Orolia2s/art-card-board/Schematic/README.md

# art-card-board
Folder hosting schematic file
