Orolia2s/art-card-board/ProductionFile/README.md

# art-card-board
Folder hosting production files

- PCB-Manuf : PCB Manufacturing file  (Gerber) in Zip Format
- Assembly : Assembly file in Zip Format
- ART_CARD_BOM-Assy Excel file: Bill of materials
- ART_CARD PCB File : PADS source of the board
- ART_CARD PDF File : Include schematic, implementation and layers of the board
