Orolia2s/art-card-board/Mechanical/ART CARD Rev5.pdf

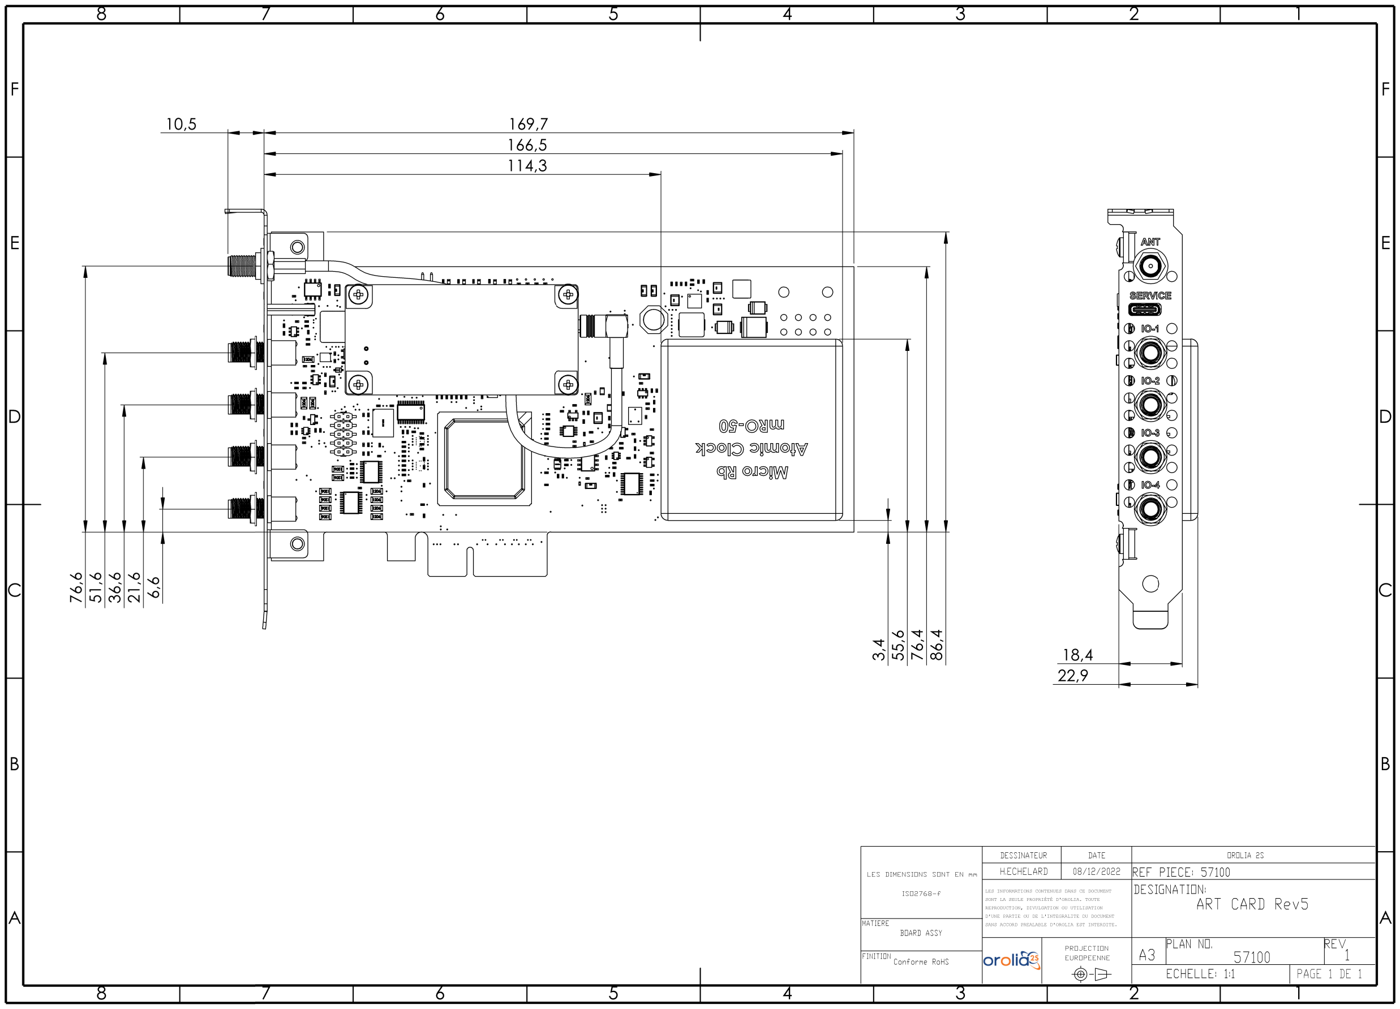
[picture p1: page 1]
