Orolia2s/art-card-board/ProductionFile/Rev5/BOM-ART_CARD_Rev5-PRODUCTION.xlsx

Item Number | Quantity | Value | Description | Part Number | Part Reference | Manufacturer | Manufacturer's Part Number | Mfg2 | Mfg2Part# | Mfg3 | Mfg3Part#
1 | 56 | 0.1uF | CAP,SM,0402,0.1uF,10%,50V,CER, X7R | C101R-0104-YK00 | C1 C2 C3 C4 C5 C6 C7 C8 C9 C10 C19 C20 C21 C22 C23 C24 C25 C26 C27 C28 C29 C30 C31 C32 C33 C34 C37 C38 C39 C40 C41 C42 C43 C44 C45 C46 C55 C56 C57 C58 C59 C60 C61 C62 C63 C64 C65 C66 C67 C68 C69 C70 C71 C72 C73 C74 | MURATA | GRM155R71H104KE14D | TDK | CGA2B3X7R1H104K050BB | Taiyo Yuden | UMK105B7104KV-FR
2 | 10 | 10uF | CAP,SM,0805,10uF,10%,10V,MLCC,X7R | C101R-0106-WK0F | C11 C12 C13 C14 C35 C47 C48 C49 C50 C75 | KEMET | C0805C106K8RACTU | TDK | C2012X7R1A106K125AC
3 | 19 | 1uF | CAP,SM,0402,1uF,10%,6.3V,MLCC,X7R | C101R-0105-YK2A | C15 C16 C17 C18 C36 C51 C52 C53 C54 C76 C146 C147 C163 C199 C200 C207 C208 C214 C219 | MURATA | GRM155R70J105KA12D | SAMSUNG | CL05B105KQ5QNW | YAGEO | CC0402KRX7R5BB105
4 | 65 | 0.1 uF | CAP, SM, 0402, .1uF, 10%, 16V, CER, X7R | C101R-0104-YK0D | C77 C80 C81 C84 C85 C86 C115 C131 C132 C137 C139 C144 C145 C148 C149 C150 C151 C152 C153 C154 C155 C156 C157 C158 C159 C162 C167 C168 C169 C170 C172 C173 C175 C176 C177 C178 C179 C180 C181 C182 C183 C184 C186 C187 C188 C189 C190 C191 C192 C197 C198 C201 C202 C203 C204 C205 C209 C210 C211 C212 C215 C216 C218 C220 C221 | AVX | 0402YC104KAT2A | KEMET | C0402T104K4RAC7867 | KEMET | C0402C104K4RACTU
5 | 6 | 15 pF | CAP, SM, 0402, 15pF, 5%, 50V, CER, NPO | C100R-0150-YJ0B | C78 C82 C83 C99 C134 C135 | AVX | 04025A150JAT2A | MURATA | GRM1555C1H150JA01D | YAGEO | CC0402JRNP09BN150
6 | 9 | 10uF | CAP, SM, 1206, 10uF, 10%, 16V, MLCC, X7R | C101R-0106-TK0D | C87 C88 C89 C112 C113 C114 C130 C164 C171 | AVX | 1206YC106KAT2A | KEMET | C1206C106K4RACTU | MURATA | GRM31CR71C106KAC7L
7 | 2 | 22uF | CAP,SM,1210,22uF,10%,16V,MLCC,X7R | C101R-0226-UK0D | C90 C91 | AVX | 1210YC226KAT2A | AVX | 1210YC226KAT4A | KEMET | C1210C226K4RAC7800
8 | 3 | 6.8pF | CAP, SM ,0402, 6.8PF, .1pF, 50V, CER, NPO | C100R-6R80-YJ0B | C92 C102 C109 | AVX | 04025A6R8CAT2A | MURATA | GCM1555C1H6R8BA16D
9 | 8 | 47uF | CAP,SM,1210,47uF,20%,6.3V,MLCC,X7R | C101R-0476-UM2A | C93 C94 C100 C101 C105 C106 C110 C111 | KEMET | C1210C476M8RAC7800 | KEMET | C1210C476K9RAC7800 | KEMET | C1210C476M9RACTU
10 | 1 | 2200 pF | CAP,SM,0402,2200pF,10%,50V,CER,X7R | C101R-0222-YK0B | C95 | MURATA | GRM155R71H222KA01D | TDK | C1005X7R1H222K | Taiyo Yuden | UMK105B7222KV-F
11 | 1 | 0.01 uF | CAP,SM,0402,.01uF,10%,50V,CER, X7R | C101R-0103-YK0B | C96 | KEMET | C0402C103K5RACTU | MURATA | GCM155R71H103KA55D
12 | 6 | 22uF | CAP,SM,1206,22uF,10%,6.3V,MLCC,X7R | C101R-0226-TK2A | C97 C98 C103 C104 C107 C108 | AVX | 12066C226KAT2A | MURATA | GRM31CR70J226KE19L | SAMSUNG | CL31B226KQHNNWE
13 | 2 | 10uF | CAP, SM, 1210, 10uF, 10%, 50V, MLCC, X7R | C101R-0106-UK0B | C116 C117 | AVX | 12105C106K4T2A | KEMET | C1210C106K5RACTU | MURATA | GRM32ER71H106KA12L
14 | 4 | 22uF | CAP,SM,1206,22UF,10%,25V,CER,X5R | C104R-0226-TK0A | C118 C119 C120 C122 | AVX | 12063D226KAT2A | MURATA | GRM31CR61E226KE15L | SAMSUNG | CL31A226KAHNNNE
15 | 2 | 680pF | CAP,SM,0402,680pF,5%,50V,CER,NPO | C100R-0681-YJ0B | C133 C136 | KEMET | C0402C681J5GACTU | MURATA | GCM1555C1H681JA16D | MURATA | GRM1555C1H681JA01D
16 | 2 | 10 pF | CAP, SM, 0402, 10PF, 5%, 50V, CERAMIC, NPO | C100R-0100-YJ0B | C138 C174 | AVX | 04025A100JAT2A | KEMET | C0402C100J5GACTU | MURATA | GCM1555C1H100GA16D
17 | 2 | 330pF | CAP,SM,0402,330pF,5%,50V,CER, NPO | C100R-0331-YJ0B | C160 C161 | MURATA | GRM1555C1H331JA01D | TDK | C1005C0G1H331J050BA | Taiyo Yuden | UMK105CG331JV-F
18 | 2 | 30pf | CAP,SM,0402,30PF,2%,25V,CER,HI-Q,NP0 | C106R-0300-YG0A | C165 C166 | Johanson | 250R07S300GV4T
19 | 1 | 0.01 uF | CAP, SM, 0402, 0.01uF, 10%, 25V, CER, X7R | C101R-0103-YK0A | C185 | AVX | 04023C103KAT2A | KEMET | C0402C103K3RACTU
20 | 8 | 100 pF | CAP, SM, 0402, 100PF, 5%, 50V, CERAMIC NPO | C100R-0101-YJ0B | C193 C194 C195 C196 C206 C213 C217 C222 | AVX | 04025A101JAT2A | KEMET | C0402C101J5GACTU | MURATA | GRM1555C1H101JA01D
21 | 2 | B230 | DIODE,SM,SCHOTTKY,30V,2A,SMB | CR01R-B230-0S1A | D1 D2 | Diodes Inc | B230-13-F | ON Semiconductor | MBRS230LT3G
22 | 1 | CD143A-SR05 | DIODE ARRAY, ESD TVS/DIODE, 2IO ,10pF, 5V VCC,SOT-143 | CR18R-0001-0S0H | D4 | BOURNS | CD143A-SR05
23 | 1 | BAT54S | DIODE, SM, SCHOTTKY, 30V, 200MA, SOT-23 | CR01R-0013-0S1A | D5 | Diodes Inc | BAT54S-7-F | ON Semiconductor | BAT54SLT1G | ROHM | BAT54SHMT116
24 | 2 | SD05C | TRANZORB,SM,BI-DIR,5VV,350W,SOD-323 | VR05R-0007-0S0H | D6 D7 | Diodes Inc | SD05C-7
25 | 3 | GREEN | LED, GREEN, SM, 0603, 2mA | DS01R-G006-0S00 | DS1 DS2 DS3 | KINGBRIGHT | APHD1608LCGCK
26 | 1 | RED | LED, RED, SM, 0603, 2 mA | DS01R-R005-0S00 | DS4 | KINGBRIGHT | APTD1608LSURCK
27 | 1 | BLUE | LED,SM,BLUE HIGH INTENSITY,0603, 2mA | DS01R-B002-0S00 | DS5 | KINGBRIGHT | APTD1608LVBC/D
28 | 4 | H10mm,M3.0x0.5 | STANDOFF, RND,SOLDER,M3.0x0.5,AL,10mm | HM57R-03R5-0610 | HE1 HE2 HE3 HE4 | WURTH ELEKTRONIK | 9774100360R
29 | 1 | J501R-0102-001E | HEADER,SM,0.1",10PIN,2ROW,MALE,3A,475VAC" | J501R-0102-001E | J1 | SAMTEC | TSM-105-01-S-DV-M
31 | 1 | SQW-105-01-F-D-VS | SOCKET, SM, 2mm, 10P, 2R, FEMALE, 2A, 100V | J800R-0102-010E | J3 | SAMTEC | SQW-105-01-F-D-VS
32 | 1 | USB TYPE C | CONN,USB TYPE C, RGHT AN, 14 CIRCUITS, TH,30V | J650R-0072-001A | J5 | MOLEX | 2169890001
33 | 4 | SMA RT | CONN, SMA JACK, R/A, 50 OHM, TH, .650" NECK, 0.11"" SHORT PINS" | J013R-0050-011Q | J6 J7 J8 J9 | EMERSON | 142-0701-551 | MOLEX | 732512201
34 | 1 | TSM-102-01-F-SH | HEADER,SM,2.54mm,2PIN, RA,1ROW,MALE,3A,475VAC | J501R-0021-041E | J10 | SAMTEC | TSM-102-01-F-SH | SAMTEC | TSM-102-01-F-SH
35 | 1 | 120 Ohm @ 100MHz | FERRITE BEAD,SM120 OHM-100MHZ,25%,500mA,0603 | L012R-120Z-XN01 | L1 | MURATA | BLM18AG121SN1D
36 | 1 | 2.2uH | INDUCTOR,SM, 2.2uH, 20%, 8A | L200R-0222-SM04 | L2 | PULSE ELECTRONICS | PA4341.222NLT
37 | 3 | 680nH | INDUCTOR,SM, 680nH, 20%, 5A | L200R-0681-SM00 | L3 L4 L5 | VISHAY | IHLP1212BZERR68M11
38 | 1 | 10uH | INDUCTOR,SM,SHIELDED,10UH,20%,2.5A | L200R-0103-SM02 | L6 | VISHAY | IHLP2020CZER100M01
39 | 1 | 15uH | INDUCTOR,SM,SHIELDED,FERRITE,15UH,30%,2A, 8mm x 8mm x 4.3mm | L200R-0153-SP00 | L7 | BOURNS | SRU8043-150Y | BOURNS | SRU8028-150Y
40 | 1 | 120 Ohm @ 100MHz | FERRITE BEAD,SM120 OHM-100MHZ,25%,4A,1206 | L012R-120Z-TN02 | L8 | FAIR-RITE | 2512061217Y5 | LAIRD TECHNOLOGIES | HI1206P121R-10
41 | 1 | 15uH | RF INDUCTOR,SM,FERRITE,15uH,5%,170mA | L260R-0153-QJ00 | L11 | COILCRAFT | 1812CS-153XJLC
42 | 2 | 330 nH | RF INDUCTOR,SM,CERAMIC,330nH,5%,0805 | L010R-3300-WJ00 | L12 L13 | COILCRAFT | 0805CS-331XJLC
43 | 2 | 120 Ohm @ 100MHz | FERRITE BEAD,SM120 OHM-100MHZ,25%,400mA,0402 | L012R-120Z-YN00 | L14 L15 | LAIRD TECHNOLOGIES | LI0402D121R-10 | TDK | MMZ1005Y121C
44 | 1 | 120 Ohm @ 100MHz | FERRITE BEAD,SM120 OHM-100MHZ,25%,3A,0805 | L012R-120Z-WN00 | L17 | LAIRD | HI0805O121R-10 | MURATA | BLM21PG121SN1D | VISHAY | ILHB0805ER121V
45 | 1 | 10 MHz | MRO-50/10M/5V | Y100R-0002-RH04 | OSC1 | Spectratime | MRO-50/10M/5V
46 | 5 | Si2302CDS | MOSFET,N-CH,ULTRA LOW VTH,20V,2.9A,SOT-23 | Q030R-2302-000V | Q1 Q2 Q3 Q4 Q5 | VISHAY | Si2302CDS-T1-E3 | VISHAY | Si2302CDS-T1-GE3
47 | 27 | 0 | RES, SM, 0402, 0 OHM JUMPER, THK FLM, 50V | R116R-0000-YJ0B | R1 R2 R3 R4 R5 R6 R7 R9 R15 R24 R25 R26 R27 R28 R30 R41 R52 R54 R55 R57 R59 R60 R61 R92 R117 R143 R145 | NIC | NRC04ZOTRF | ROHM | MCR01MZPJ000 | VISHAY | CRCW04020000Z0ED
48 | 30 | 1.00 K | RES,SM,0402,1K,1%,100PPM,THK FILM,50V | R116R-1001-YF0B | R8 R13 R21 R23 R32 R33 R35 R36 R42 R118 R119 R132 R155 R156 R158 R159 R179 R180 R181 R182 R183 R184 R185 R188 R189 R192 R193 R196 R197 R200 | PANASONIC | ERJ-2RKF1001X | VISHAY | CRCW04021K00FKED | YAGEO | RC0402FR-071KL
49 | 28 | 10.0K | RES,SM,0402,10K,1%,100PPM,THK FLM,50V | R116R-1002-YF0B | R10 R11 R12 R37 R38 R39 R49 R62 R64 R67 R68 R69 R74 R77 R80 R91 R96 R123 R124 R125 R130 R133 R134 R137 R139 R142 R148 R201 | PANASONIC | ERJ-2RKF1002X | VISHAY | CRCW040210K0FKED | YAGEO | RC0402FR-0710KL
50 | 8 | 39 | RES,SM,0402,39,1%THK FILM,50V,100PPM | R116R-0390-YF0B | R14 R40 R45 R104 R105 R106 R107 R108 | ROHM | MCR01MZPF39R0 | YAGEO | RC0402FR-0739RL
51 | 4 | 2.00K | RES,SM,0402,2.0k,1%,THICK FILM,100PPM,50V | R116R-2001-YF0B | R46 R50 R93 R138 | PANASONIC | ERJ-2RKF2001X | STACKPOLE ELECTRONICS | RMCF0402FT2K00 | VISHAY | CRCW04022K00FKED
52 | 2 | 825 | RES, SM, 0402, 825, 1%, THK FLM, 50V, 100PPM | R116R-8250-YF0B | R63 R135 | PANASONIC | ERJ-2RKF8250X | STACKPOLE ELECTRONICS | RMCF0402FT825R | VISHAY | CRCW0402825RFKED
53 | 1 | 73.2 K | RES,SM,0402,73.2K,1%,200PPM,THK FILM,50V | R116R-7322-YF0B | R65 | PANASONIC | ERJ-2RKF7322X | VISHAY | CRCW040273K2FKED
54 | 3 | 475 | RES,SM,0402,475,1%,THICK FILM,100PPM,50V | R116R-4750-YF0B | R66 R82 R136 | NIC | NRC04F4750TRF | STACKPOLE ELECTRONICS | RMCF0402FT475R | VISHAY | CRCW0402475RFKED
55 | 1 | 1.1k | RESISTOR,1.1k,1%,1/16W,THK FILM,100PPM,0402 | R116R-1101-YF0B | R70 | PANASONIC | ERJ-2RKF1101X | STACKPOLE ELECTRONICS | RMCF0402FT1K10 | VISHAY | CRCW04021K10FKED
56 | 1 | 41.2k | RES, SM, 0402, 41.2k, 1%, THK FLM, 100PPM, 50V | R116R-4122-YF0B | R71 | PANASONIC | ERJ-2RKF4122X | VISHAY | CRCW040241K2FKED | YAGEO | RC0402FR-0741K2L
57 | 1 | 261K | RES,SM,0402,201K,1%,THICK FILM,50V,100PPM | R116R-2613-YF0B | R72 | YAGEO | RC0402FR-07261KL
58 | 3 | 100 K | RES,SM,0603,100K,1%,THICK FILM,50V,100PPM | R116R-0104-XF0B | R73 R76 R79 | STACKPOLE ELECTRONICS | RMCF 1/16 100K 1% R | VISHAY | CRCW0603100KFKEA
59 | 1 | 107k | RES,SM,0402,107k,1%,THK FILM,100PPM,50V | R116R-1073-YF0B | R75 | YAGEO | RT0402FRE07107KL
60 | 1 | 80.6 k | RES,SM,0603,80.6K,1%,100PPM,THK FILM,50V | R116R-8062-XF0B | R78 | STACKPOLE ELECTRONICS | RMCF0603FT80K6 | VISHAY | CRCW060380K6FKEA
61 | 1 | 4.02k | RES,SM,0402,4.02k,1%,THK FILM,100PPM,50V | R116R-4021-YF0B | R81 | BOURNS | CR0402-FX-4021GLF | PANASONIC | ERJ-2RKF4021X | STACKPOLE ELECTRONICS | RMCF0402FT4K02
62 | 1 | 0 | RES,SM,1206,0 OHM JUMPER,THK FLM,2A | R114R-0000-TJ0G | R84 | NIC | NRC12ZOTRF | STACKPOLE ELECTRONICS | RMCF 1/8 0 R | VISHAY | CRCW12060000Z0EA
63 | 2 | 49.9 | RES,SM,0402,49.9,1%THK FILM,50V,100PPM | R116R-49R9-YF0B | R94 R146 | NIC | NRC04F49R9TRF | STACKPOLE ELECTRONICS | RMCF0402FT49R9 | VISHAY | CRCW040249R9FKED
64 | 3 | 49.9 | RES,SM,1206,49.9,1%,THK FLM,100PPM,200V | R114R-49R9-TF0G | R95 R98 R147 | NIC | NRC12F49R9TRF | STACKPOLE ELECTRONICS | RMCF1206FT49R9 | VISHAY | CRCW120649R9FKEA
65 | 4 | 221 | RES,SM,0402,221,1%THK FILM,100PPM,50V | R116R-2210-YF0B | R97 R99 R149 R153 | NIC | NRC04F2210TRF | STACKPOLE ELECTRONICS | RMCF0402FT221R | VISHAY | CRCW0402221RFKED
66 | 3 | 20.0 K | RES,SM,0402,20.0K,1%,100PPM,THK FILM,50V | R116R-2002-YF0B | R102 R150 R151 | ROHM | MCR01MZPF2002 | VISHAY | CRCW040220K0FKED | YAGEO | RC0402FR-0720KL
67 | 1 | 12.0K | RES,SM,0402,12K,1%,100PPM,THK FLM,50V | R116R-1202-YF0B | R129 | PANASONIC | ERJ-2RKF1202X | VISHAY | CRCW040212K0FKED | YAGEO | RC0402FR-0712KL
68 | 1 | 9.09k | RES,SM,0402,9.09k,1%THK FILM,100PPM,50V | R116R-9091-YF0B | R131 | PANASONIC | ERJ-2RKF9091X | STACKPOLE ELECTRONICS | RMCF0402FT9K09 | VISHAY | CRCW04029K09FKED
70 | 3 | 680 | RES,SM,0402,680,5%,200PPM,THK FILM,50V | R116R-6800-YJ0B | R141 R144 R152 | PANASONIC | ERJ-2GEJ681X | ROHM | MCR01MZPJ681 | VISHAY | CRCW0402680RJNED
71 | 1 | 750 | RES,SM,0402,750,1%,THICK FILM,100PPM,50V | R116R-7500-YF0B | R154 | NIC | NRC04F7500TRF | PANASONIC | ERJ-2RKF7500X | STACKPOLE ELECTRONICS | RMCF0402FT750R
72 | 1 | 330 | RES,SM,0402,330,1%,THK FILM,50V | R116R-3300-YF0B | R157 | PANASONIC | ERJ-2RKF3300X | ROHM | MCR01MZPF3300 | VISHAY | CRCW0402330RFKED
73 | 1 | 220K | RES,SM,0402,220K,5%,200PPM,THK FILM,50V | R116R-0224-YJ0B | R160 | VISHAY | CRCW0402220KJNED | YAGEO | RC0402JR-07220KL
74 | 10 | 100 | RES,SM,1206,100,5%,1/4W,THK FLM,200PPM | R114R-0101-TJ0G | R161 R162 R186 R187 R190 R191 R194 R195 R198 R199 | NIC | NRC12J101TRF | STACKPOLE ELECTRONICS | RMCF 1/8 100 5% R | VISHAY | CRCW1206100RJNEA
75 | 16 | 5.6 | RES,SM,1206,5.6,5%,1/4W,THK FLM,200PPM | R114R-05R6-TJ0G | R163 R164 R165 R166 R167 R168 R169 R170 R171 R172 R173 R174 R175 R176 R177 R178 | ROHM | MCR18EZPJ5R6 | STACKPOLE ELECTRONICS | RMCF 1/8 5.6 5% R | VISHAY | CRCW12065R60JNEA
76 | 1 | 10CX220YF672I6G | IC,SM,FPGA,CYCLONE 10 GX, 220KLE, 672 FBGA | U160R-10GX-020P | U1 | Intel | 10CX220YF672I6G
77 | 1 | 24AA08HT | IC,SM, EEPROM 8KBIT 400KHZ SOT23-5 | U060R-24AA-000K | U2 | Microchip Technology | 24AA08HT-I/OT
78 | 1 | TS3A27518E | IC,SM,6x 1to2 ANALOG MUX,HIGH SPEED,TSSOP24 | U150R-2751-100P | U3 | TEXAS INSTRUMENTS | TS3A27518EPWR
79 | 1 | MT25QU256ABA8E12 | IC,SM, FLASH 256MBIT,NVM,BGA,1.8V | U060R-2525-011H | U4 | Micron | MT25QU256ABA8E12-1SIT | Micron | MT25QU256ABA8E12-0AAT
80 | 3 | LT1963AIS8 | IC,LDO REG LOWNOISE ,SO8 | U280R-1963-010H | U5 U10 U23 | LINEAR TECHNOLOGY | LT1963AIS8#PBF | LINEAR TECHNOLOGY | LT1963AIS8#TRBF
81 | 1 | LT8642S | IC,SM,BUCK REG,10A, 18V, LQFN24 | U280R-8642-002U | U6 | ANALOG DEVICES | LT8642SIV#PBF
82 | 3 | LTC3308A | IC,SM,BUCK REG,4A,0.5V-5.5V, LQFN12 | U280R-3308-000K | U7 U8 U9 | ANALOG DEVICES | LTC3308AJV#TRPBF | ANALOG DEVICES | LTC3308AIV#TRPBF
83 | 2 | OPA690 | IC,SM,OP-AMP W DIS,WB,12V,SOT23-6 | U200R-0690-010H | U14 U29 | TEXAS INSTRUMENTS | OPA690IDBVR | TEXAS INSTRUMENTS | OPA690IDBVT | TEXAS INSTRUMENTS | OPA690IDBVTG4
84 | 2 | SN74LVC244APW | IC,SM,LVC BUFF/DVR TRI-ST,DUAL,8BIT,3.3V,20TSSOP | U050R-L244-000P | U15 U41 | TEXAS INSTRUMENTS | SN74LVC244APWR
85 | 4 | SN74LV1T34 | IC,SM,LV,3.3V,SINGLE BUFFER,SOT-23M5 | U150R-1T34-000P | U17 U18 U21 U26 | TEXAS INSTRUMENTS | SN74LV1T34DBVR
86 | 1 | FT4233HPQ | IC,SM, USB FS UART/MPSSE, 3.3V-5.25V, 76-QFN | U130R-FT42-000P | U22 | FTDI | FT4233HPQ-TRAY | FTDI | FT4233HPQ-REEL
87 | 1 | 93LC66B | IC,SM,EEPROM,2-WR SER,4K (256X16) 5V,SOT23 | U060R-9366-000K | U24 | MICROCHIP | 93LC66BT-E/OT
88 | 4 | TXU0104BQA | IC,SM,4-bit Fixed Voltage-Level Translator,VQFN14 | U210R-0104-000H | U25 U31 U33 U35 | TEXAS INSTRUMENTS | TXU0104BQAR
90 | 1 | ADCMP601BKSZ | IC, SM,COMPAR,TTL/CMOS,1CHAN,5V,SC70-6 | U220R-0601-010H | U30 | ANALOG DEVICES | ADCMP601BKSZ-R2 | ANALOG DEVICES | ADCMP601BKSZ-REEL7
91 | 2 | 74ACT244 | IC,SM,ACT,8BIT BUFF/DRVR,3-ST,5V,TSSOP-20 | U050R-0244-040H | U32 U34 | Fairchild Semiconductor | 74ACT244MTCX | ON Semiconductor | MC74ACT244DTR2G | TEXAS INSTRUMENTS | SN74ACT244PWR
92 | 6 | MAX14763 | IC,SM,ANA SWITCH SPDTx1,3V-5.5V,8TDFN-EP | U270R-4763-000H | U36 U37 U38 U39 U40 U42 | MAXIM INTEGRATED | MAX14763ETA
93 | 1 | 15 V | TRANZORB,SM,UNI-DIRECTION,15V,1500W,SMC | VR05R-0001-0S0U | VR1 | Diodes Inc | SMCJ15A-13-F | MICRO COMMERCIAL | SMCJ15A | ON Semiconductor | 1SMC15AT3G
94 | 5 | 5V | TVS,SM,UNI-DIR,5V,350W Ppk,350pF,SOD-323 | VR02R-0002-0S0H | VR2 VR3 VR4 VR5 VR6 | Diodes Inc | SD05-7 | MICRO COMMERCIAL | ESD5V0D3-TP | ON Semiconductor | SD05T1G
95 | 1 | 25.0000MHz | MEMS OSC,SM,25MHZ,1.8V,25PPM,-40C,125C,2x1.6mm | Y250R-0002-XS02 | Y1 | SITIME | SiT8924BA-72-18E-25.000000G
96 | 1 | 100MHz | XO OSC,SM,100MHZ,1.8V,25PPM,-40C,125C,5x3.2mm | Y100R-0003-XS00 | Y2 | Silicon Labs | 510KBA100M000BAGR
97 | 1 | 12.000MHz | XTAL,SM,12MHZ,12PF,3.2x2.5mm,10PPM,-30/85°C | Y050R-0126-0500 | Y3 | KYOCERA | CX3225SB12000H0FLJCC
