Orolia2s/art-card-board/ProductionFile/Rev5/ART_CARD Rev 5.pdf

# ART_CARD Rev 5

- | 7 | SHEETS OF ELECTRICAL SCHEMATICS
- | 1 | ASSEMBLY DRAWING TOP
- | 1 | ASSEMBLY DRAWING BOTTOM
- | 1 | SILKSCREEN TOP
- | 1 | SOLDER MASK TOP
- | 1 | COPPER LAYER TOP
- | 1 | COPPER LAYER INNER 1
- | 1 | COPPER LAYER INNER 2
- | 1 | COPPER LAYER INNER 3
- | 1 | COPPER LAYER INNER 4
- | 1 | COPPER LAYER INNER 5
- | 1 | COPPER LAYER INNER 6
- | 1 | COPPER LAYER BOTTOM
- | 1 | SOLDER MASK BOTOM
- | 1 | SILKSCREEN BOTTOM
- | 1 | DRILL DRAWING
- | 1 | CIRCUIT BOARD SPECIFICATION

# FILE OROLIA ART_CARD

# Réf PCB :

Angers Technopole | 1 bis Avenue du Bois l’Abbé
49070 BEAUCOUZÉ | FRANCE
Tél. : +33(0)2-41-48-41-40 | Fax : +33(0)2-41-48-41-44
contact@artemis-cad.com | www.artemis-cad.com

Title; OVERVIEW; <Variant Name>

Size Size Size | Document Number Document Number Document Number ART_CARD ART_CARD ART_CARD | Rev Rev Rev 5 A2 5 A2 5 A2

Date: Date: Date: Thursday, March 03, 2022 Thursday, March 03, 2022 Thursday, March 03, 2022

FILE NAME FILE NAME FILE NAME ART_CARD ART_CARD ART_CARD | Sheet Sheet Sheet of of of 1 1 1 7 7 7

# VCC Decoupling

# FPGA POWER SUPPLY


VCCP and VCCERAM Decoupling

VCCPT, VCCPGM, VCCBAT and VCCIO Decoupling

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

Date: Date: Date: Thursday, March 03, 2022 Thursday, March 03, 2022 Thursday, March 03, 2022

FILE NAME FILE NAME FILE NAME ART_CARD ART_CARD ART_CARD | Sheet Sheet Sheet of of of 2 2 2 7 7 7

# FPGA

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

Date: Date: Date: Thursday, March 03, 2022 Thursday, March 03, 2022 Thursday, March 03, 2022

FILE NAME FILE NAME FILE NAME ART_CARD ART_CARD ART_CARD | Sheet Sheet Sheet of of of 3 3 3 7 7 7

## 10mV Ripple Voltage Max

## POWER NEED : FPGA : OCXO : Comp : TOTAL

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

Date: Date: Date: Thursday, March 03, 2022 Thursday, March 03, 2022 Thursday, March 03, 2022

FILE NAME FILE NAME FILE NAME ART_CARD ART_CARD ART_CARD | Sheet Sheet Sheet of of of 4 4 4 7 7 7

# MiniRubidium

# OSCILLATOR POWER SUPPLY


SQUARE TO Sine CONVERTER

Power : 3W (nom.) to 6W (Startup)

Power : 1W (nom.) to 2W (Startup)

Power : 3W (nom.) to 7.5W (Startup)

Chip Scale Atomic Clock

Date: Date: Date: Thursday, March 03, 2022 Thursday, March 03, 2022 Thursday, March 03, 2022

FILE NAME FILE NAME FILE NAME ART_CARD ART_CARD ART_CARD | Sheet Sheet Sheet of of of 5 5 5 7 7 7

ANTENNA POWER SUPPLY | GNSS RECEIVER | GNSS STANDOFF

## From 1.8V to 3.3V


SPI VOLTAGE-LEVEL TRANSLATOR

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

Date: Date: Date: Thursday, March 03, 2022 Thursday, March 03, 2022 Thursday, March 03, 2022

FILE NAME FILE NAME FILE NAME ART_CARD ART_CARD ART_CARD | Sheet Sheet Sheet of of of 6 6 6 7 7 7

## Ra is 102 ohms GAIN = 3.17

## Ra is 124 ohms GAIN = 2.8


Ra is 221 ohms GAIN = 2
Ra is 182 ohms GAIN = 2.2

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

Date: Date: Date: Thursday, March 03, 2022 Thursday, March 03, 2022 Thursday, March 03, 2022

FILE NAME FILE NAME FILE NAME ART_CARD ART_CARD ART_CARD | Sheet Sheet Sheet of of of 7 7 7 7 7 7

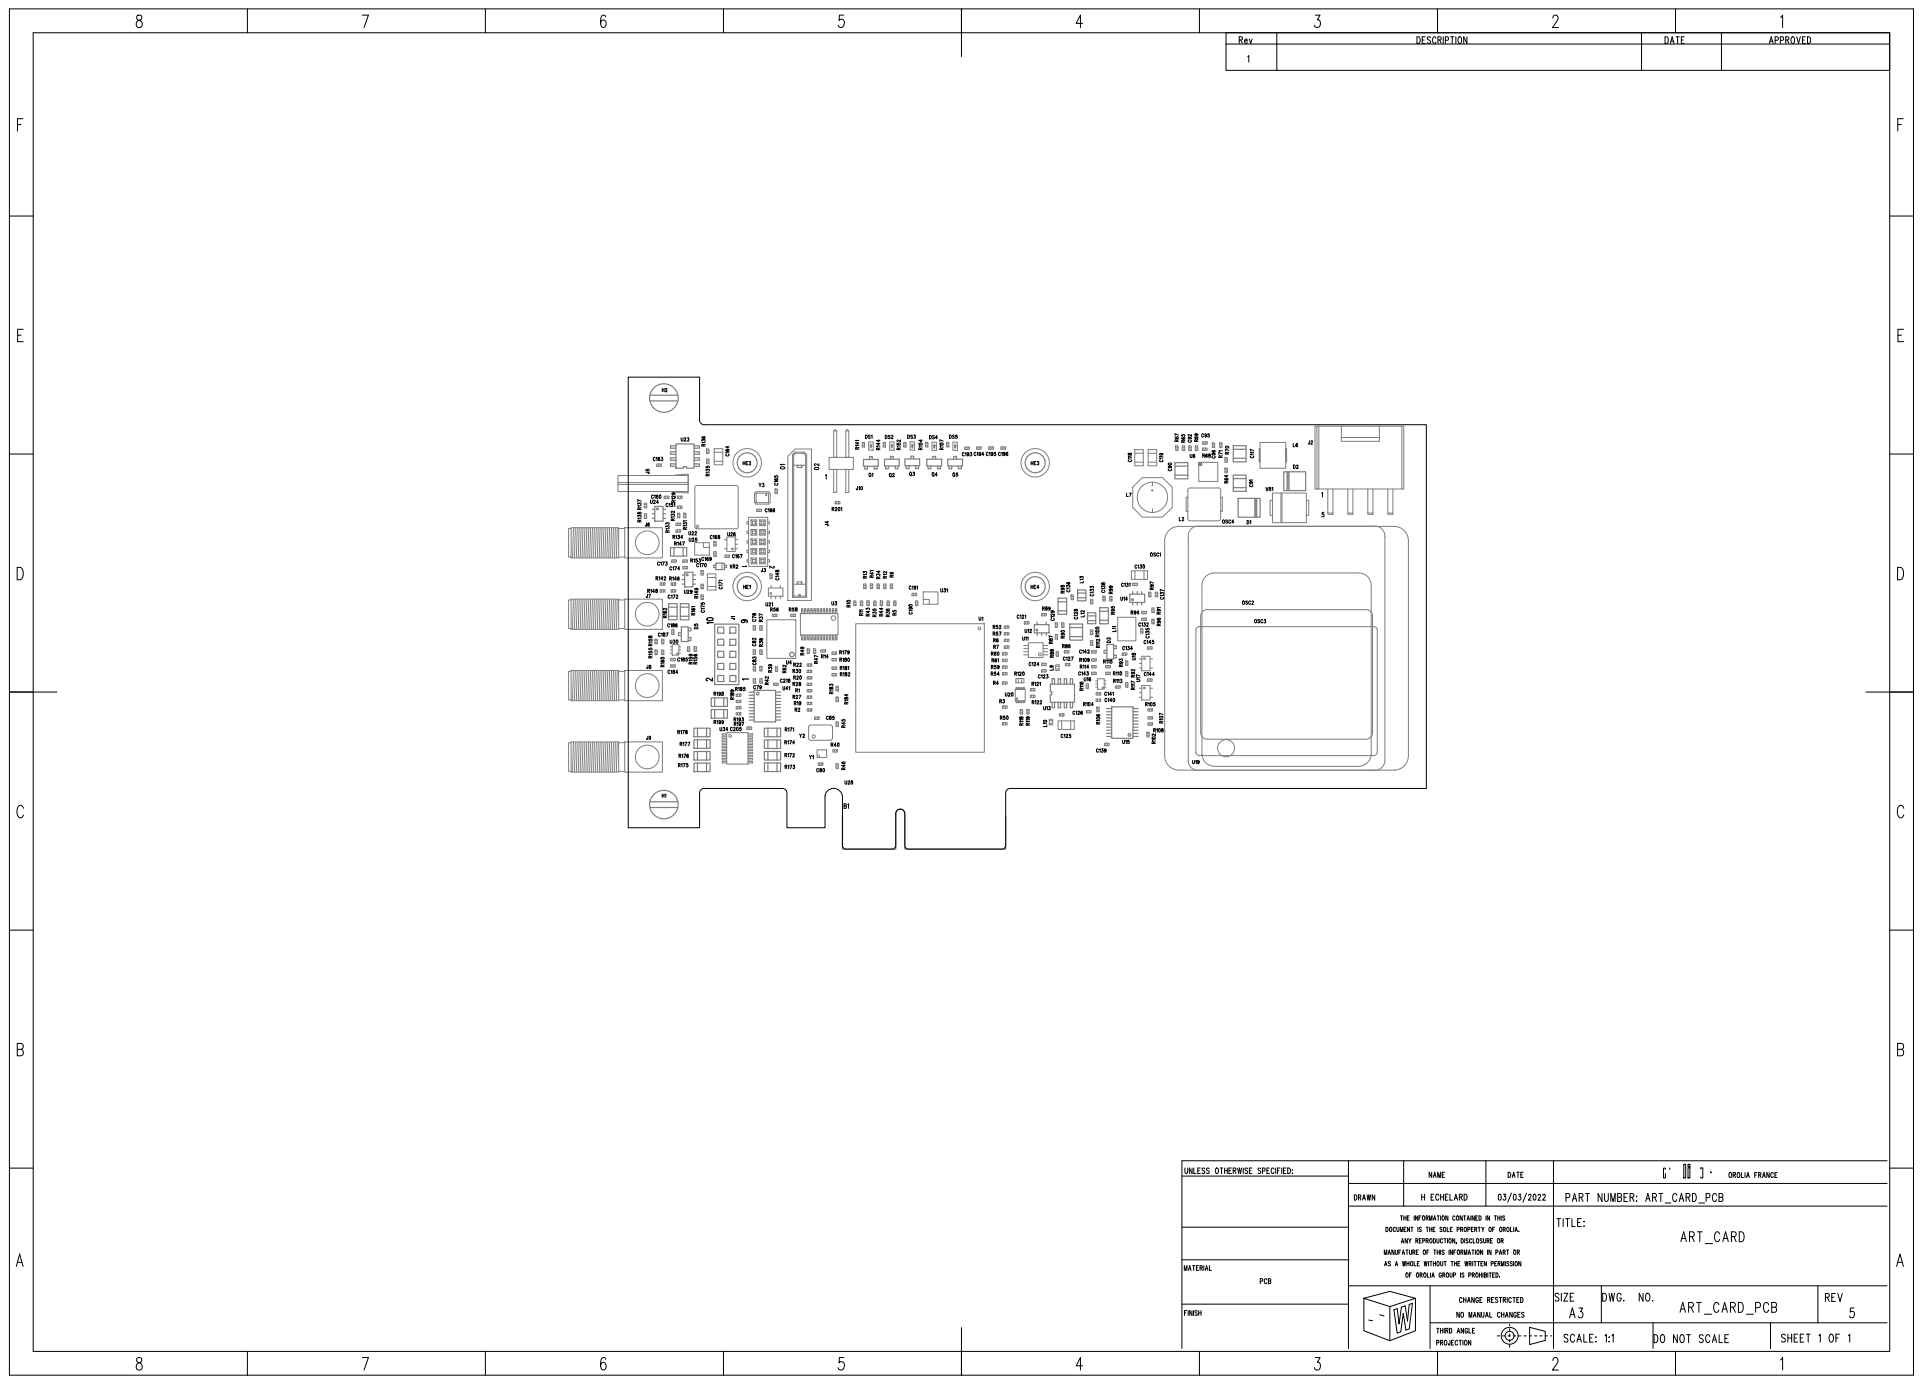
[picture p9: page 9]

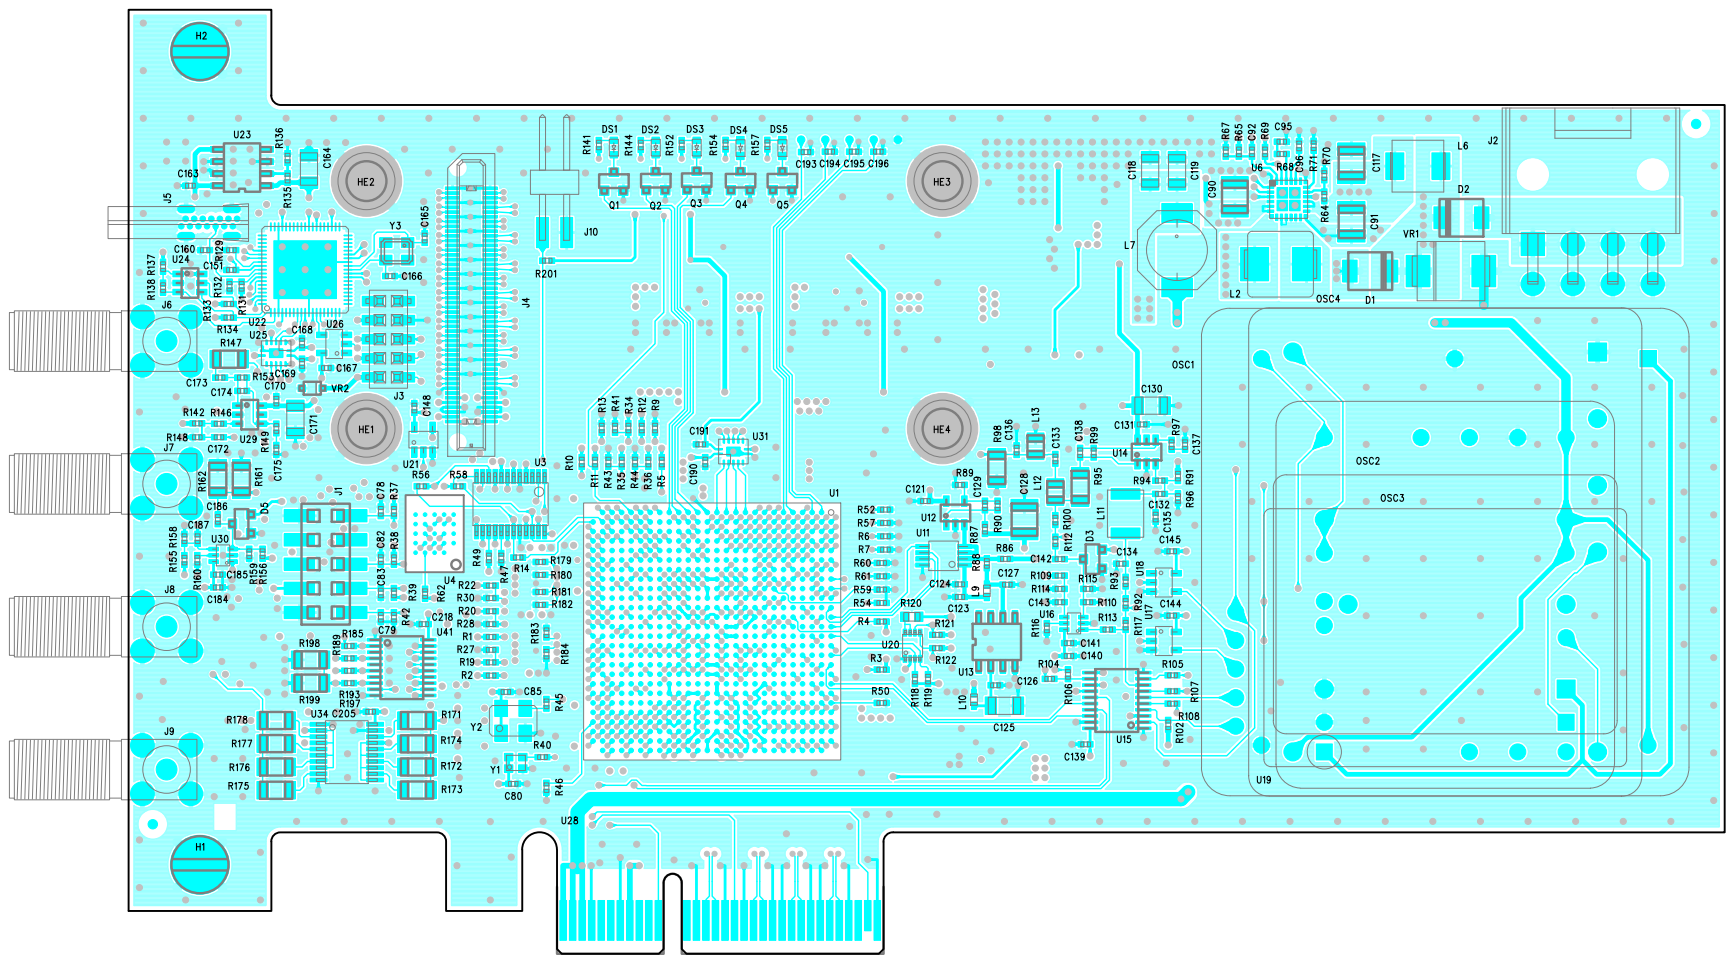
[picture p10: page 10]

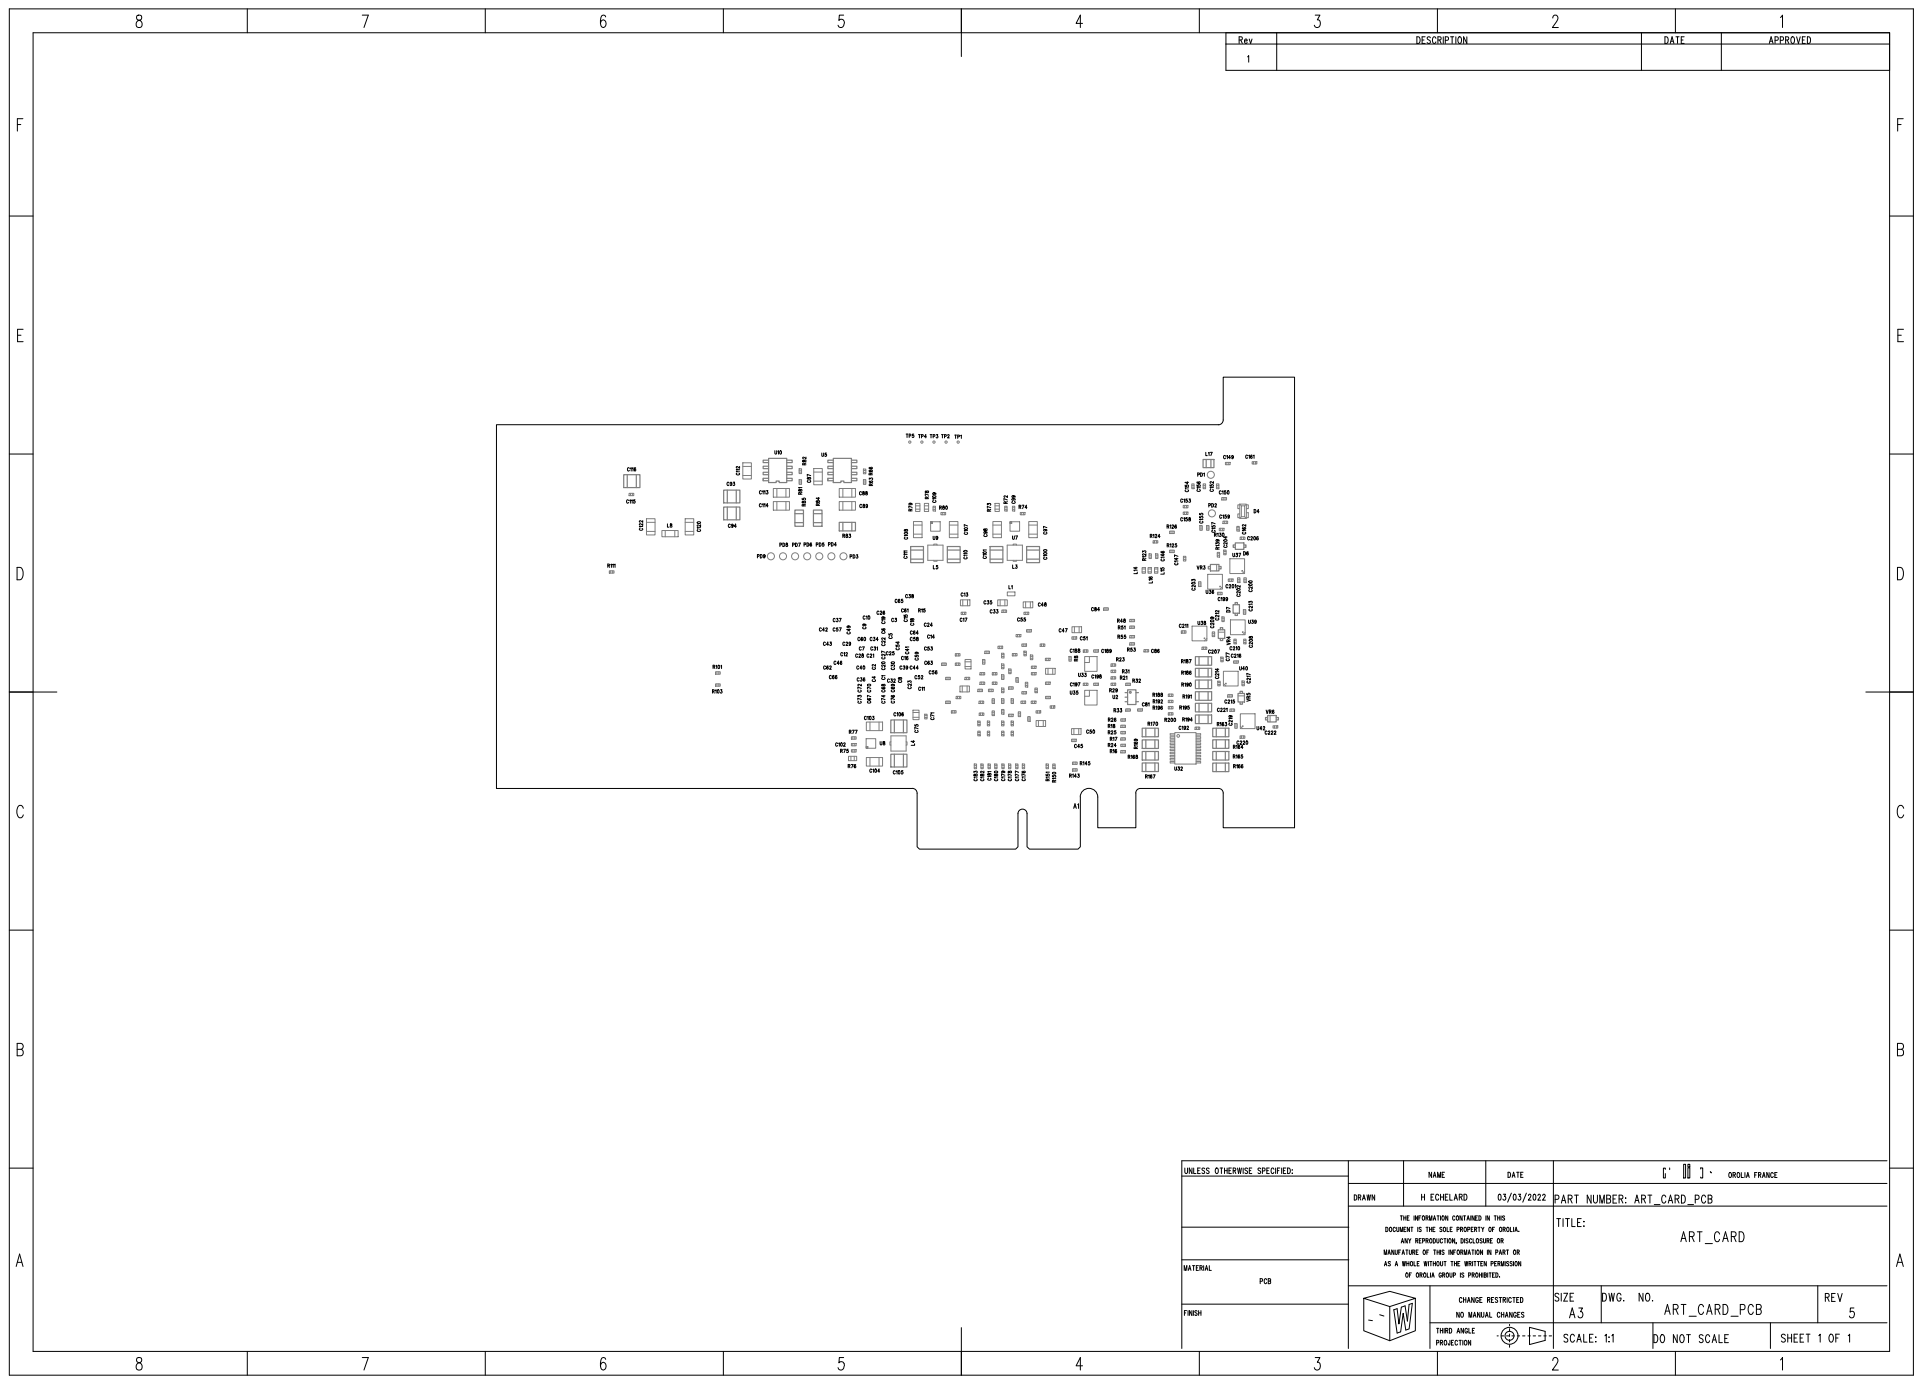
[picture p11: page 11]

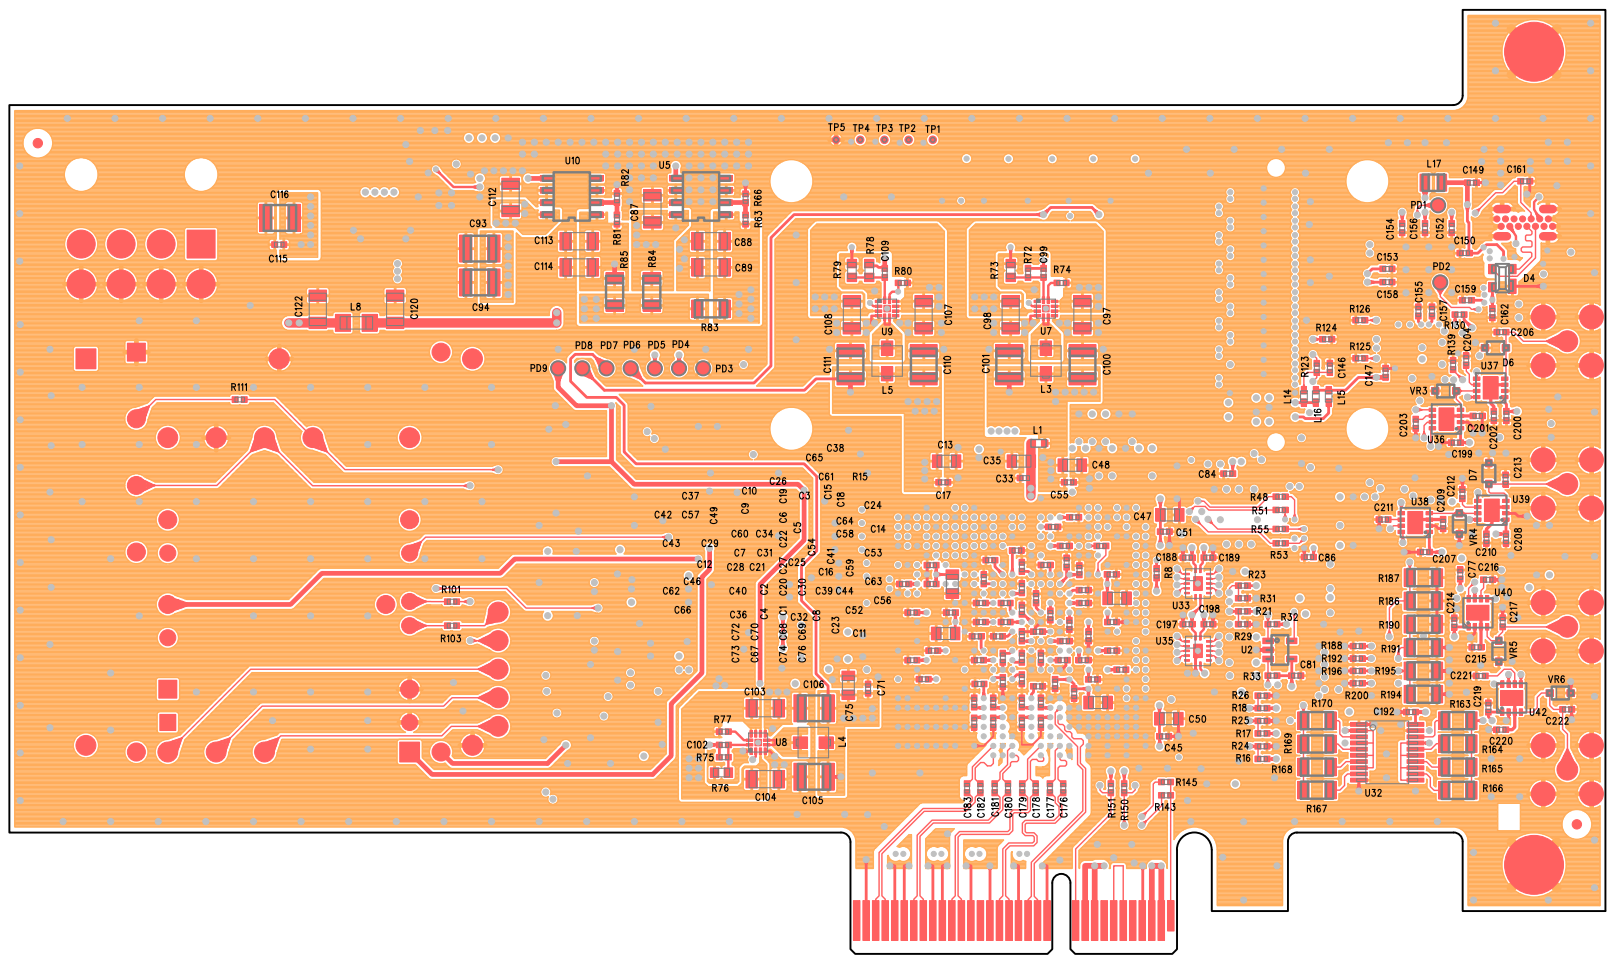
[picture p12: page 12]

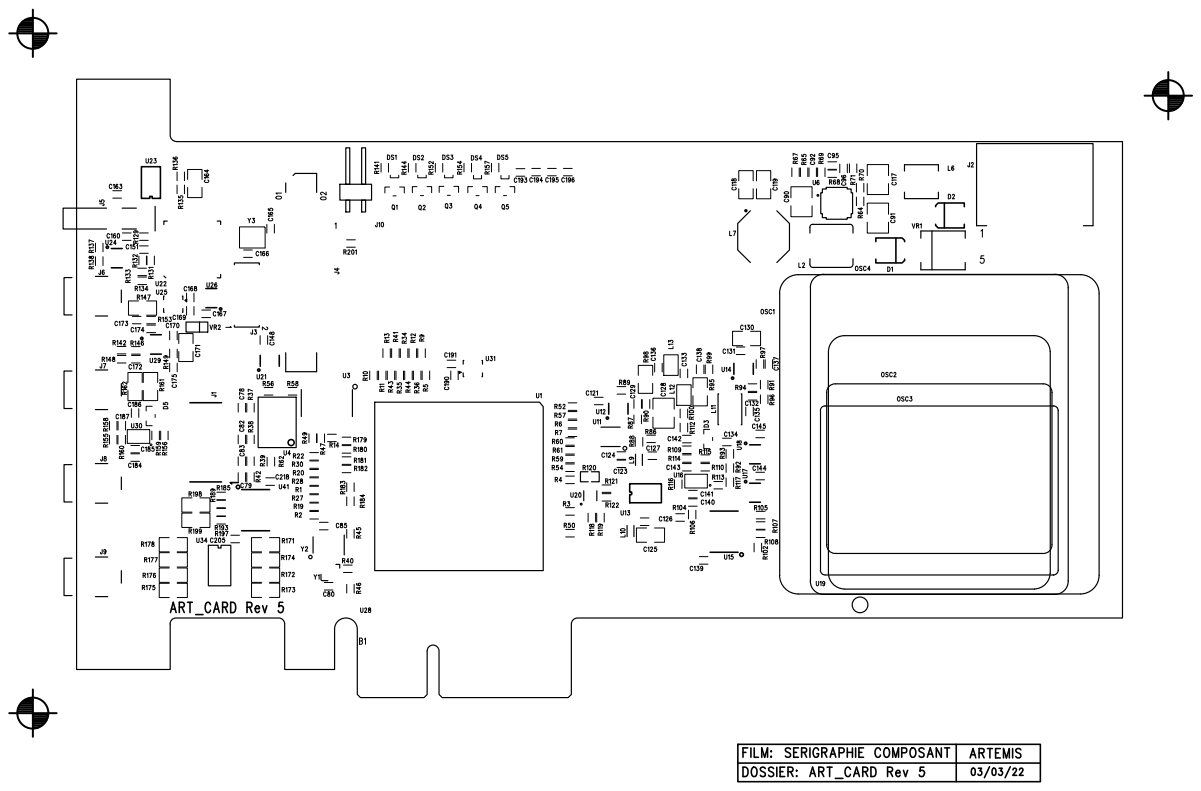
[picture p13: page 13]

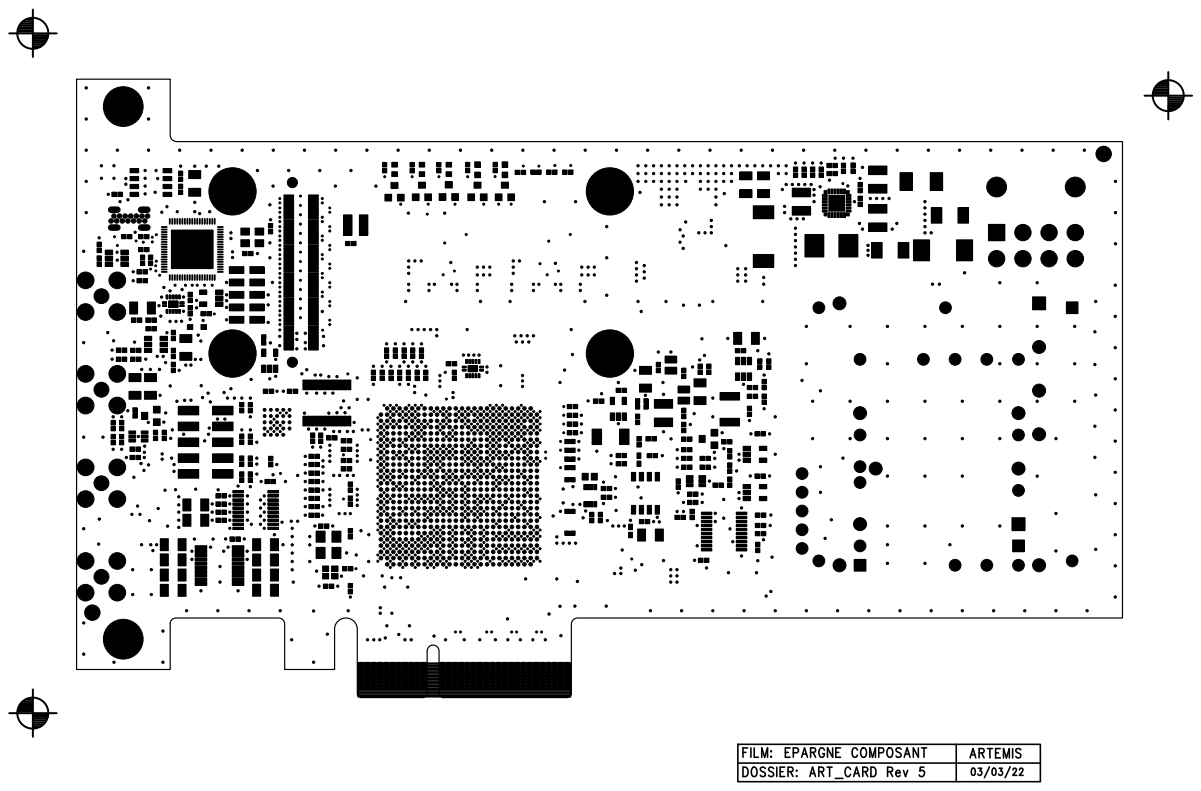
[picture p14: page 14]

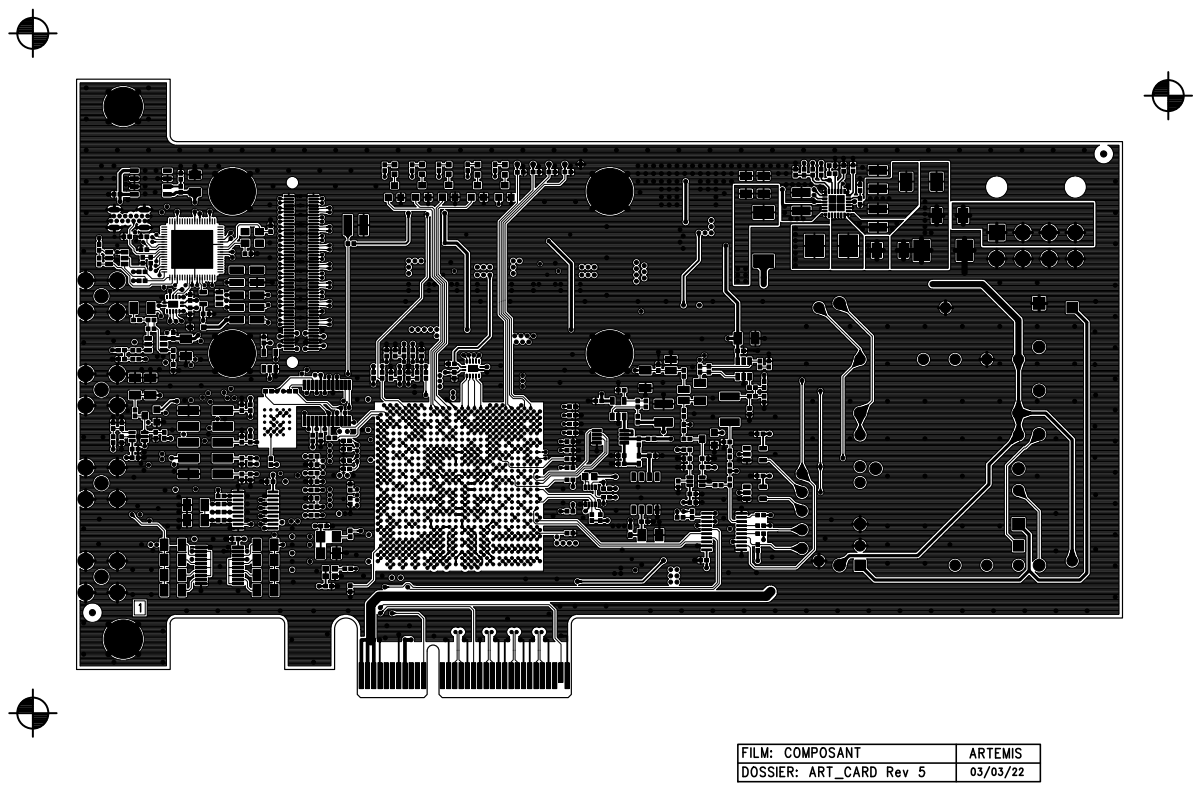
[picture p15: page 15]

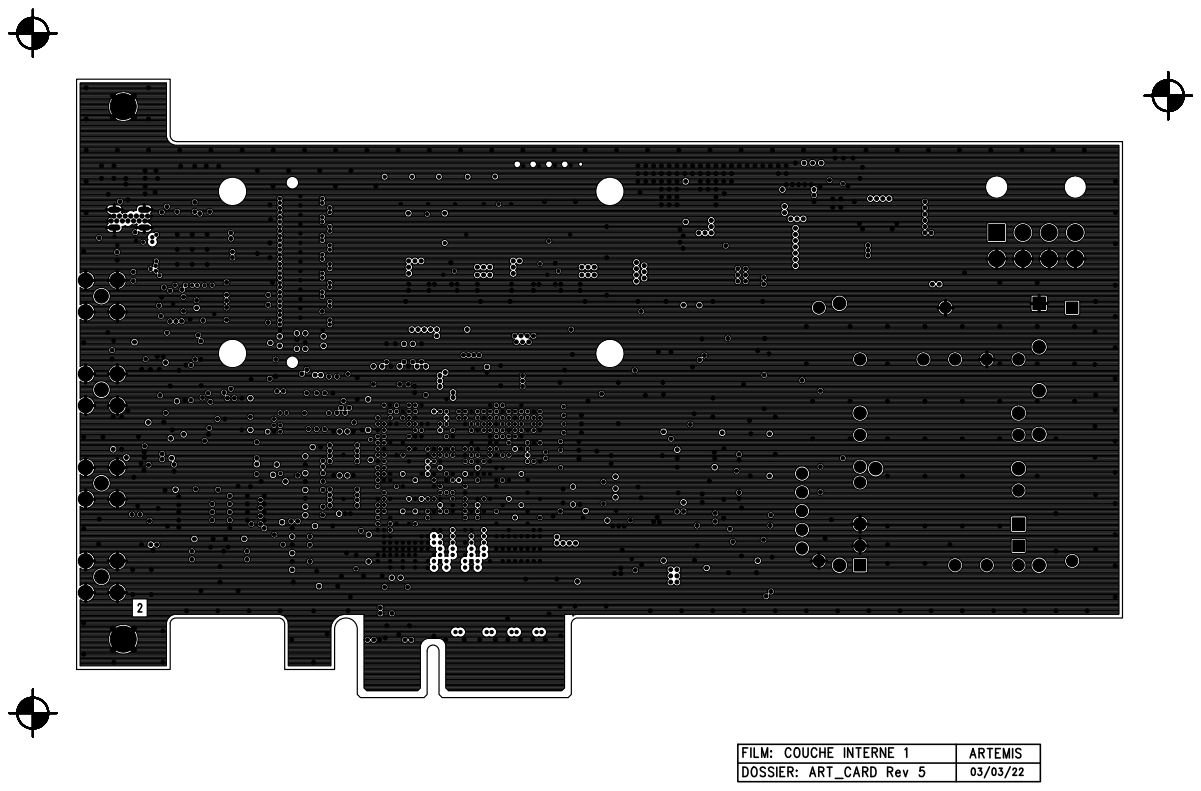
[picture p16: page 16]

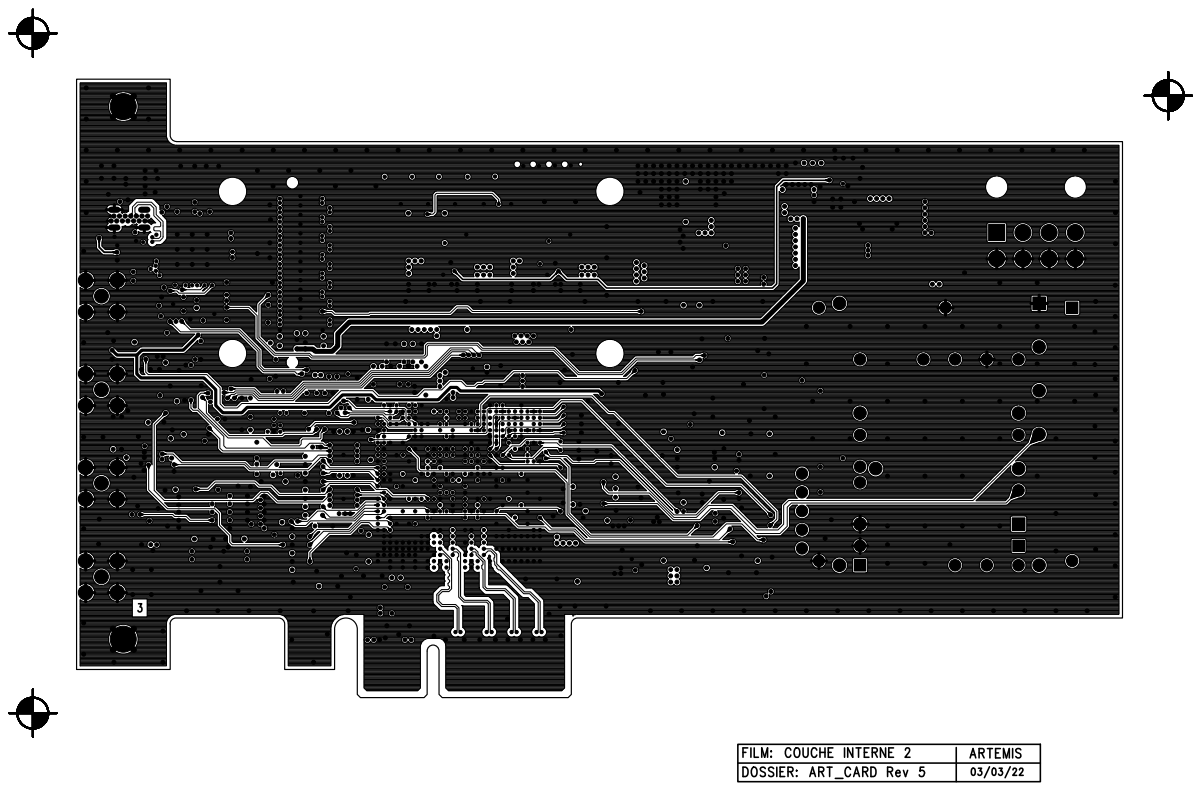
[picture p17: page 17]

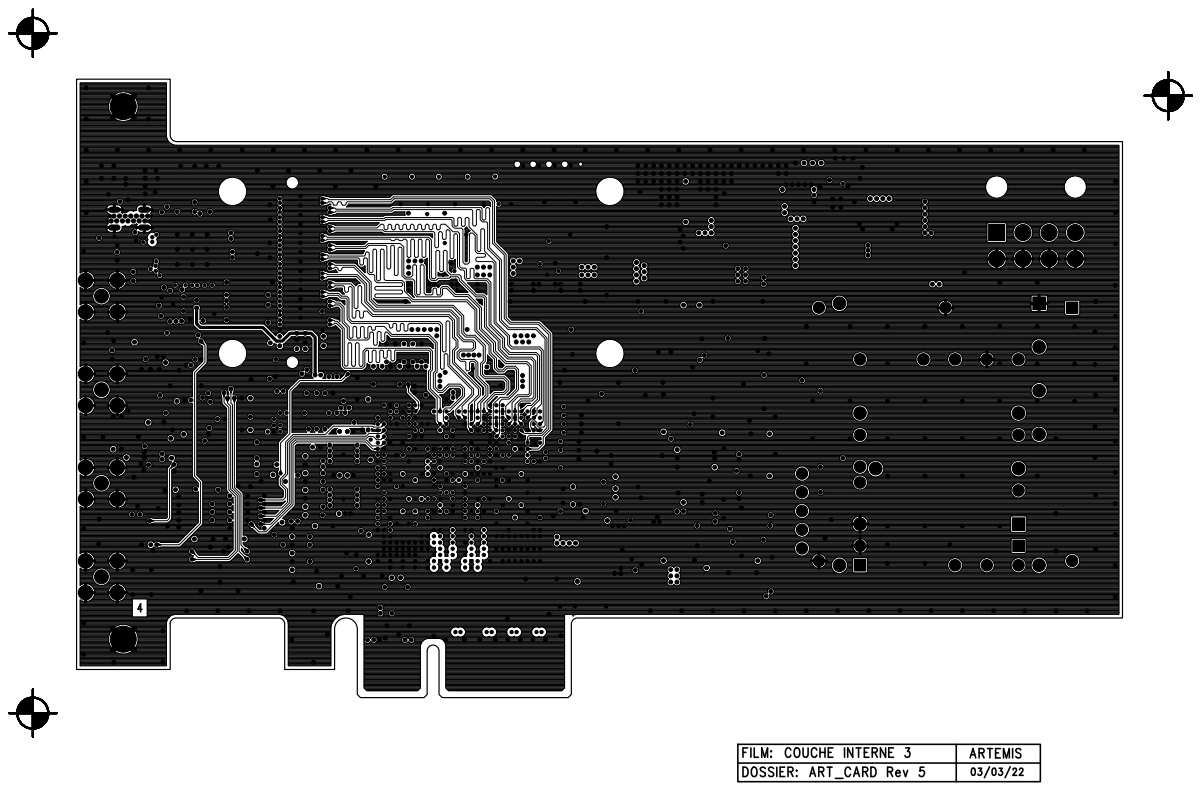
[picture p18: page 18]

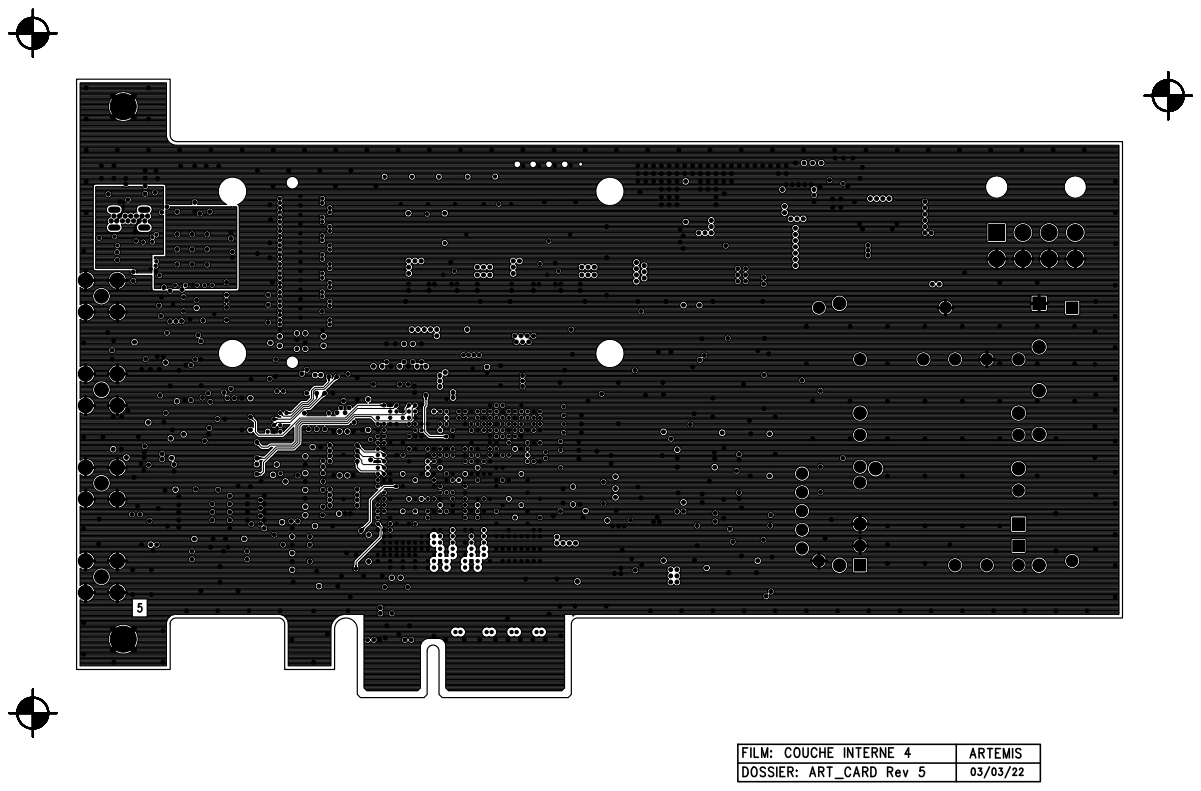
[picture p19: page 19]

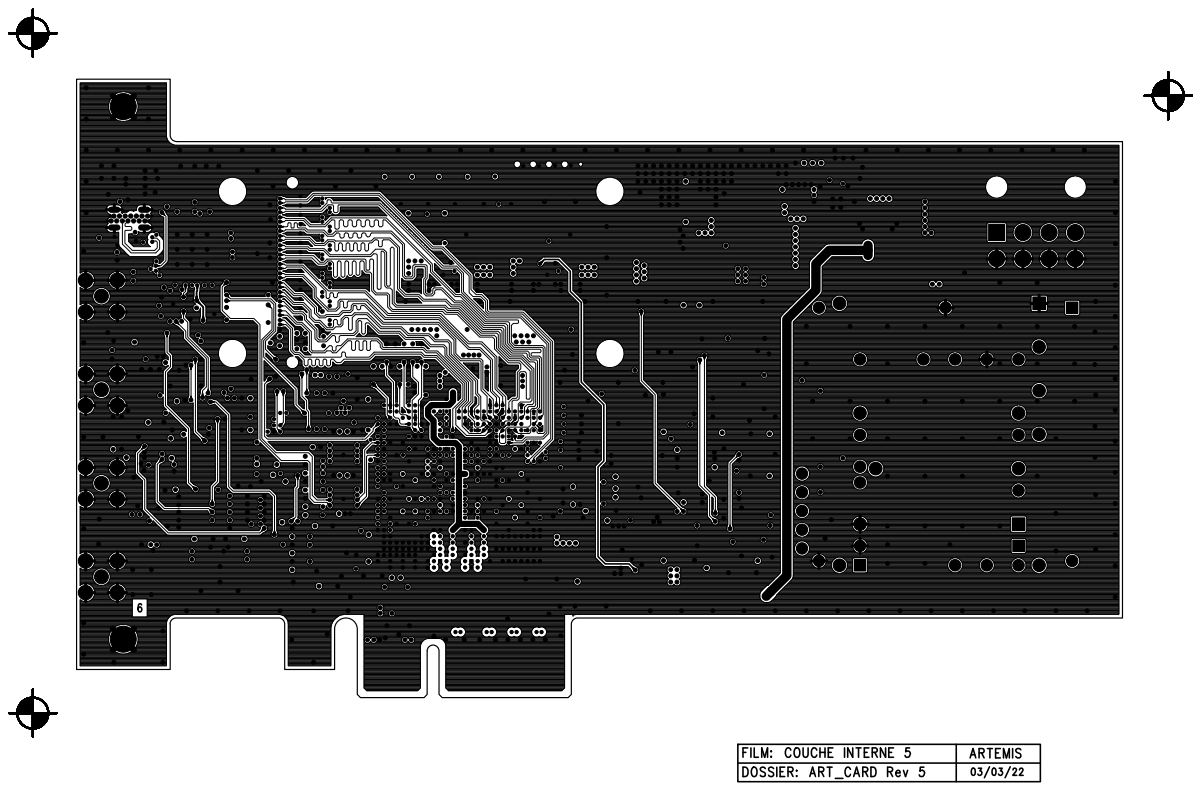
[picture p20: page 20]

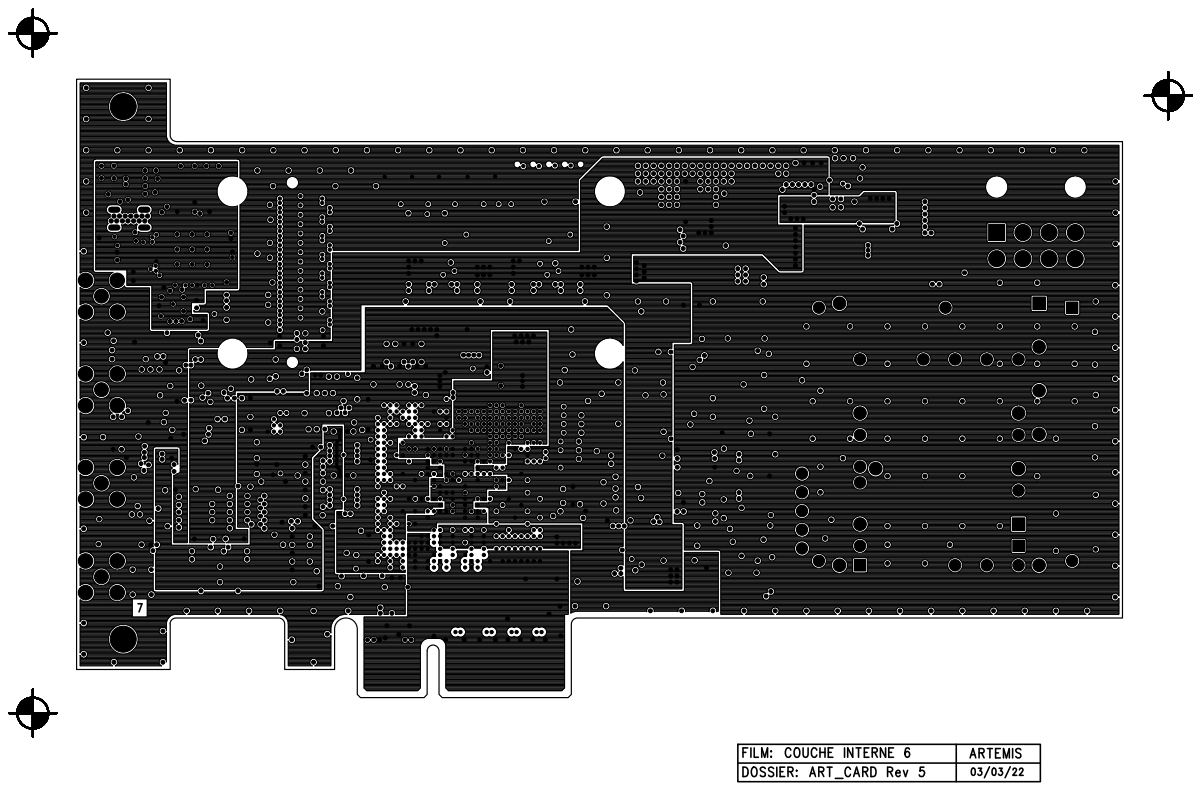
[picture p21: page 21]

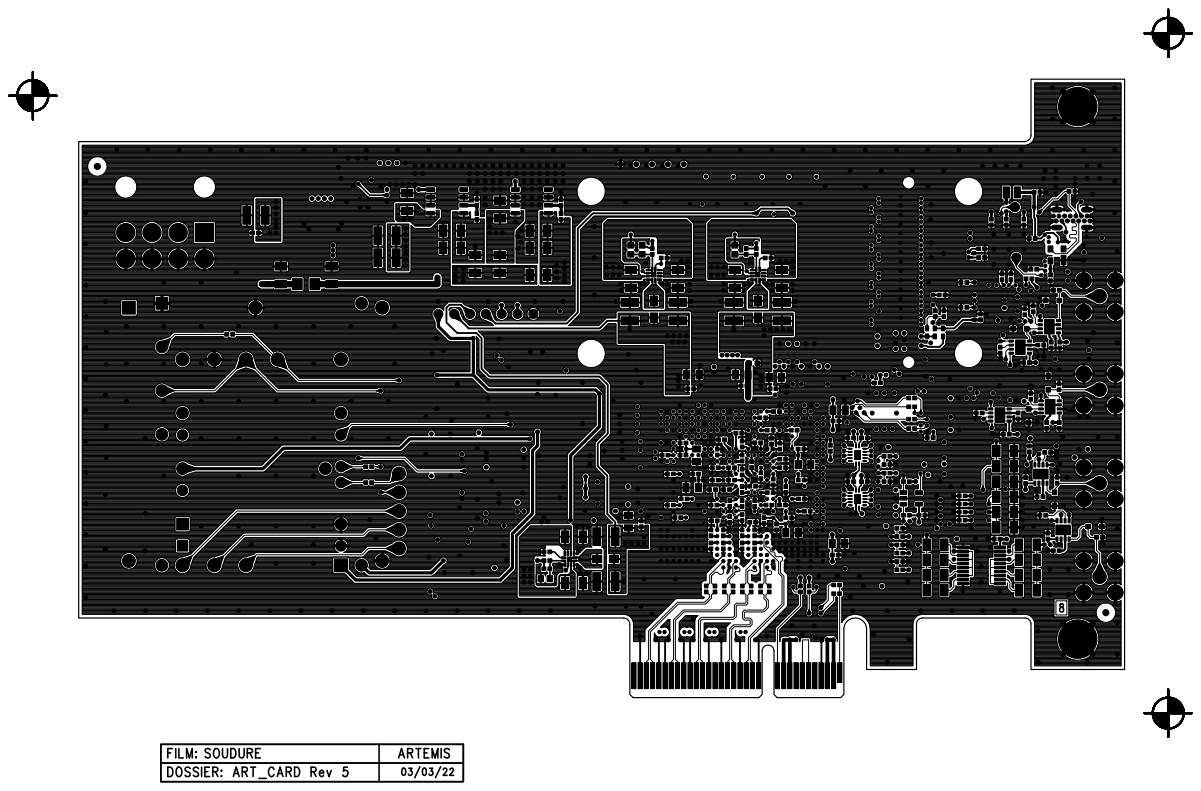
[picture p22: page 22]

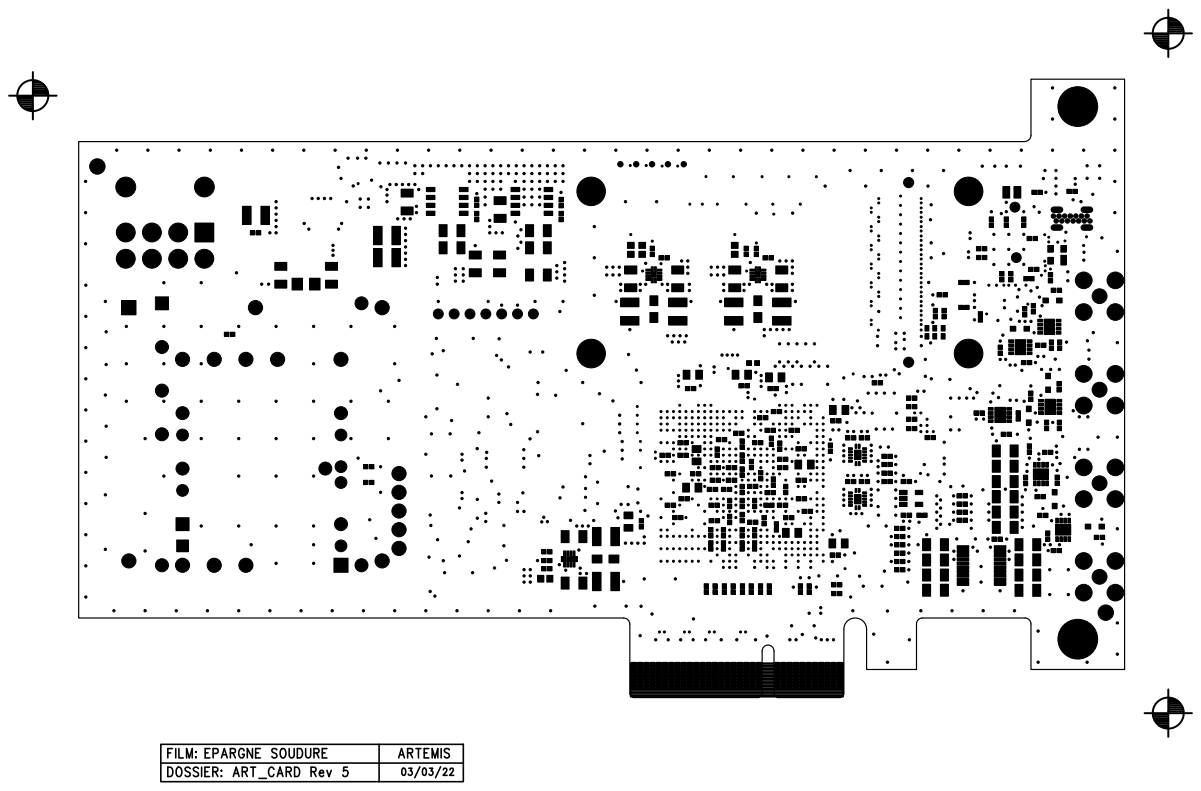
[picture p23: page 23]

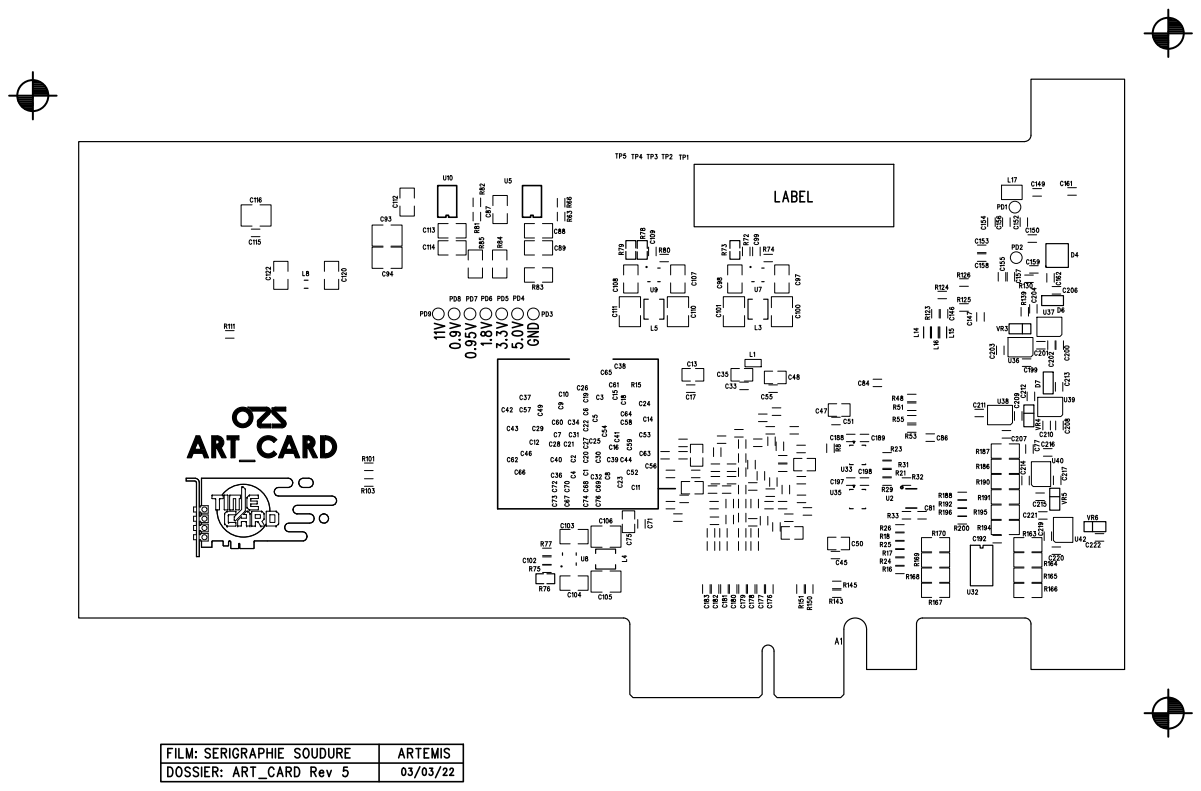
[picture p24: page 24]

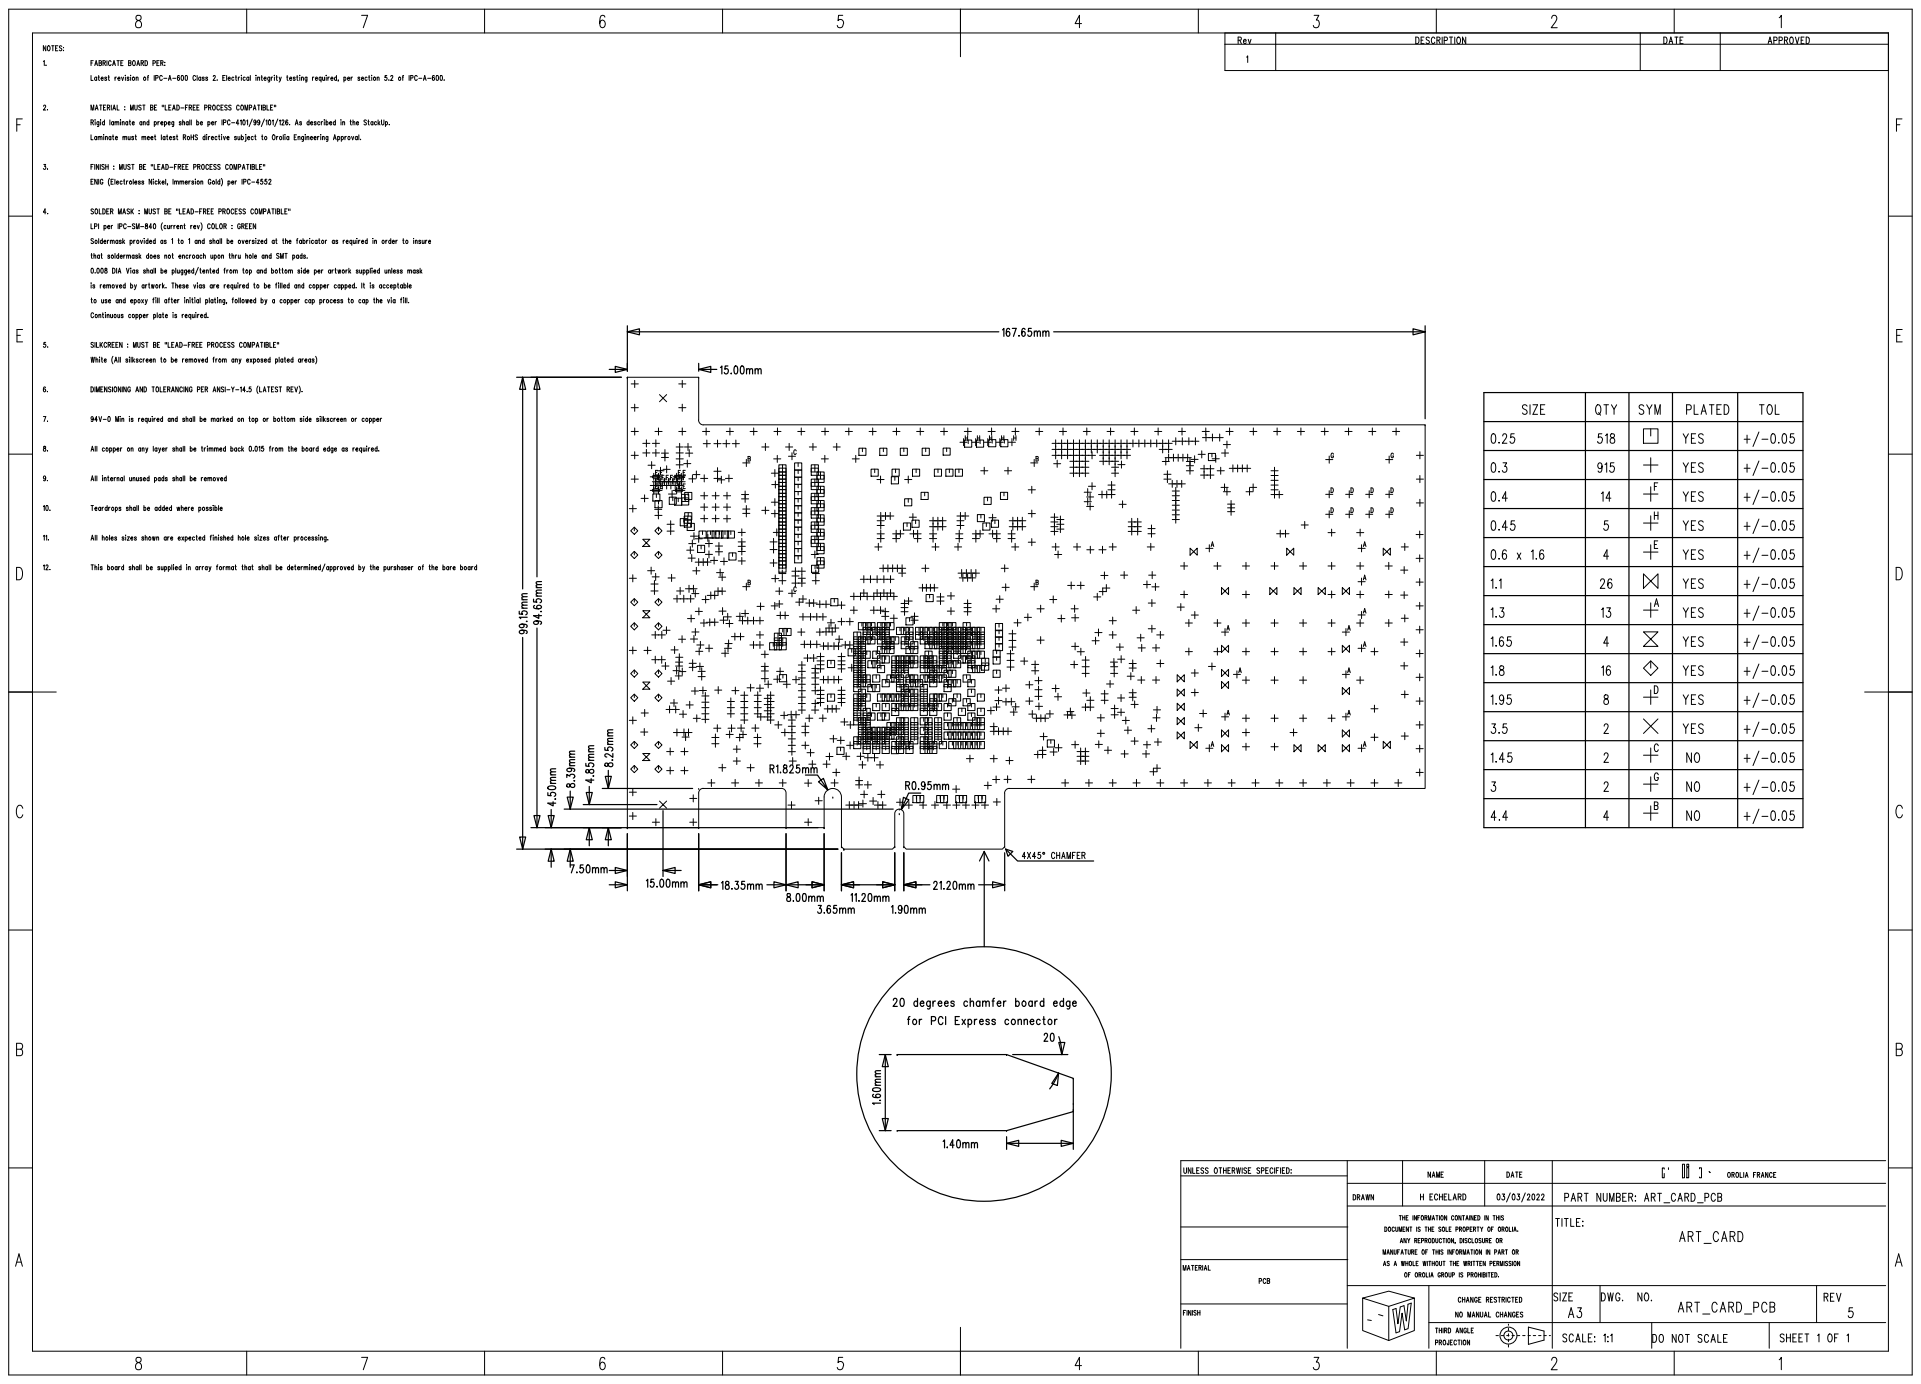
[picture p25: page 25]

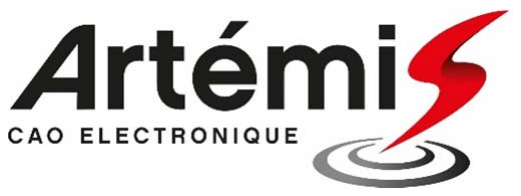
[picture p26: figure]

# Angers Technopole 1 bis Avenue du Bois l’Abbé 49070 BEAUCOUZÉ FRANCE Phone : +33(0)2-41-48-98-68 p.benoit@artemis-cad.com www.artemis-cad.com

# PCB Reference :

✓ | PCB Unit | Unit PCB dimensions : | mm
Panel PCB : | Panel dimensions : | mm
Surface : | dm² | / | mm

# Finish Copper Thikness (µm) :

✓
✓
✓ | Plated Trough Hole | Via type : | Hole / pads ratio :
✓ | Traditional | Press-fit Hole | ✓ | Traditional Via | Via in pad
✓ | SMT | Autre | Laser Via | Stacked | Staggered
Surface Treatement Finished | Blinded Via
✓ | Buried Via
Filled Via | Resin | Copper
Peelable Solder Mask | Standard | TOP | BOTTOM
✓ | Photo-imageable | ✓ | TOP | ✓ | BOTTOM
✓ | Ink | ✓ | TOP | ✓ | BOTTOM
✓ | Yes | No
✓ | Impedance control : | ✓ | Produced | Measured
✓ | Differential Pairs : | ✓ | Produced | Measured
✓ | Stack-up :
Milling | Milling Diameter : | mm

Pour les lignes 85 et 90 ohms, ajuster les largeurs si necessaire en gardant les isolations.

# TECHNICAL SPECIFICATION

# IPC-A-600

# OROLIA

ART_CARD | Index : | Rev 5
Track / Gap : | 0.15

167.65 X 99.15

0 | X | 0
Technology | 0,25/0,55

0.15

PCB Type : | MC8 | 12µ | 17,5µ | 35µ | 40µm
PCB Thickness (mm) : | 16/10 | External Layer :

# Intern Layer :

Material : | FR4 | 1.66

# Couche départ et d'arrivée

Ni/Au Chemical | Couche départ et d'arrivée
Sn/Cu HAL | Autre Sn/Pb surfondu
Solder Mask | Green
Silkscreen | White

# Electrical Test

0

# MANUFACTURER :

# CUSTUMER :

# 50 ohms

# 85 ohms on layer 1, 3 and 8 ; 90 ohms on layer 4, 5 and 8

voir avec le fabricant PCB et selon contraintes.

0

# Comments :

Construire un empilage pour avoir avoir des lignes 50 ohms en 150µm ( classe de la carte )
