Orolia2s/art-card-board/Schematic/ART_CARD_Rev4.pdf

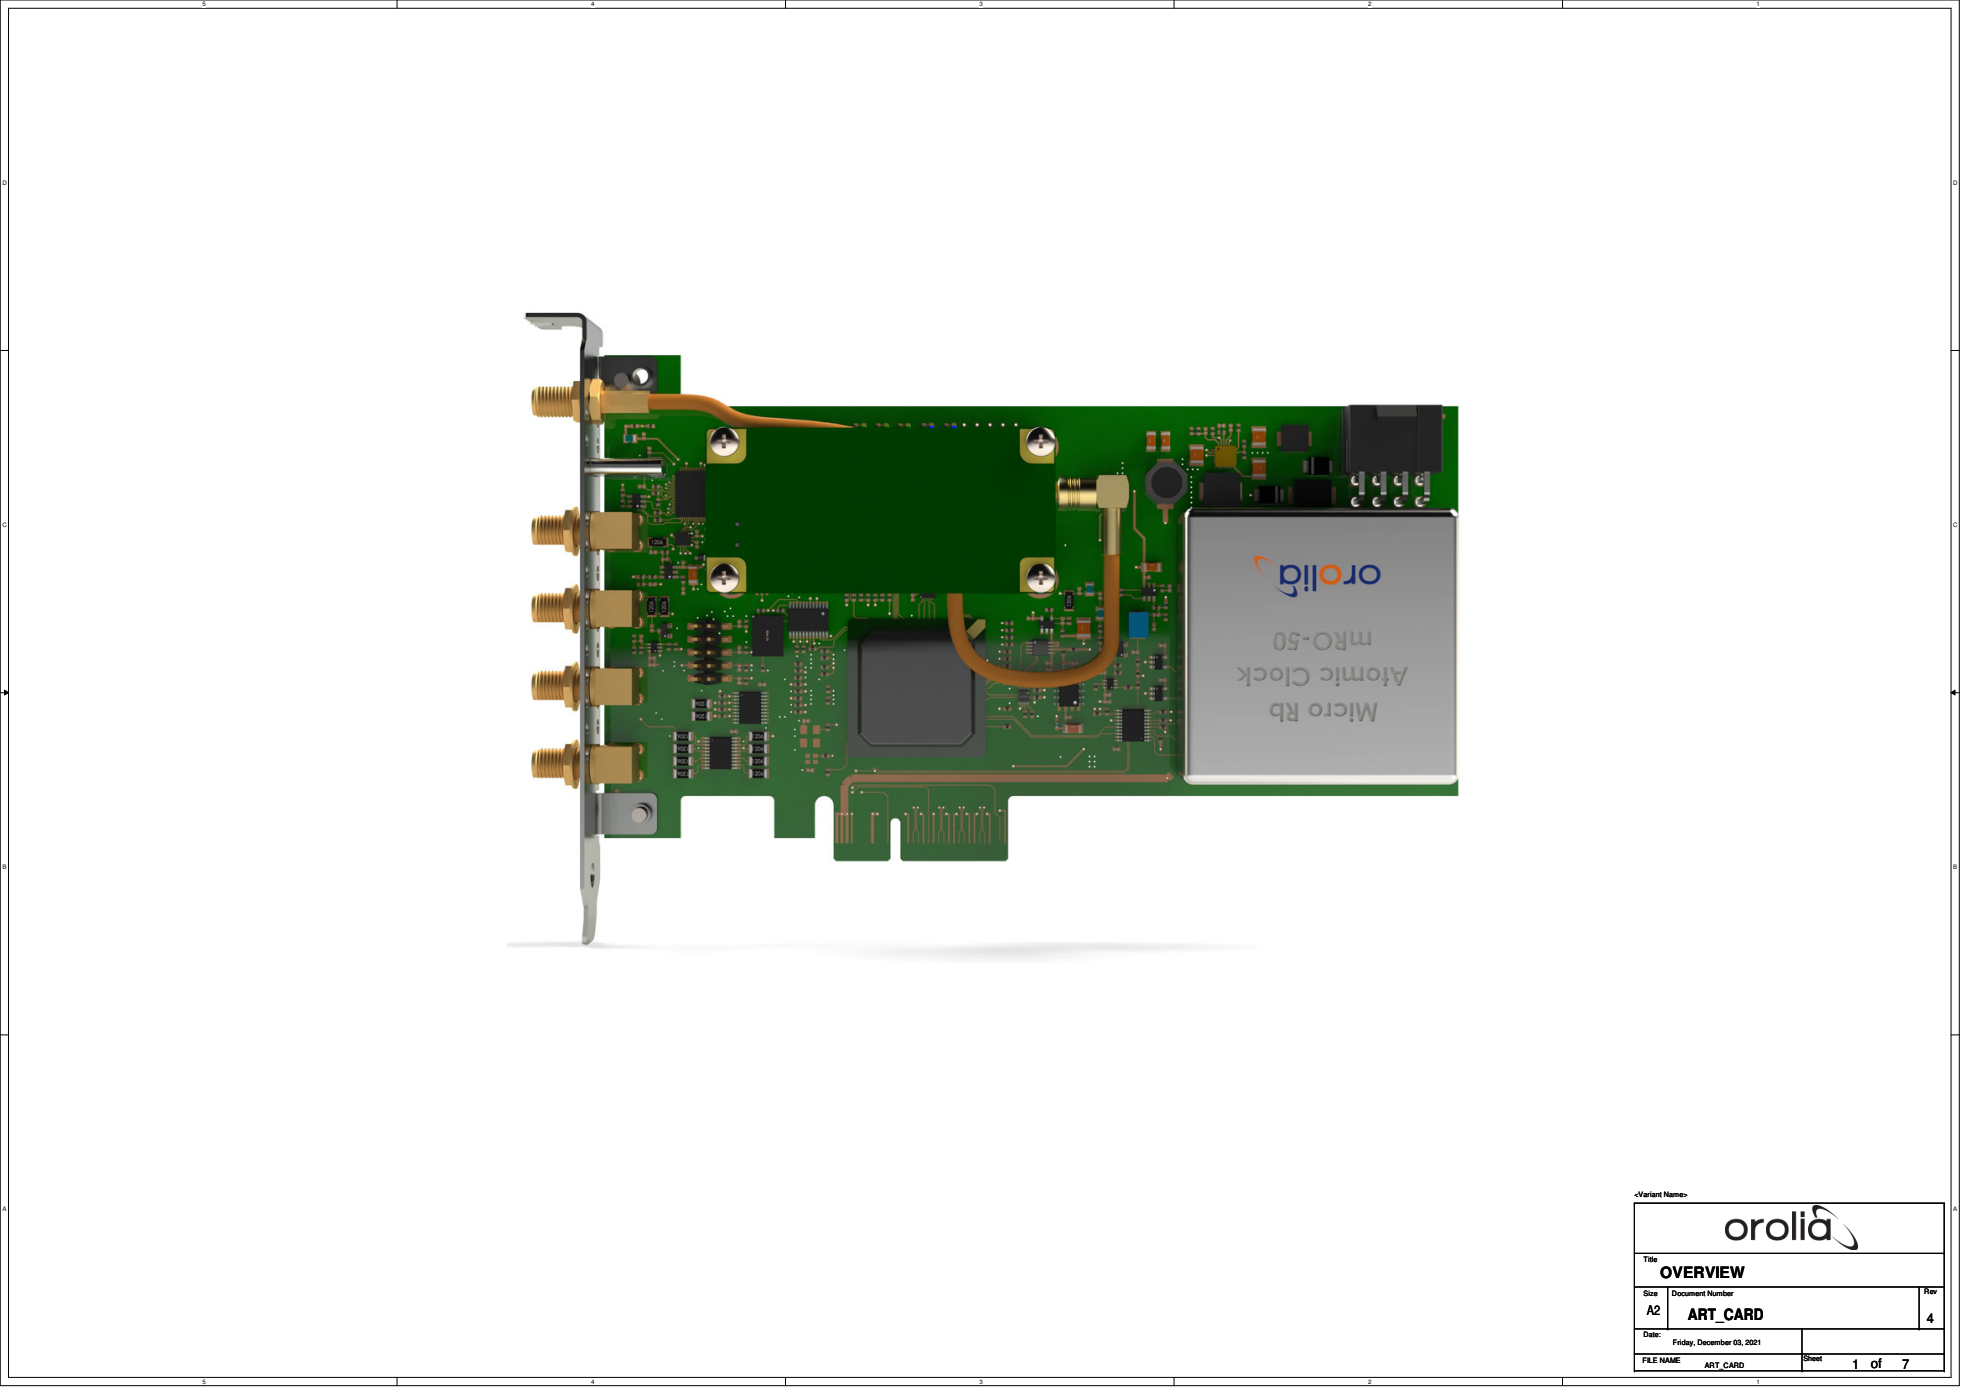
[picture p27: page 1]
Title; OVERVIEW; <Variant Name>

Size | Document Number ART_CARD | Rev 4 A2

Date: Friday, December 03, 2021

FILE NAME ART_CARD ART_CARD ART_CARD | Sheet of 1 1 1 7 7 7

# VCC Decoupling

# FPGA POWER SUPPLY

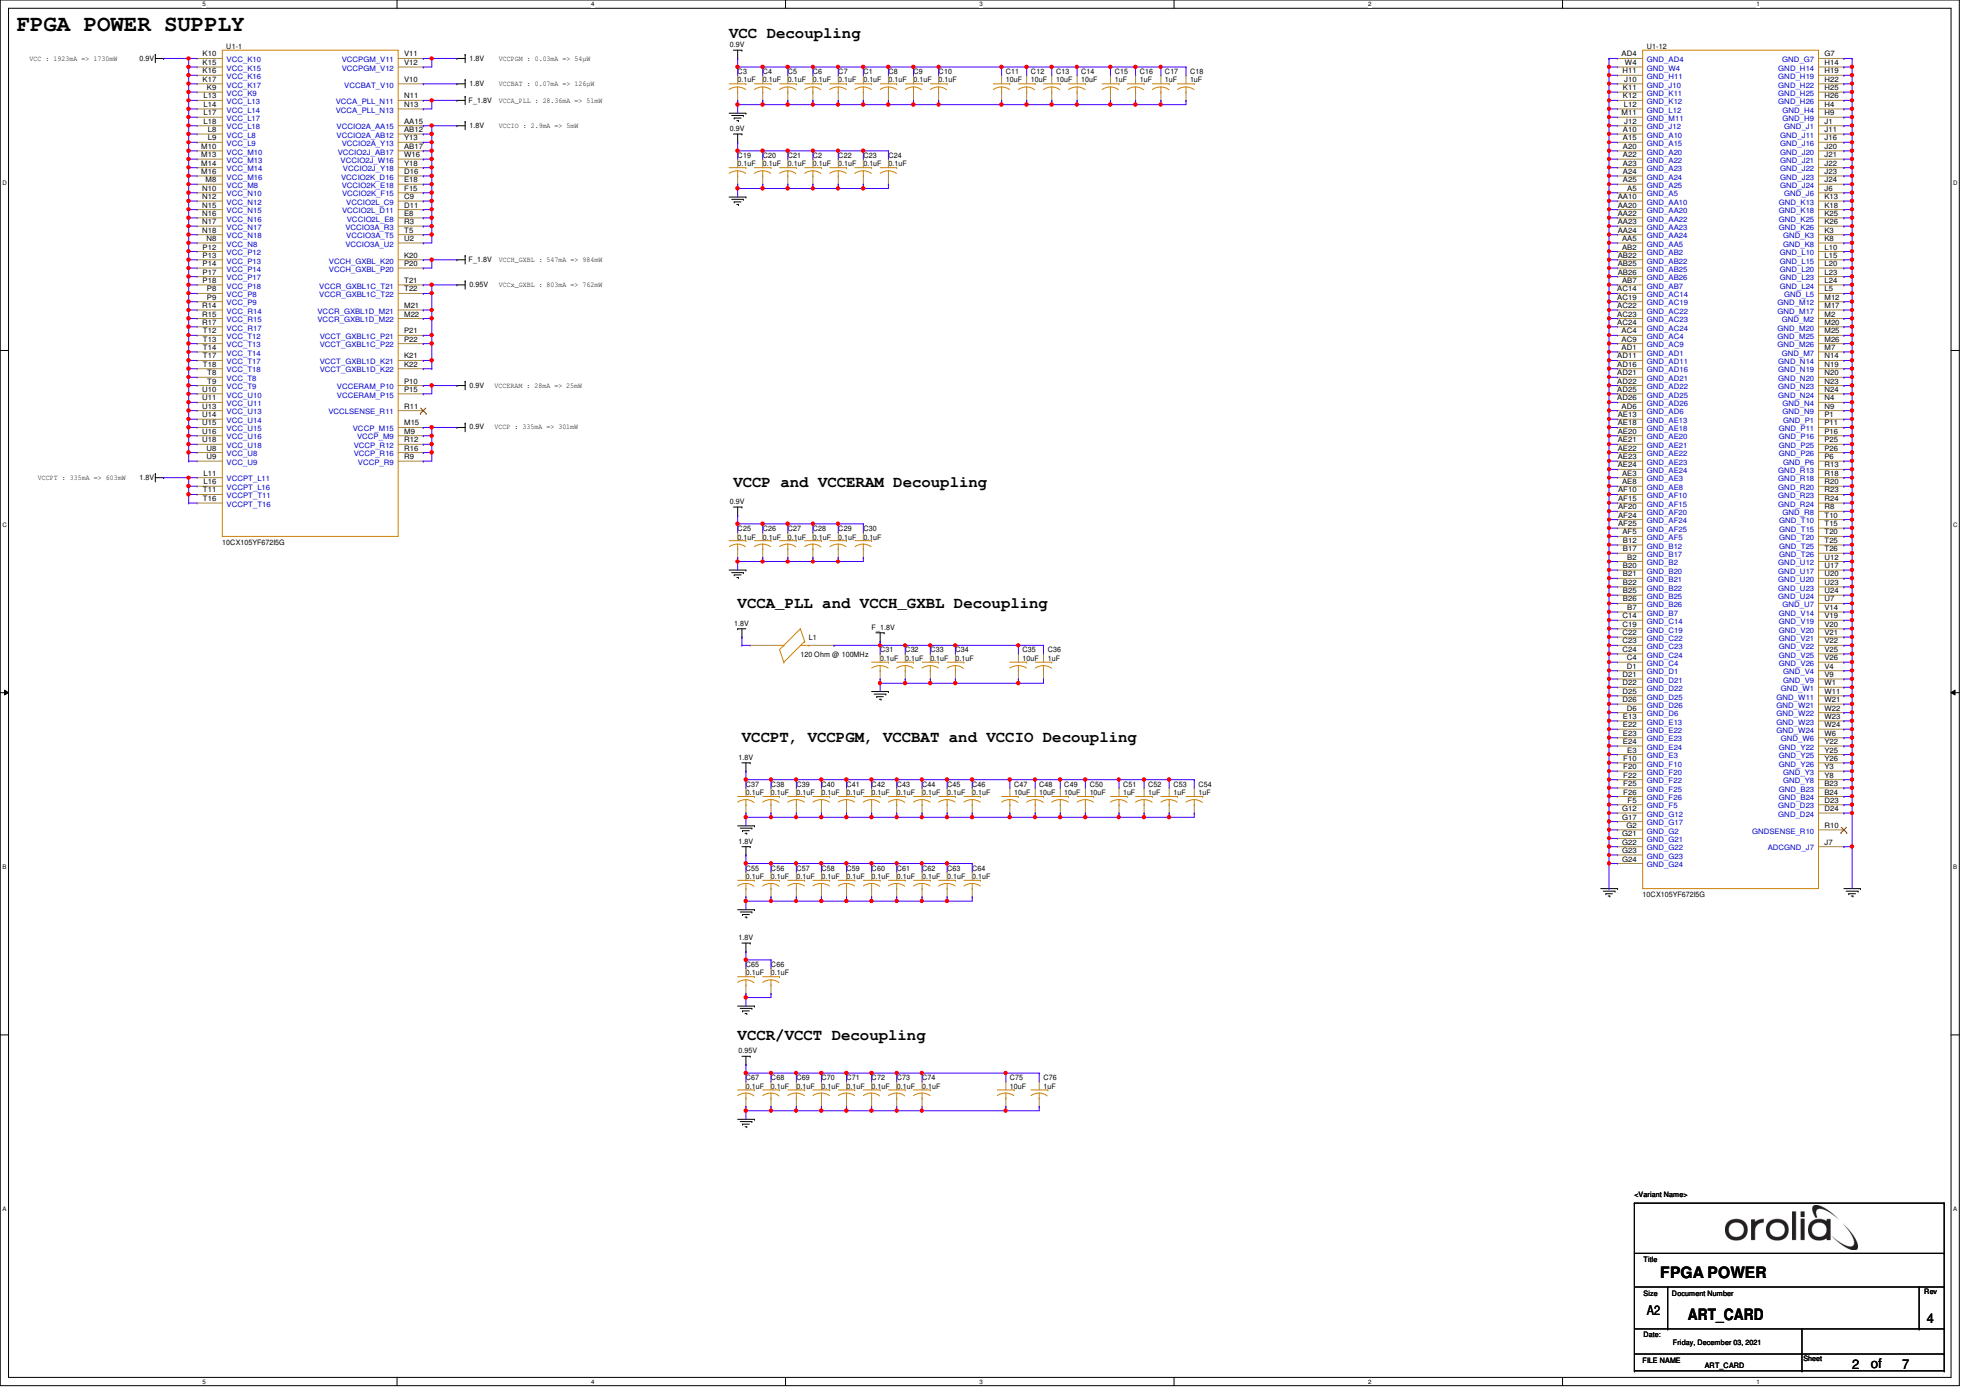
[picture p28: page 2]

VCCP and VCCERAM Decoupling

VCCPT, VCCPGM, VCCBAT and VCCIO Decoupling

# FPGA

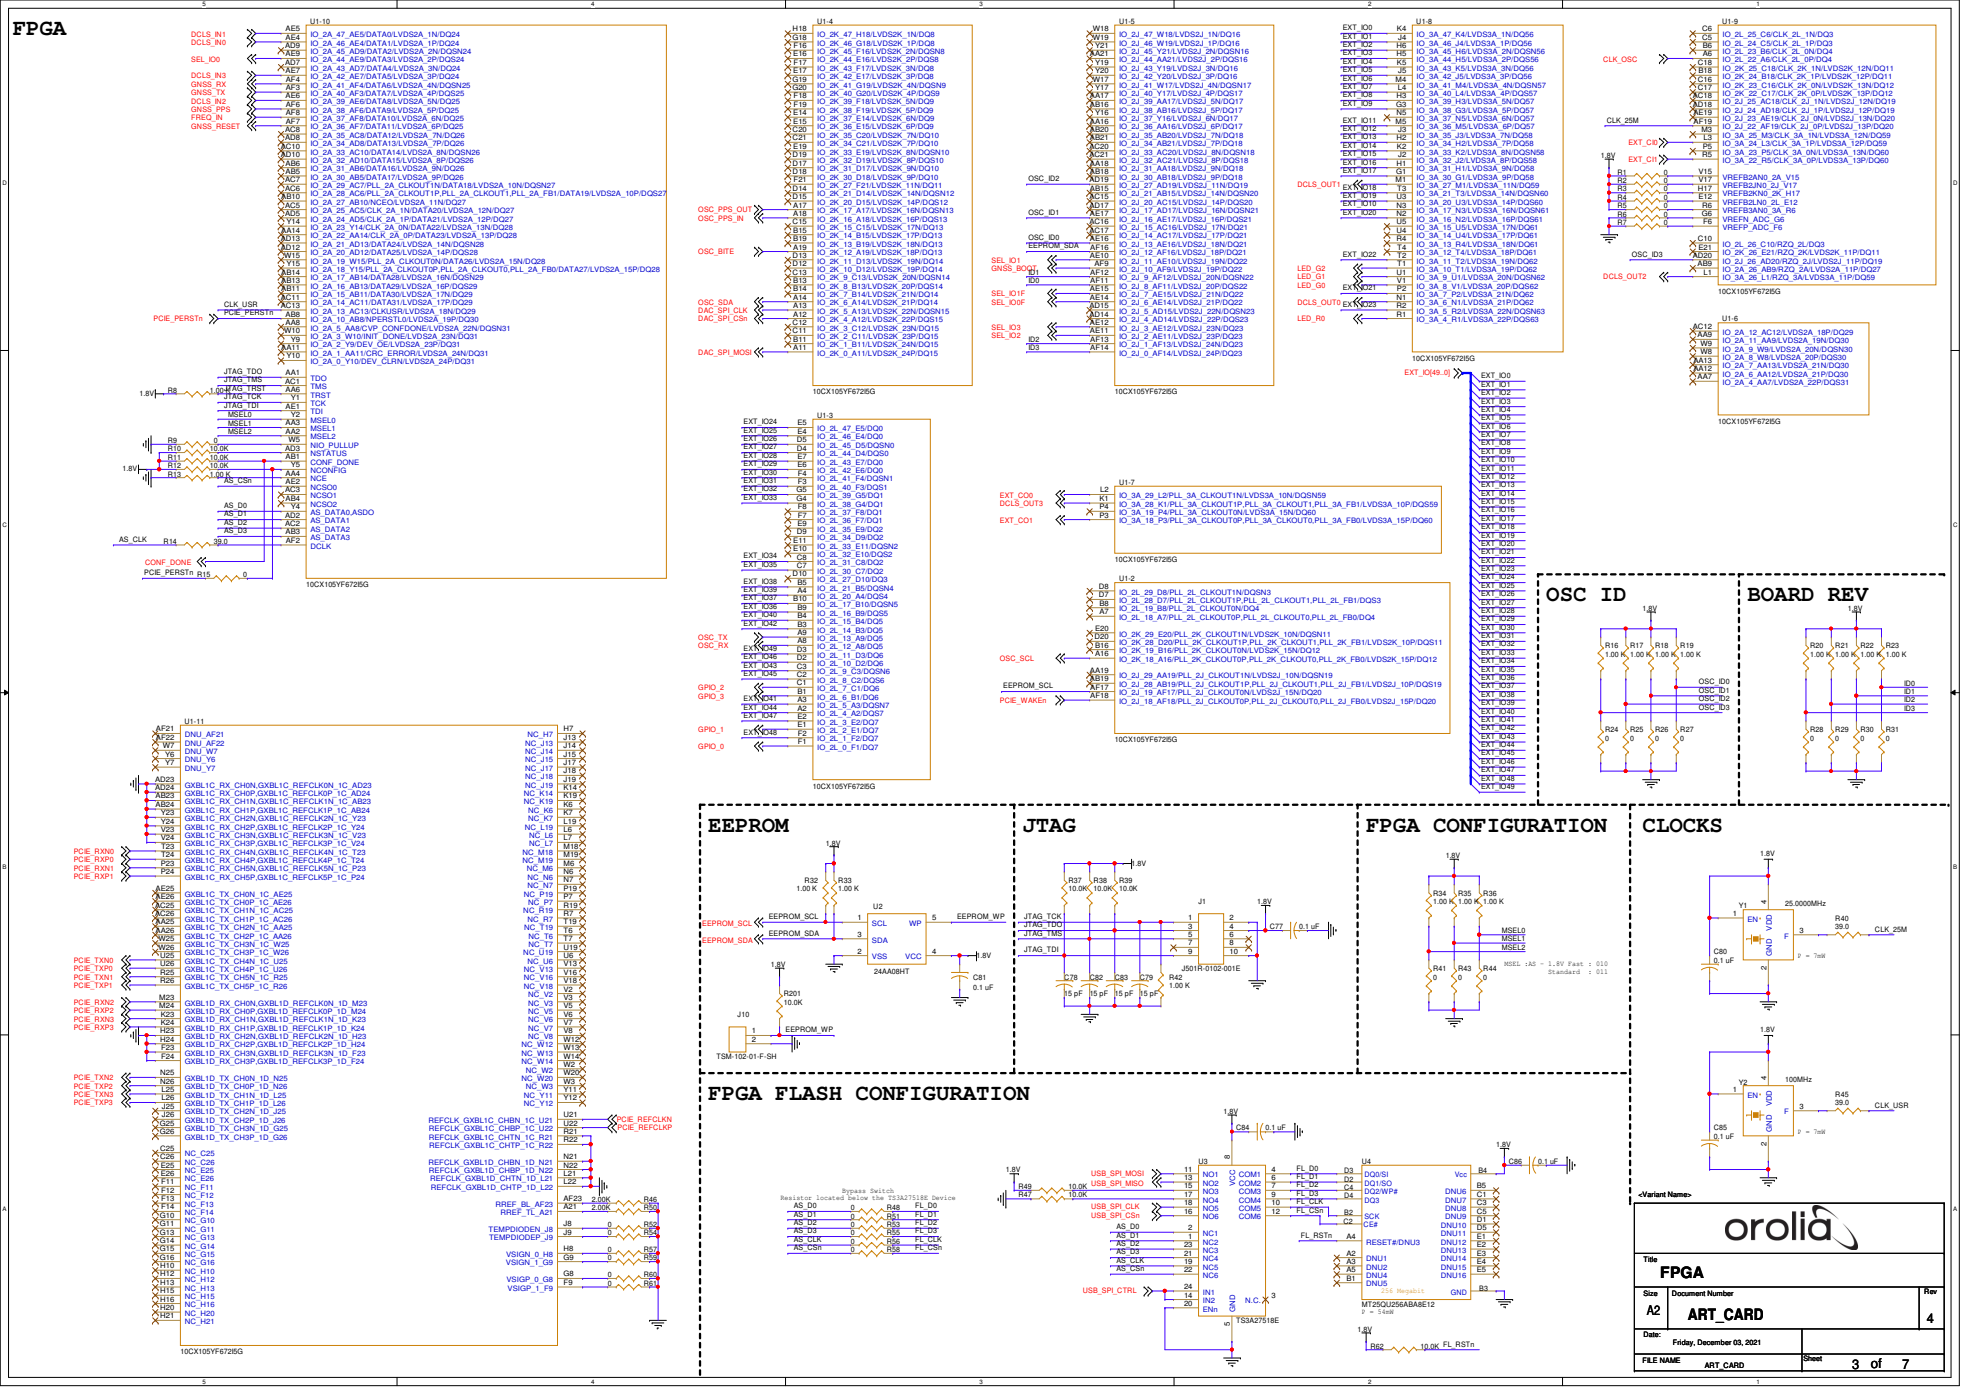
[picture p29: page 3]

## 10mV Ripple Voltage Max

## POWER NEED : FPGA : OCXO : Comp : TOTAL

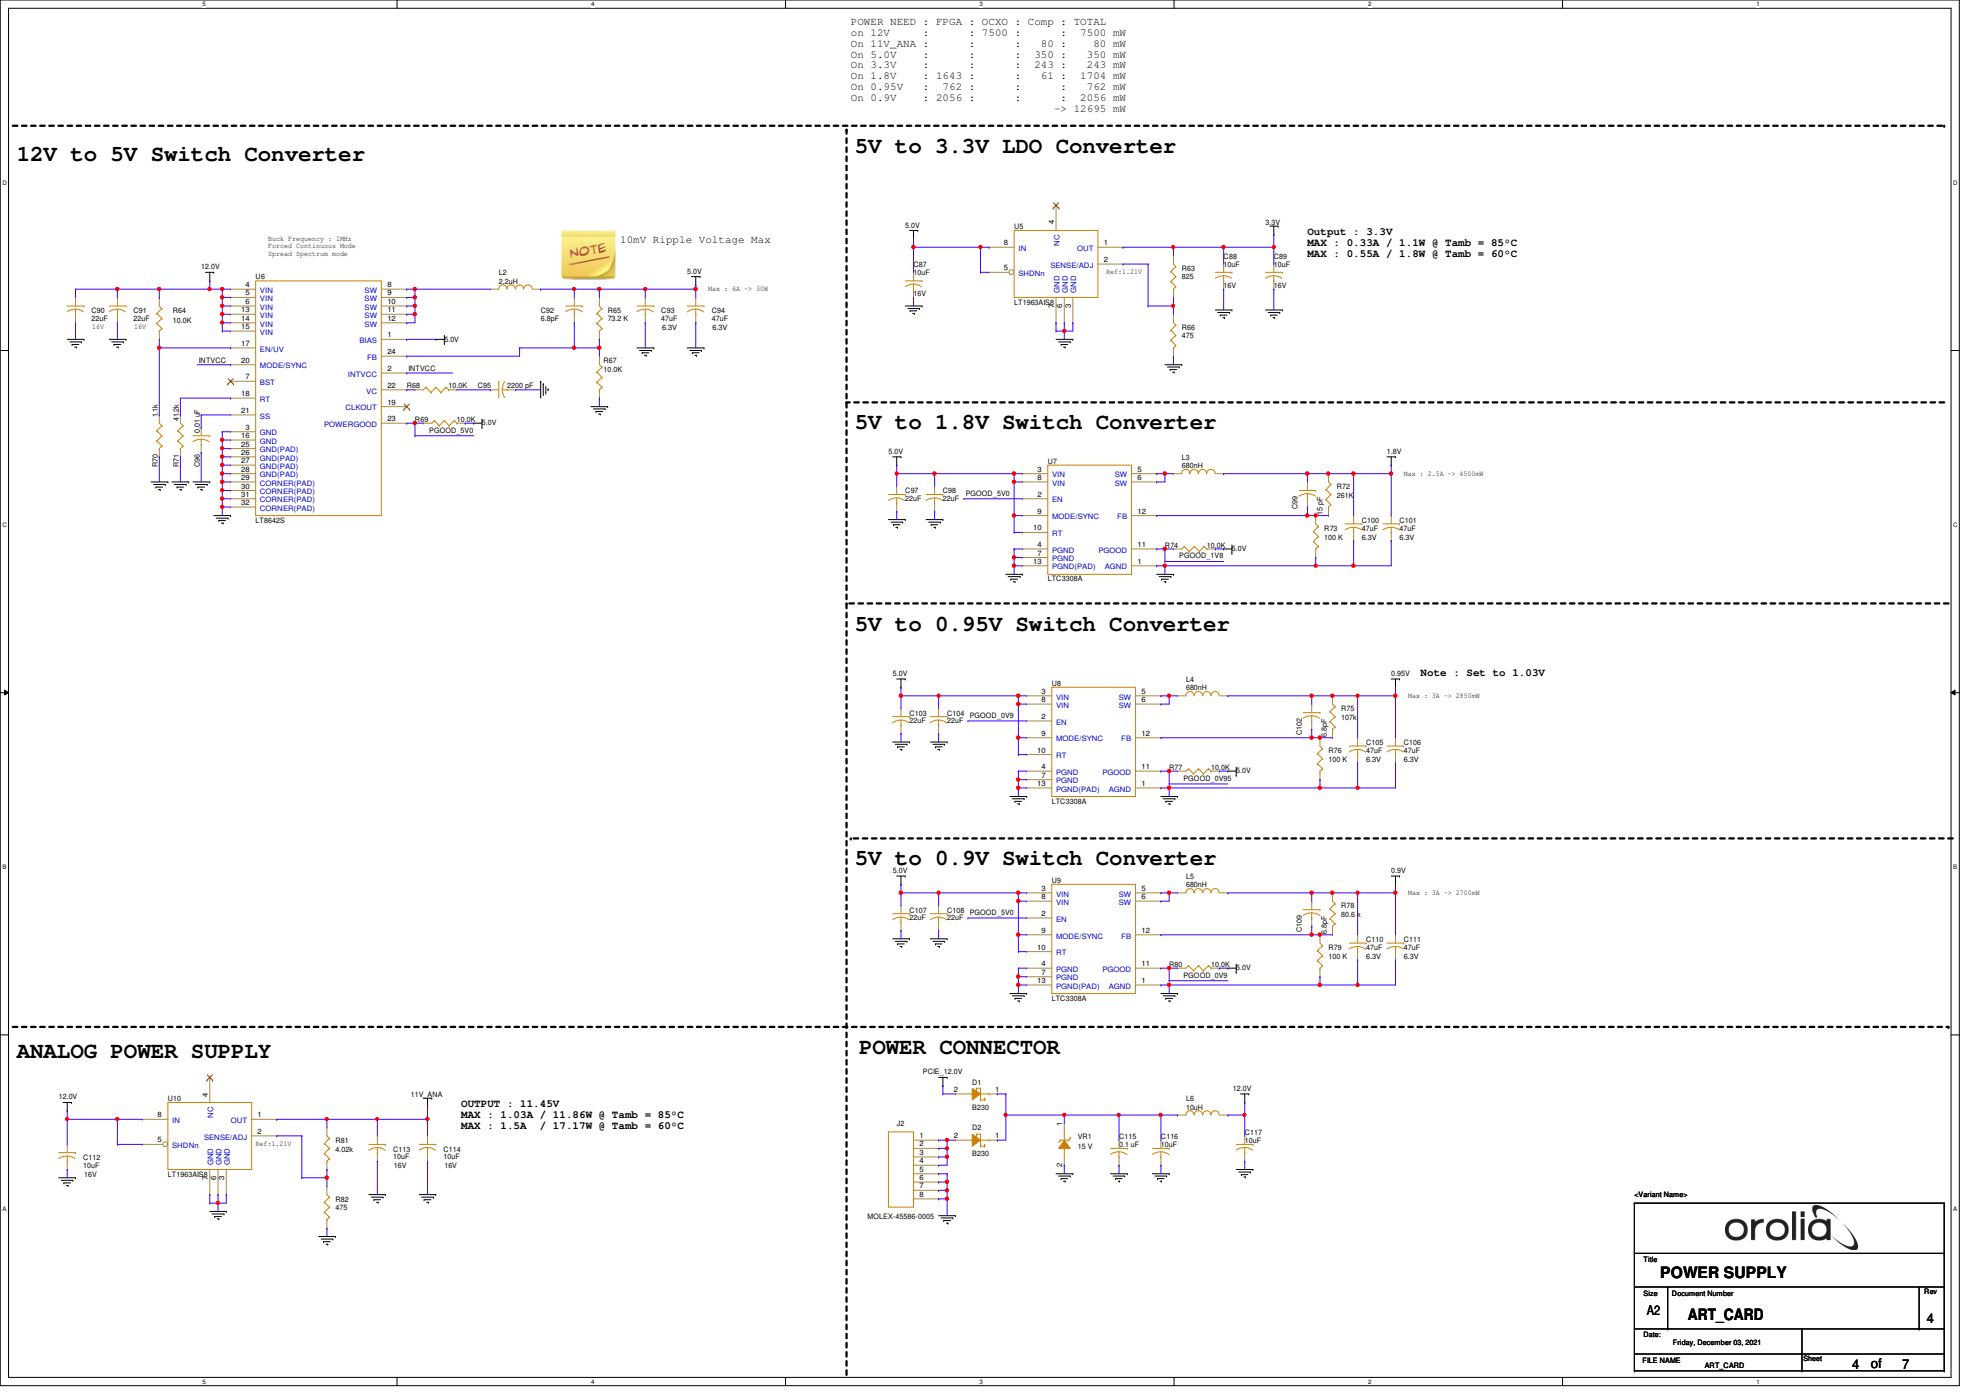
[picture p30: page 4]

# MiniRubidium

# OSCILLATOR POWER SUPPLY

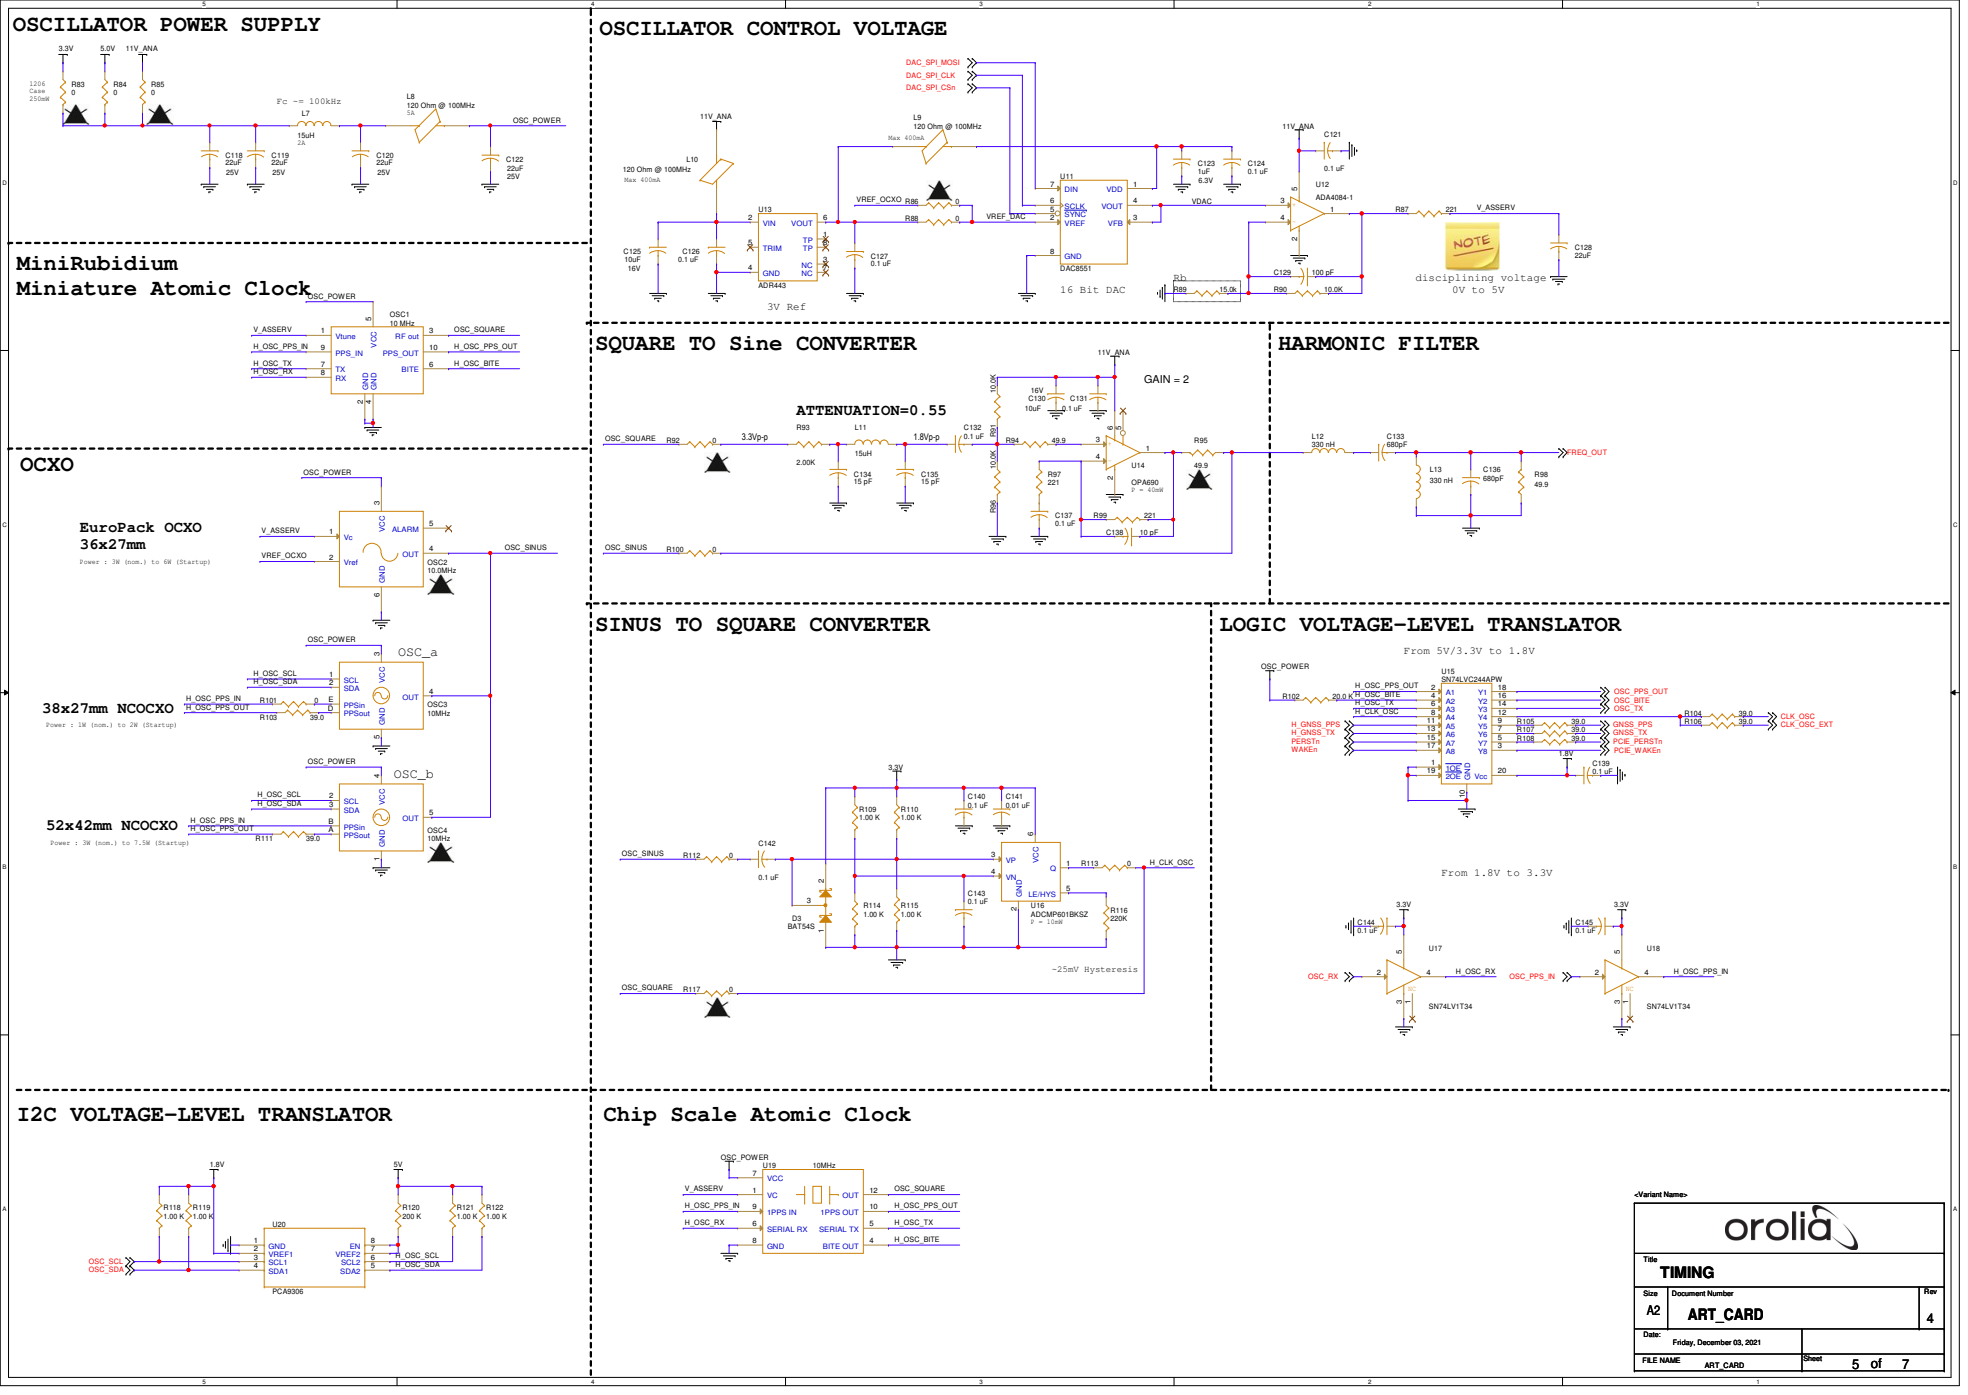
[picture p31: page 5]

SQUARE TO Sine CONVERTER

Power : 3W (nom.) to 6W (Startup)

Power : 1W (nom.) to 2W (Startup)

Power : 3W (nom.) to 7.5W (Startup)

Chip Scale Atomic Clock

ANTENNA POWER SUPPLY | GNSS RECEIVER | GNSS STANDOFF

## From 1.8V to 3.3V

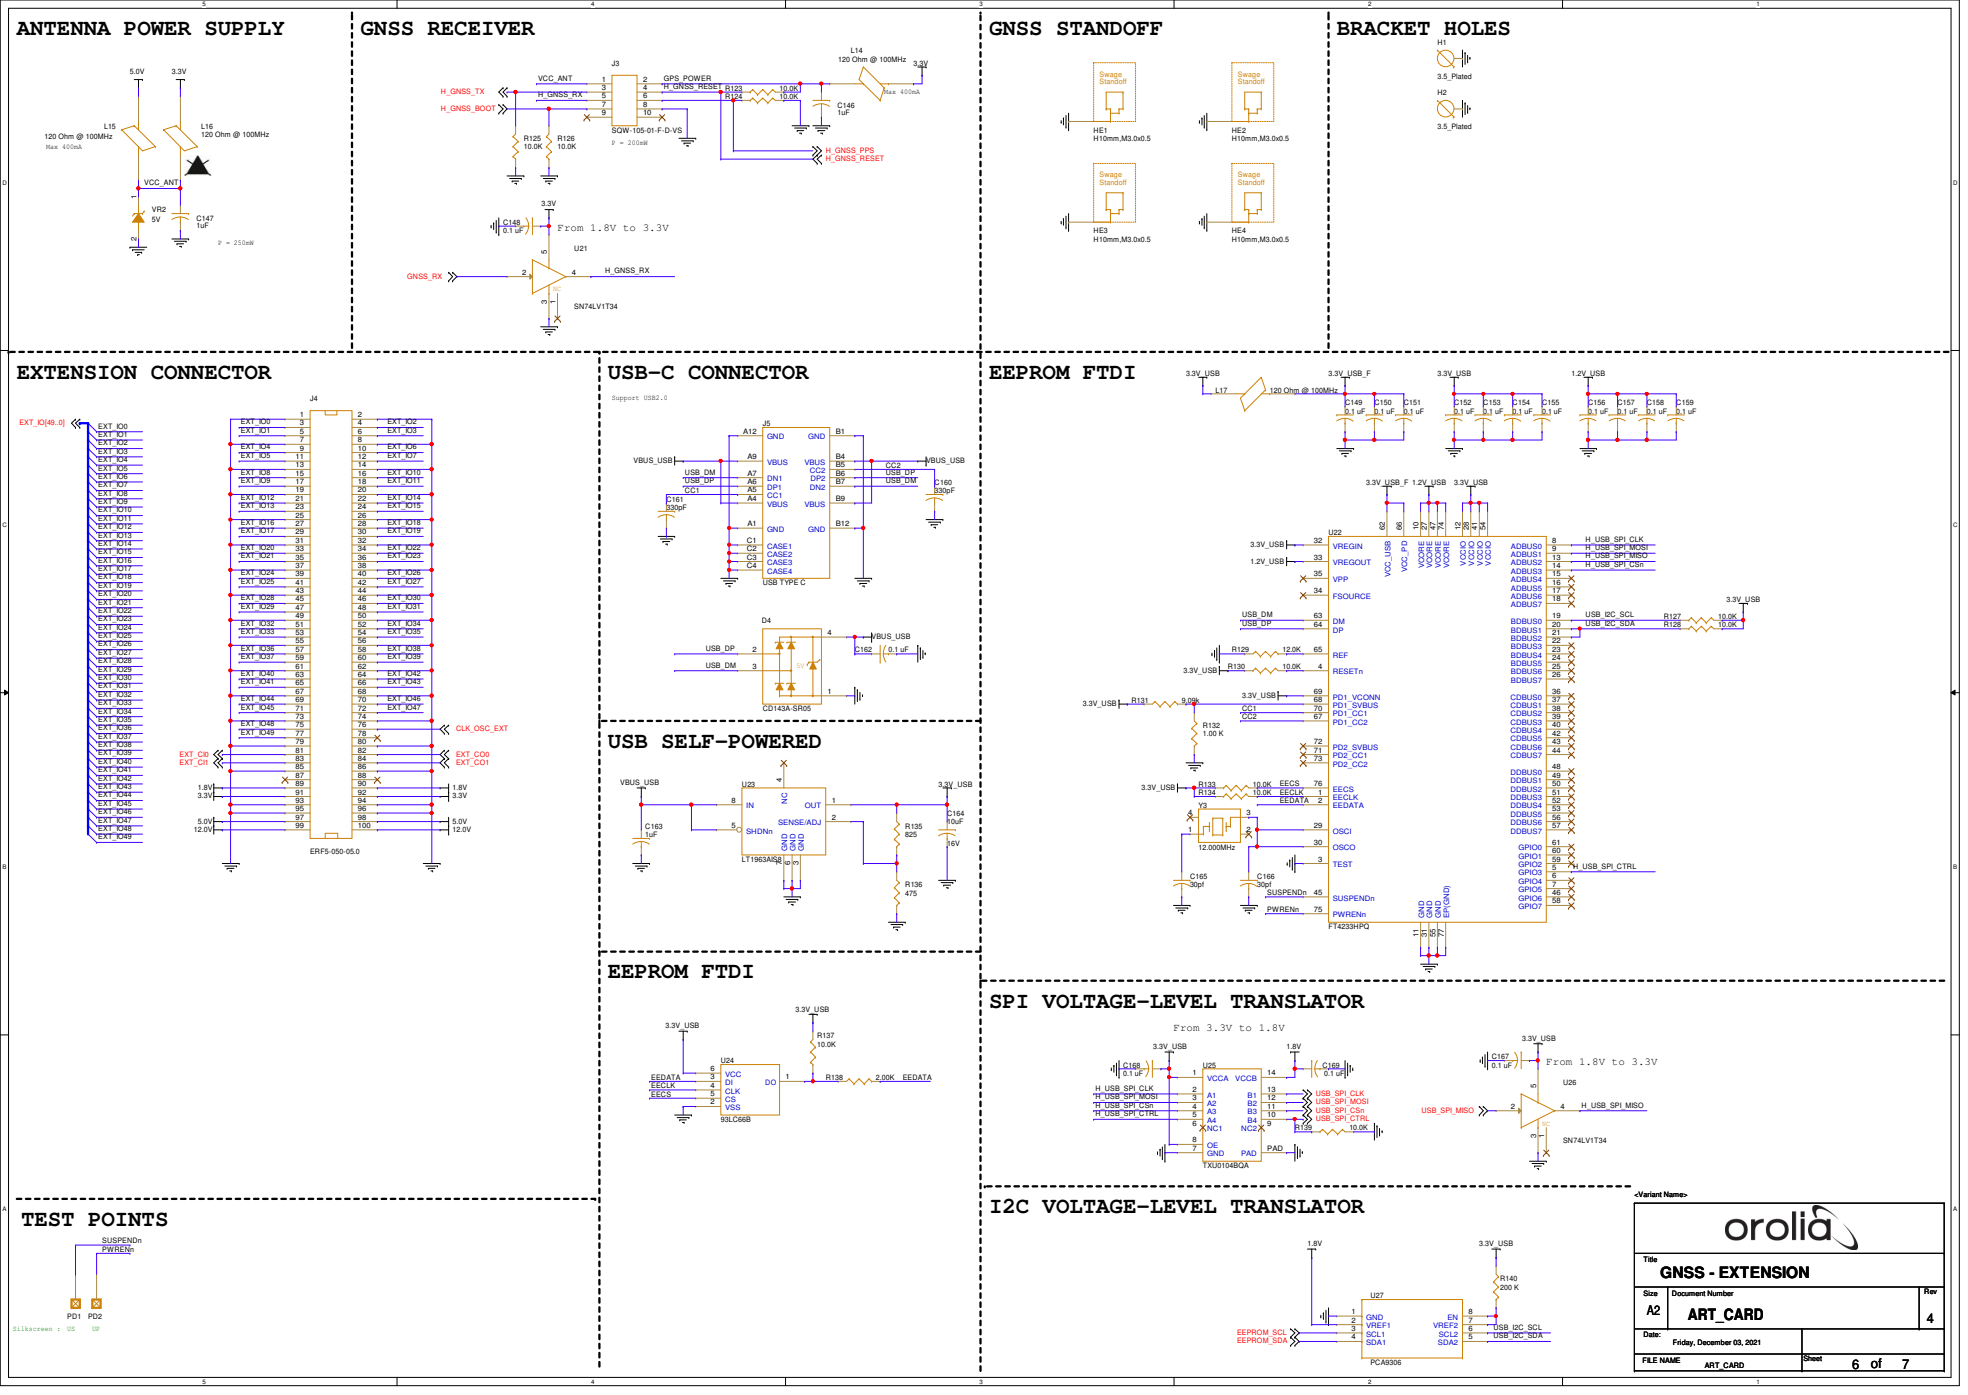
[picture p32: page 6]

SPI VOLTAGE-LEVEL TRANSLATOR

## Ra is 102 ohms GAIN = 3.17

## Ra is 124 ohms GAIN = 2.8

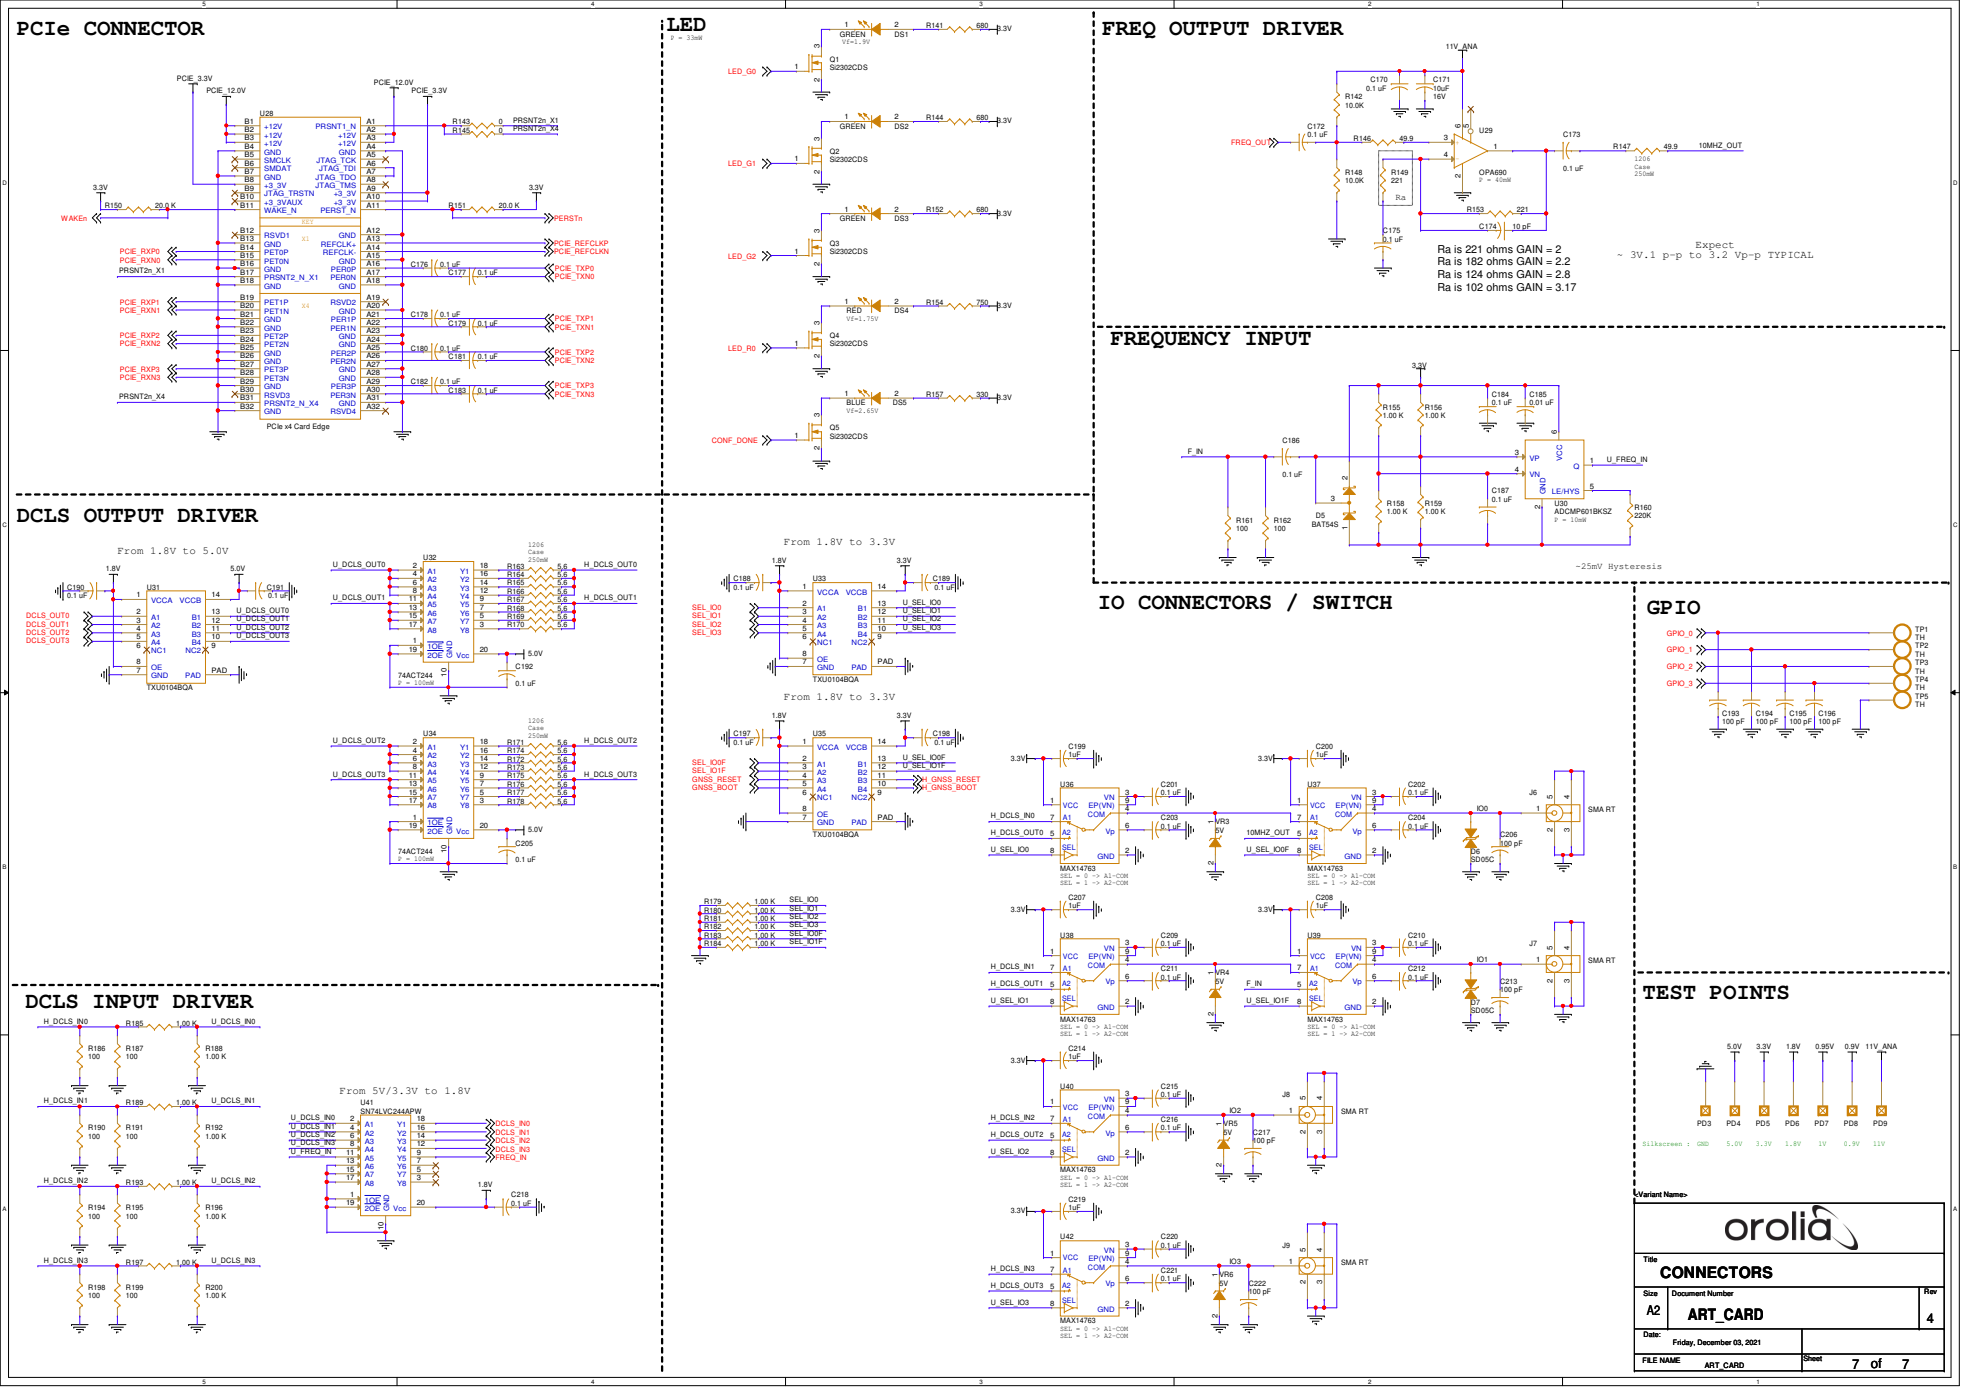
[picture p33: page 7]

Ra is 221 ohms GAIN = 2
Ra is 182 ohms GAIN = 2.2
