Orolia2s/art-card-board/Schematic/ART_CARD_Rev3.pdf

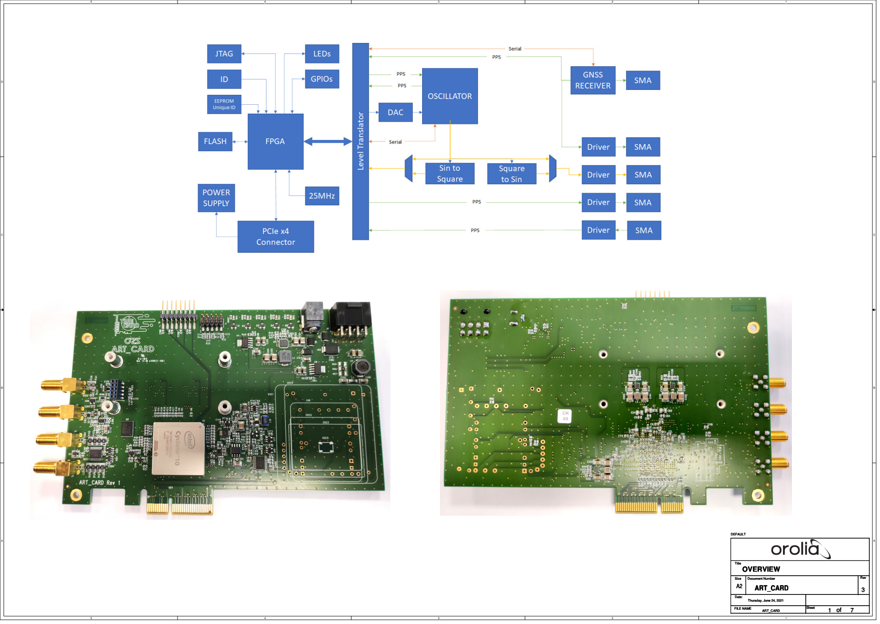
[picture p34: page 1]
Title; OVERVIEW; DEFAULT

Size | Document Number ART_CARD | Rev 3 A2

Date: Thursday, June 24, 2021

FILE NAME ART_CARD ART_CARD ART_CARD | Sheet of 1 1 1 7 7 7

# VCC Decoupling

# FPGA POWER SUPPLY

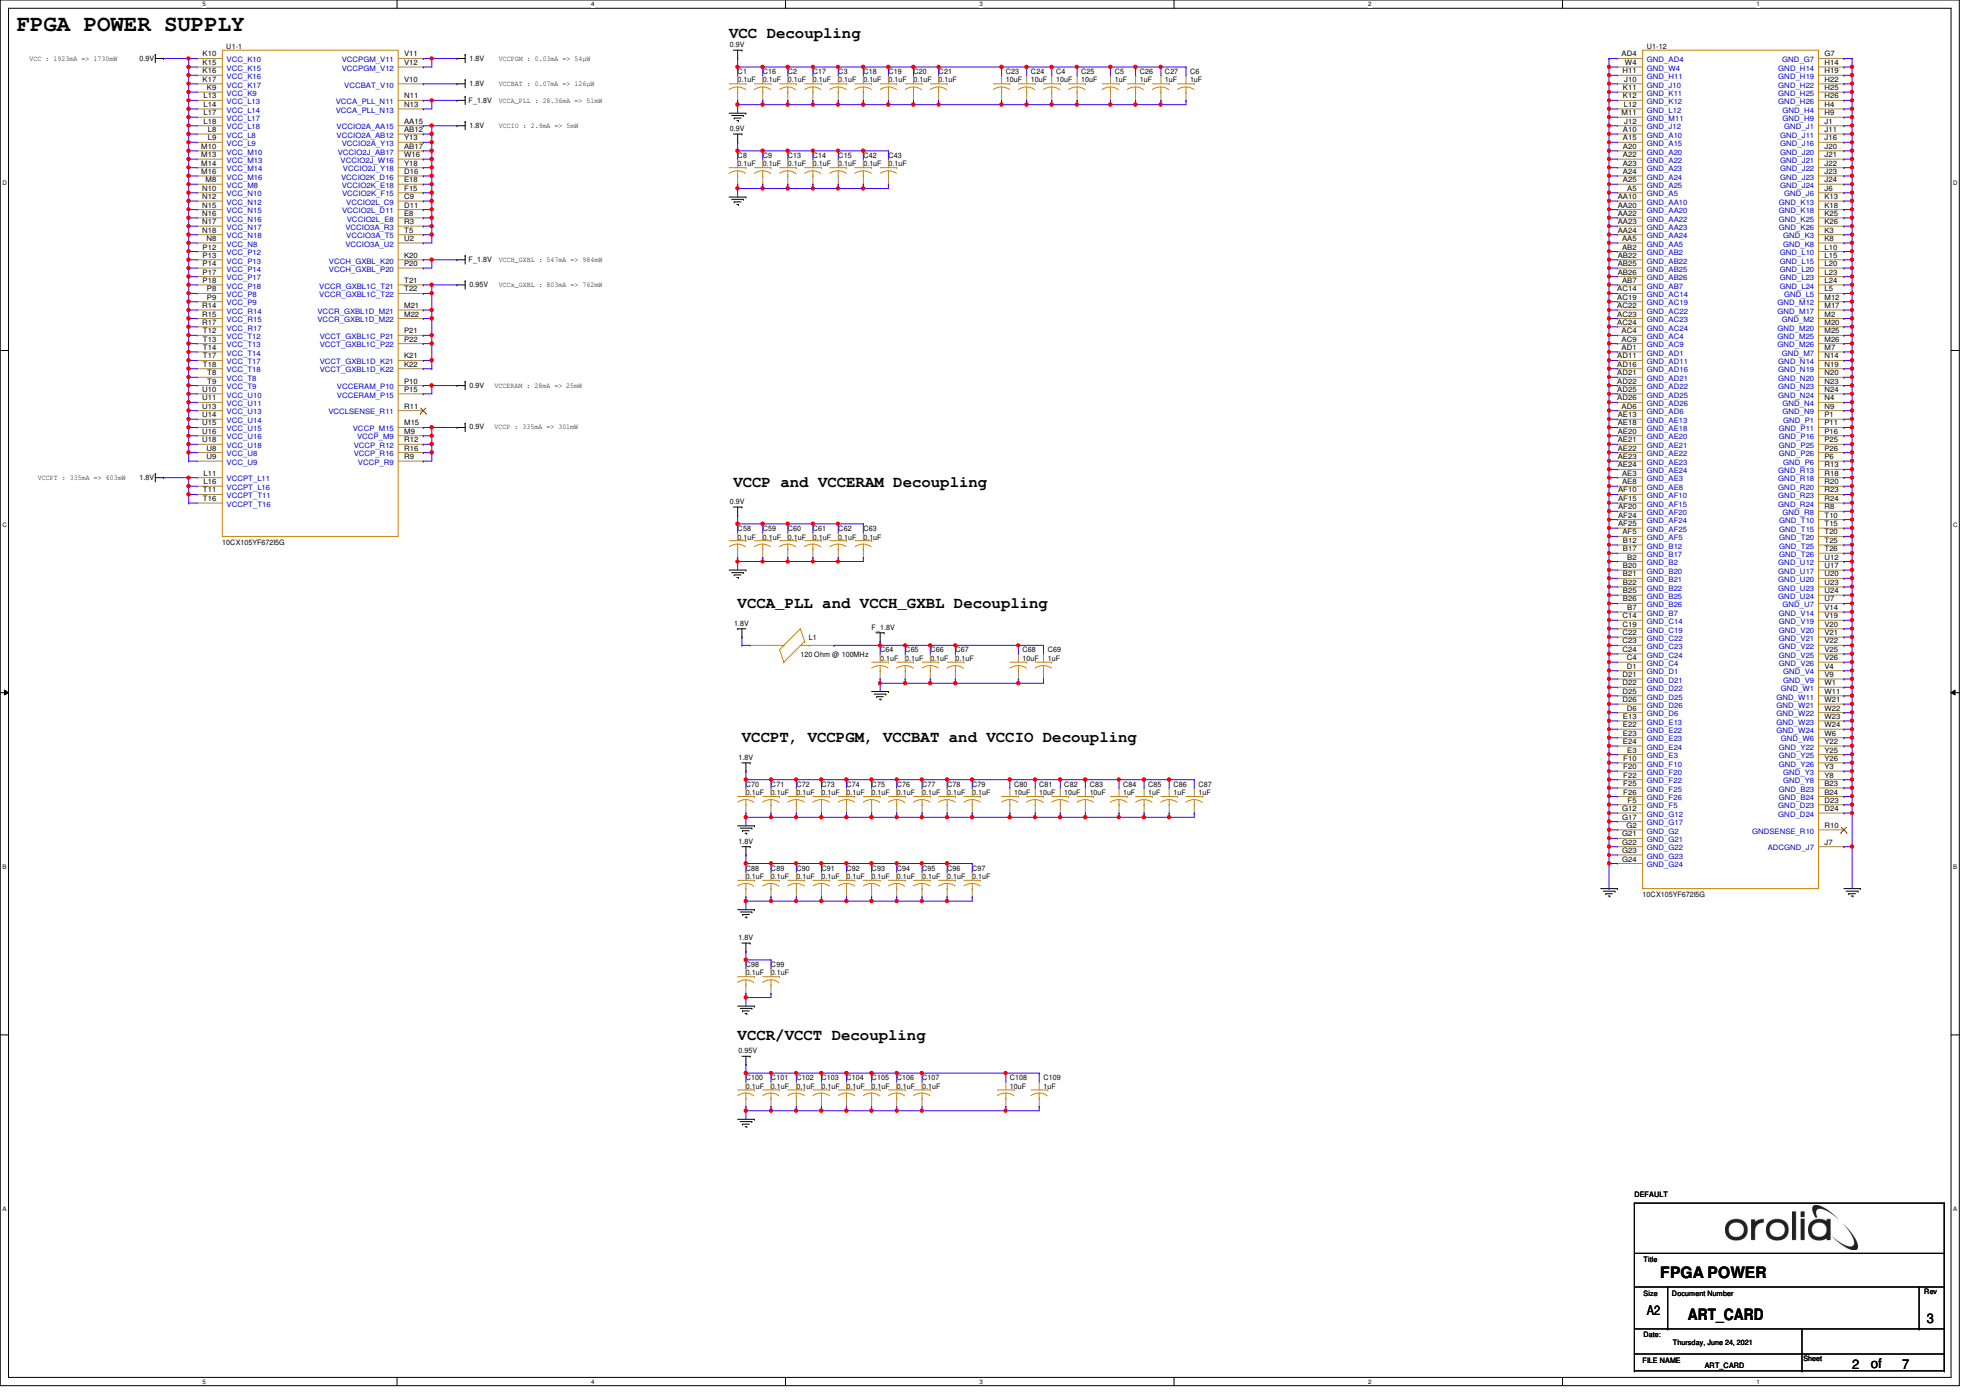
[picture p35: page 2]

VCCP and VCCERAM Decoupling

VCCPT, VCCPGM, VCCBAT and VCCIO Decoupling

# FPGA

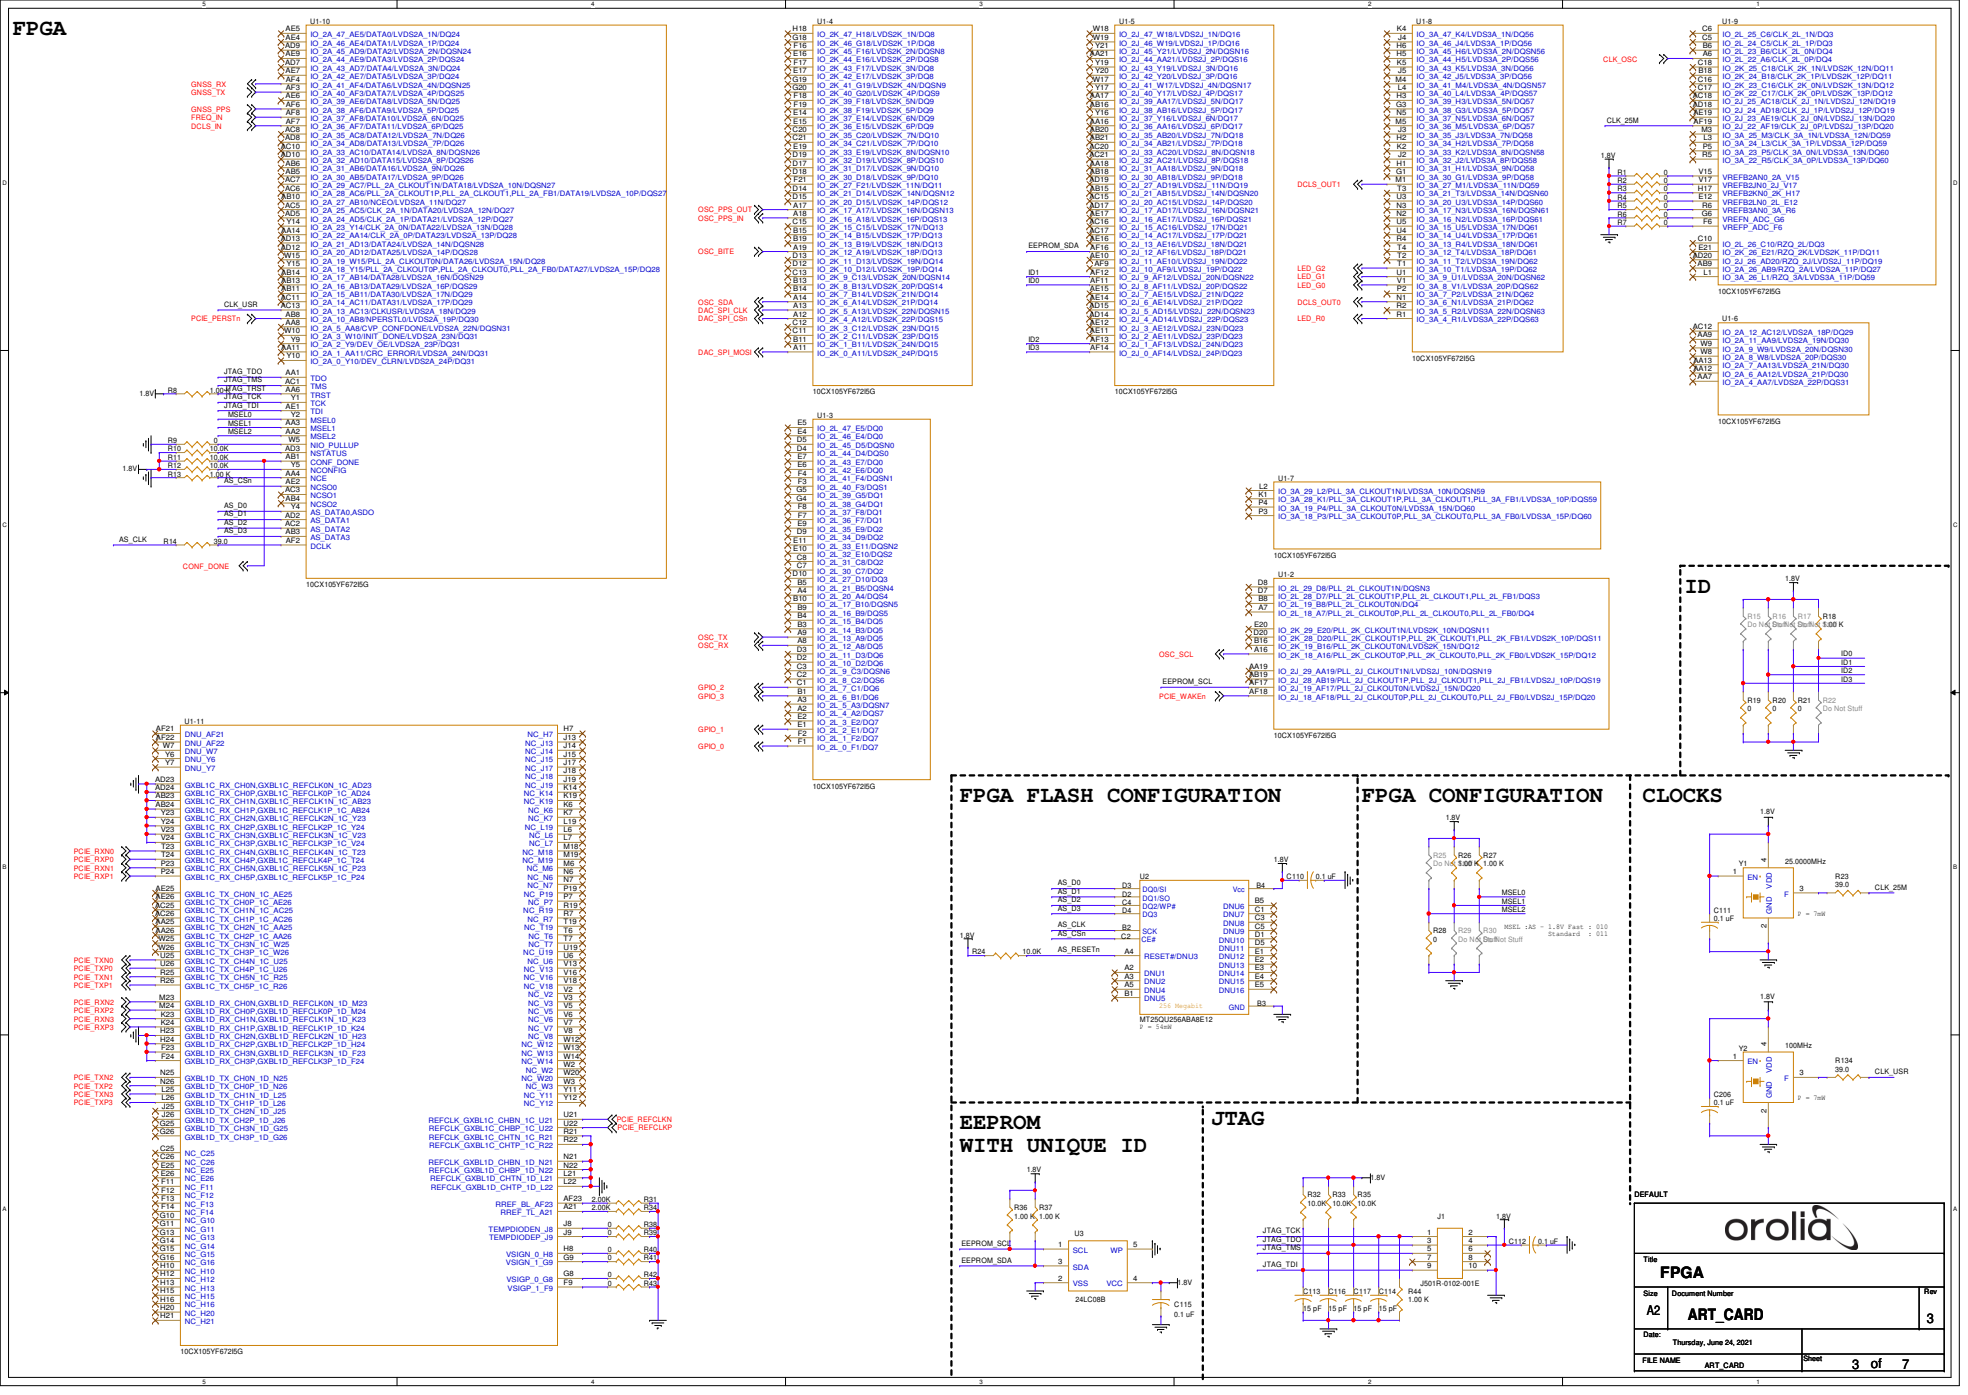
[picture p36: page 3]

## 10mV Ripple Voltage Max

## POWER NEED : FPGA : OCXO : Comp : TOTAL

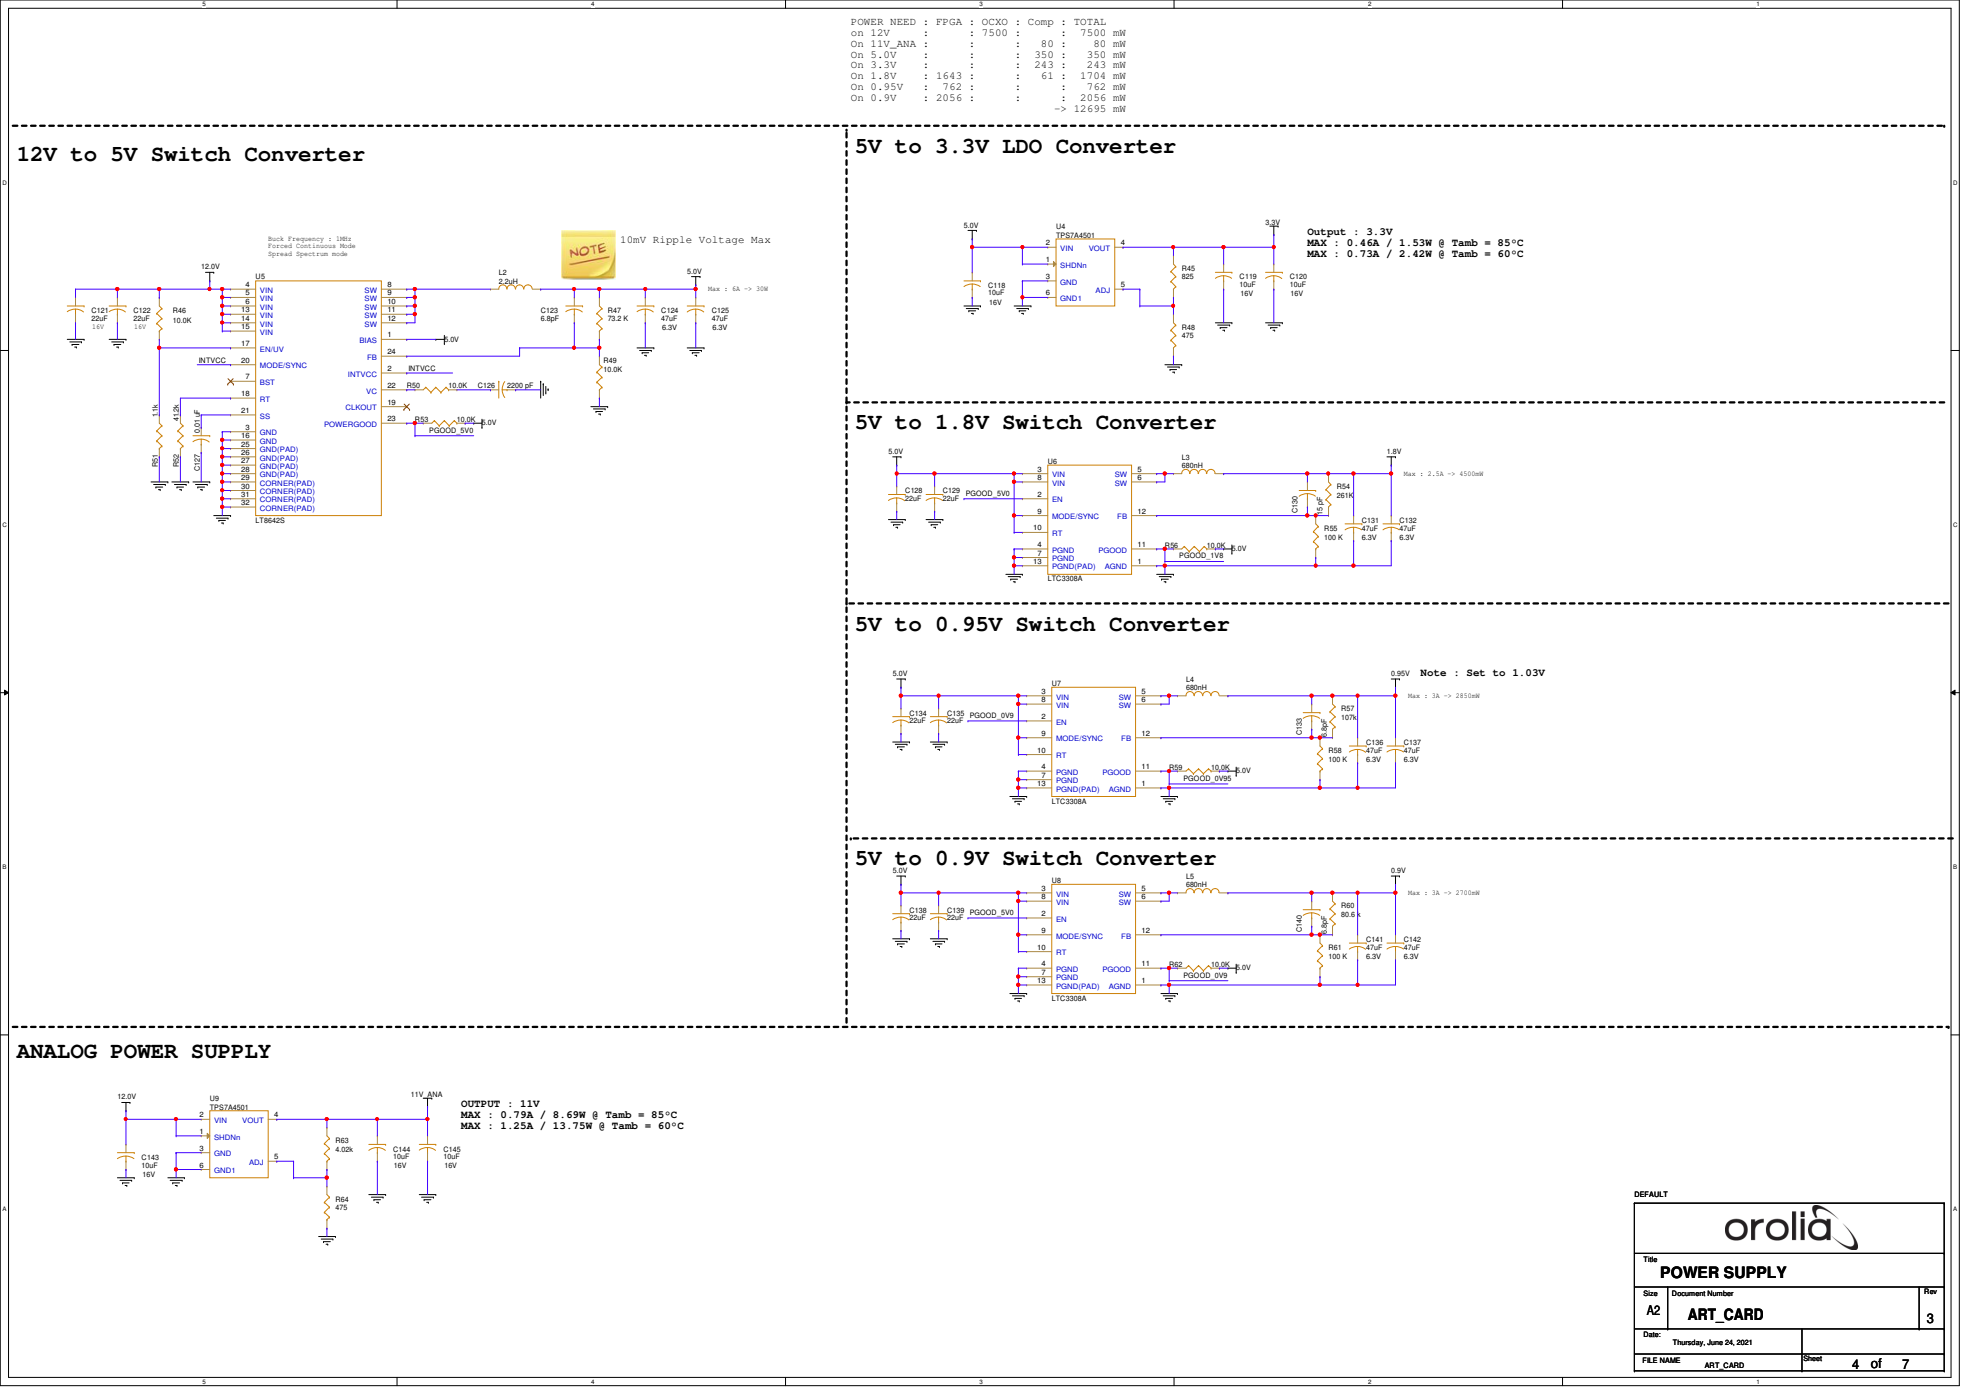
[picture p37: page 4]

# MiniRubidium

# OSCILLATOR POWER SUPPLY

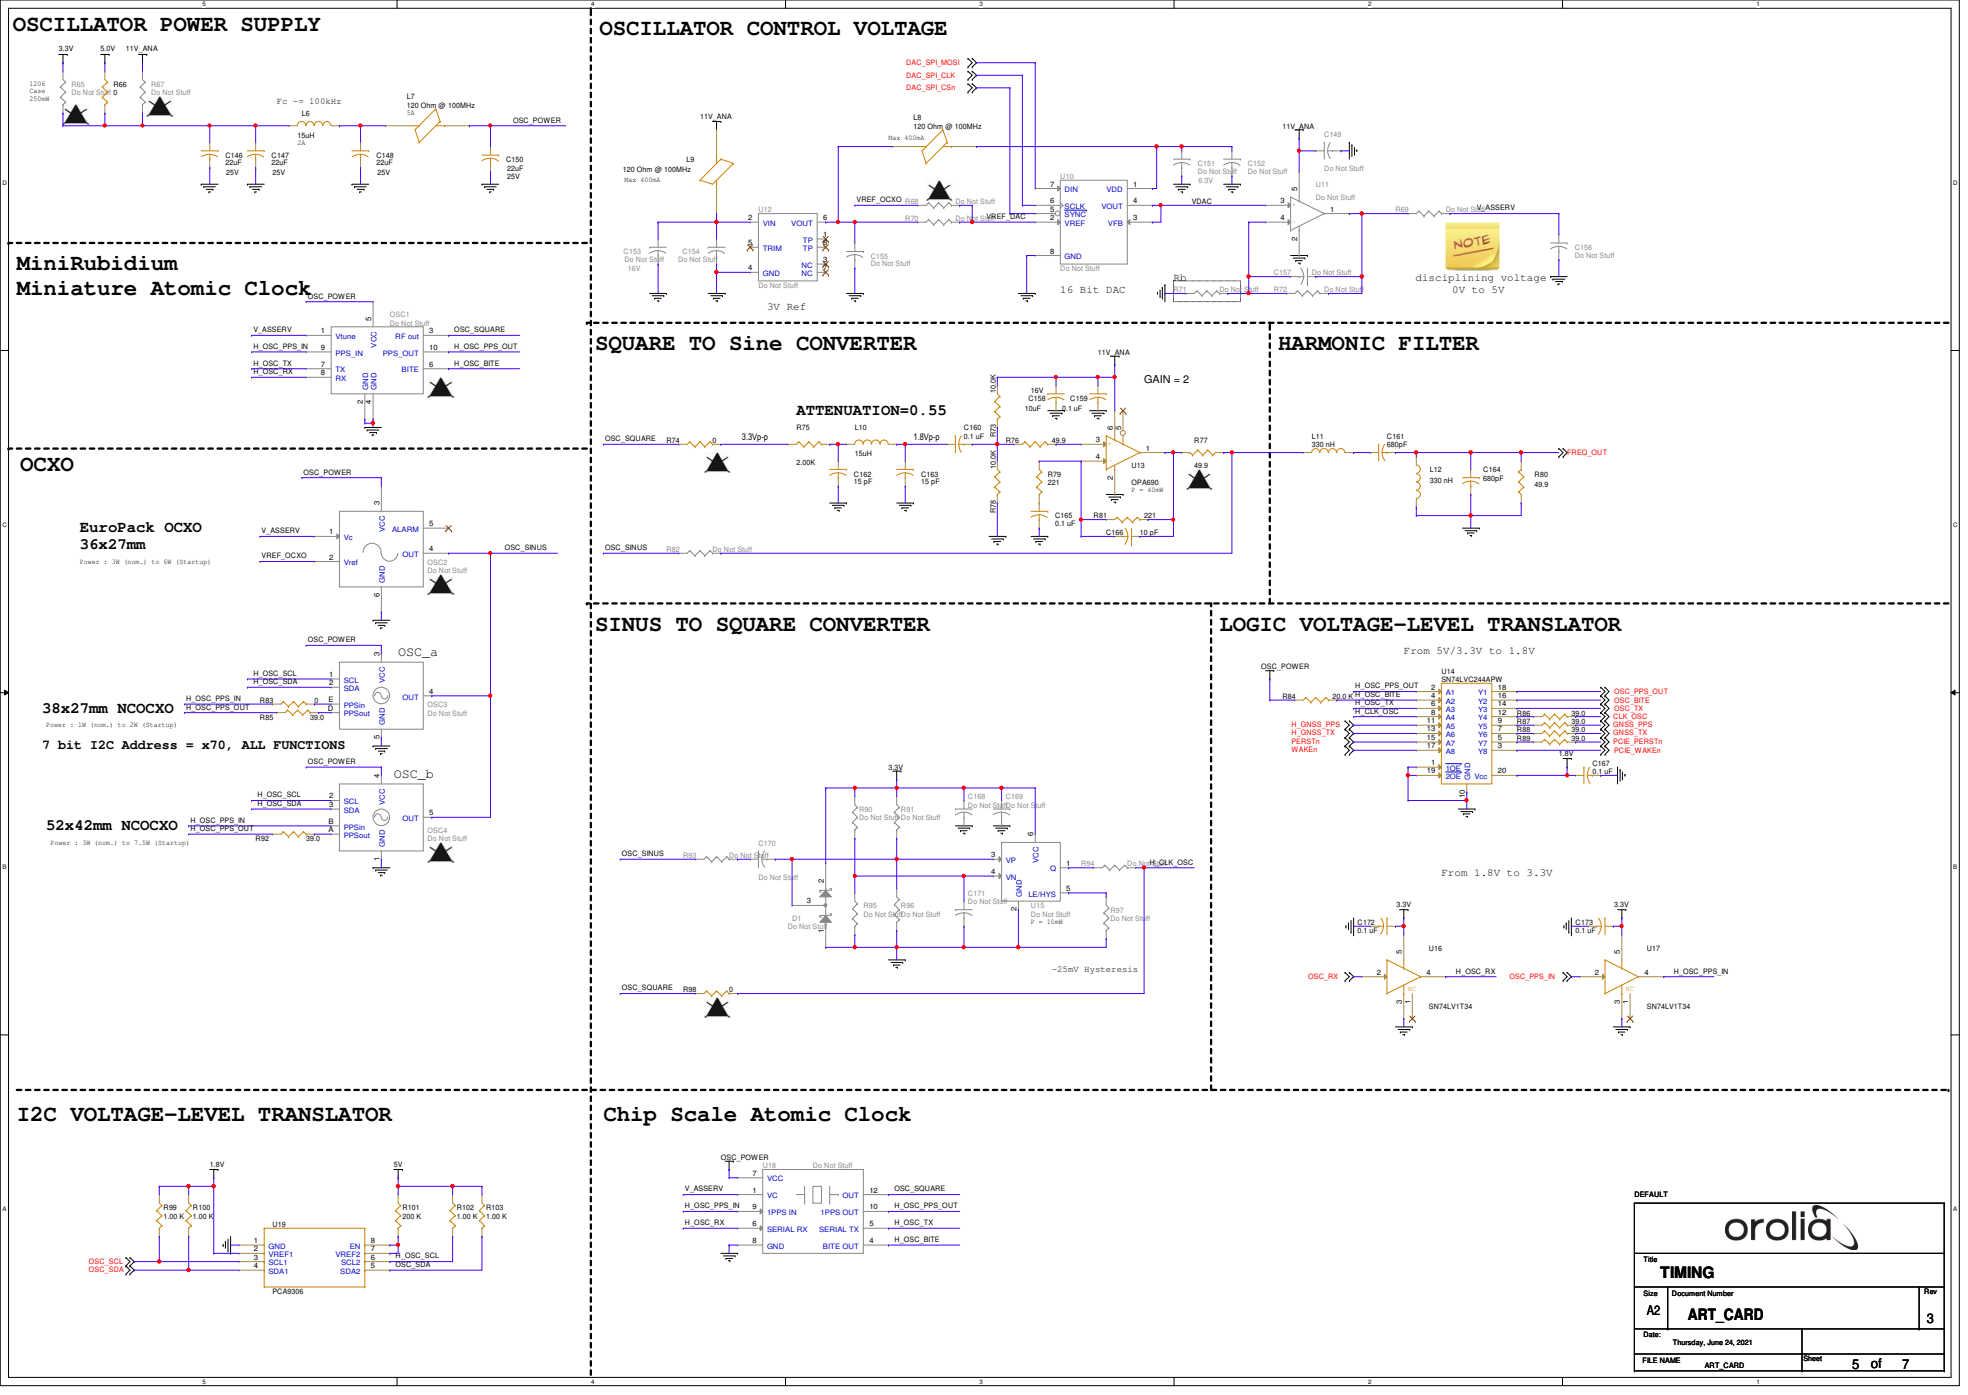
[picture p38: page 5]

SQUARE TO Sine CONVERTER

Power : 3W (nom.) to 6W (Startup)

Power : 1W (nom.) to 2W (Startup)
7 bit I2C Address = x70, ALL FUNCTIONS

Power : 3W (nom.) to 7.5W (Startup)

Chip Scale Atomic Clock

ANTENNA POWER SUPPLY | GNSS RECEIVER | GNSS STANDOFF

## From 1.8V to 3.3V

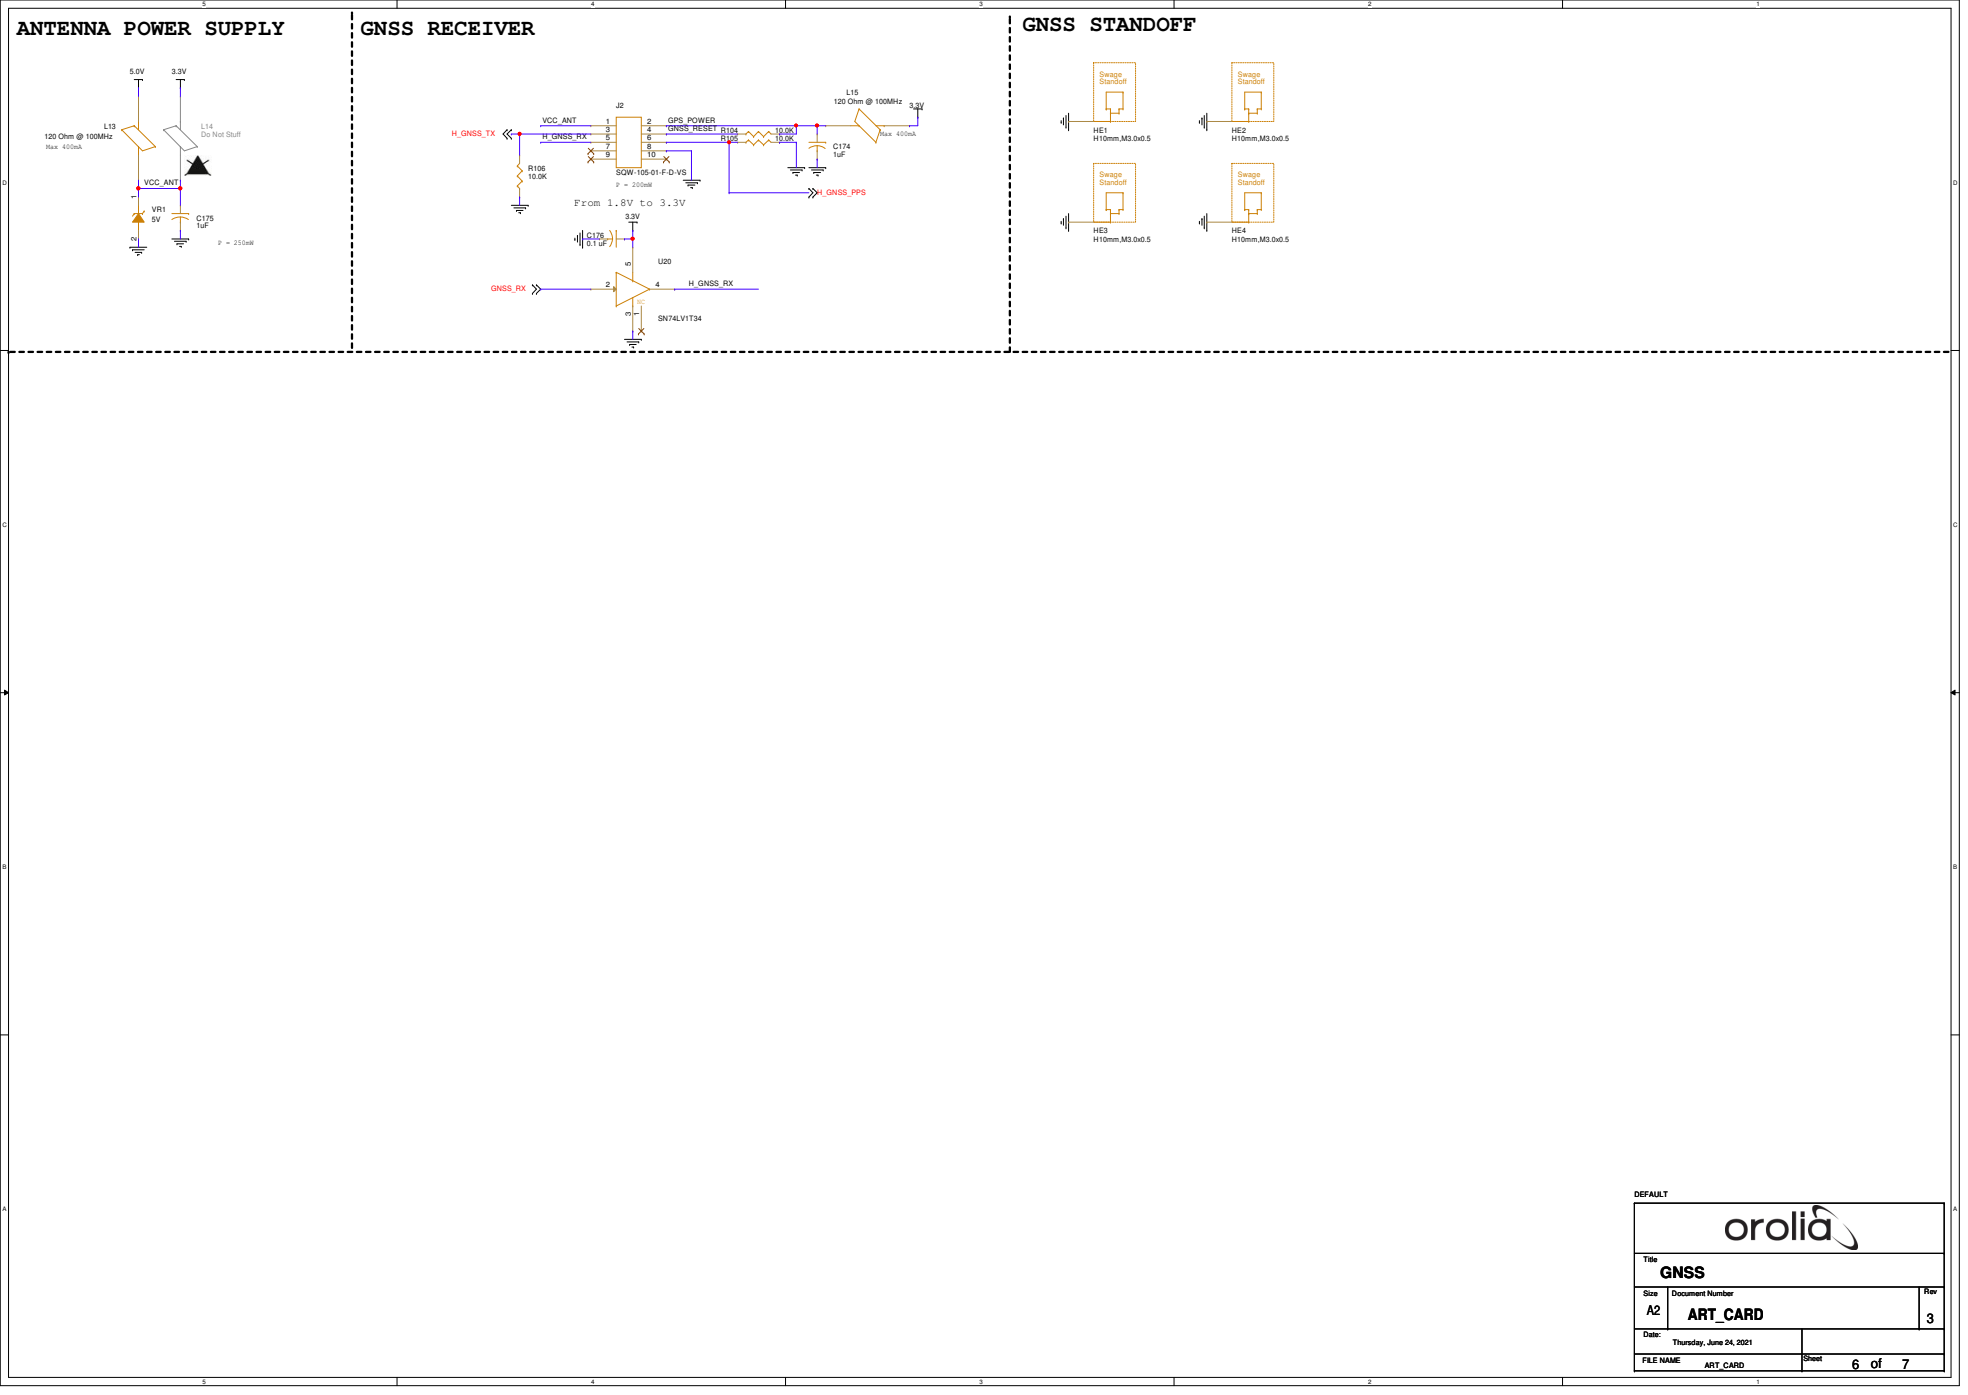
[picture p39: page 6]

# 10MHZ OSC Buffer Driver

## Ra is 124 ohms GAIN = 2.8

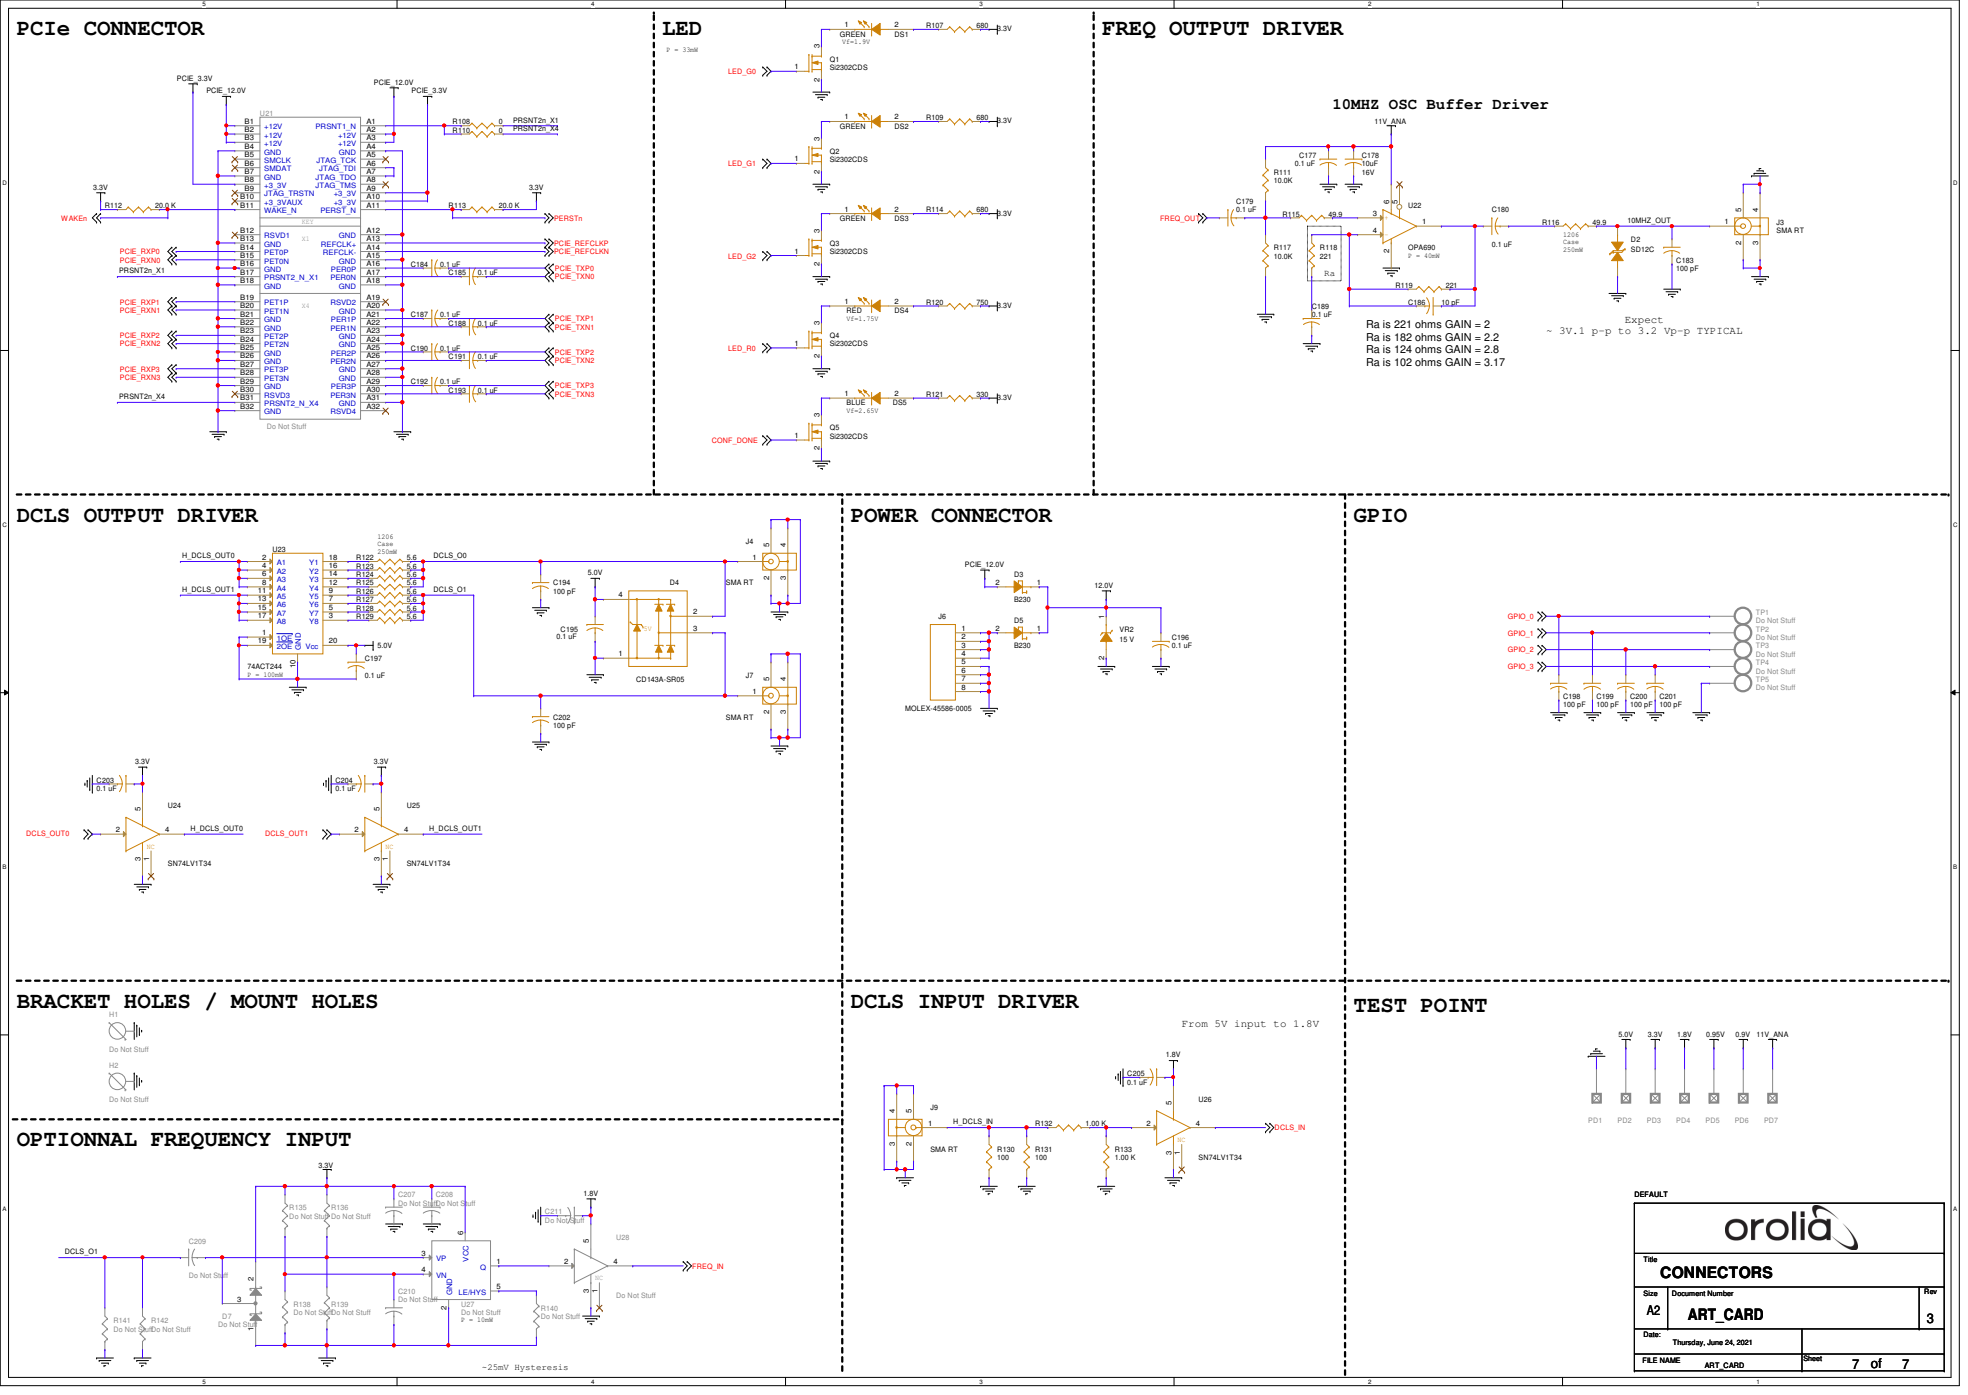
[picture p40: page 7]

Ra is 221 ohms GAIN = 2
Ra is 182 ohms GAIN = 2.2

Ra is 102 ohms GAIN = 3.17
