Orolia2s/art-card-board/Schematic/ART_CARD_Rev1.pdf

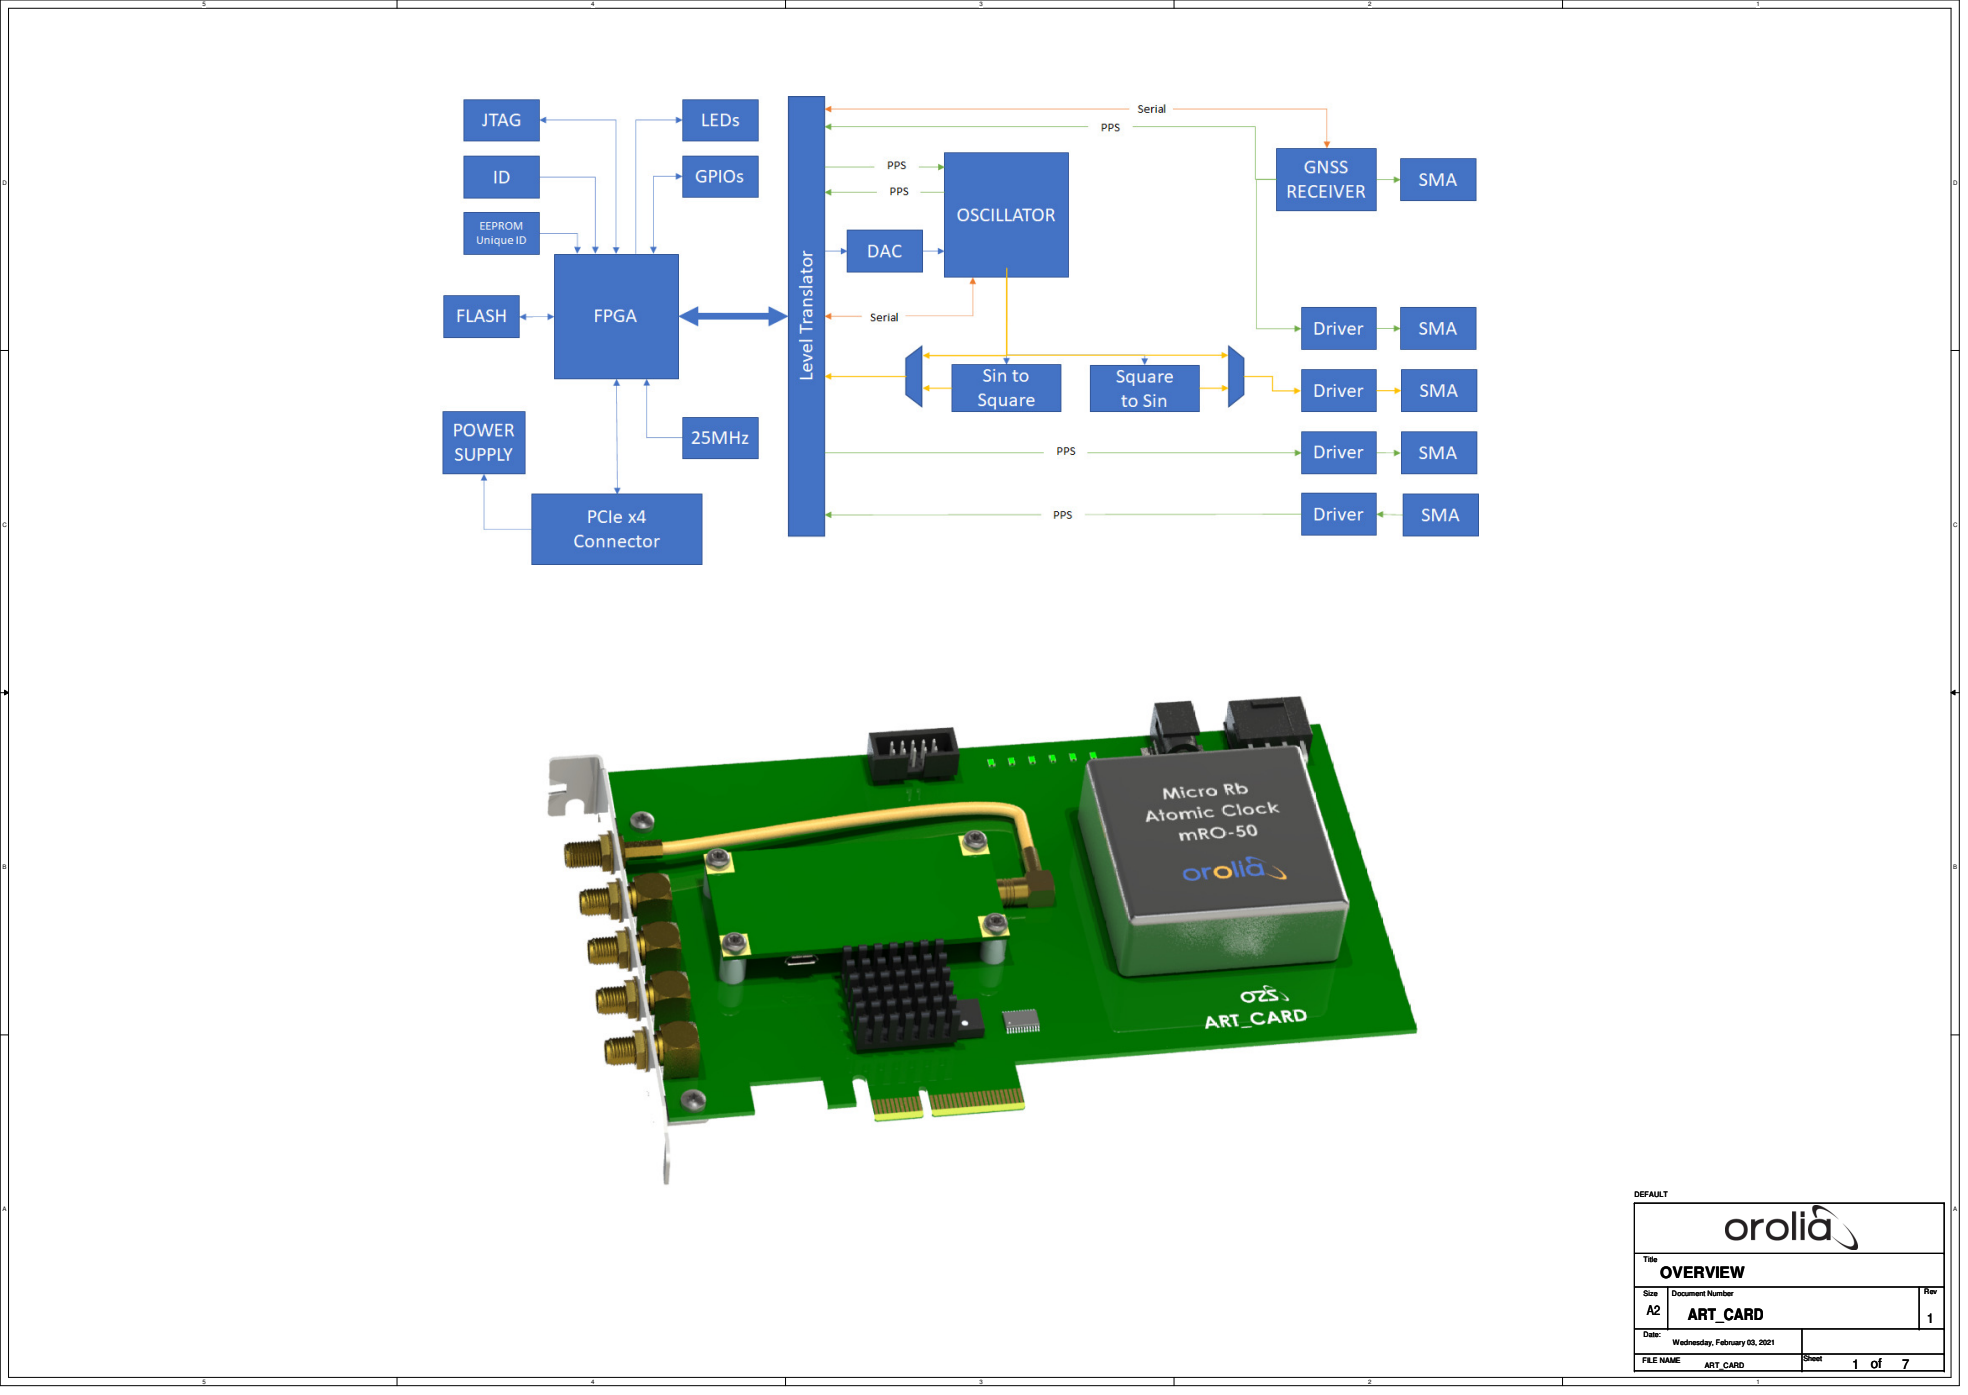
[picture p48: page 1]
Title; OVERVIEW; DEFAULT

Size | Document Number ART_CARD | Rev 1 A2

Date: Wednesday, February 03, 2021

FILE NAME ART_CARD ART_CARD ART_CARD | Sheet of 1 1 1 7 7 7

# VCC Decoupling

# FPGA POWER SUPPLY

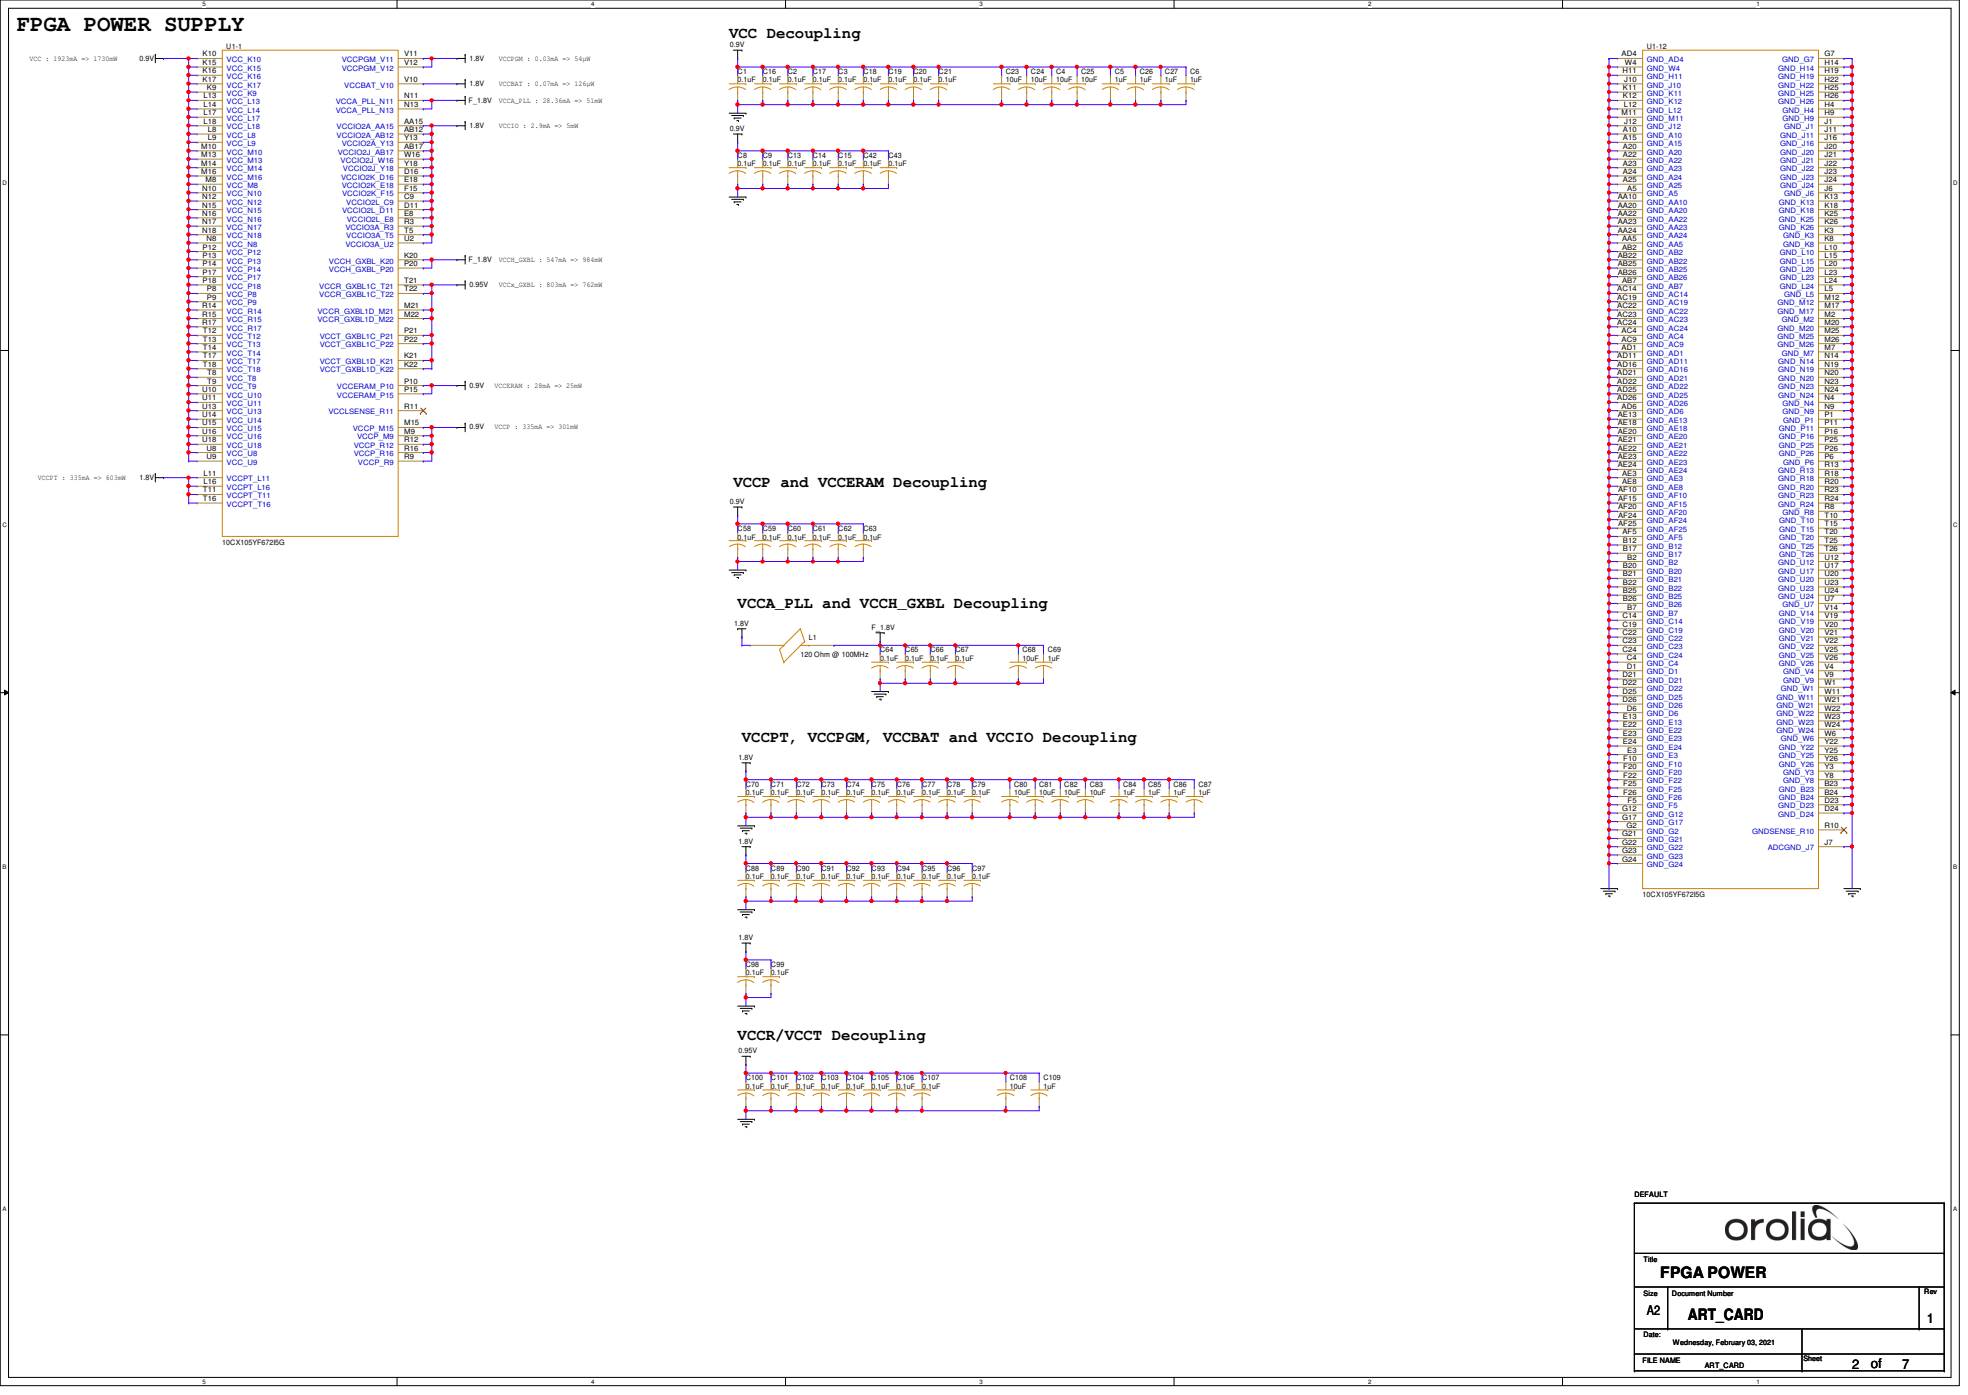
[picture p49: page 2]

VCCP and VCCERAM Decoupling

VCCPT, VCCPGM, VCCBAT and VCCIO Decoupling

# FPGA

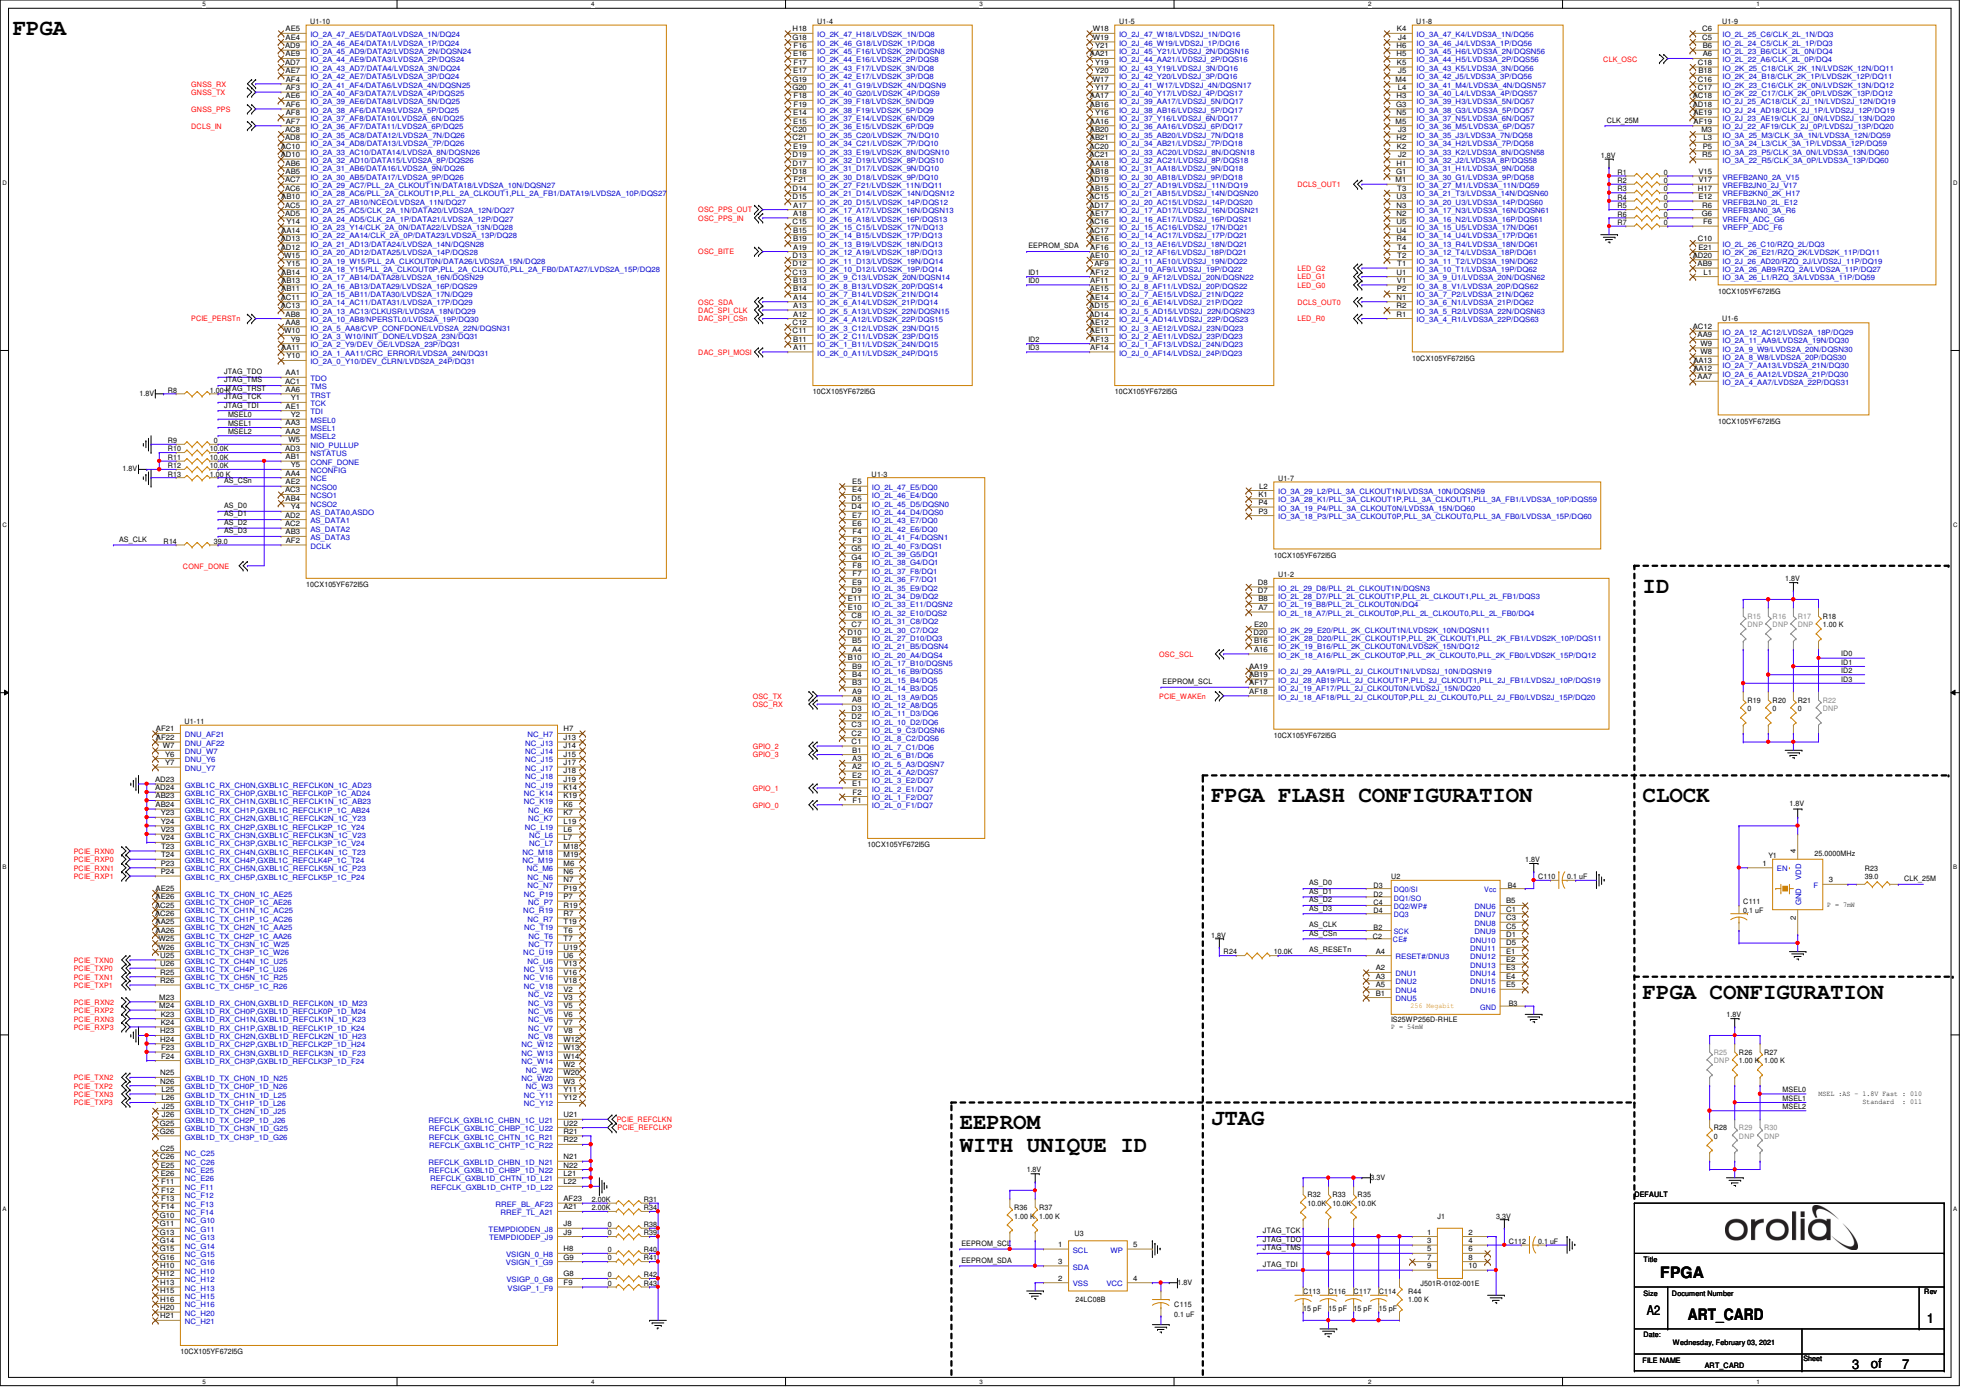
[picture p50: page 3]

## 10mV Ripple Voltage Max

## POWER NEED : FPGA : OCXO : Comp : TOTAL

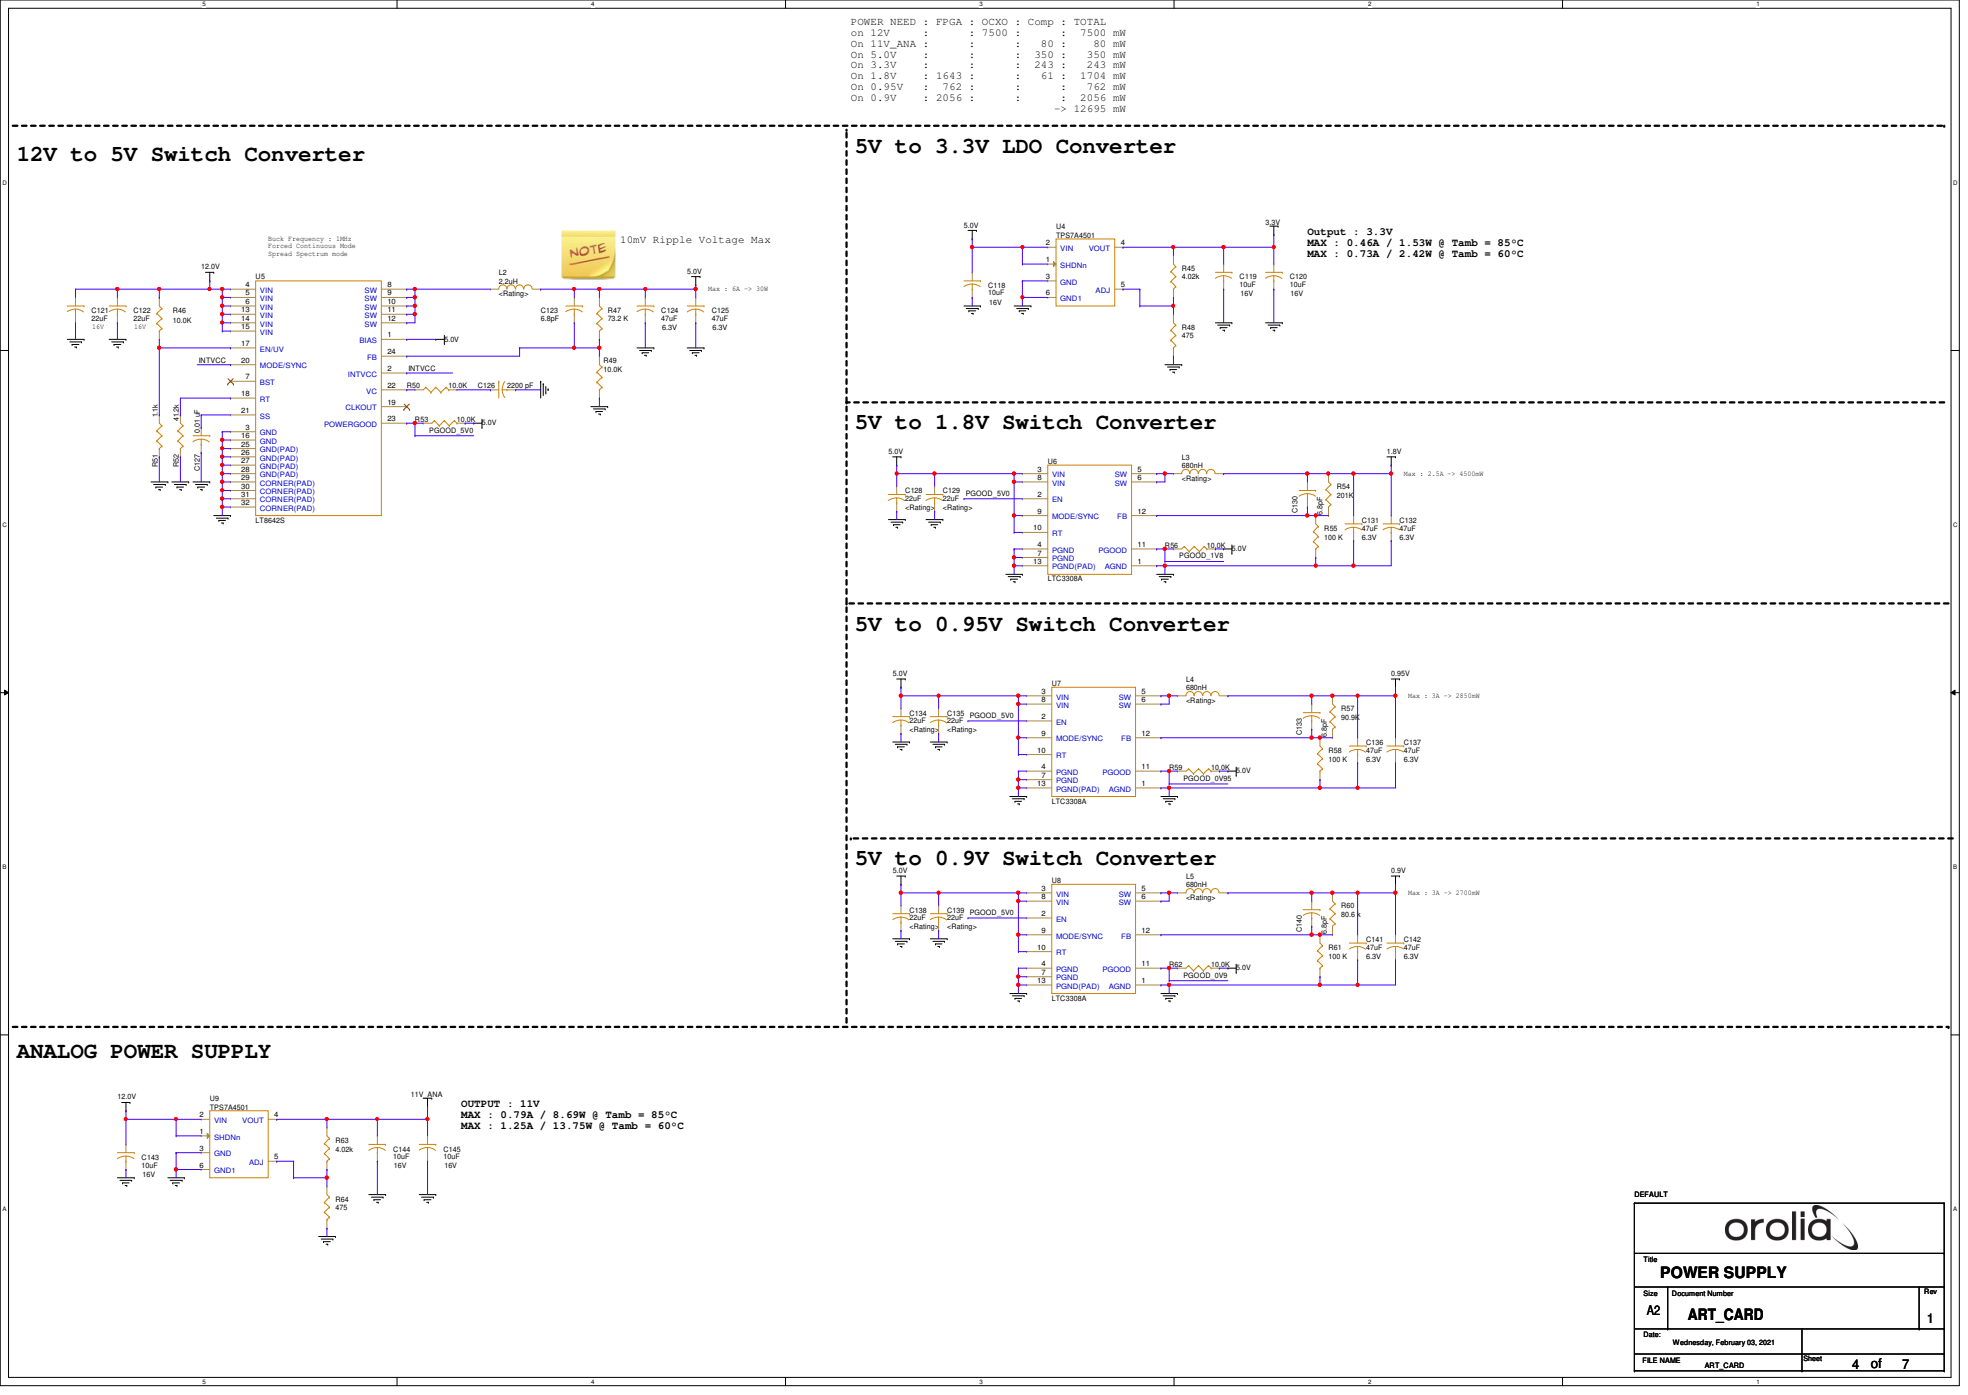
[picture p51: page 4]

# MiniRubidium

# OSCILLATOR POWER SUPPLY

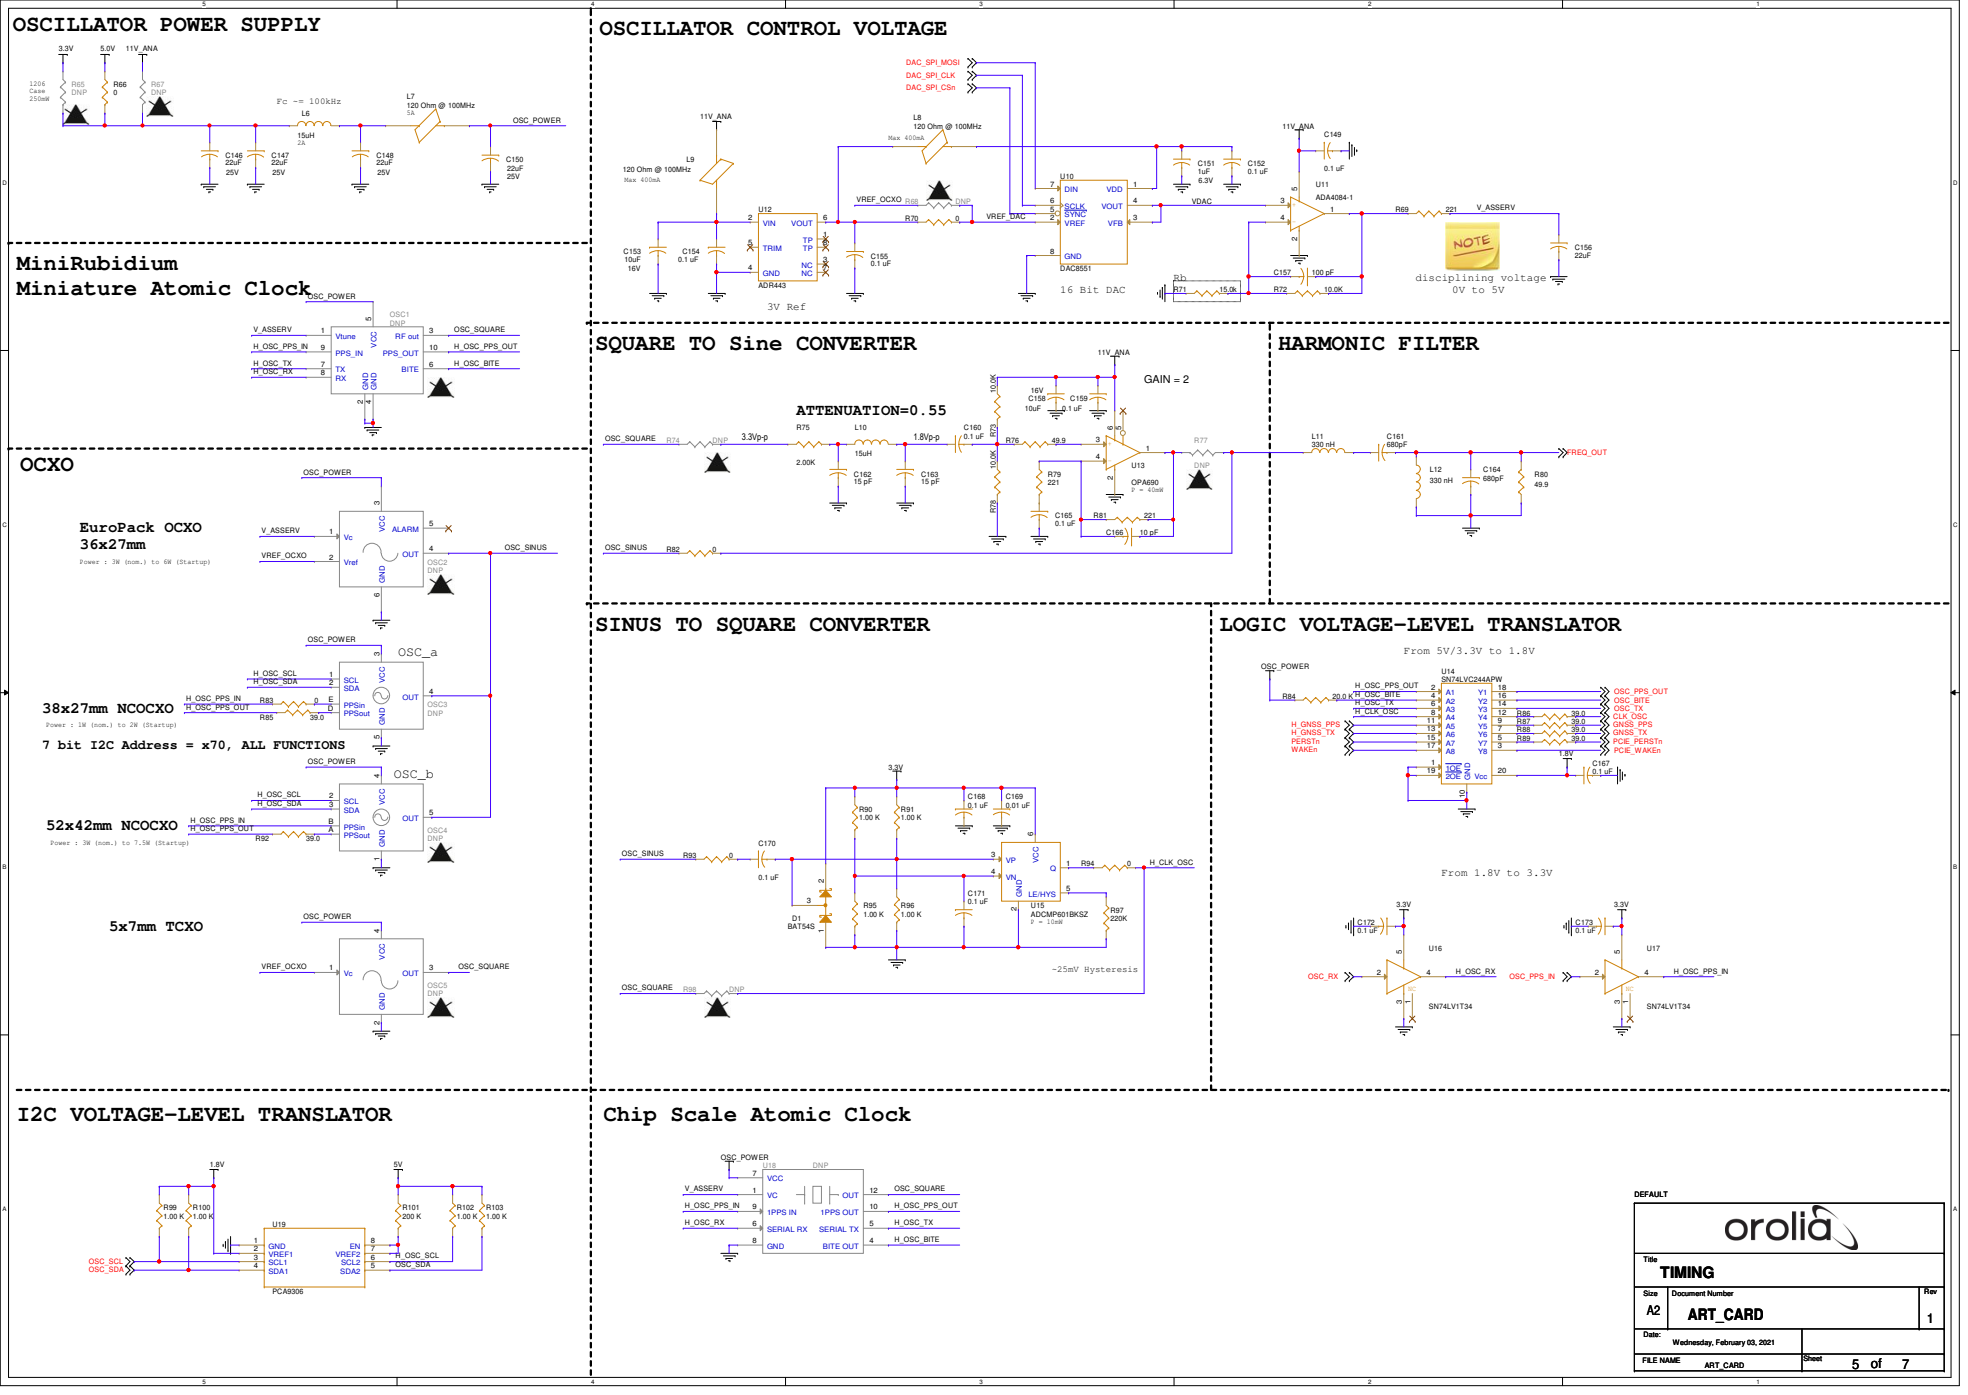
[picture p52: page 5]

SQUARE TO Sine CONVERTER

Power : 3W (nom.) to 6W (Startup)

Power : 1W (nom.) to 2W (Startup)
7 bit I2C Address = x70, ALL FUNCTIONS

Power : 3W (nom.) to 7.5W (Startup)

Chip Scale Atomic Clock

ANTENNA POWER SUPPLY | GNSS RECEIVER | GNSS STANDOFF

## From 1.8V to 3.3V

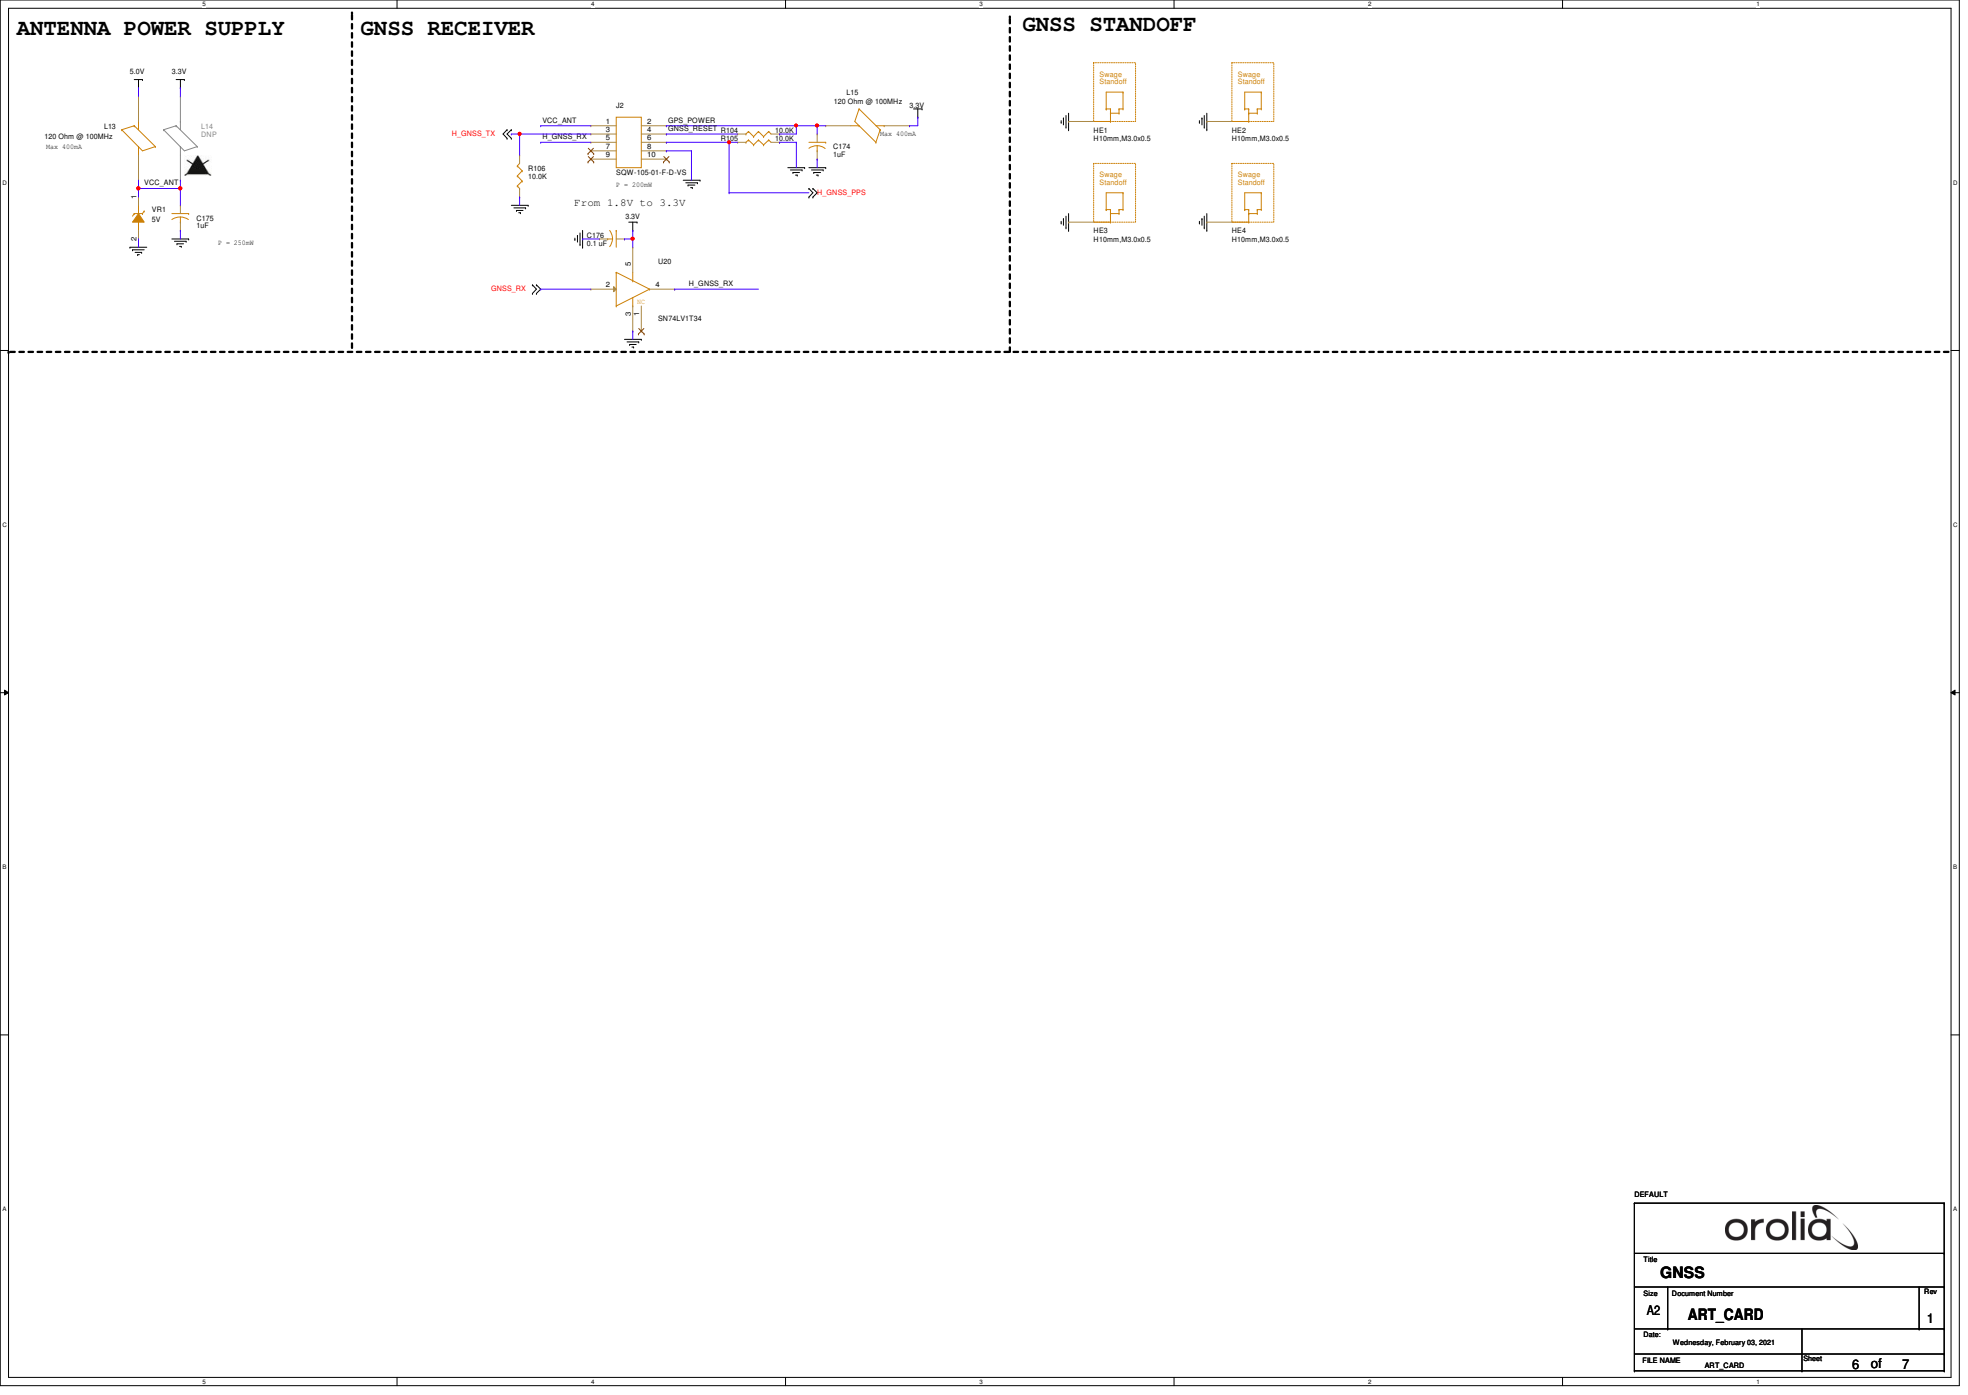
[picture p53: page 6]

# 10MHZ OSC Buffer Driver

## Ra is 124 ohms GAIN = 2.8

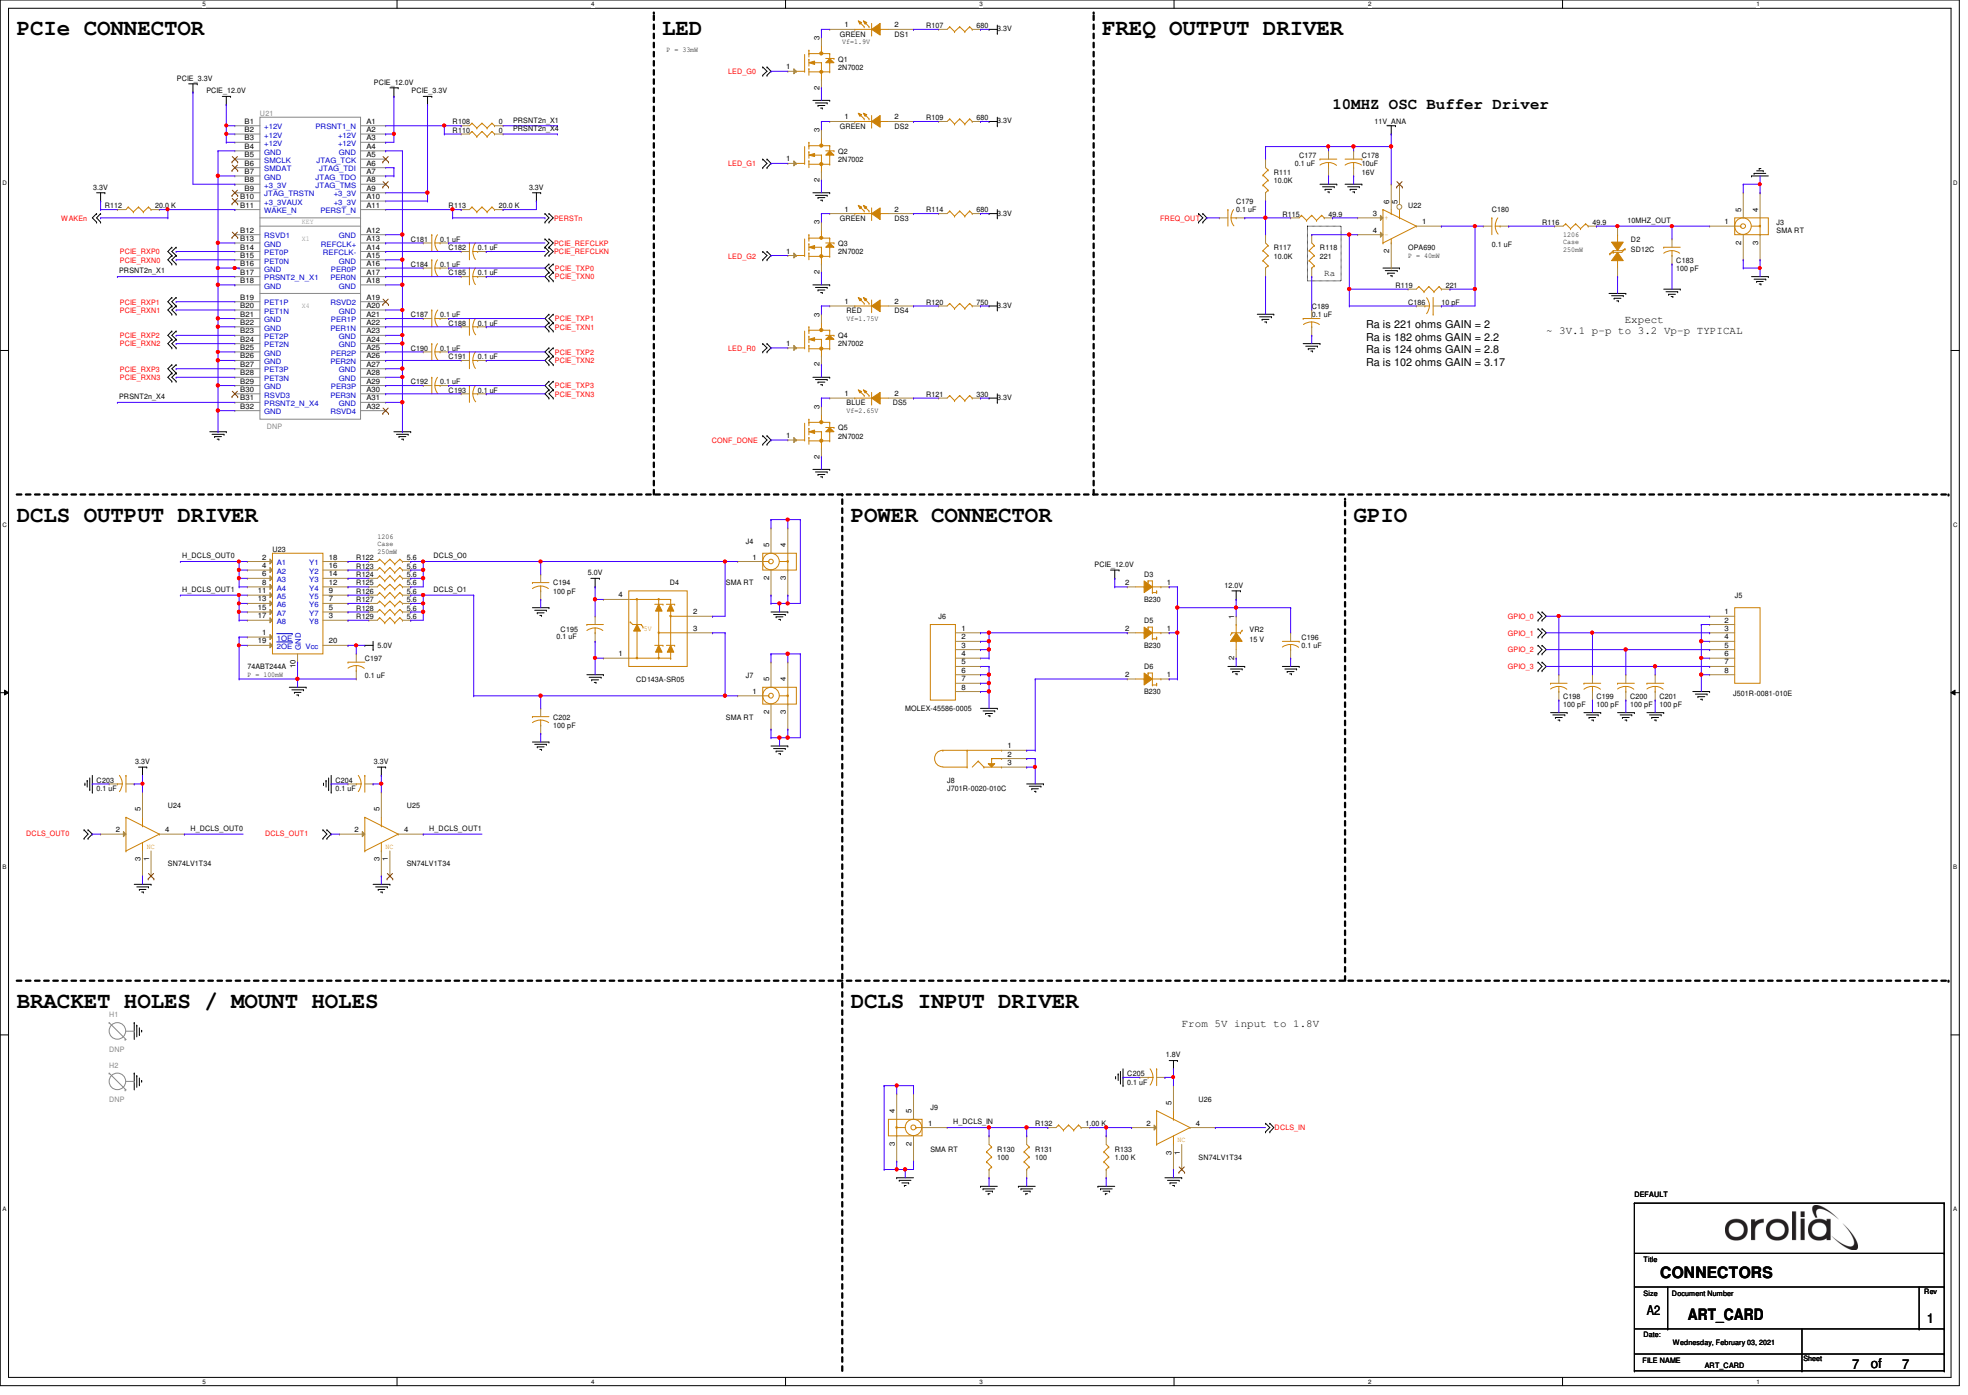
[picture p54: page 7]

Ra is 221 ohms GAIN = 2
Ra is 182 ohms GAIN = 2.2

Ra is 102 ohms GAIN = 3.17
