Orolia2s/art-card-board/ProductionFile/Rev3/ART_CARD Rev 3.pdf

# ART_CARD- Rev 3

- | 7 | SHEETS OF ELECTRICAL SCHEMATICS
- | 1 | ASSEMBLY DRAWING TOP
- | 1 | ASSEMBLY DRAWING BOTTOM
- | 1 | SILKSCREEN TOP
- | 1 | SOLDER MASK TOP
- | 1 | COPPER LAYER TOP
- | 1 | COPPER LAYER INNER 1
- | 1 | COPPER LAYER INNER 2
- | 1 | COPPER LAYER INNER 3
- | 1 | COPPER LAYER INNER 4
- | 1 | COPPER LAYER BOTTOM
- | 1 | SOLDER MASK BOTOM
- | 1 | SILKSCREEN BOTTOM
- | 1 | DRILL DRAWING
- | 1 | STACK-UP
- | 1 | CIRCUIT BOARD SPECIFICATION

# FILE OROLIA ART_CARD

# Réf PCB :

Angers Technopole | 1 bis Avenue du Bois l’Abbé
49070 BEAUCOUZÉ | FRANCE
Tél. : +33(0)2-41-48-41-40 | Fax : +33(0)2-41-48-41-44
contact@artemis-cad.com | www.artemis-cad.com

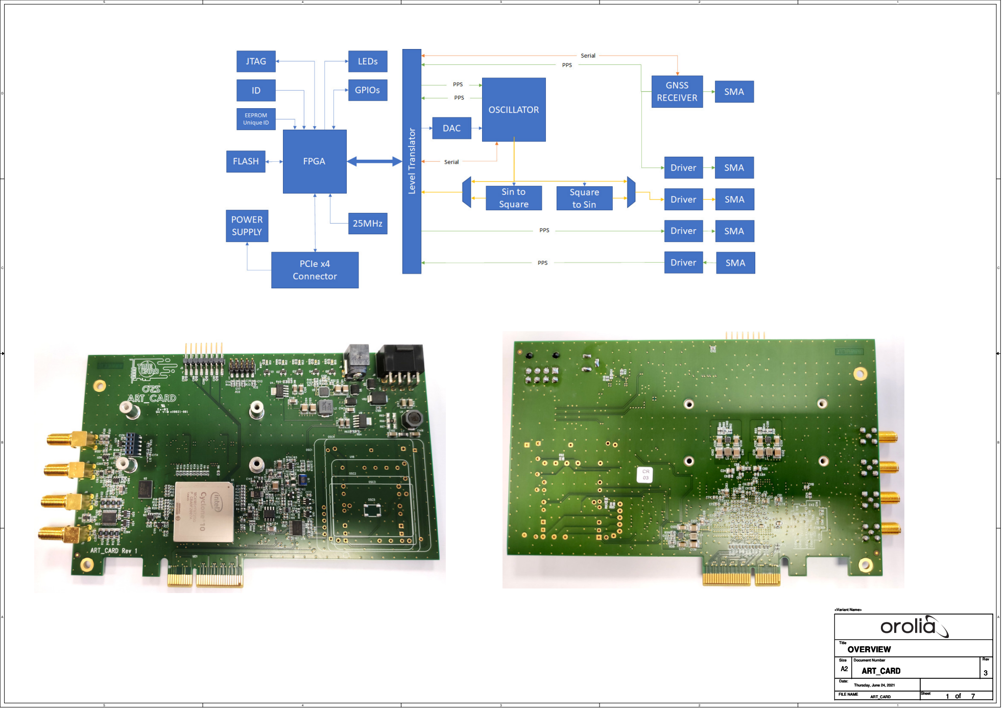
[picture p72: page 2]
Title; OVERVIEW; <Variant Name>

Size Size Size | Document Number Document Number Document Number ART_CARD ART_CARD ART_CARD | Rev Rev Rev 3 A2 3 A2 3 A2

Date: Date: Date: Thursday, June 24, 2021 Thursday, June 24, 2021 Thursday, June 24, 2021

FILE NAME FILE NAME FILE NAME ART_CARD ART_CARD ART_CARD | Sheet Sheet Sheet of of of 1 1 1 7 7 7

# VCC Decoupling

# FPGA POWER SUPPLY

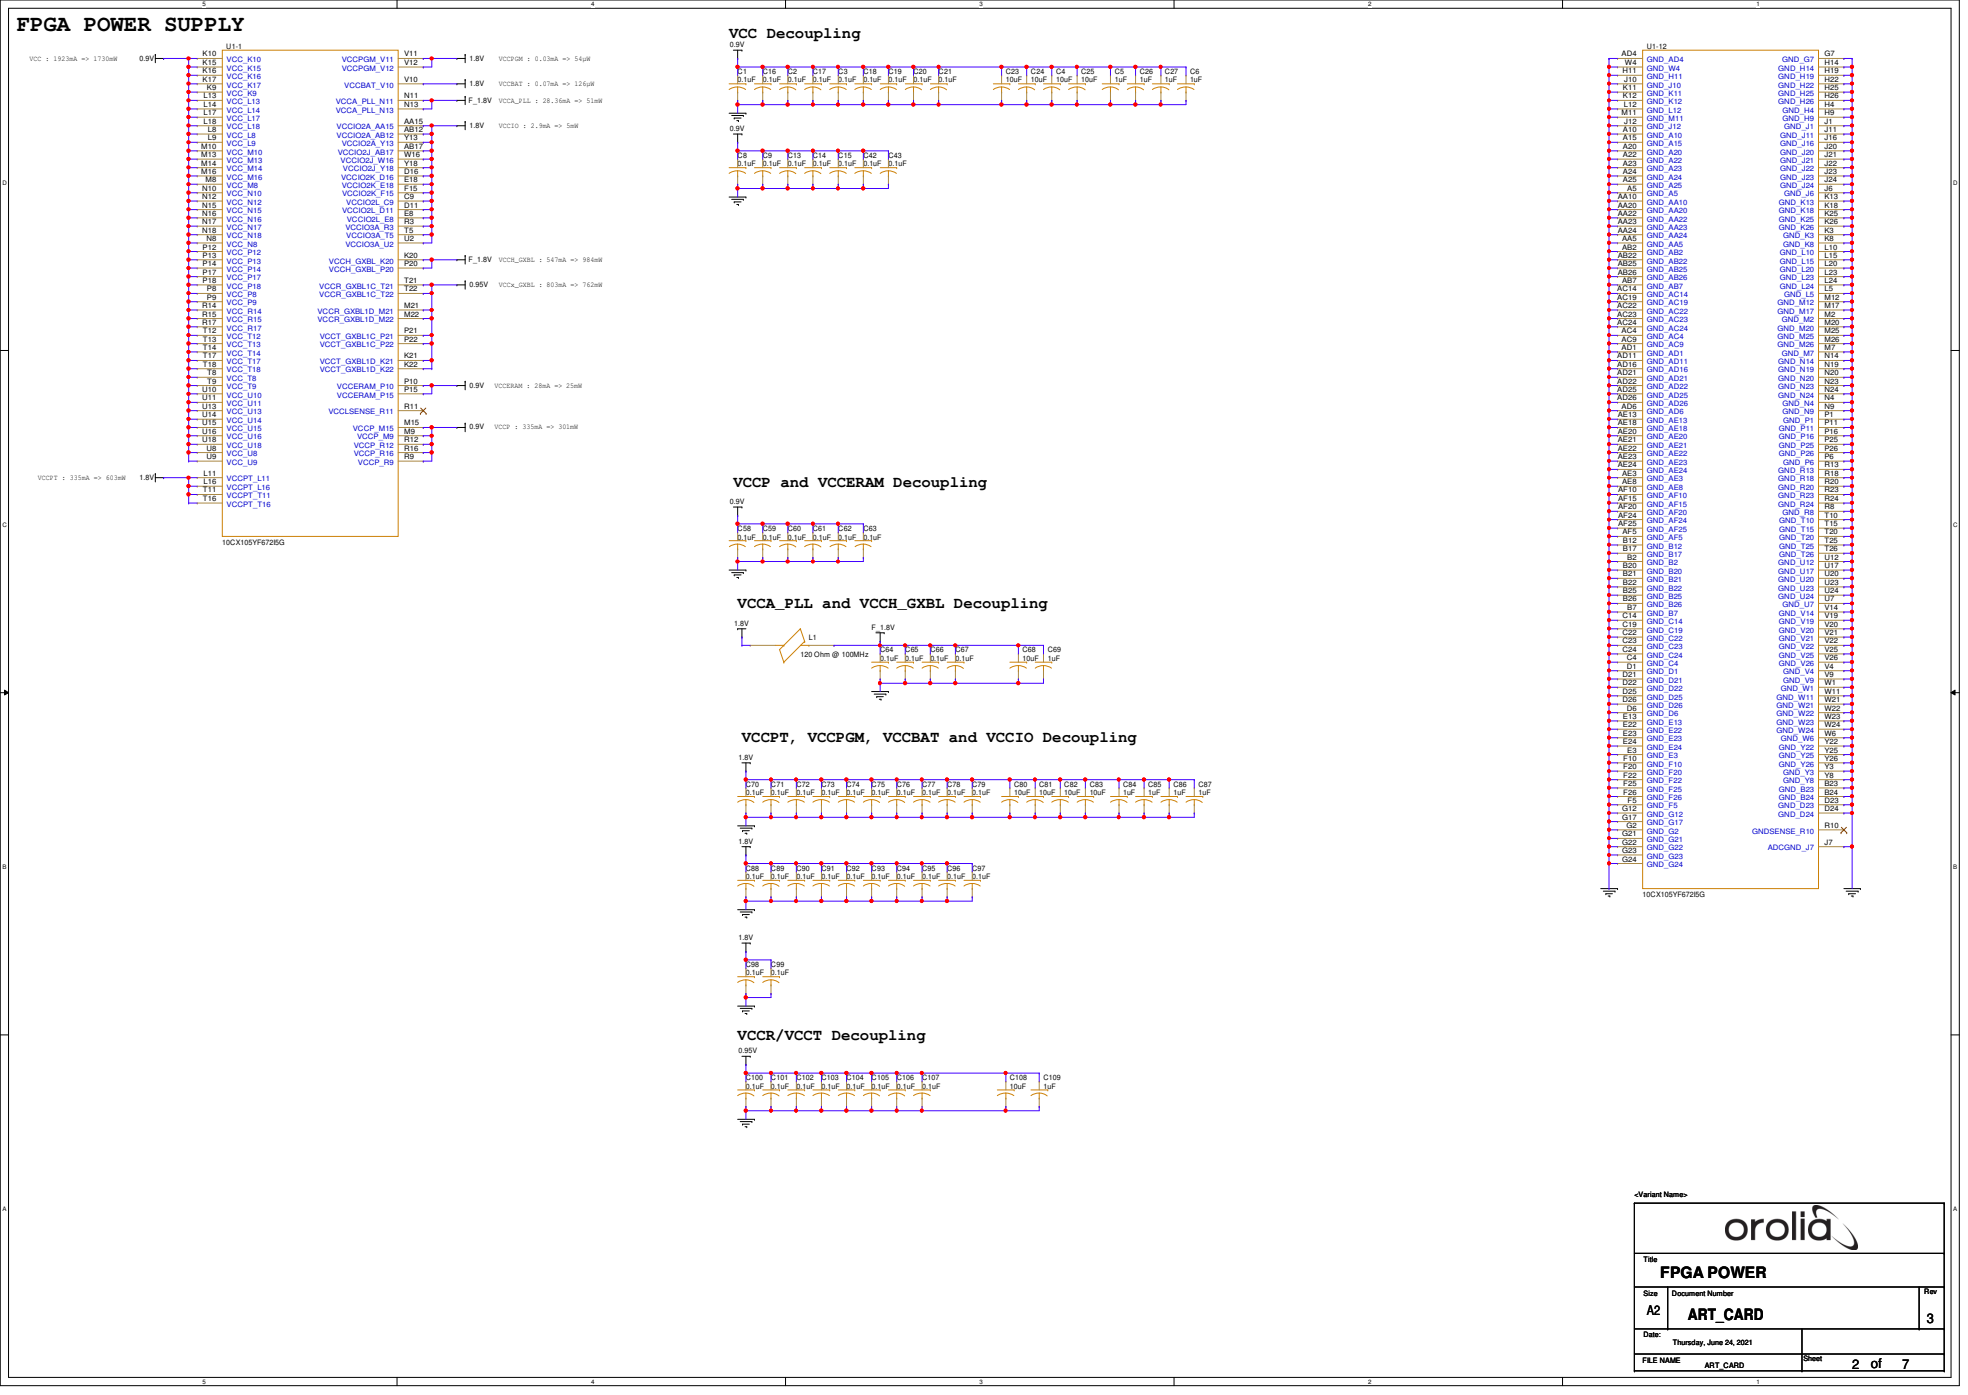
[picture p73: page 3]

VCCP and VCCERAM Decoupling

VCCPT, VCCPGM, VCCBAT and VCCIO Decoupling

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

Date: Date: Date: Thursday, June 24, 2021 Thursday, June 24, 2021 Thursday, June 24, 2021

FILE NAME FILE NAME FILE NAME ART_CARD ART_CARD ART_CARD | Sheet Sheet Sheet of of of 2 2 2 7 7 7

# FPGA

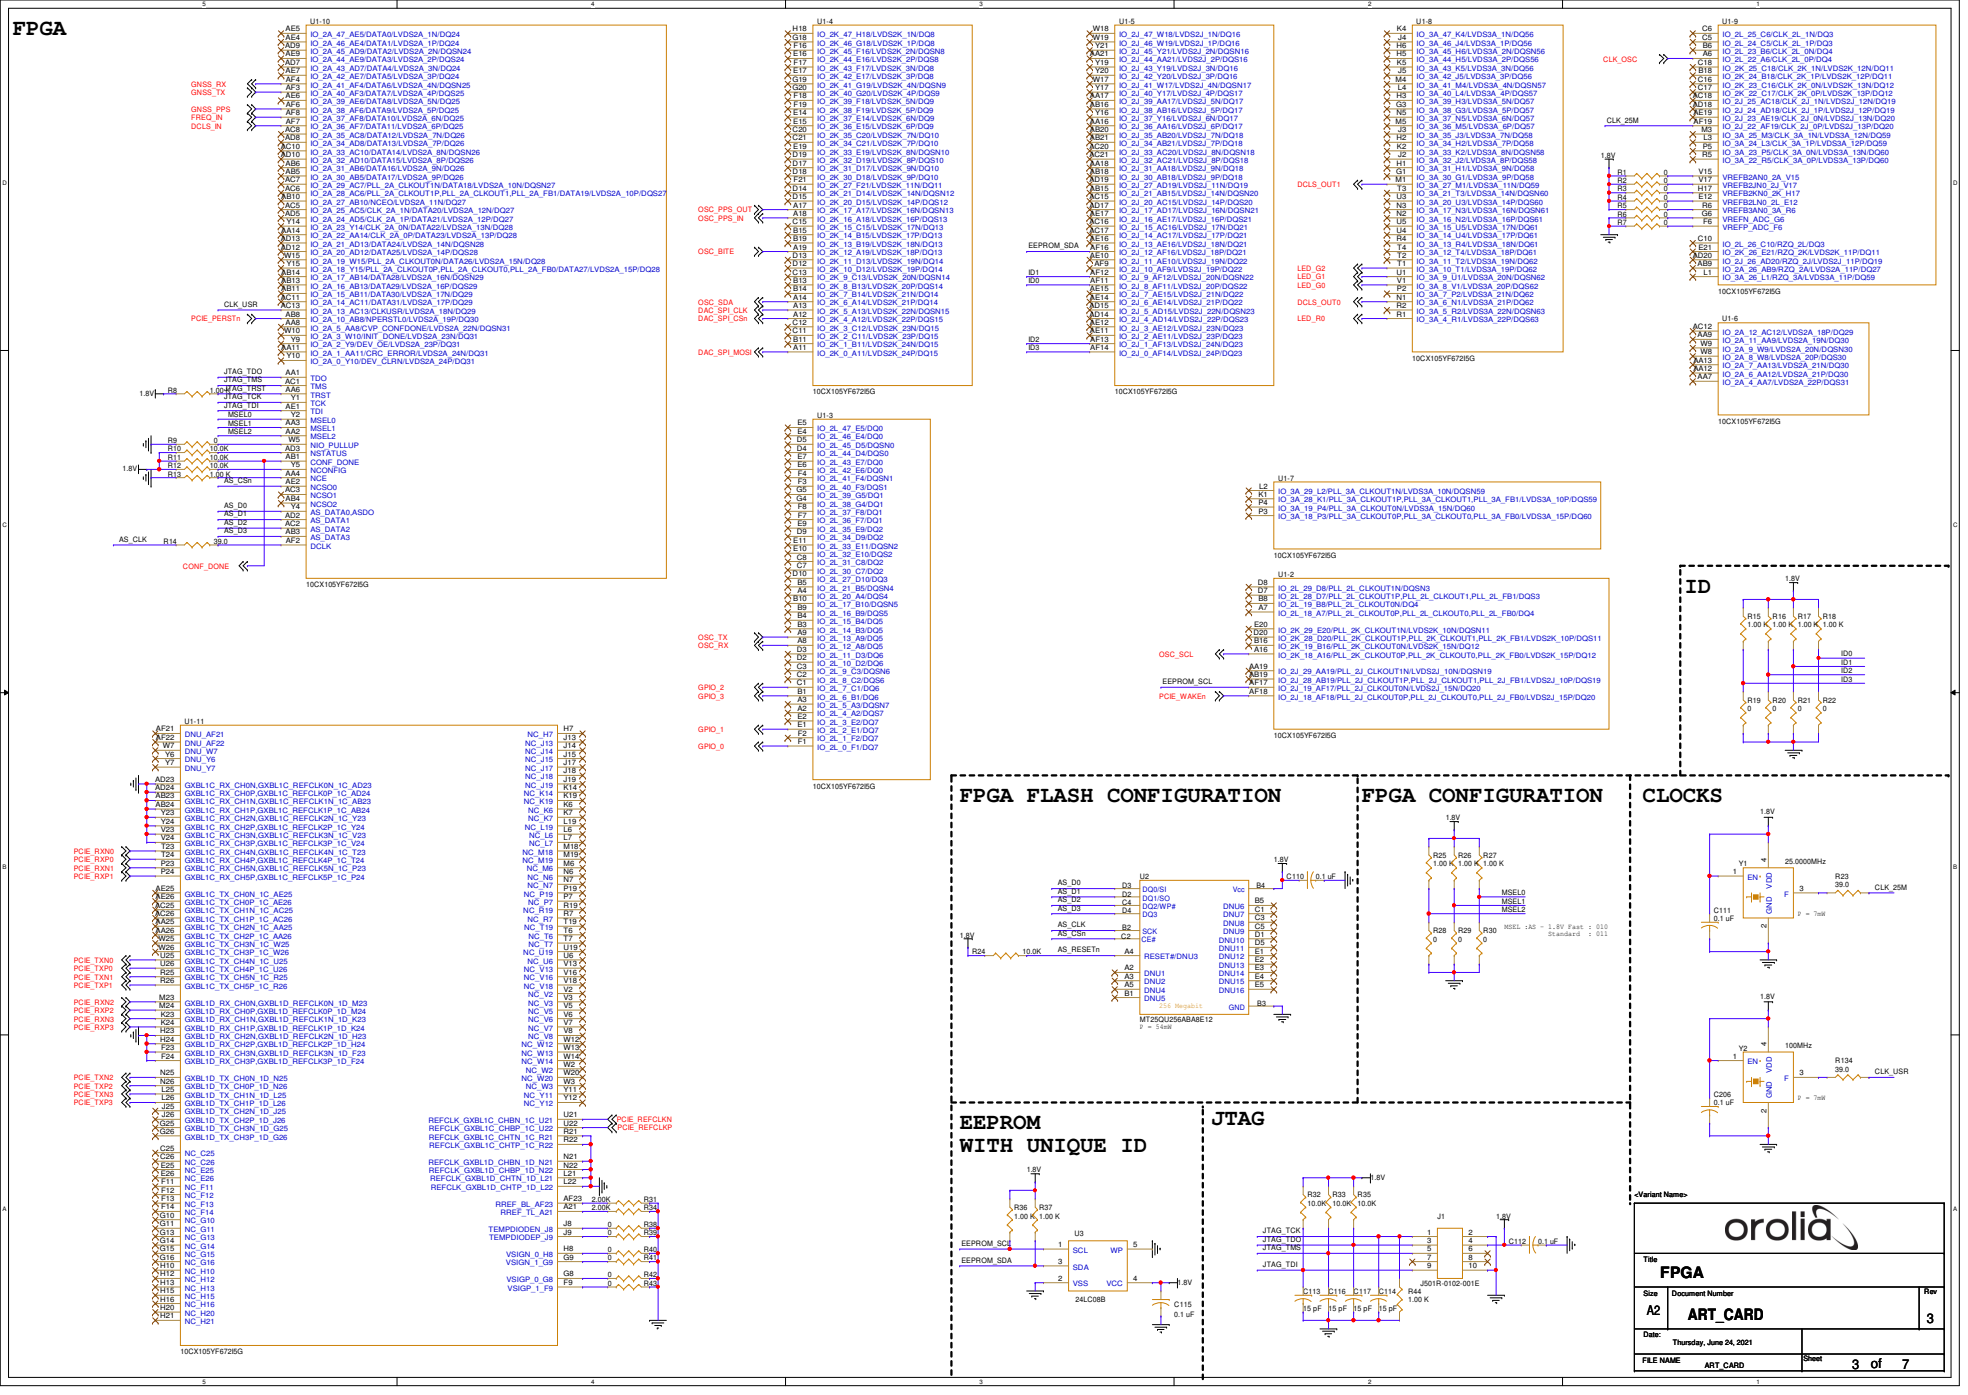
[picture p74: page 4]

EEPROM WITH UNIQUE ID 1.8V R36 R37 1.00 K 1.00 K U3 2 4 1.8V VSS VCC 24LC08B C115 0.1 uF

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

Date: Date: Date: Thursday, June 24, 2021 Thursday, June 24, 2021 Thursday, June 24, 2021

FILE NAME FILE NAME FILE NAME ART_CARD ART_CARD ART_CARD | Sheet Sheet Sheet of of of 3 3 3 7 7 7

## 10mV Ripple Voltage Max

## POWER NEED : FPGA : OCXO : Comp : TOTAL

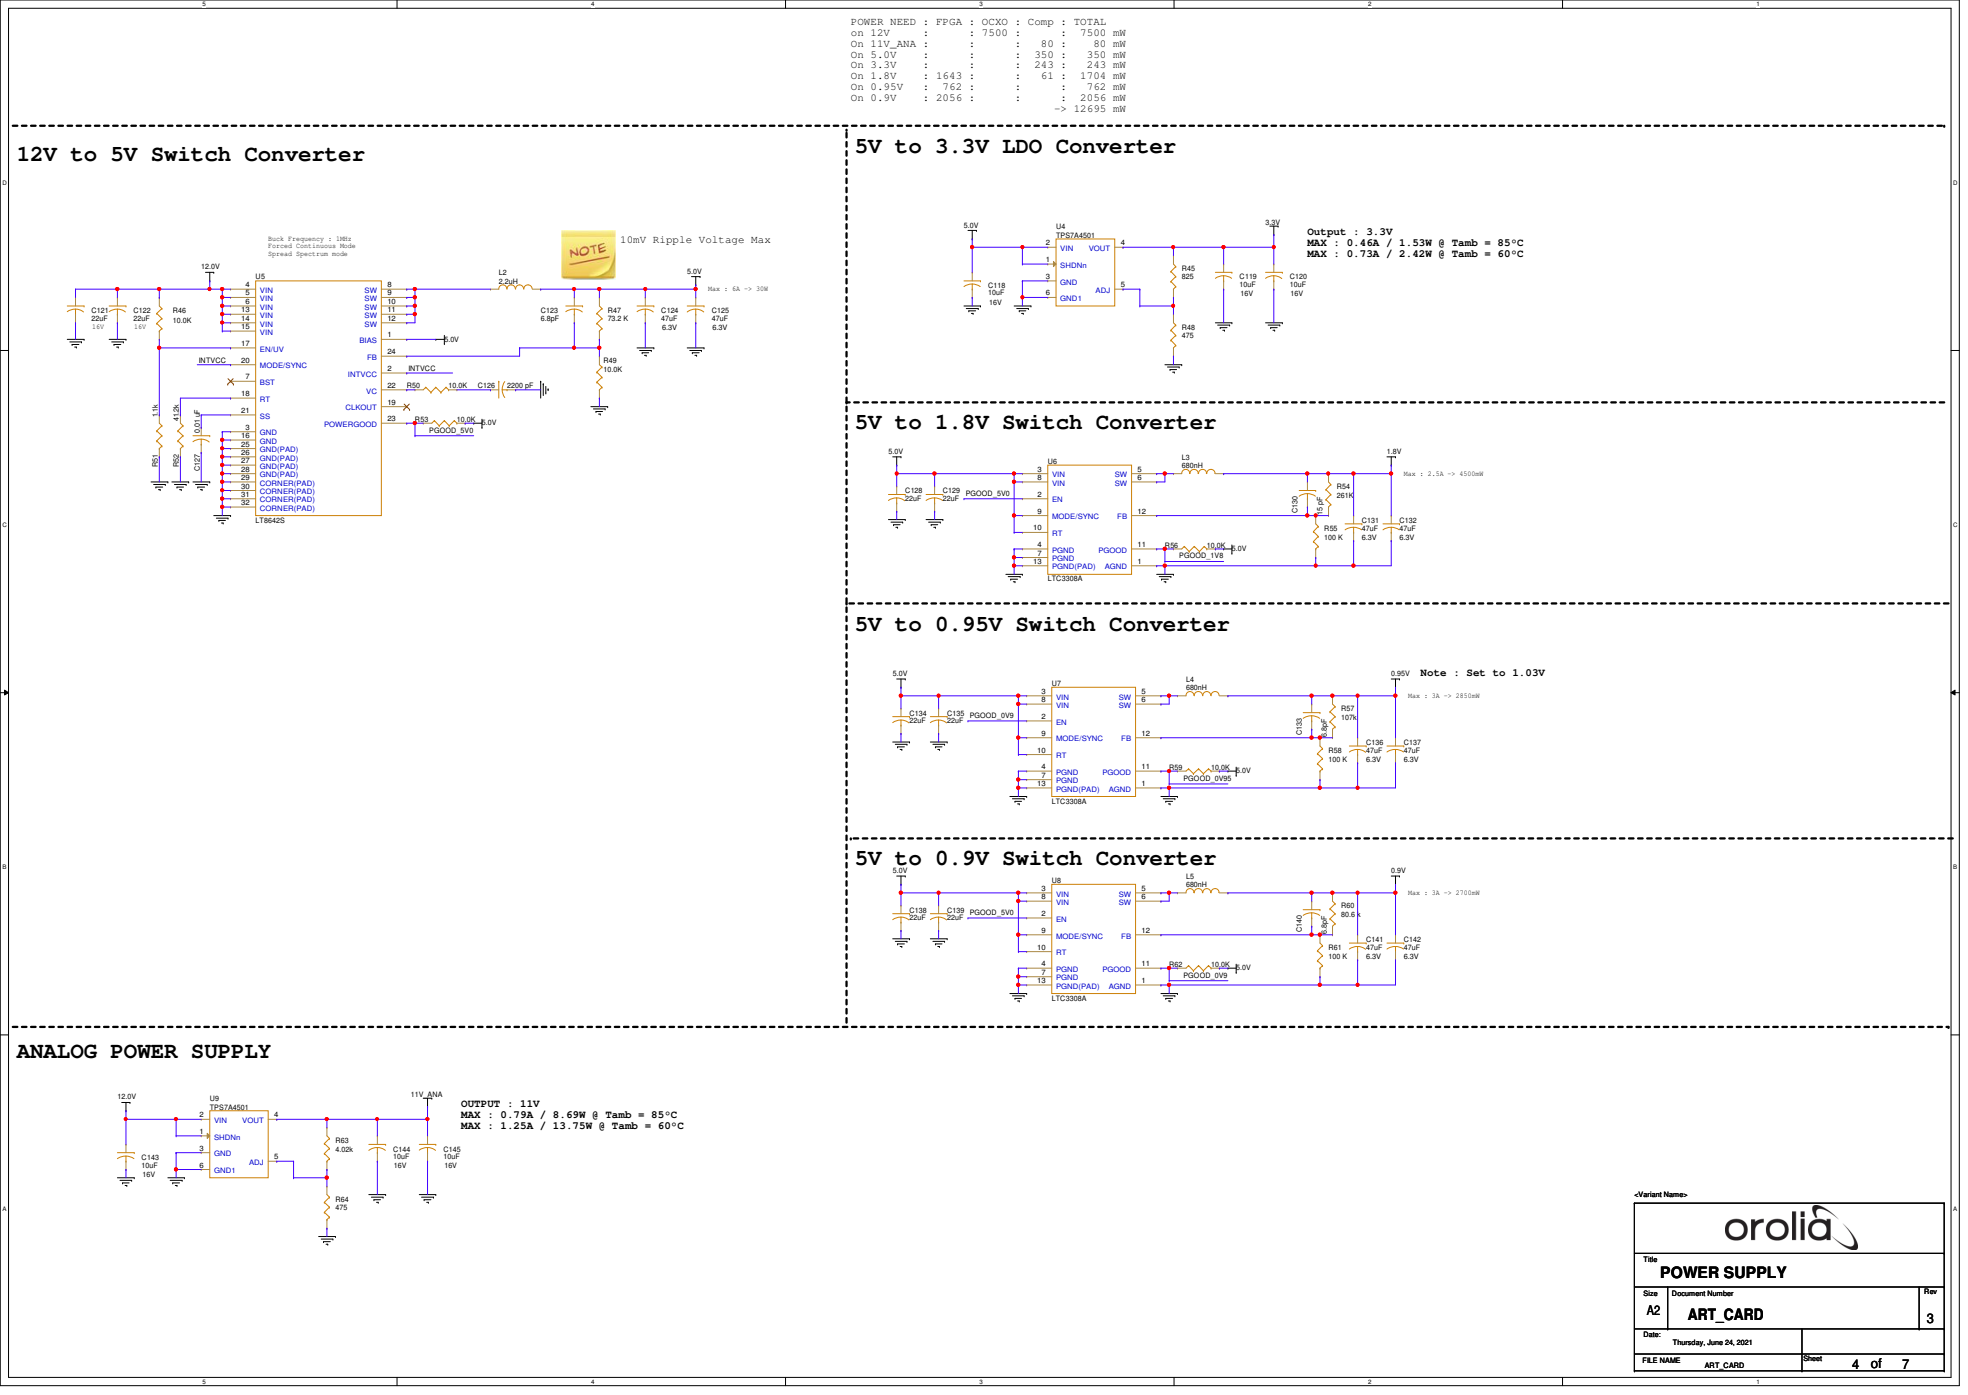
[picture p75: page 5]
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

Date: Date: Date: Thursday, June 24, 2021 Thursday, June 24, 2021 Thursday, June 24, 2021

FILE NAME FILE NAME FILE NAME ART_CARD ART_CARD ART_CARD | Sheet Sheet Sheet of of of 4 4 4 7 7 7

# MiniRubidium

# OSCILLATOR POWER SUPPLY

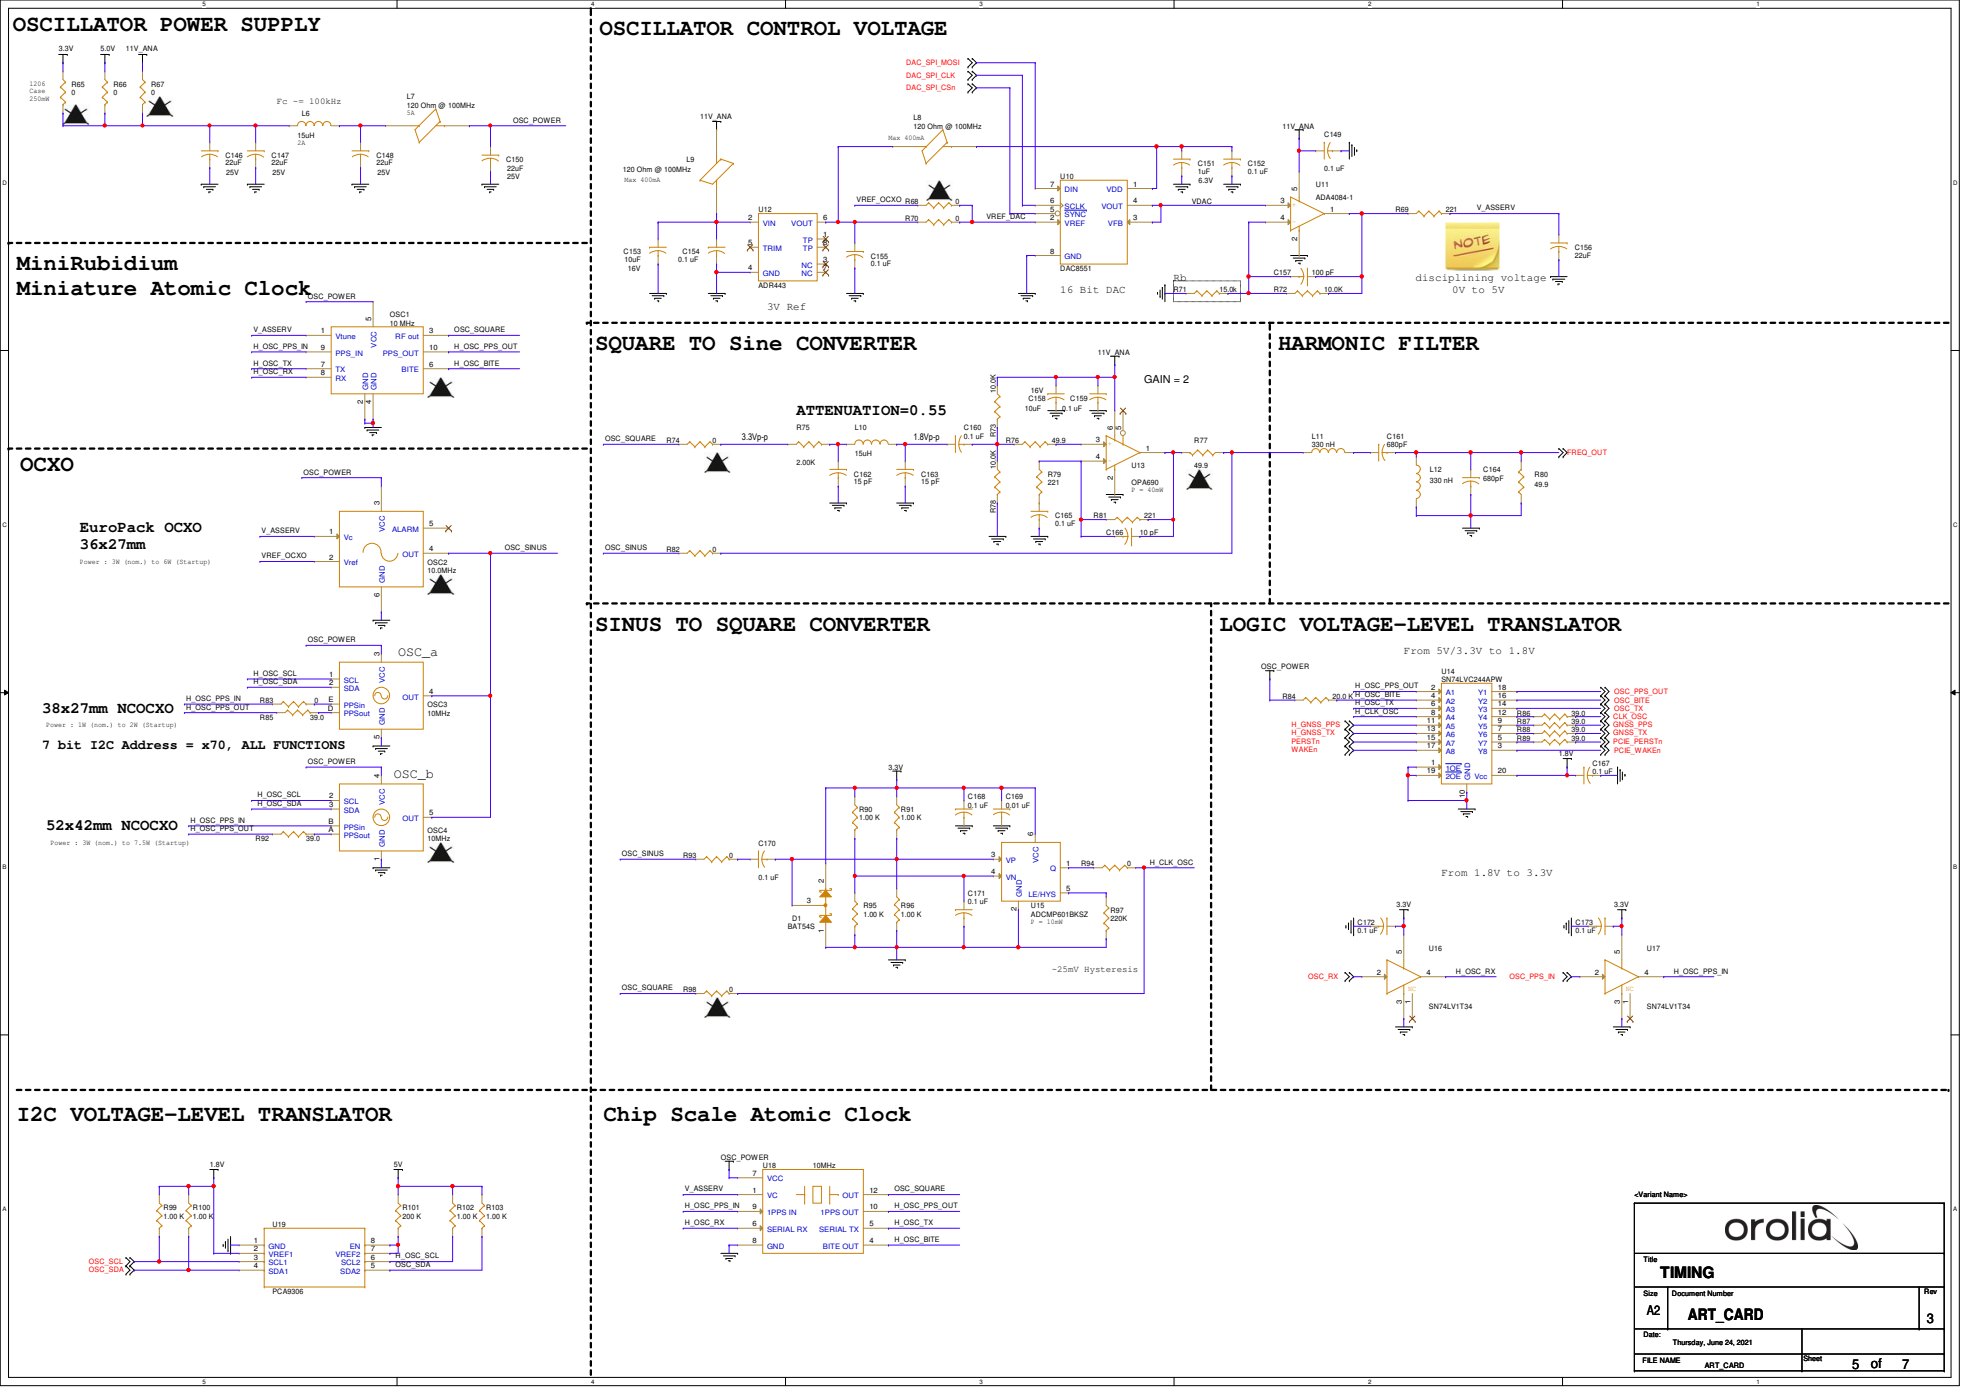
[picture p76: page 6]

SQUARE TO Sine CONVERTER

Power : 3W (nom.) to 6W (Startup)

Power : 1W (nom.) to 2W (Startup)
7 bit I2C Address = x70, ALL FUNCTIONS

Power : 3W (nom.) to 7.5W (Startup)

Chip Scale Atomic Clock

Date: Date: Date: Thursday, June 24, 2021 Thursday, June 24, 2021 Thursday, June 24, 2021

FILE NAME FILE NAME FILE NAME ART_CARD ART_CARD ART_CARD | Sheet Sheet Sheet of of of 5 5 5 7 7 7

ANTENNA POWER SUPPLY | GNSS RECEIVER | GNSS STANDOFF

## From 1.8V to 3.3V

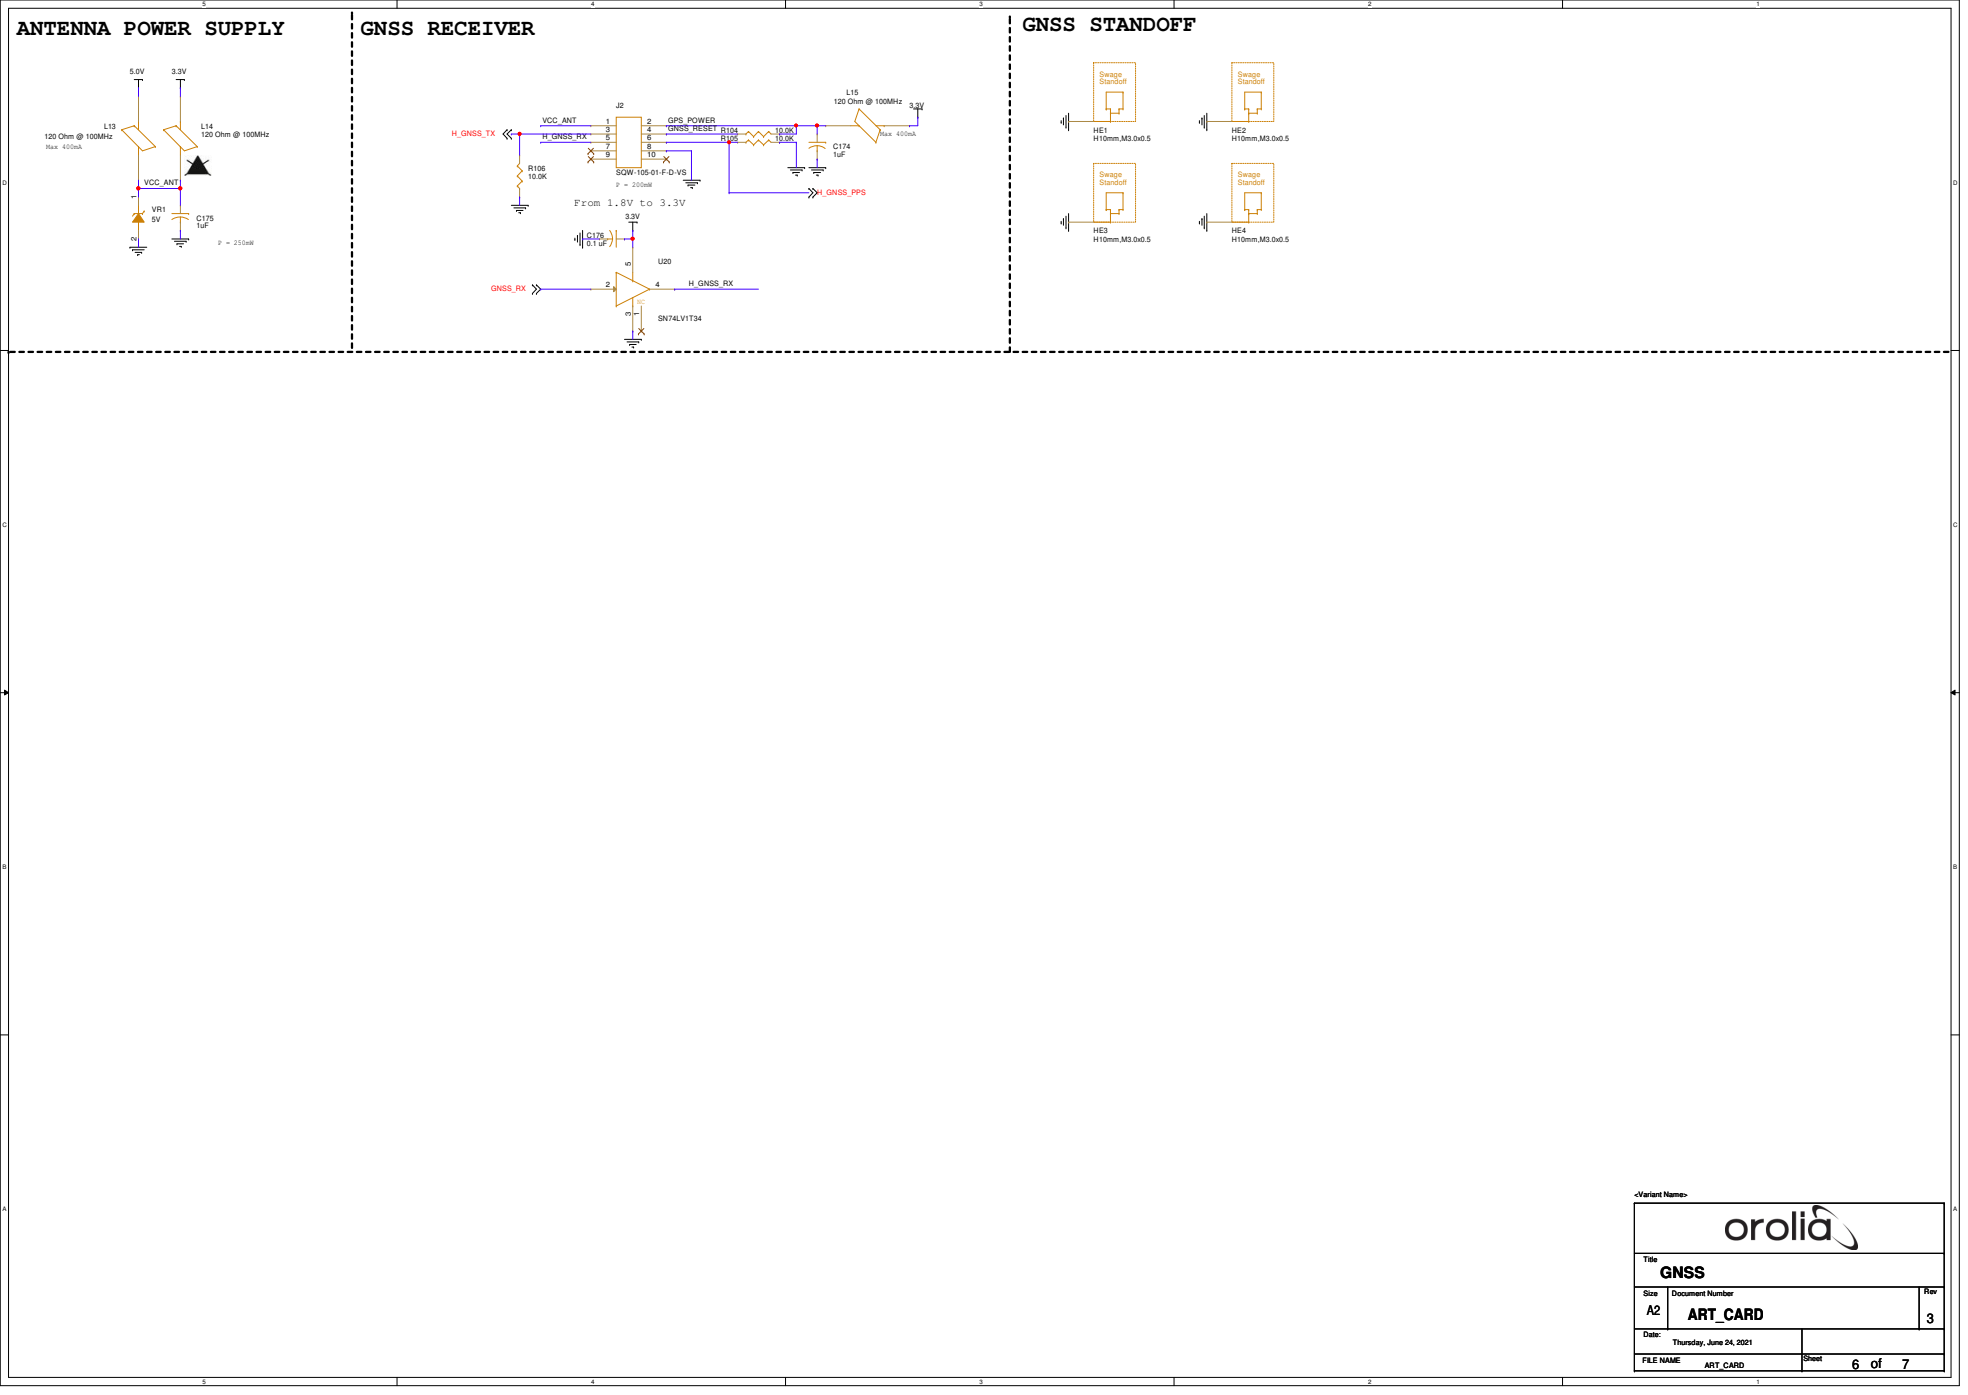
[picture p77: page 7]
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

Date: Date: Date: Thursday, June 24, 2021 Thursday, June 24, 2021 Thursday, June 24, 2021

FILE NAME FILE NAME FILE NAME ART_CARD ART_CARD ART_CARD | Sheet Sheet Sheet of of of 6 6 6 7 7 7

# 10MHZ OSC Buffer Driver

## Ra is 124 ohms GAIN = 2.8

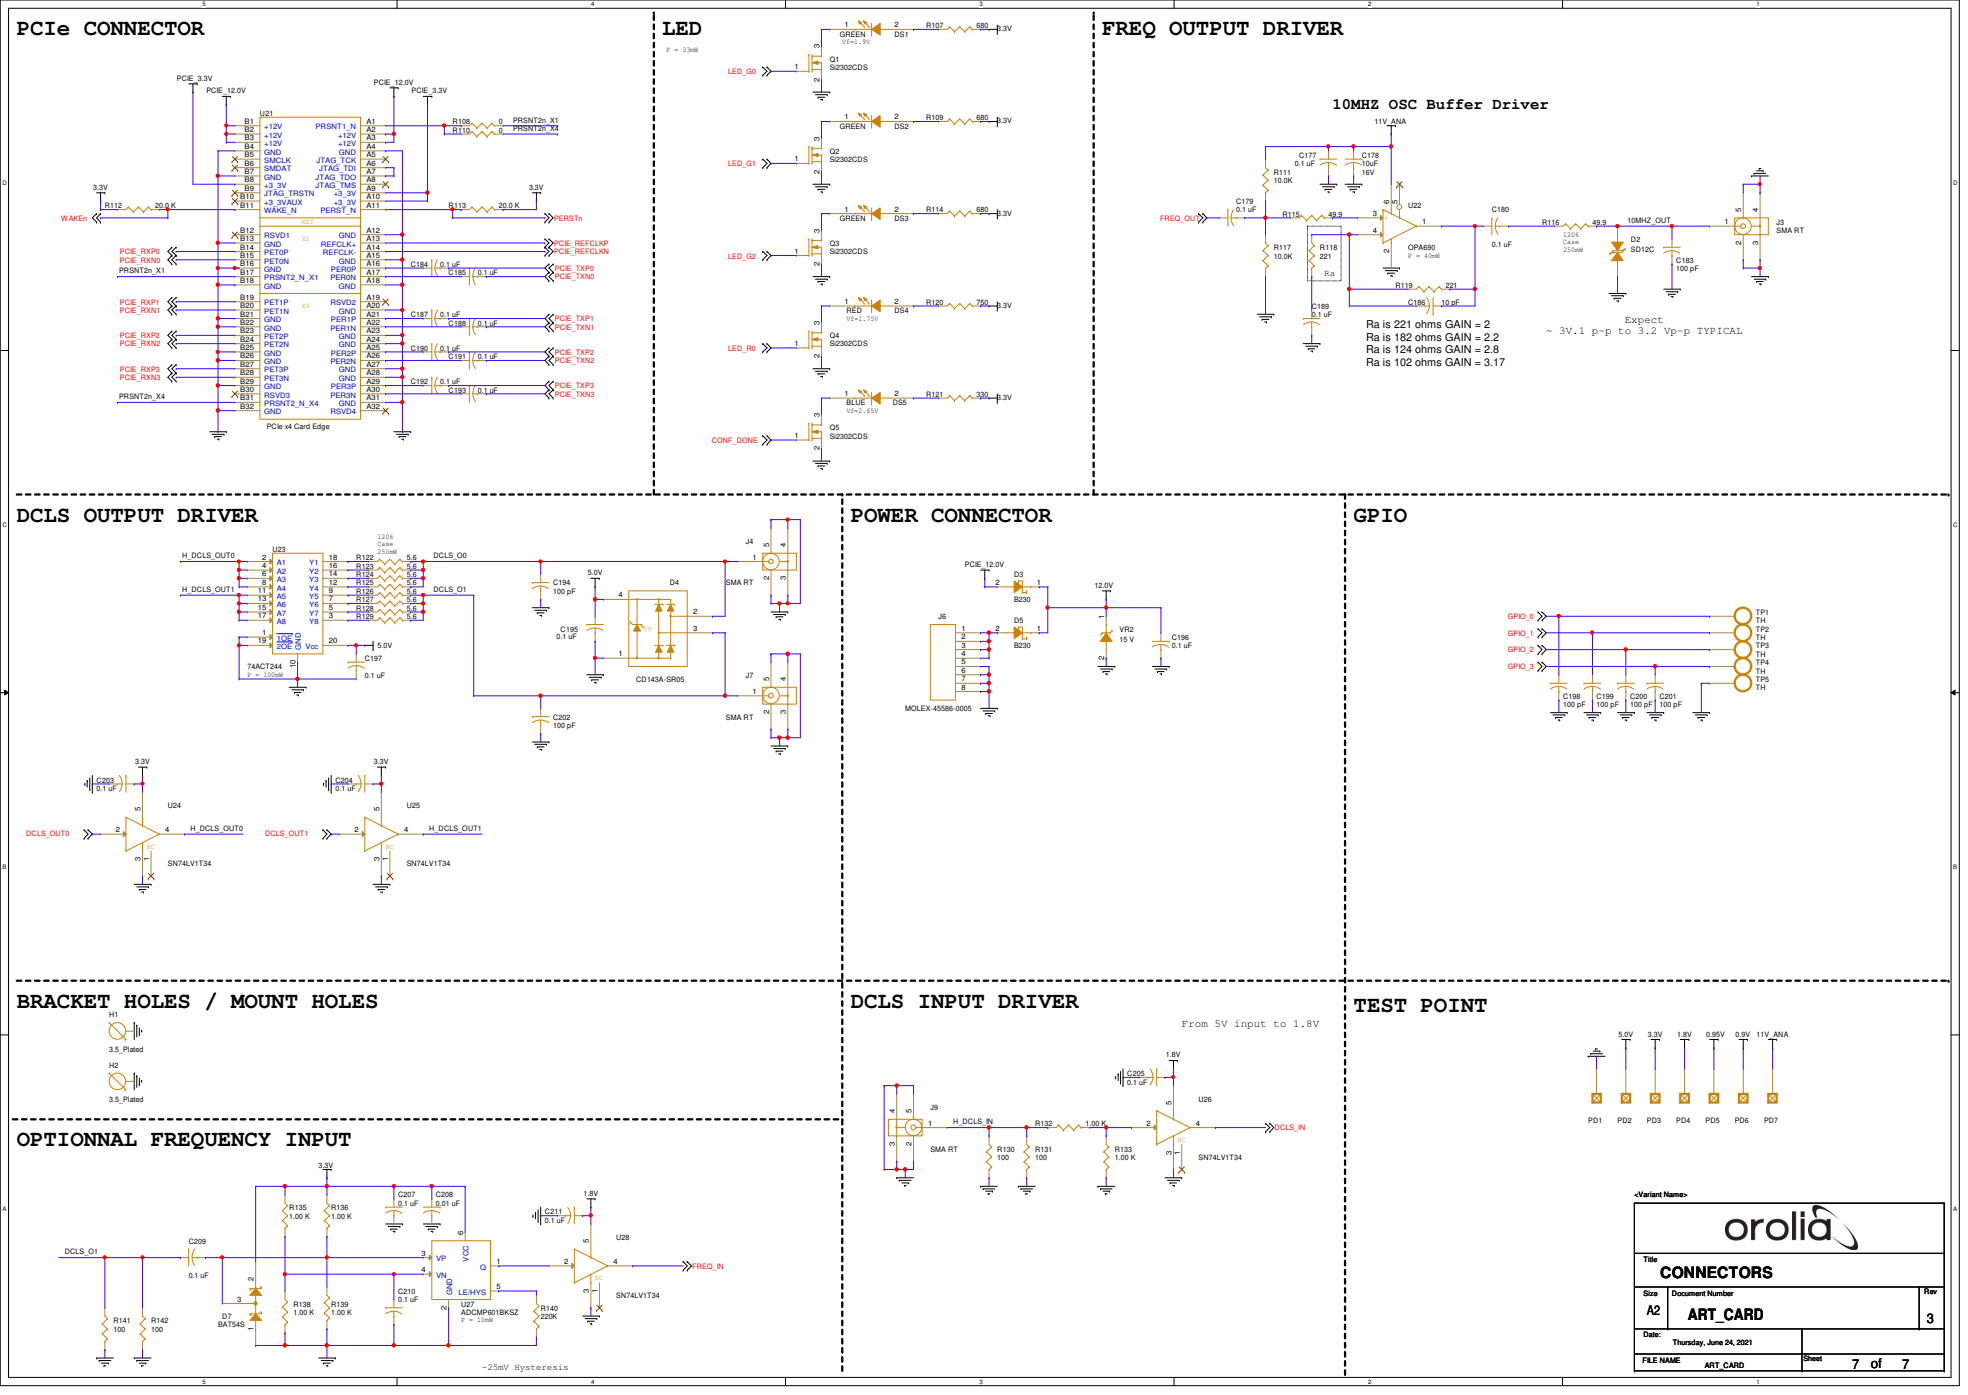
[picture p78: page 8]

Ra is 221 ohms GAIN = 2
Ra is 182 ohms GAIN = 2.2

Ra is 102 ohms GAIN = 3.17

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

Date: Date: Date: Thursday, June 24, 2021 Thursday, June 24, 2021 Thursday, June 24, 2021

FILE NAME FILE NAME FILE NAME ART_CARD ART_CARD ART_CARD | Sheet Sheet Sheet of of of 7 7 7 7 7 7

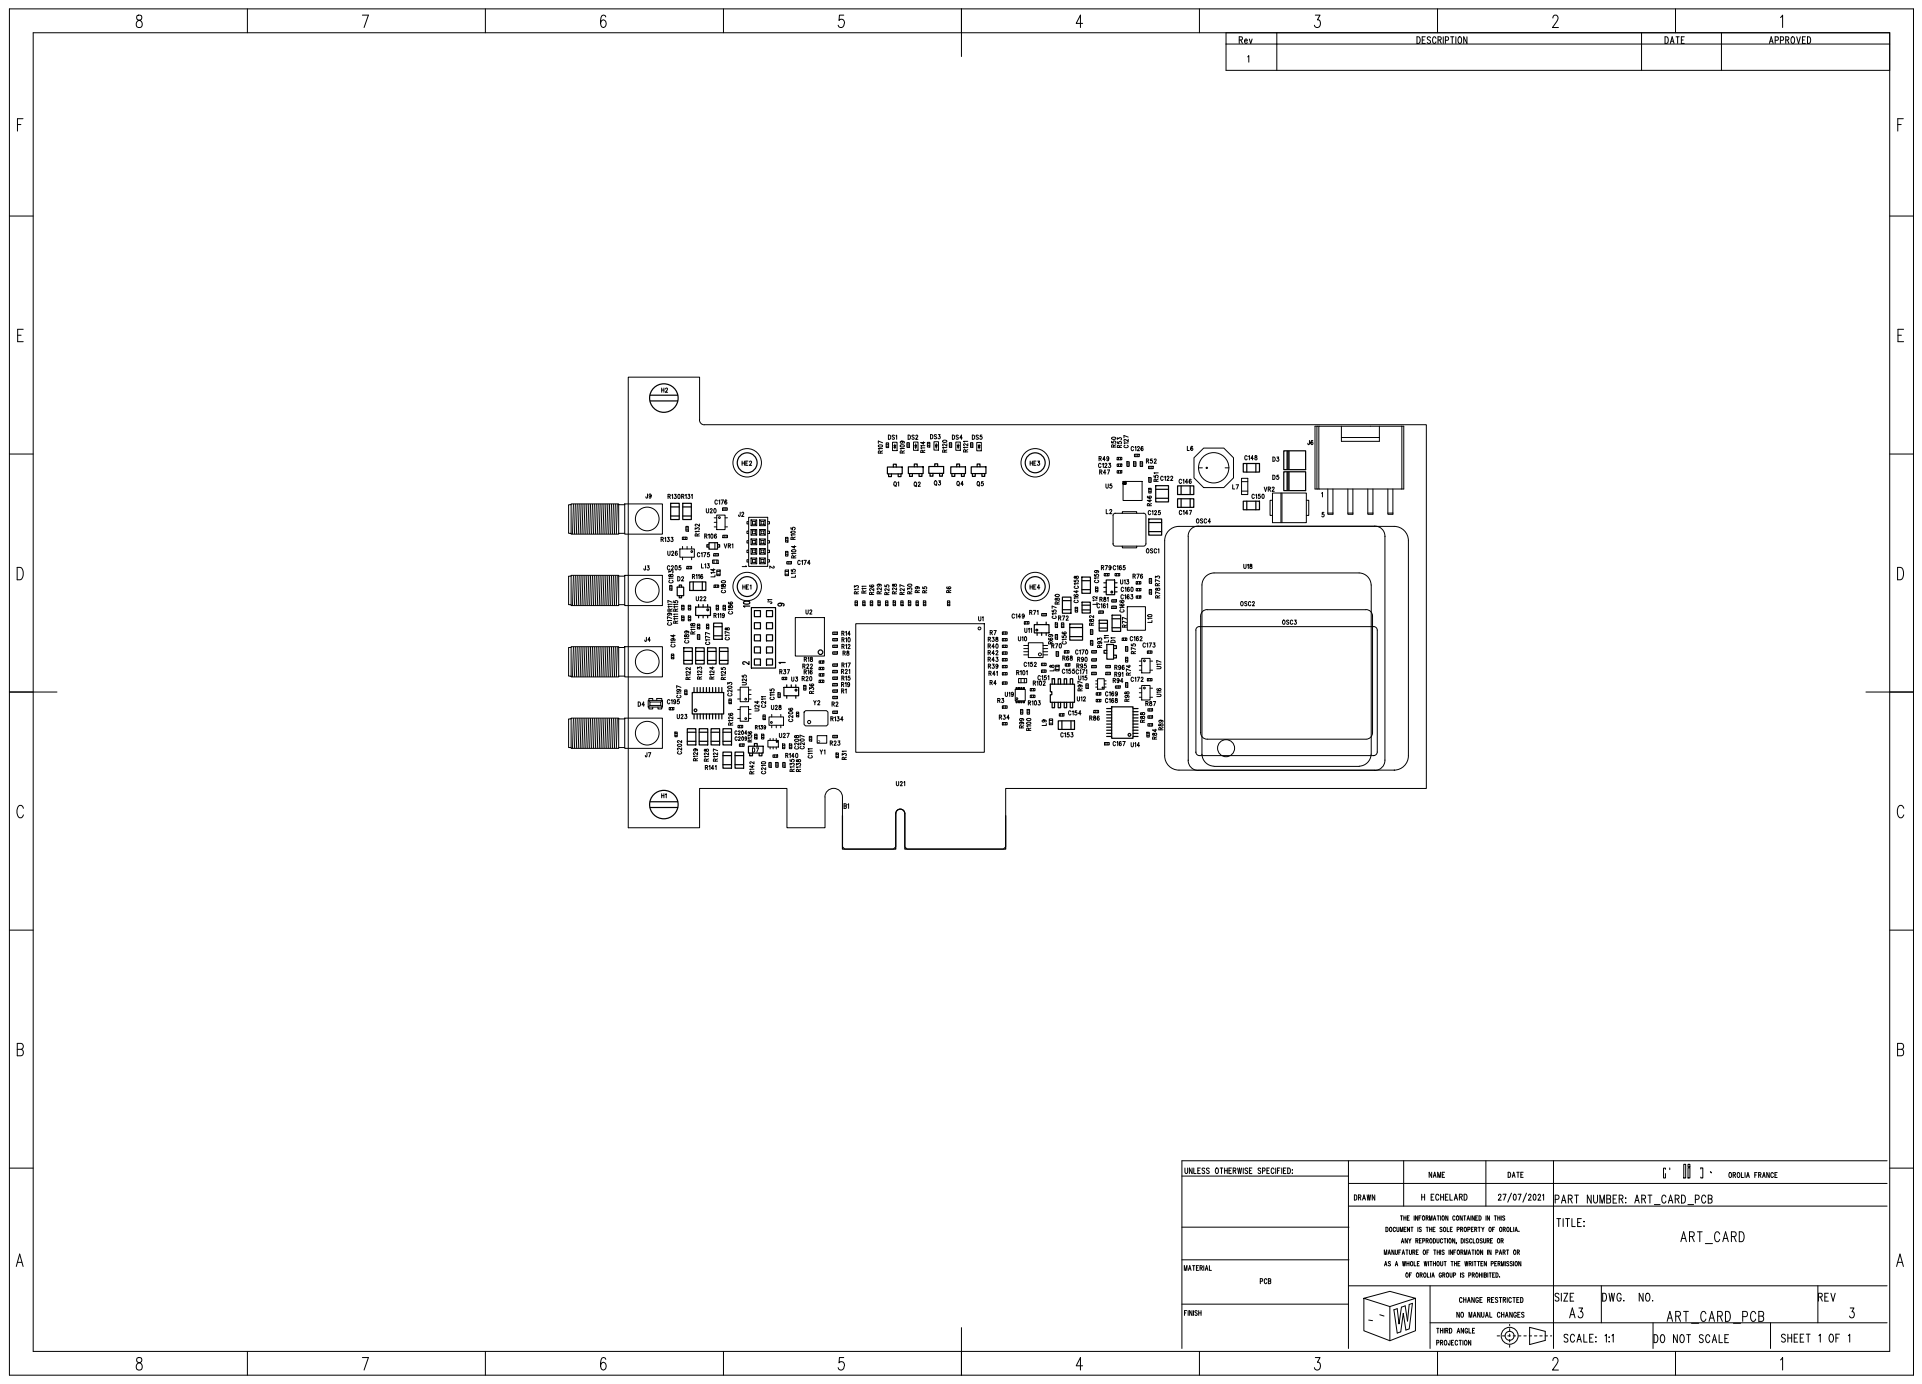
[picture p79: page 9]

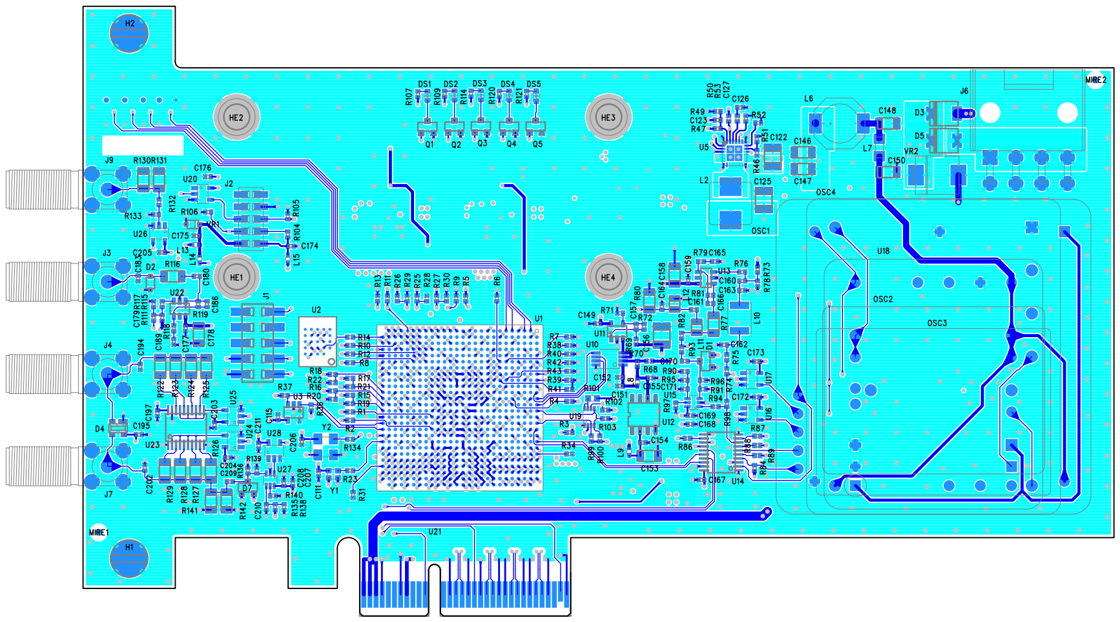
[picture p80: page 10]

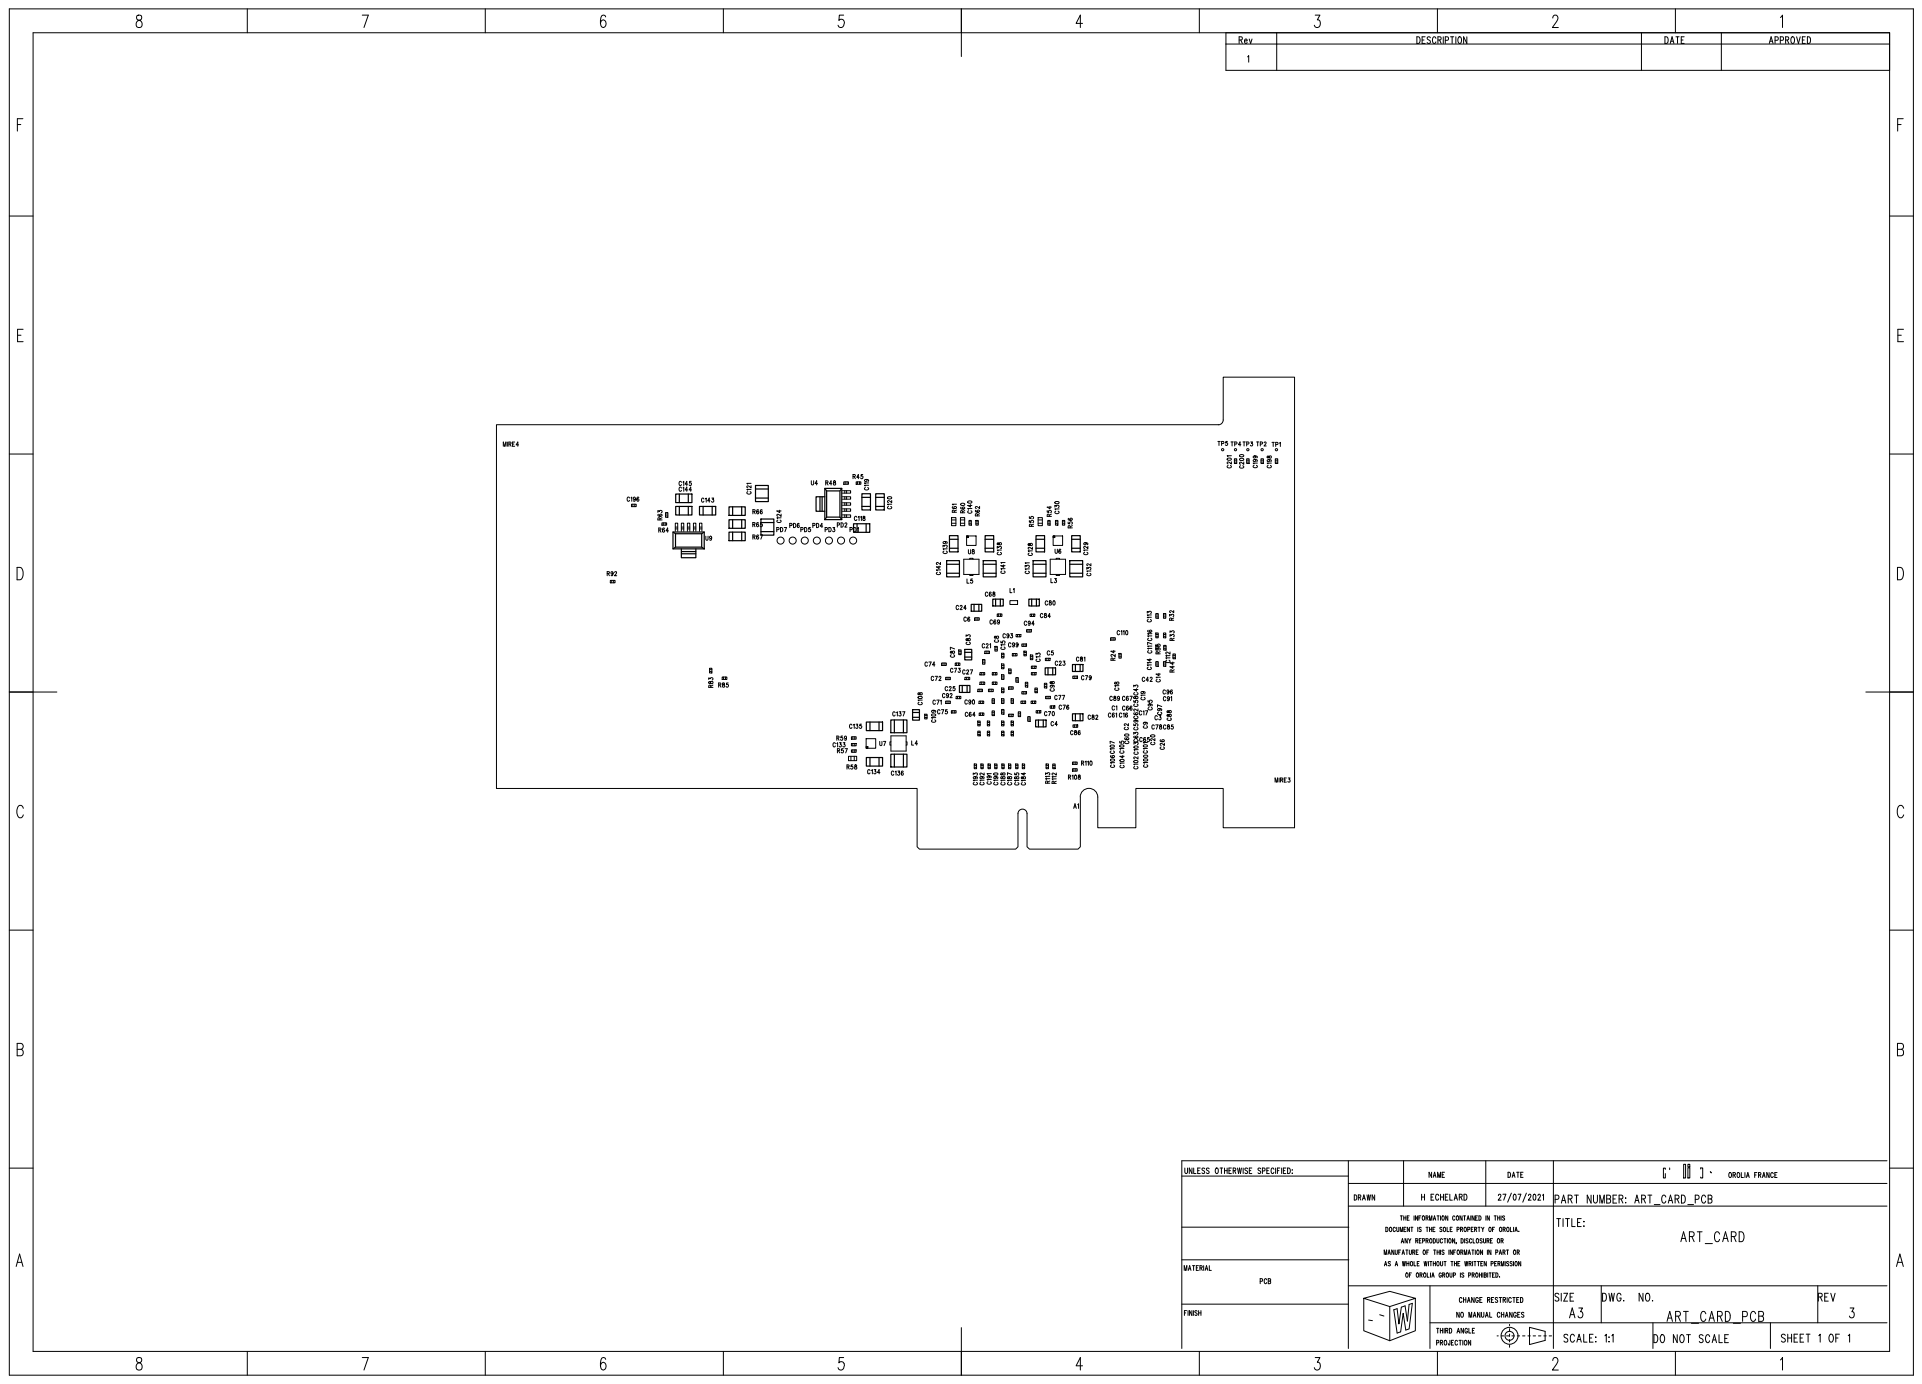
[picture p81: page 11]

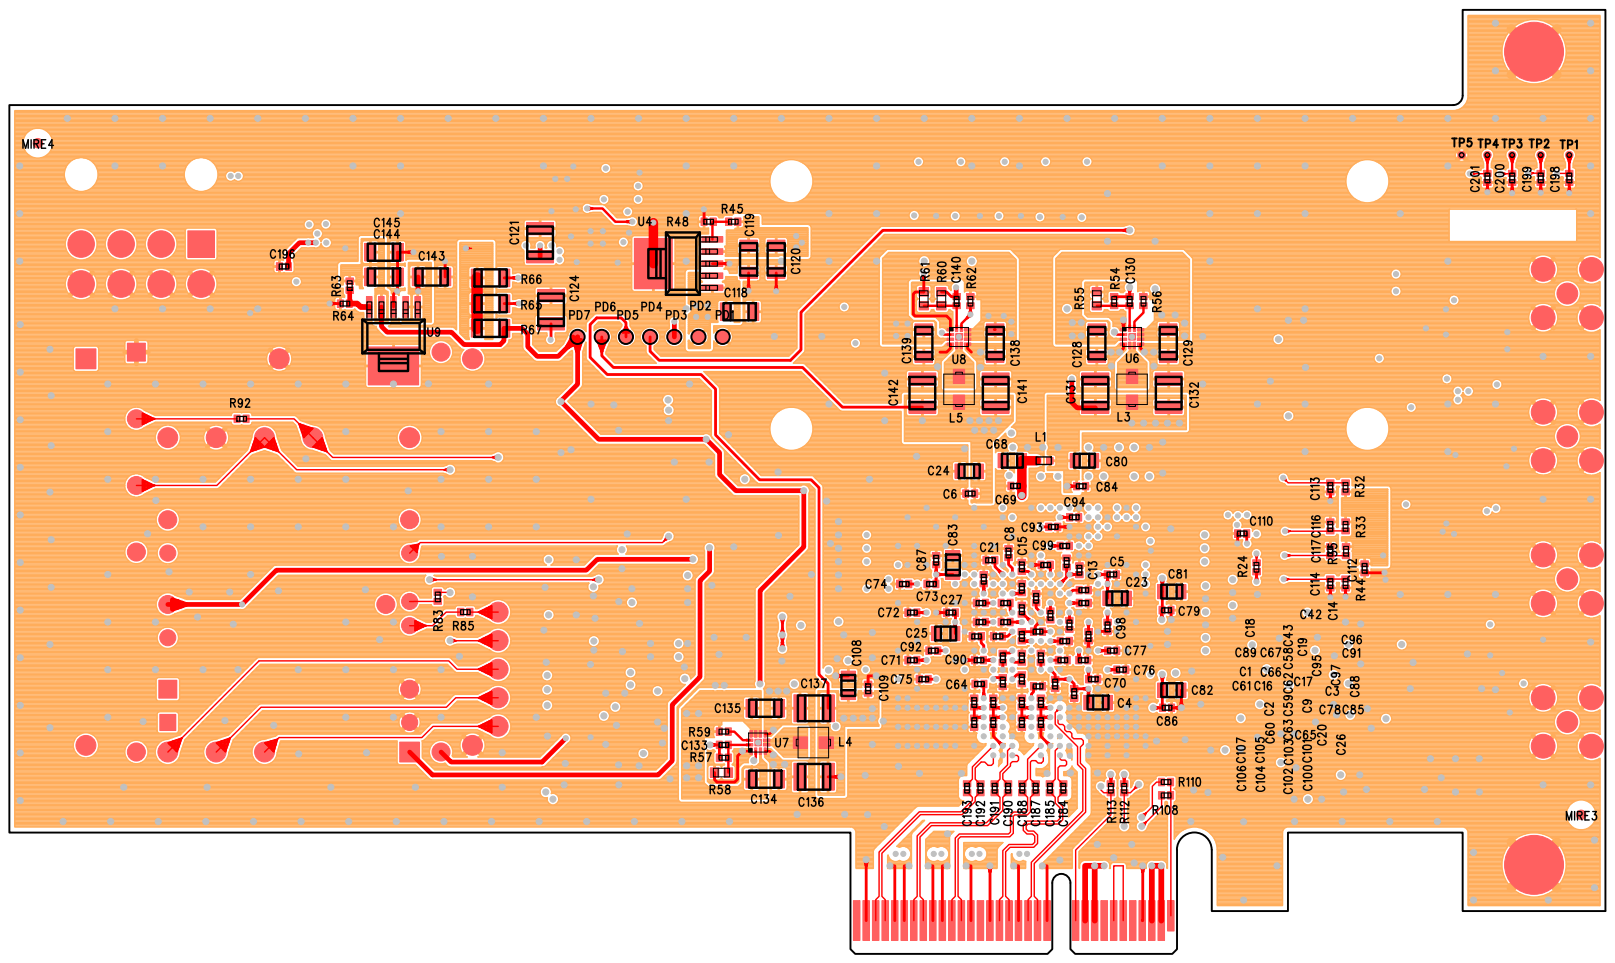
[picture p82: page 12]

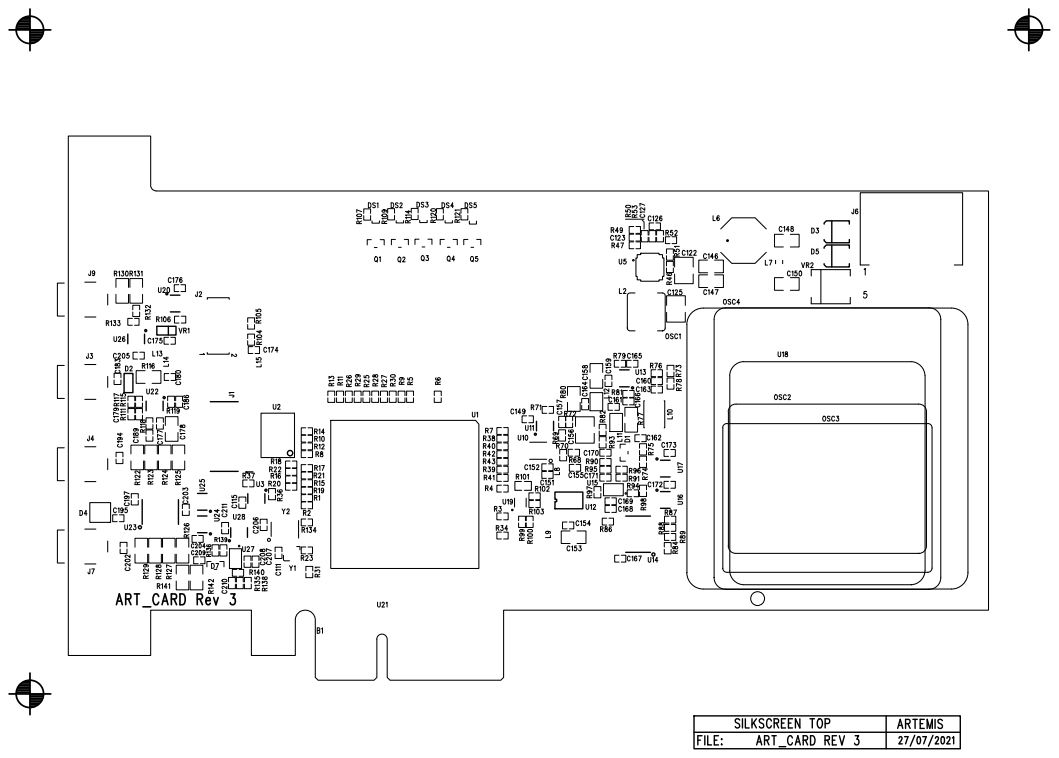
[picture p83: page 13]

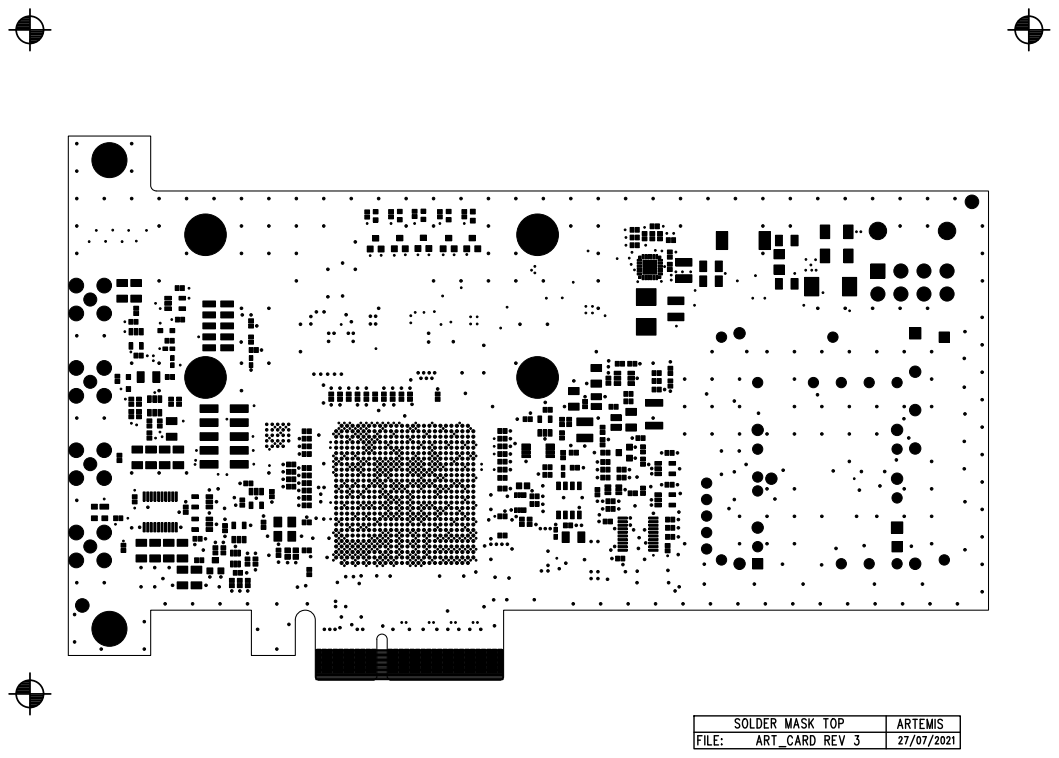
[picture p84: page 14]

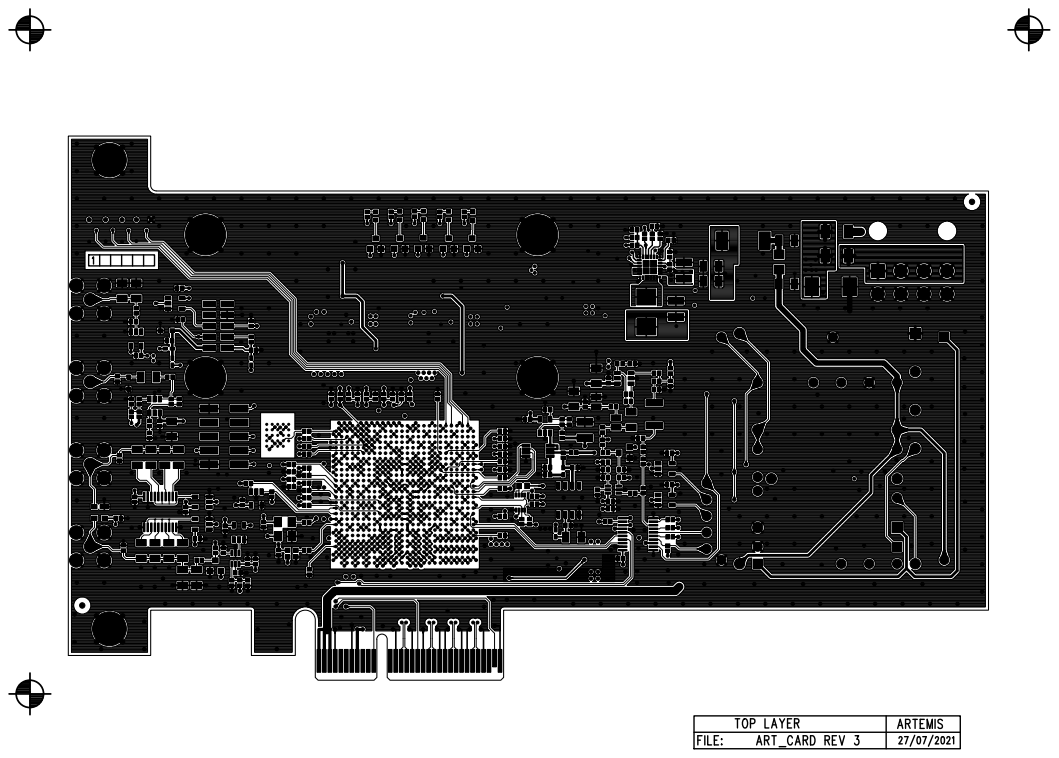
[picture p85: page 15]

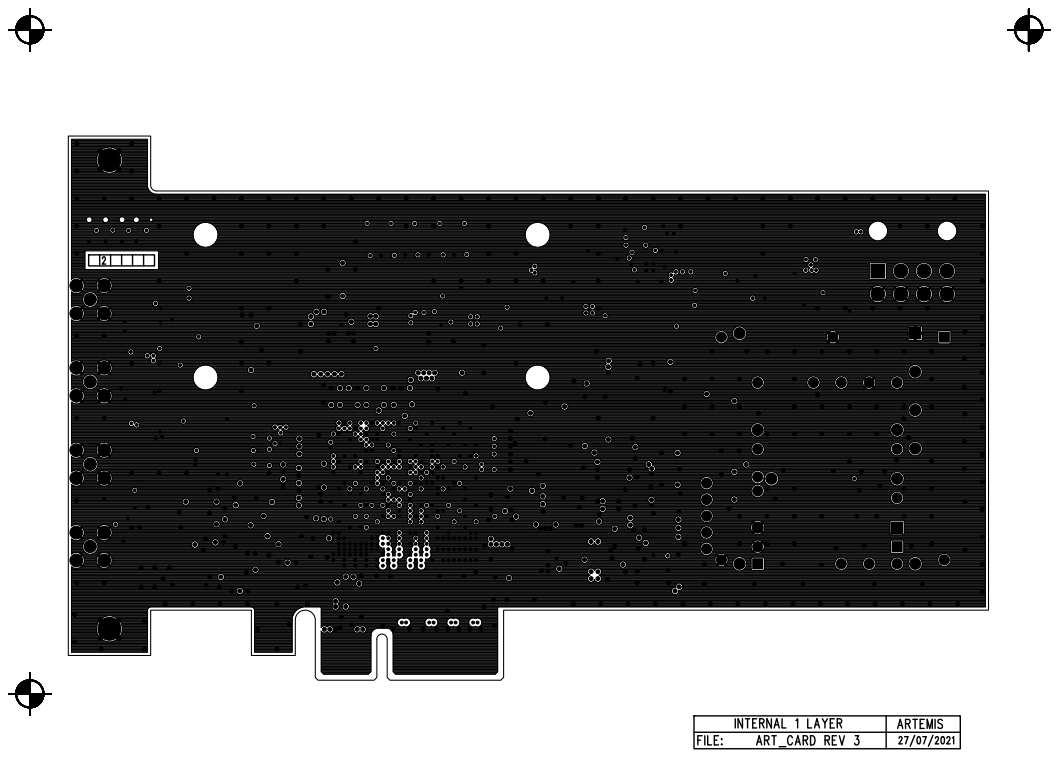
[picture p86: page 16]

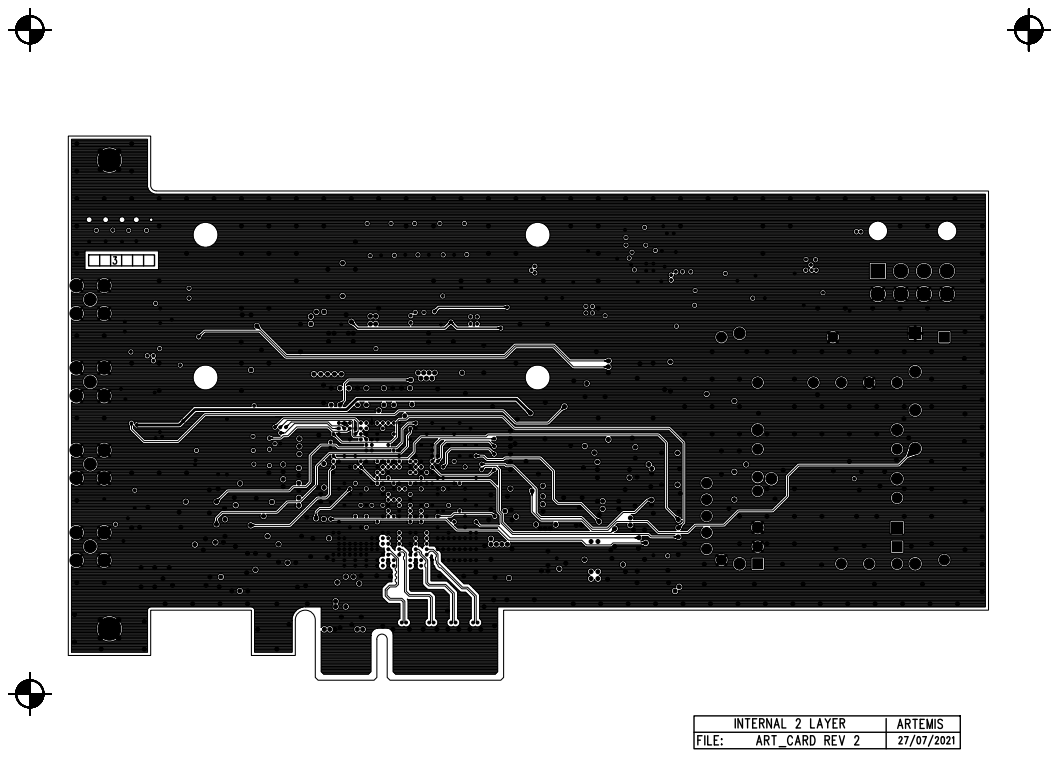
[picture p87: page 17]

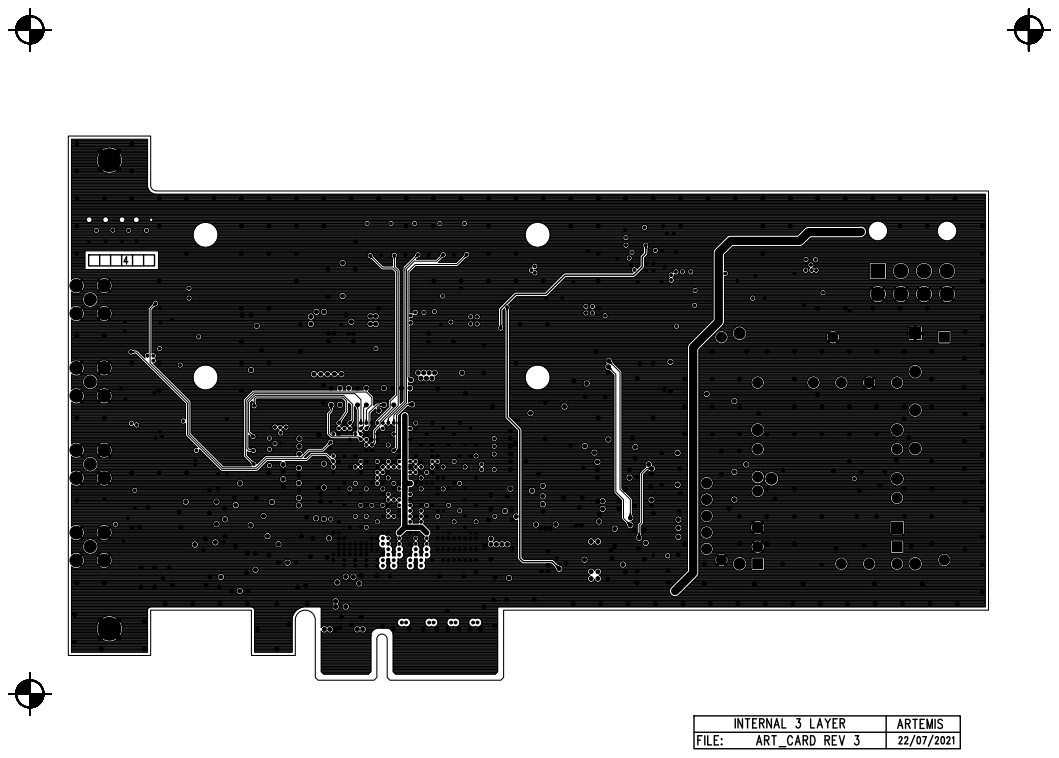
[picture p88: page 18]

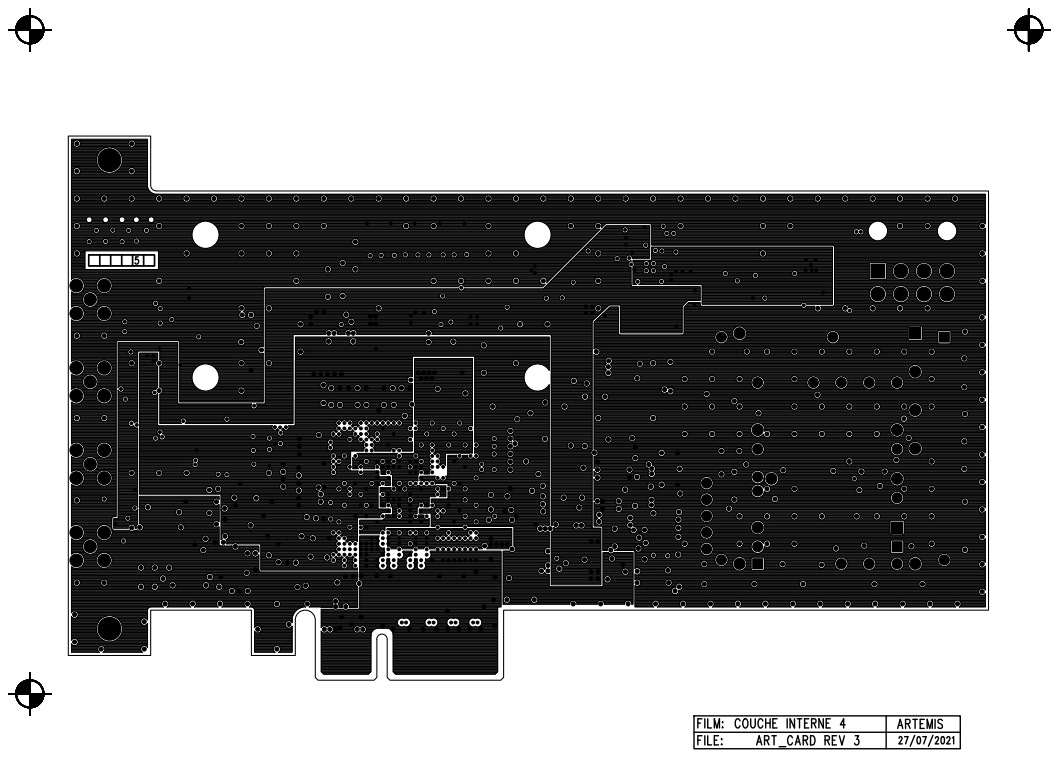
[picture p89: page 19]

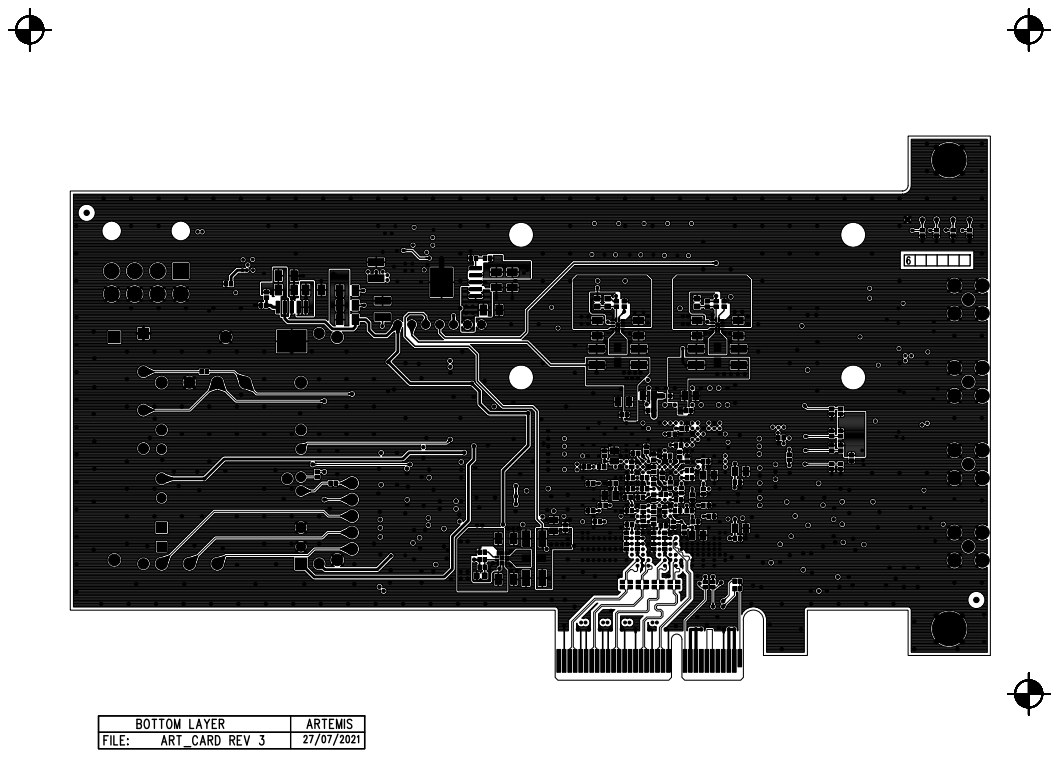
[picture p90: page 20]

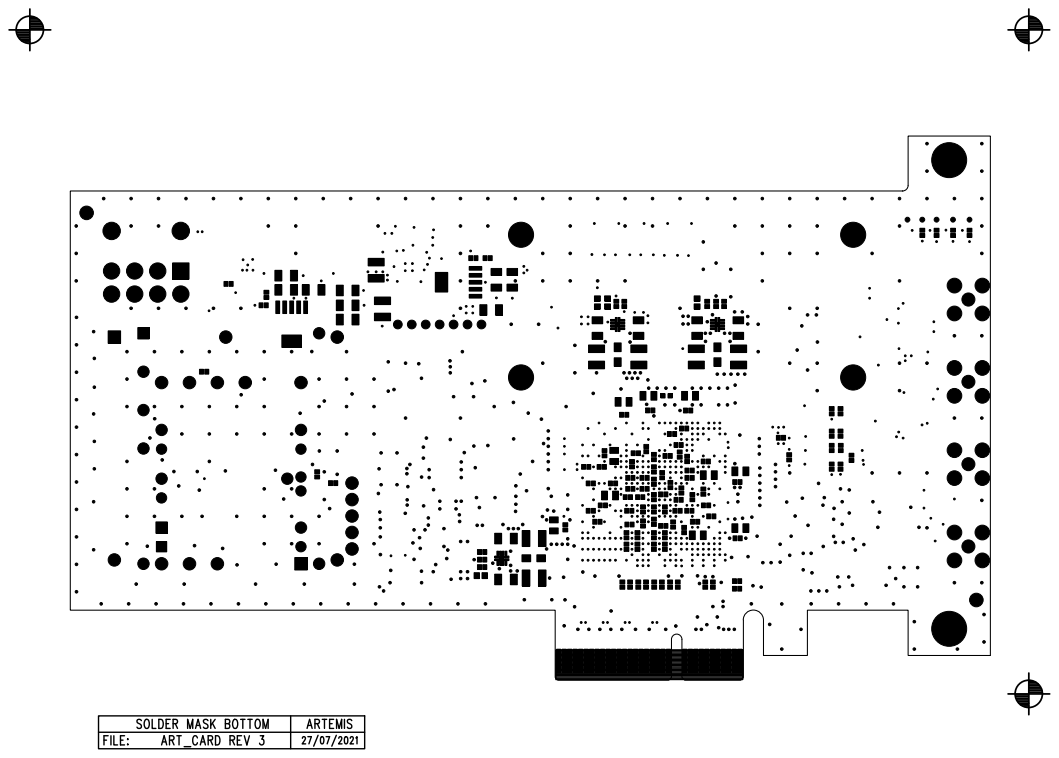
[picture p91: page 21]

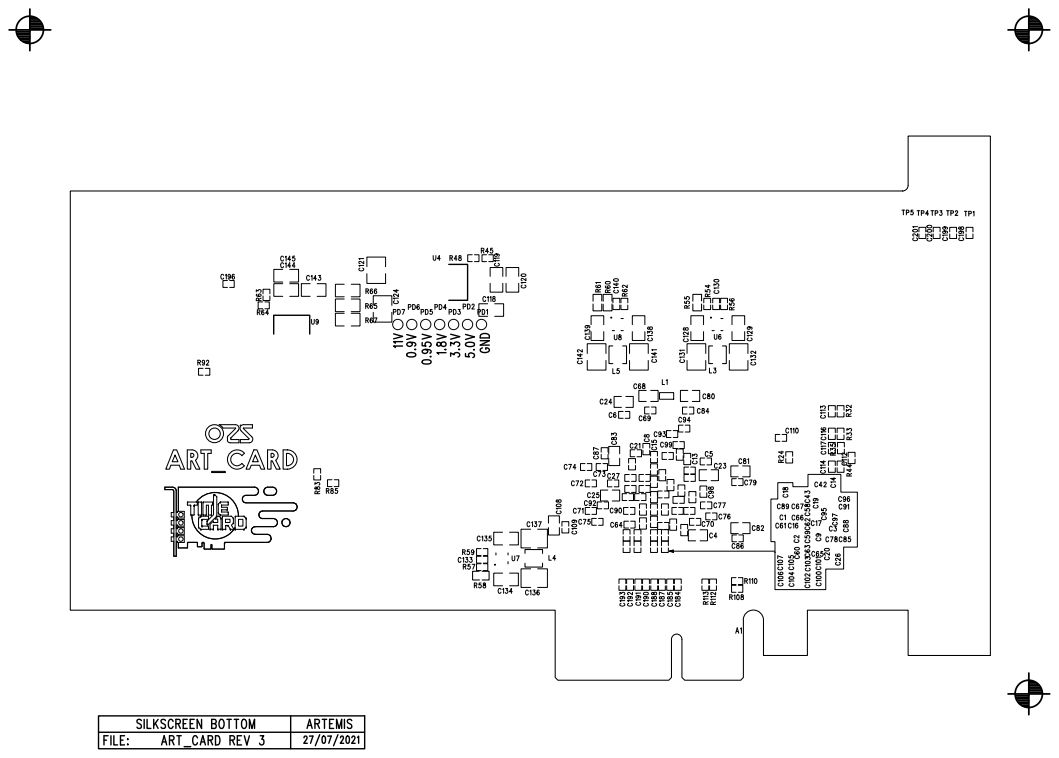
[picture p92: page 22]

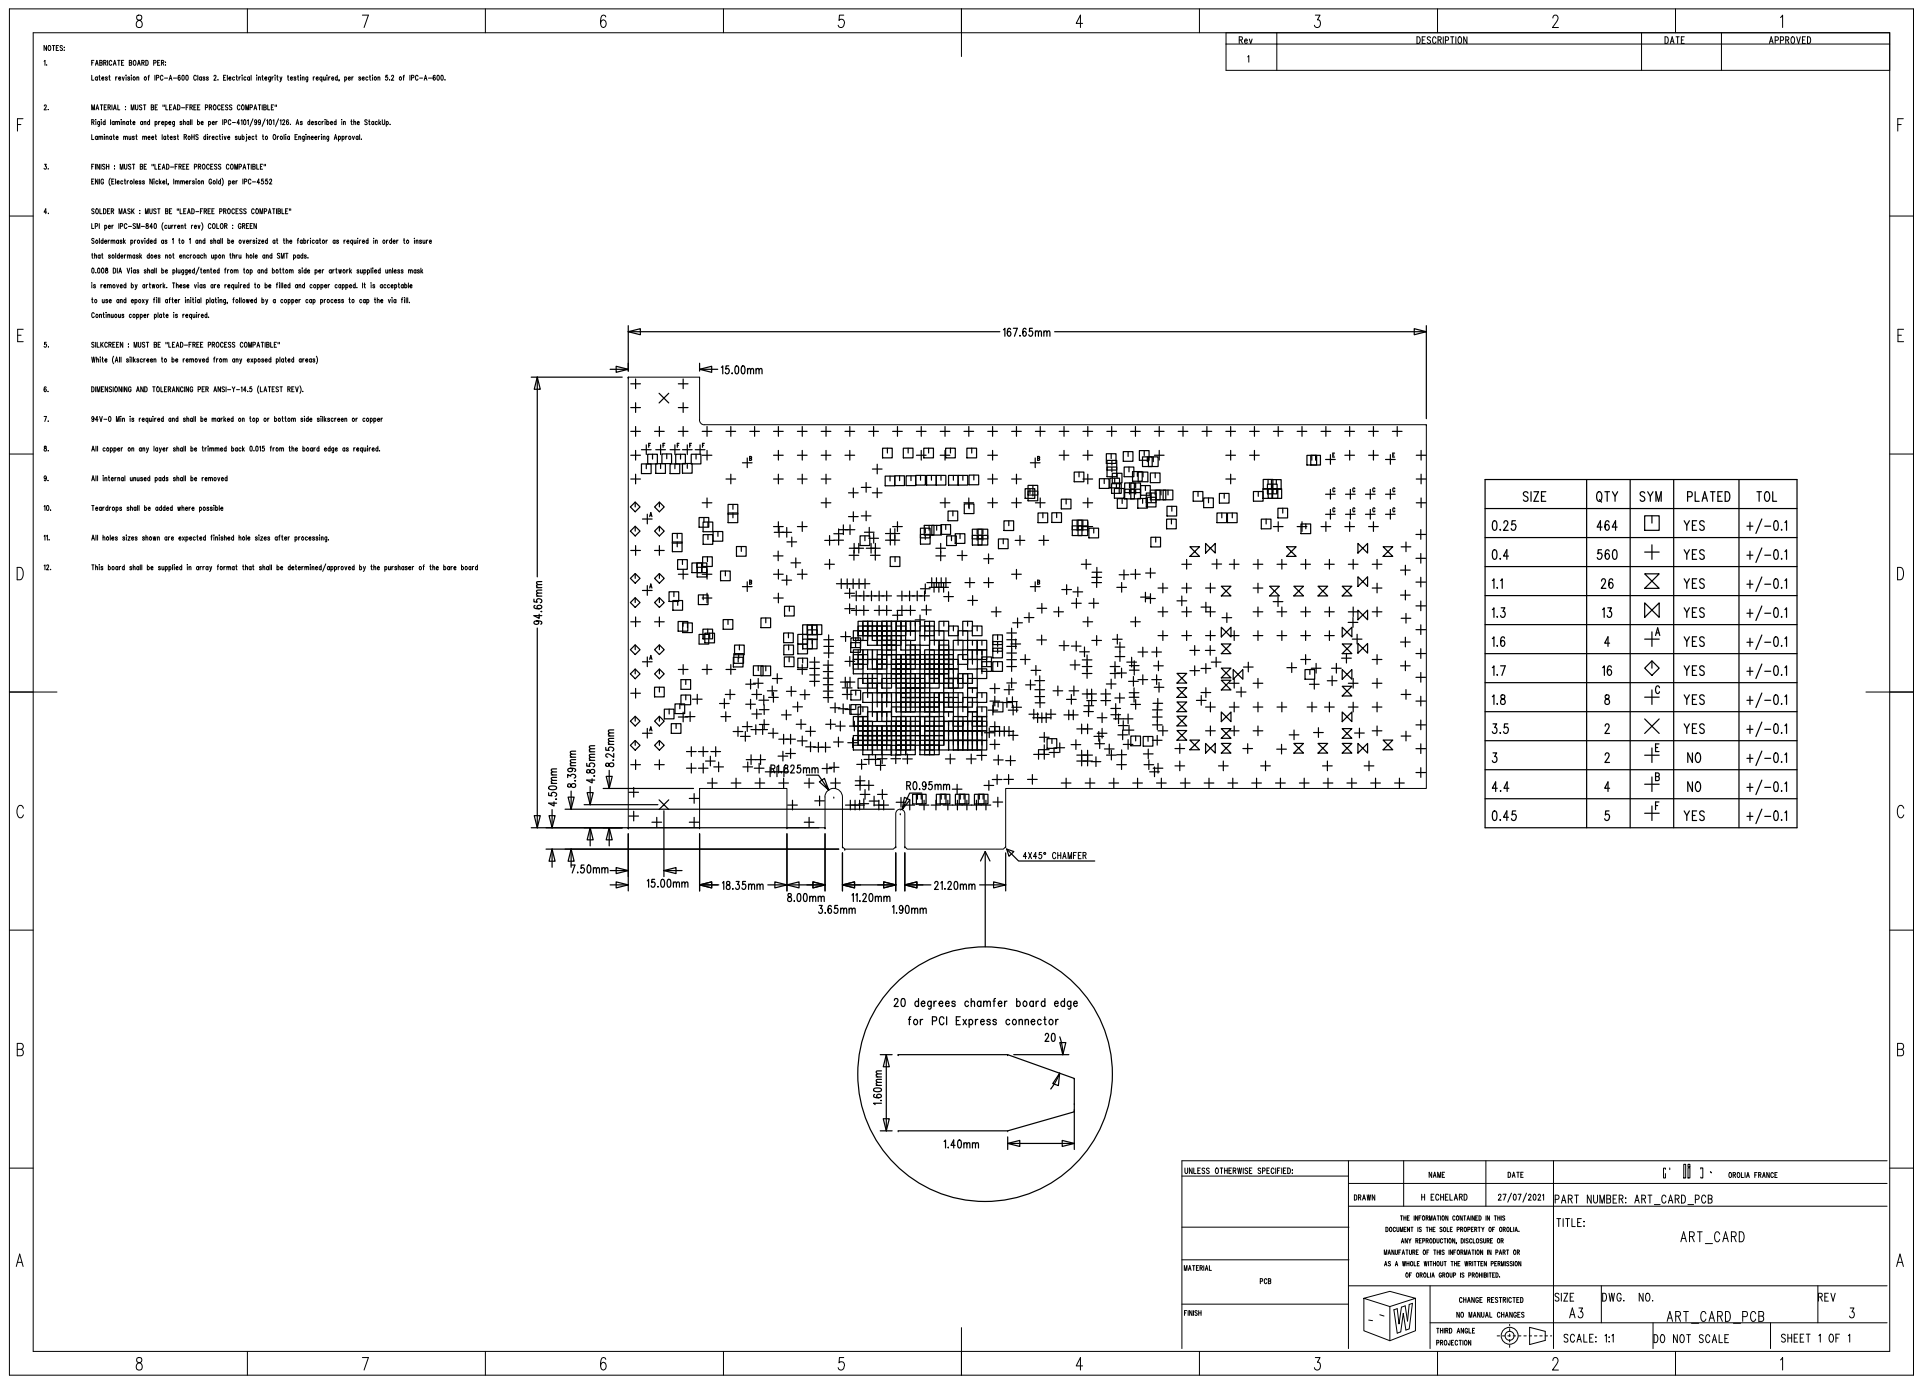
[picture p93: page 23]

StackName: Ouestronic_PCI Express_246183-Q_6L_VT47 | Version: | Revision: | Modification: | Date of Revision: | Editor | Page 1/2
Date: 28/01/2021 | Associated Documents:

# Author: Mostefa Abdali

# Department: IDS Site: Tewkesbury

Copyright © | Print style & presentation copyright © Polar Instruments Ltd
Solder resist | LPI | Solder resist | 0.020 | 4.100 | 0.0000
1 | Foil | 17um Copper Foil | Foil | 0.018 | 0.040 | 1, 2
VENTEC | VT47-2113 | VT-47 | PREPREG | 0.106 | 0.095 | 4.060 | 0.0000 | 57.000
2 | 0.017 | 0.017
VENTEC | VT-47 | 0.127mm | Core | 0.127 | 0.127 | 4.350 | 0.0000 | 0.000
3 | 0.017 | 0.017 | 3, 4
VENTEC | VT47-2116 | VT-47 | PREPREG | 0.132 | 0.121 | 4.150 | 0.0000 | 54.000
VENTEC | VT-47 | 0.711mm | Core | 0.711 | 0.711 | 4.400 | 0.0000 | 0.000
VENTEC | VT47-2116 | VT-47 | PREPREG | 0.132 | 0.121 | 4.150 | 0.0000 | 54.000
4 | 0.017 | 0.017 | 5, 6
VENTEC | VT-47 | 0.127mm | Core | 0.127 | 0.127 | 4.350 | 0.0000 | 0.000
5 | 0.017 | 0.017
VENTEC | VT47-2113 | VT-47 | PREPREG | 0.106 | 0.095 | 4.060 | 0.0000 | 57.000
6 | Foil | 17um Copper Foil | Foil | 0.018 | 0.040 | 7, 8
Solder resist | LPI | Solder resist | 0.020 | 4.100 | 0.0000

1.60 +0.16 / -0.16

1 | Coated Microstrip 1B | 1 | 0 | 2 | 0.150 | 0.000 | 0.000 | 0 | 50.090 | 50.000 | 10.000 | 0.000
2 | Edge Coupled Coated Microstrip 1B | 1 | 0 | 2 | 0.150 | 0.150 | 0.000 | 0 | 87.470 | 85.000 | 10.000 | 0.020
3 | Offset Stripline 1B1A | 3 | 5 | 2 | 0.160 | 0.000 | 0.000 | 0 | 50.950 | 50.000 | 10.000 | 0.000
4 | Edge Coupled Offset Stripline 1B1A | 3 | 5 | 2 | 0.160 | 0.150 | 0.000 | 0 | 85.010 | 85.000 | 10.000 | 0.000
5 | Offset Stripline 1B1A | 4 | 5 | 2 | 0.160 | 0.000 | 0.000 | 0 | 50.950 | 50.000 | 10.000 | 0.000
6 | Edge Coupled Offset Stripline 1B1A | 4 | 5 | 2 | 0.160 | 0.150 | 0.000 | 0 | 85.010 | 85.000 | 10.000 | 0.000
7 | Coated Microstrip 1B | 6 | 0 | 5 | 0.150 | 0.000 | 0.000 | 0 | 50.090 | 50.000 | 10.000 | 0.000

StackName: Ouestronic_PCI Express_246183-Q_6L_VT47 | Version: | Revision: | Modification: | Date of Revision: | Editor | Page 2/2
Date: 28/01/2021 | Associated Documents:

# Author: Mostefa Abdali

# Department: IDS Site: Tewkesbury

Copyright © | Print style & presentation copyright © Polar Instruments Ltd
8 | Edge Coupled Coated Microstrip 1B | 6 | 0 | 5 | 0.150 | 0.150 | 0.000 | 0 | 87.470 | 85.000 | 10.000 | 0.020
1 | 1 | 6 | Mechanical PTH | 0.250 | None | 0.500

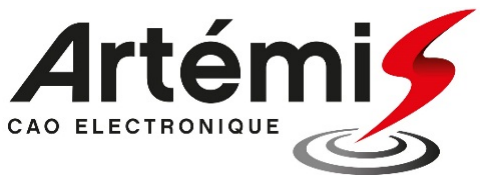
[picture p94: figure]

# Angers Technopole 1 bis Avenue du Bois l’Abbé 49070 BEAUCOUZÉ FRANCE Phone : +33(0)2-41-48-98-68 b.jule@artemis-cad.com www.artemis-cad.com

# PCB Reference :

✓ | PCB Unit | Unit PCB dimensions : | mm
Panel PCB : | Panel dimensions : | mm
Surface : | dm² | / | mm

# Finish Copper Thikness (µm) :

✓
✓
✓ | Plated Trough Hole | Via type : | Hole / pads ratio :
✓ | Traditional | Press-fit Hole | ✓ | Traditional Via | Via in pad
✓ | SMT | Autre | Laser Via | Stacked | Staggered
Surface Treatement Finished | Blinded Via
✓ | Buried Via
Filled Via | Resin | Copper
Peelable Solder Mask | Standard | TOP | BOTTOM
✓ | Photo-imageable | ✓ | TOP | ✓ | BOTTOM
✓ | Ink | ✓ | TOP | ✓ | BOTTOM
✓ | Yes | No
✓ | Impedance control : | ✓ | Produced | Measured
✓ | Differential Pairs : | ✓ | Produced | Measured
✓ | Stack-up :
Milling | Milling Diameter : | mm

# TECHNICAL SPECIFICATION

# IPC-A-600

# OROLIA

ART_CARD | Index : | Rev 3
Track / Gap : | 0,15

168 X 95

0 | X | 0
Technology | 0,25/0,55

0,15

PCB Type : | MC6 | 12µ | 17,5µ | 35µ | 40µm
PCB Thickness (mm) : | 16/10 | External Layer :

# Intern Layer :

Material : | FR4 | 1,59

# Couche départ et d'arrivée

Ni/Au Chemical | Couche départ et d'arrivée
Sn/Cu HAL | Autre Sn/Pb surfondu
Solder Mask | Green
Silkscreen | White

# Electrical Test

0

# MANUFACTURER :

# CUSTUMER :

# 50 ohms on layer 1, 3 and 4

# 85 ohms on layer 1, 3 and 6

# Ouestronic_PCI Express_246183-Q_6L_VT47.pdf

0

# Comments :
