Orolia2s/art-card-board/ProductionFile/Rev1/ART_CARD Rev 1.pdf

# ART_CARD Rev 1

- | 7 | SHEETS OF ELECTRICAL SCHEMATICS
- | 1 | ASSEMBLY DRAWING TOP
- | 1 | ASSEMBLY DRAWING BOTTOM
- | 1 | SILKSCREEN TOP
- | 1 | SOLDER MASK TOP
- | 1 | COPPER LAYER TOP
- | 1 | COPPER LAYER INNER 1
- | 1 | COPPER LAYER INNER 2
- | 1 | COPPER LAYER INNER 3
- | 1 | COPPER LAYER INNER 4
- | 1 | COPPER LAYER BOTTOM
- | 1 | SOLDER MASK BOTOM
- | 1 | SILKSCREEN BOTTOM
- | 1 | DRILL DRAWING
- | 1 | STACK-UP
- | 1 | CIRCUIT BOARD SPECIFICATION

# FILE OROLIA ART_CARD

# Réf PCB :

Angers Technopole | 1 bis Avenue du Bois l’Abbé
49070 BEAUCOUZÉ | FRANCE
Tél. : +33(0)2-41-48-41-40 | Fax : +33(0)2-41-48-41-44
contact@artemis-cad.com | www.artemis-cad.com

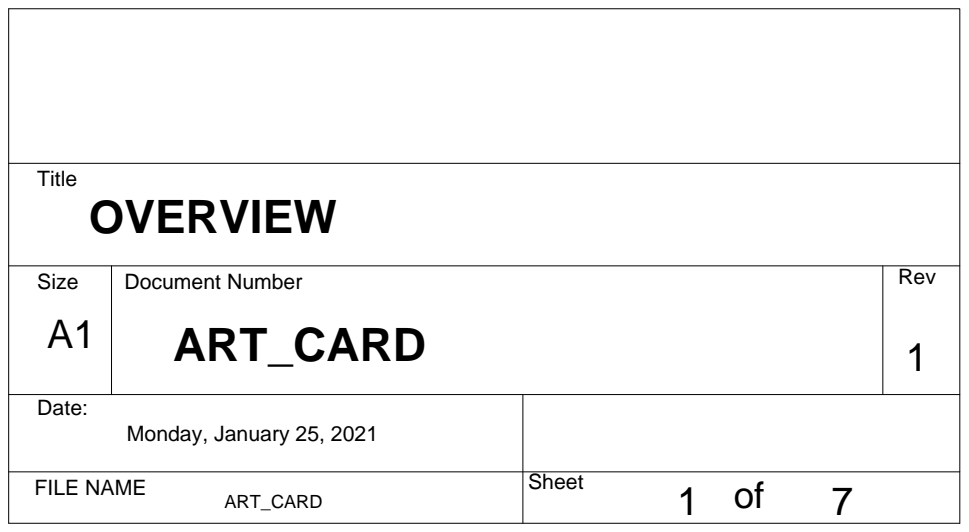
[picture p117: page 2]
Monday, January 25, 2021; ART_CARD; OVERVIEW; Rev; of FILE NAME; Sheet; Date:; Size; Document Number; Title

# VCC Decoupling

# FPGA POWER SUPPLY

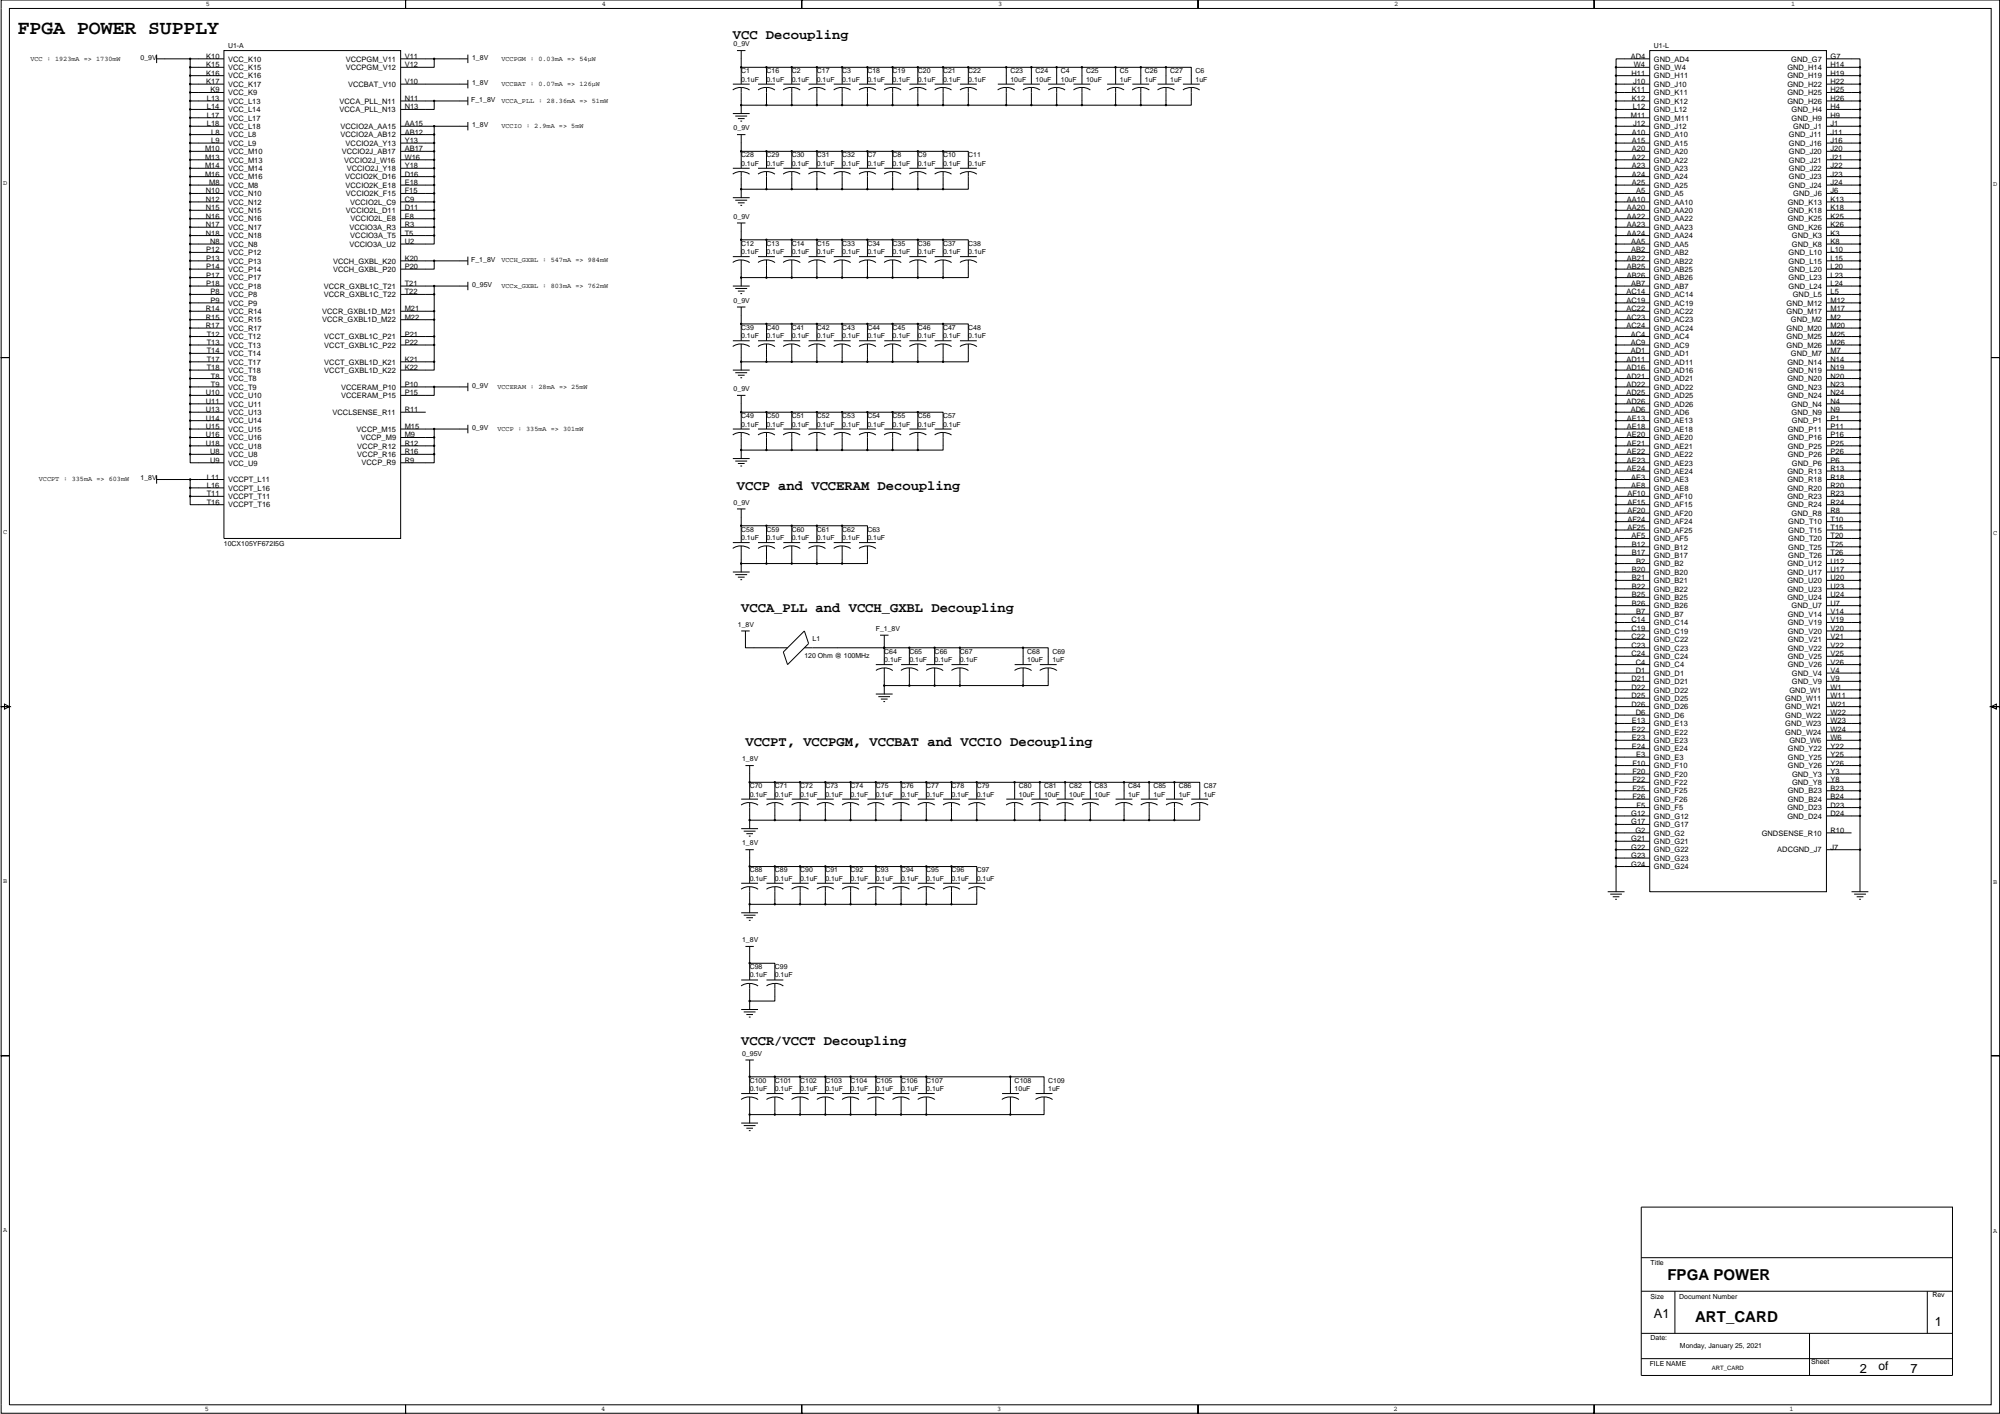
[picture p118: page 3]

VCCP and VCCERAM Decoupling

VCCPT, VCCPGM, VCCBAT and VCCIO Decoupling

# FPGA

W18 IO_2J_47_W18/LVDS2J_1N/DQ16 W19 IO_2J_46_W19/LVDS2J_1P/DQ16 Y21 IO_2J_45_Y21/LVDS2J_2N/DQSN16 AA21 IO_2J_44_AA21/LVDS2J_2P/DQS16 Y19 IO_2J_43_Y19/LVDS2J_3N/DQ16 Y20 IO_2J_42_Y20/LVDS2J_3P/DQ16 W17 IO_2J_41_W17/LVDS2J_4N/DQSN17 Y17 IO_2J_40_Y17/LVDS2J_4P/DQS17 AA17 IO_2J_39_AA17/LVDS2J_5N/DQ17 AB16 IO_2J_38_AB16/LVDS2J_5P/DQ17 Y16 IO_2J_37_Y16/LVDS2J_6N/DQ17 AA16 IO_2J_36_AA16/LVDS2J_6P/DQ17 AB20 IO_2J_35_AB20/LVDS2J_7N/DQ18 AB21 IO_2J_34_AB21/LVDS2J_7P/DQ18 AC20 IO_2J_33_AC20/LVDS2J_8N/DQSN18 AC21 IO_2J_32_AC21/LVDS2J_8P/DQS18 AA18 IO_2J_31_AA18/LVDS2J_9N/DQ18 AB18 IO_2J_30_AB18/LVDS2J_9P/DQ18 AD19 IO_2J_27_AD19/LVDS2J_11N/DQ19 AB15 IO_2J_21_AB15/LVDS2J_14N/DQSN20 AC15 IO_2J_20_AC15/LVDS2J_14P/DQS20 AD17 IO_2J_17_AD17/LVDS2J_16N/DQSN21 AE17 IO_2J_16_AE17/LVDS2J_16P/DQS21 AC16 IO_2J_15_AC16/LVDS2J_17N/DQ21 AC17 IO_2J_14_AC17/LVDS2J_17P/DQ21 AE16 IO_2J_13_AE16/LVDS2J_18N/DQ21 AF16 IO_2J_12_AF16/LVDS2J_18P/DQ21 AE10 IO_2J_11_AE10/LVDS2J_19N/DQ22 AF9 IO_2J_10_AF9/LVDS2J_19P/DQ22 AF12 IO_2J_9_AF12/LVDS2J_20N/DQSN22 AF11 IO_2J_8_AF11/LVDS2J_20P/DQS22 AE15 IO_2J_7_AE15/LVDS2J_21N/DQ22 AE14 IO_2J_6_AE14/LVDS2J_21P/DQ22 AD15 IO_2J_5_AD15/LVDS2J_22N/DQSN23 AD14 IO_2J_4_AD14/LVDS2J_22P/DQS23 AE12 IO_2J_3_AE12/LVDS2J_23N/DQ23 AE11 IO_2J_2_AE11/LVDS2J_23P/DQ23 AF13 IO_2J_1_AF13/LVDS2J_24N/DQ23 AF14 IO_2J_0_AF14/LVDS2J_24P/DQ23

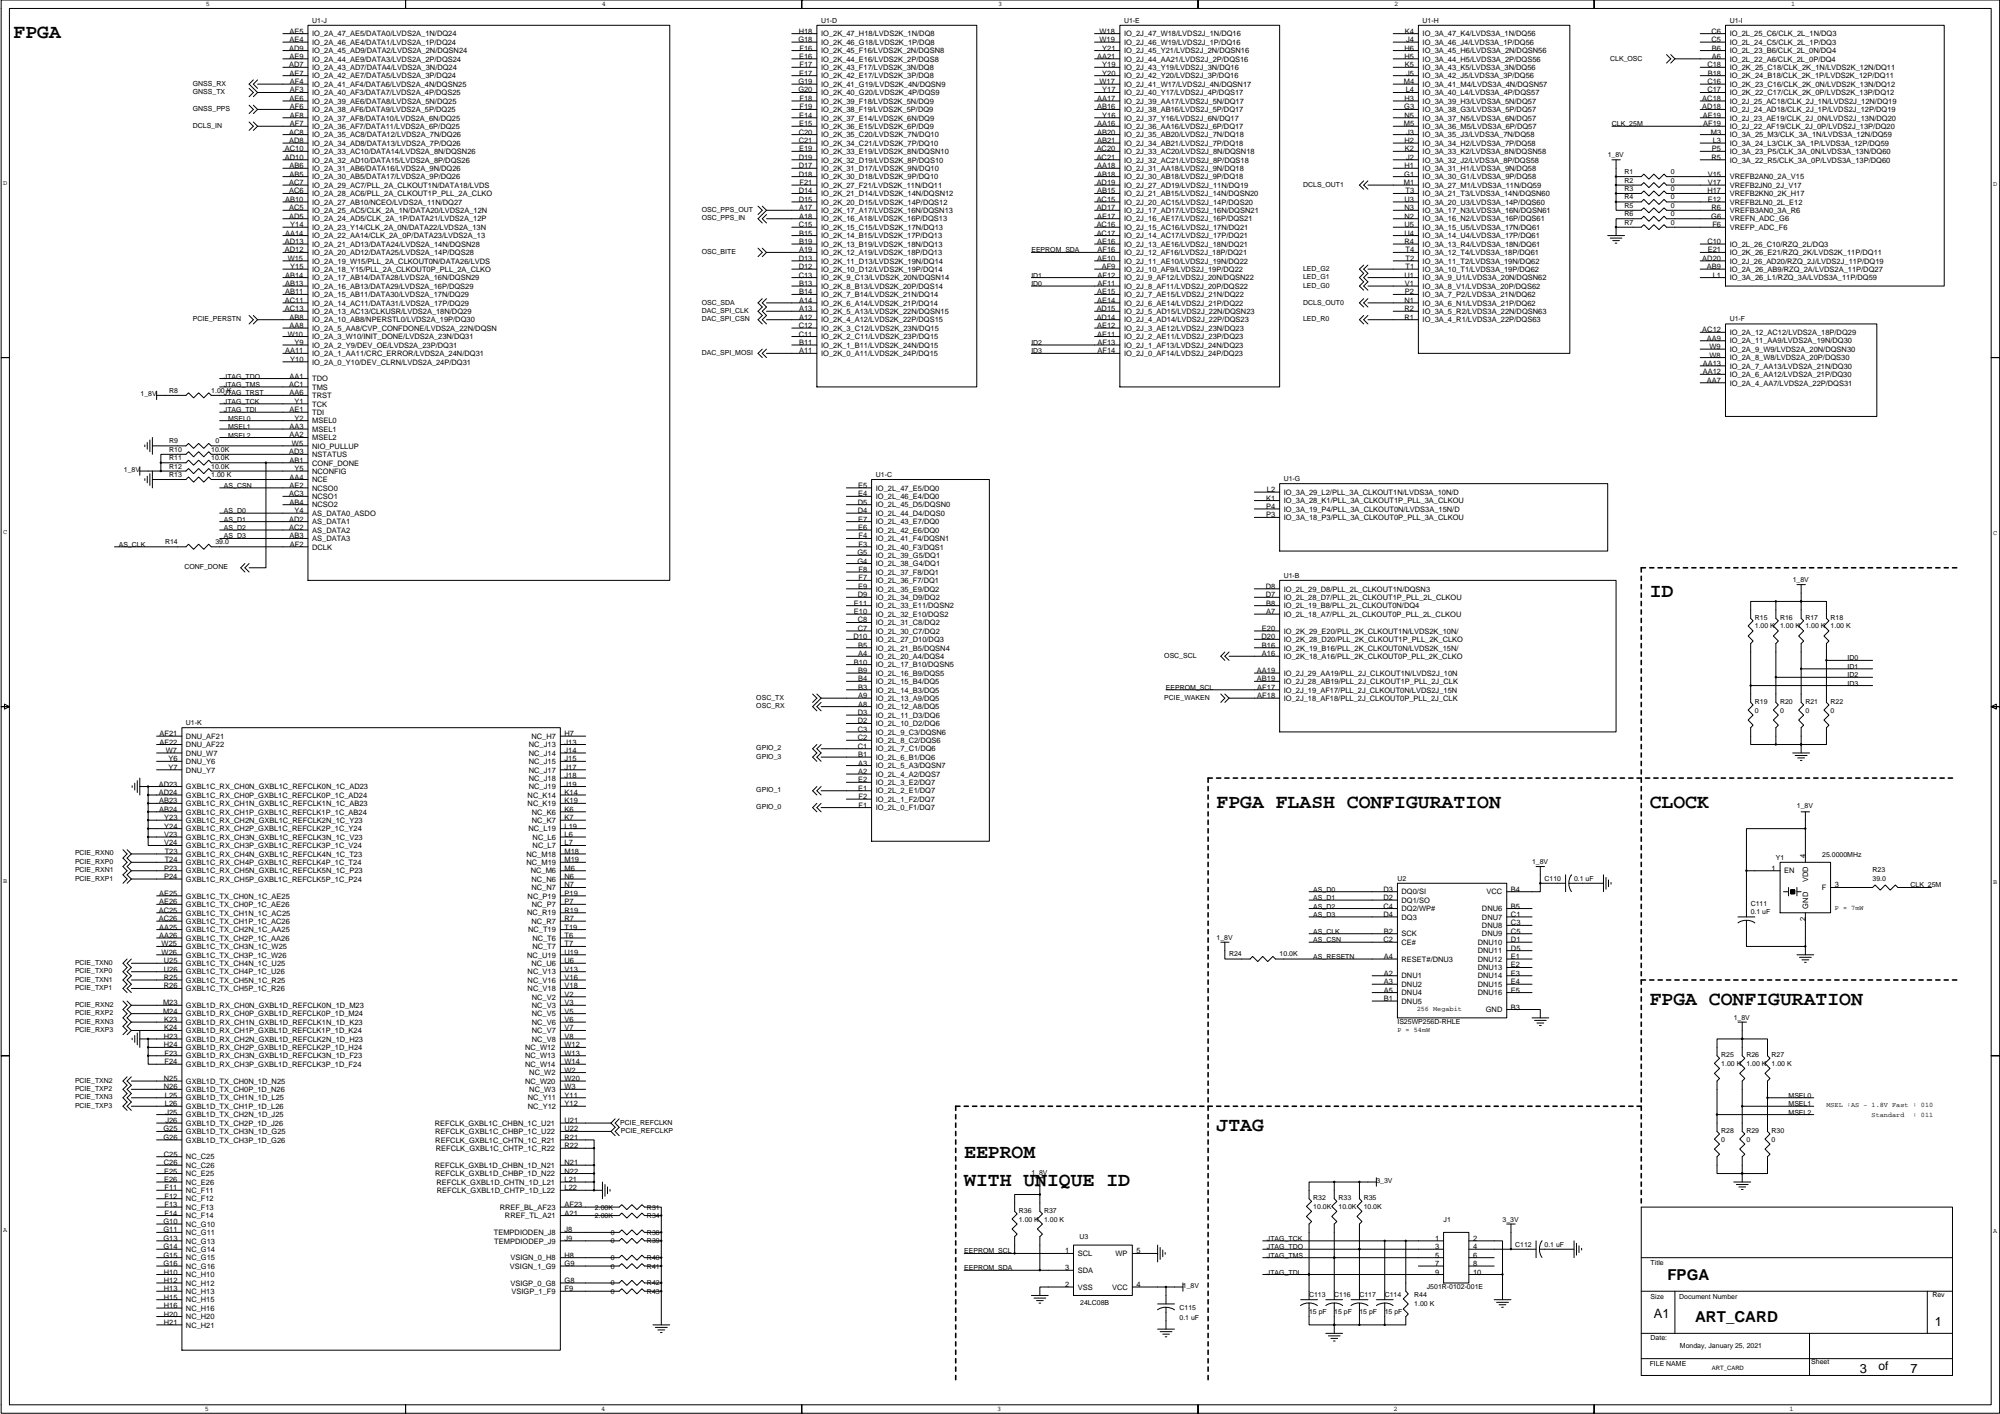
[picture p119: page 4]

AE5 IO_2A_47_AE5/DATA0/LVDS2A_1N/DQ24 AE4 IO_2A_46_AE4/DATA1/LVDS2A_1P/DQ24 AD9 IO_2A_45_AD9/DATA2/LVDS2A_2N/DQSN24 AE9 IO_2A_44_AE9/DATA3/LVDS2A_2P/DQS24 AD7 IO_2A_43_AD7/DATA4/LVDS2A_3N/DQ24 AE7 IO_2A_42_AE7/DATA5/LVDS2A_3P/DQ24 AF4 IO_2A_41_AF4/DATA6/LVDS2A_4N/DQSN25 AF3 IO_2A_40_AF3/DATA7/LVDS2A_4P/DQS25 AE6 IO_2A_39_AE6/DATA8/LVDS2A_5N/DQ25 AF6 IO_2A_38_AF6/DATA9/LVDS2A_5P/DQ25 AF8 IO_2A_37_AF8/DATA10/LVDS2A_6N/DQ25 AF7 IO_2A_36_AF7/DATA11/LVDS2A_6P/DQ25 AC8 IO_2A_35_AC8/DATA12/LVDS2A_7N/DQ26 AD8 IO_2A_34_AD8/DATA13/LVDS2A_7P/DQ26 AC10 IO_2A_33_AC10/DATA14/LVDS2A_8N/DQSN26 AD10 IO_2A_32_AD10/DATA15/LVDS2A_8P/DQS26 AB6 IO_2A_31_AB6/DATA16/LVDS2A_9N/DQ26 AB5 IO_2A_30_AB5/DATA17/LVDS2A_9P/DQ26 AC7 IO_2A_29_AC7/PLL_2A_CLKOUT1N/DATA18/LVDS AC6 IO_2A_28_AC6/PLL_2A_CLKOUT1P_PLL_2A_CLKO AB10 IO_2A_27_AB10/NCEO/LVDS2A_11N/DQ27 AC5 IO_2A_25_AC5/CLK_2A_1N/DATA20/LVDS2A_12N AD5 IO_2A_24_AD5/CLK_2A_1P/DATA21/LVDS2A_12P Y14 IO_2A_23_Y14/CLK_2A_0N/DATA22/LVDS2A_13N AA14 IO_2A_22_AA14/CLK_2A_0P/DATA23/LVDS2A_13 AD13 IO_2A_21_AD13/DATA24/LVDS2A_14N/DQSN28 AD12 IO_2A_20_AD12/DATA25/LVDS2A_14P/DQS28 W15 IO_2A_19_W15/PLL_2A_CLKOUT0N/DATA26/LVDS Y15 IO_2A_18_Y15/PLL_2A_CLKOUT0P_PLL_2A_CLKO AB14 IO_2A_17_AB14/DATA28/LVDS2A_16N/DQSN29 AB13 IO_2A_16_AB13/DATA29/LVDS2A_16P/DQS29 AB11 IO_2A_15_AB11/DATA30/LVDS2A_17N/DQ29 AC11 IO_2A_14_AC11/DATA31/LVDS2A_17P/DQ29 AC13 IO_2A_13_AC13/CLKUSR/LVDS2A_18N/DQ29 AB8 IO_2A_10_AB8/NPERSTL0/LVDS2A_19P/DQ30 AA8 IO_2A_5_AA8/CVP_CONFDONE/LVDS2A_22N/DQSN W10 IO_2A_3_W10/INIT_DONE/LVDS2A_23N/DQ31 Y9 IO_2A_2_Y9/DEV_OE/LVDS2A_23P/DQ31 AA11 IO_2A_1_AA11/CRC_ERROR/LVDS2A_24N/DQ31 Y10 IO_2A_0_Y10/DEV_CLRN/LVDS2A_24P/DQ31

## 10mV Ripple Voltage Max

## POWER NEED : FPGA : OCXO : Comp : TOTAL

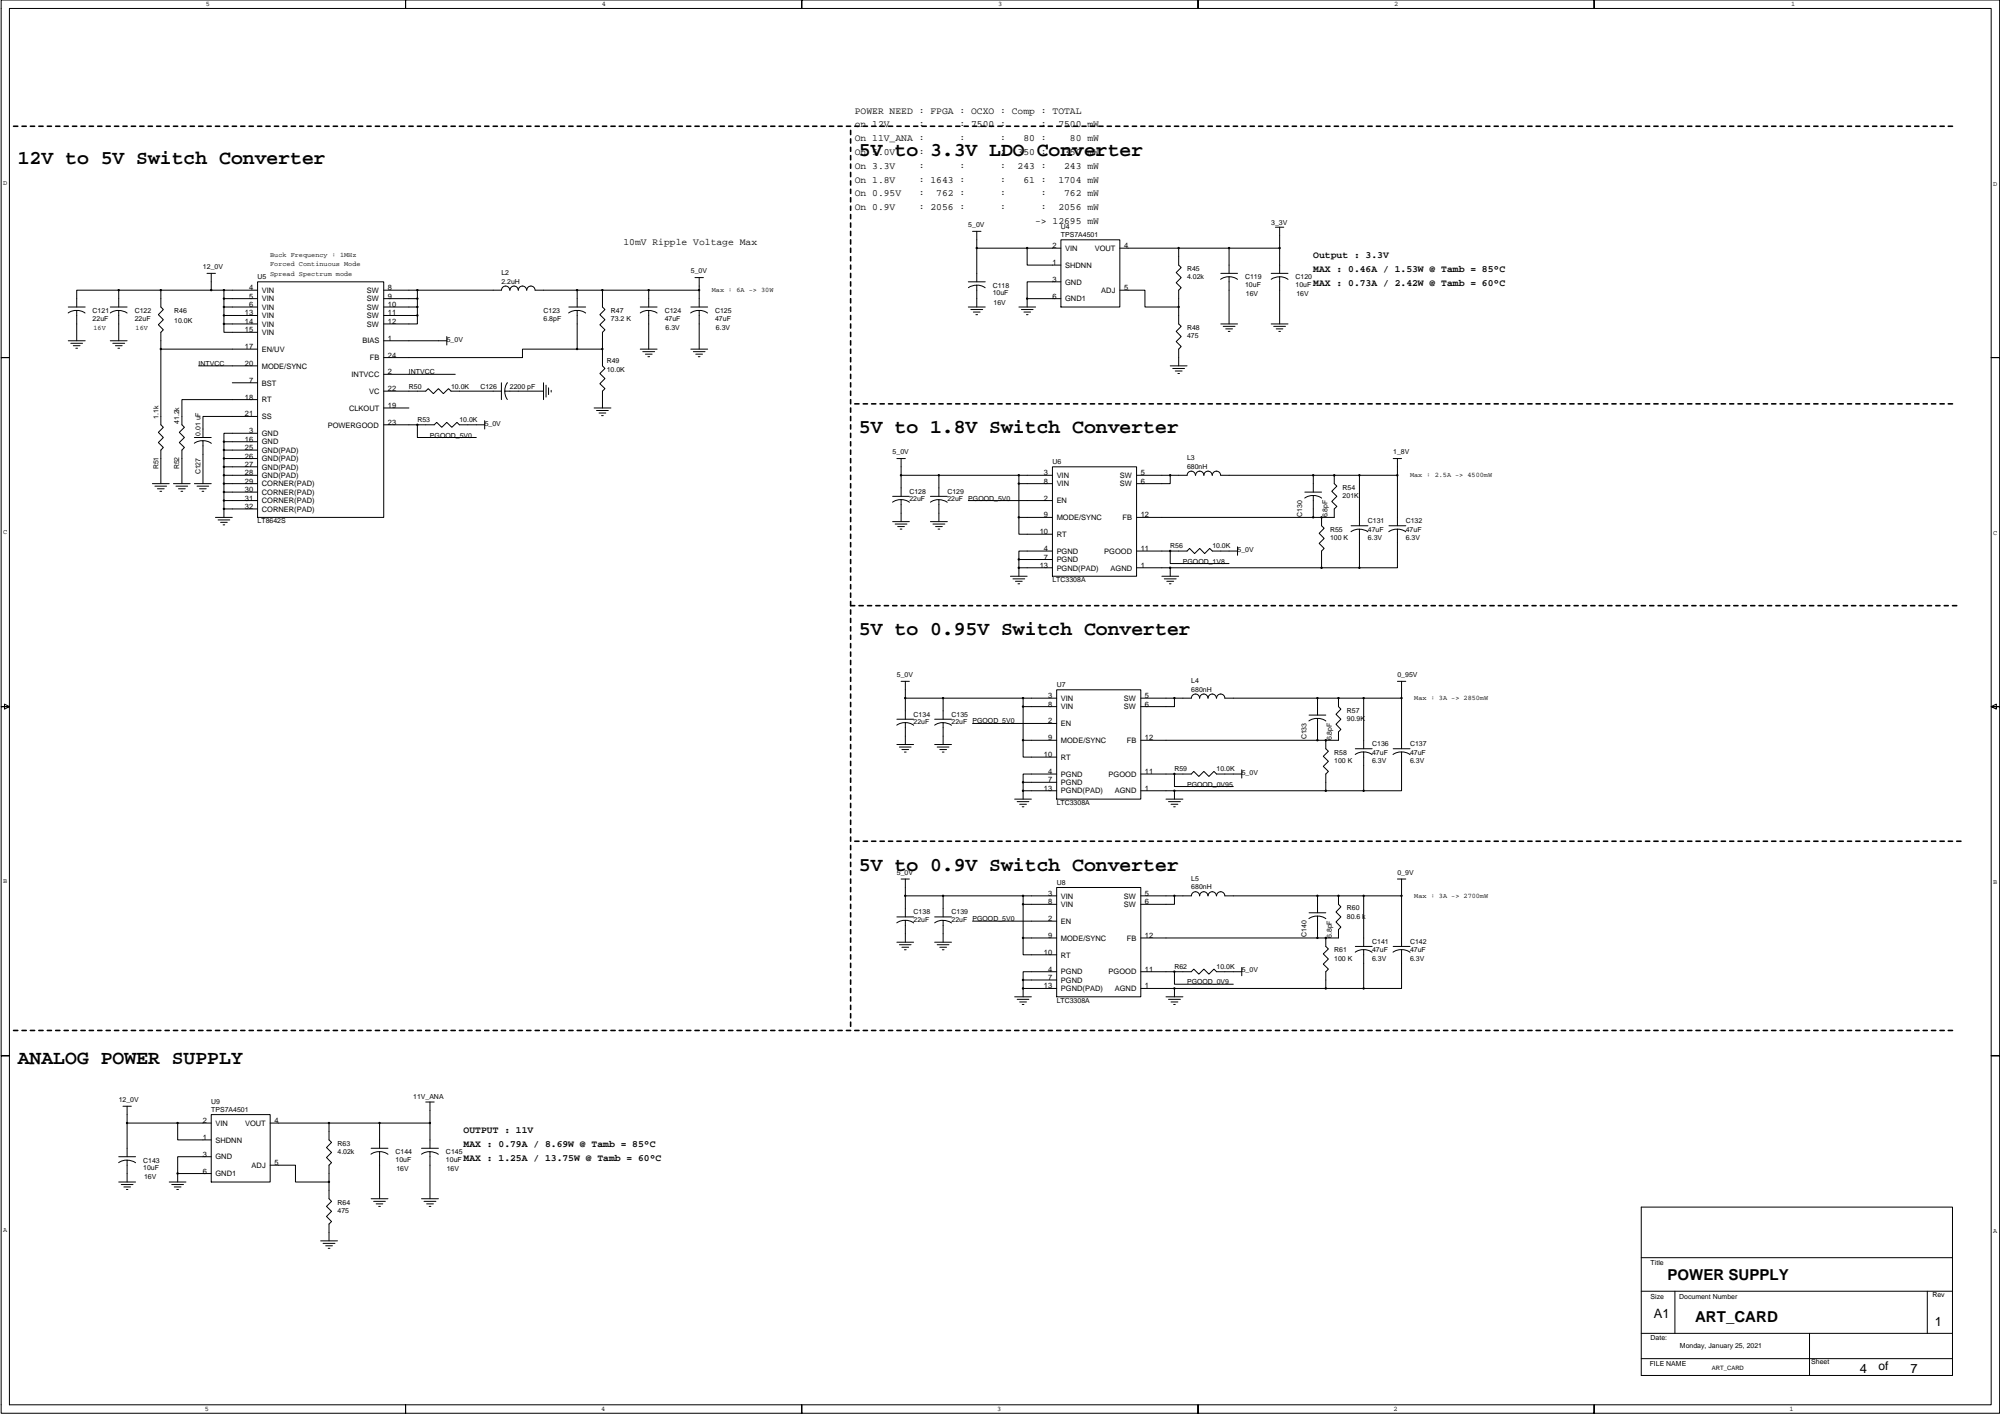
[picture p120: page 5]

3 GND
16 GND
25 GND(PAD) 26 GND(PAD) 27 GND(PAD) 28 GND(PAD) 29 CORNER(PAD) 30 CORNER(PAD) 31 CORNER(PAD) 32 CORNER(PAD)

# MiniRubidium

# OSCILLATOR POWER SUPPLY

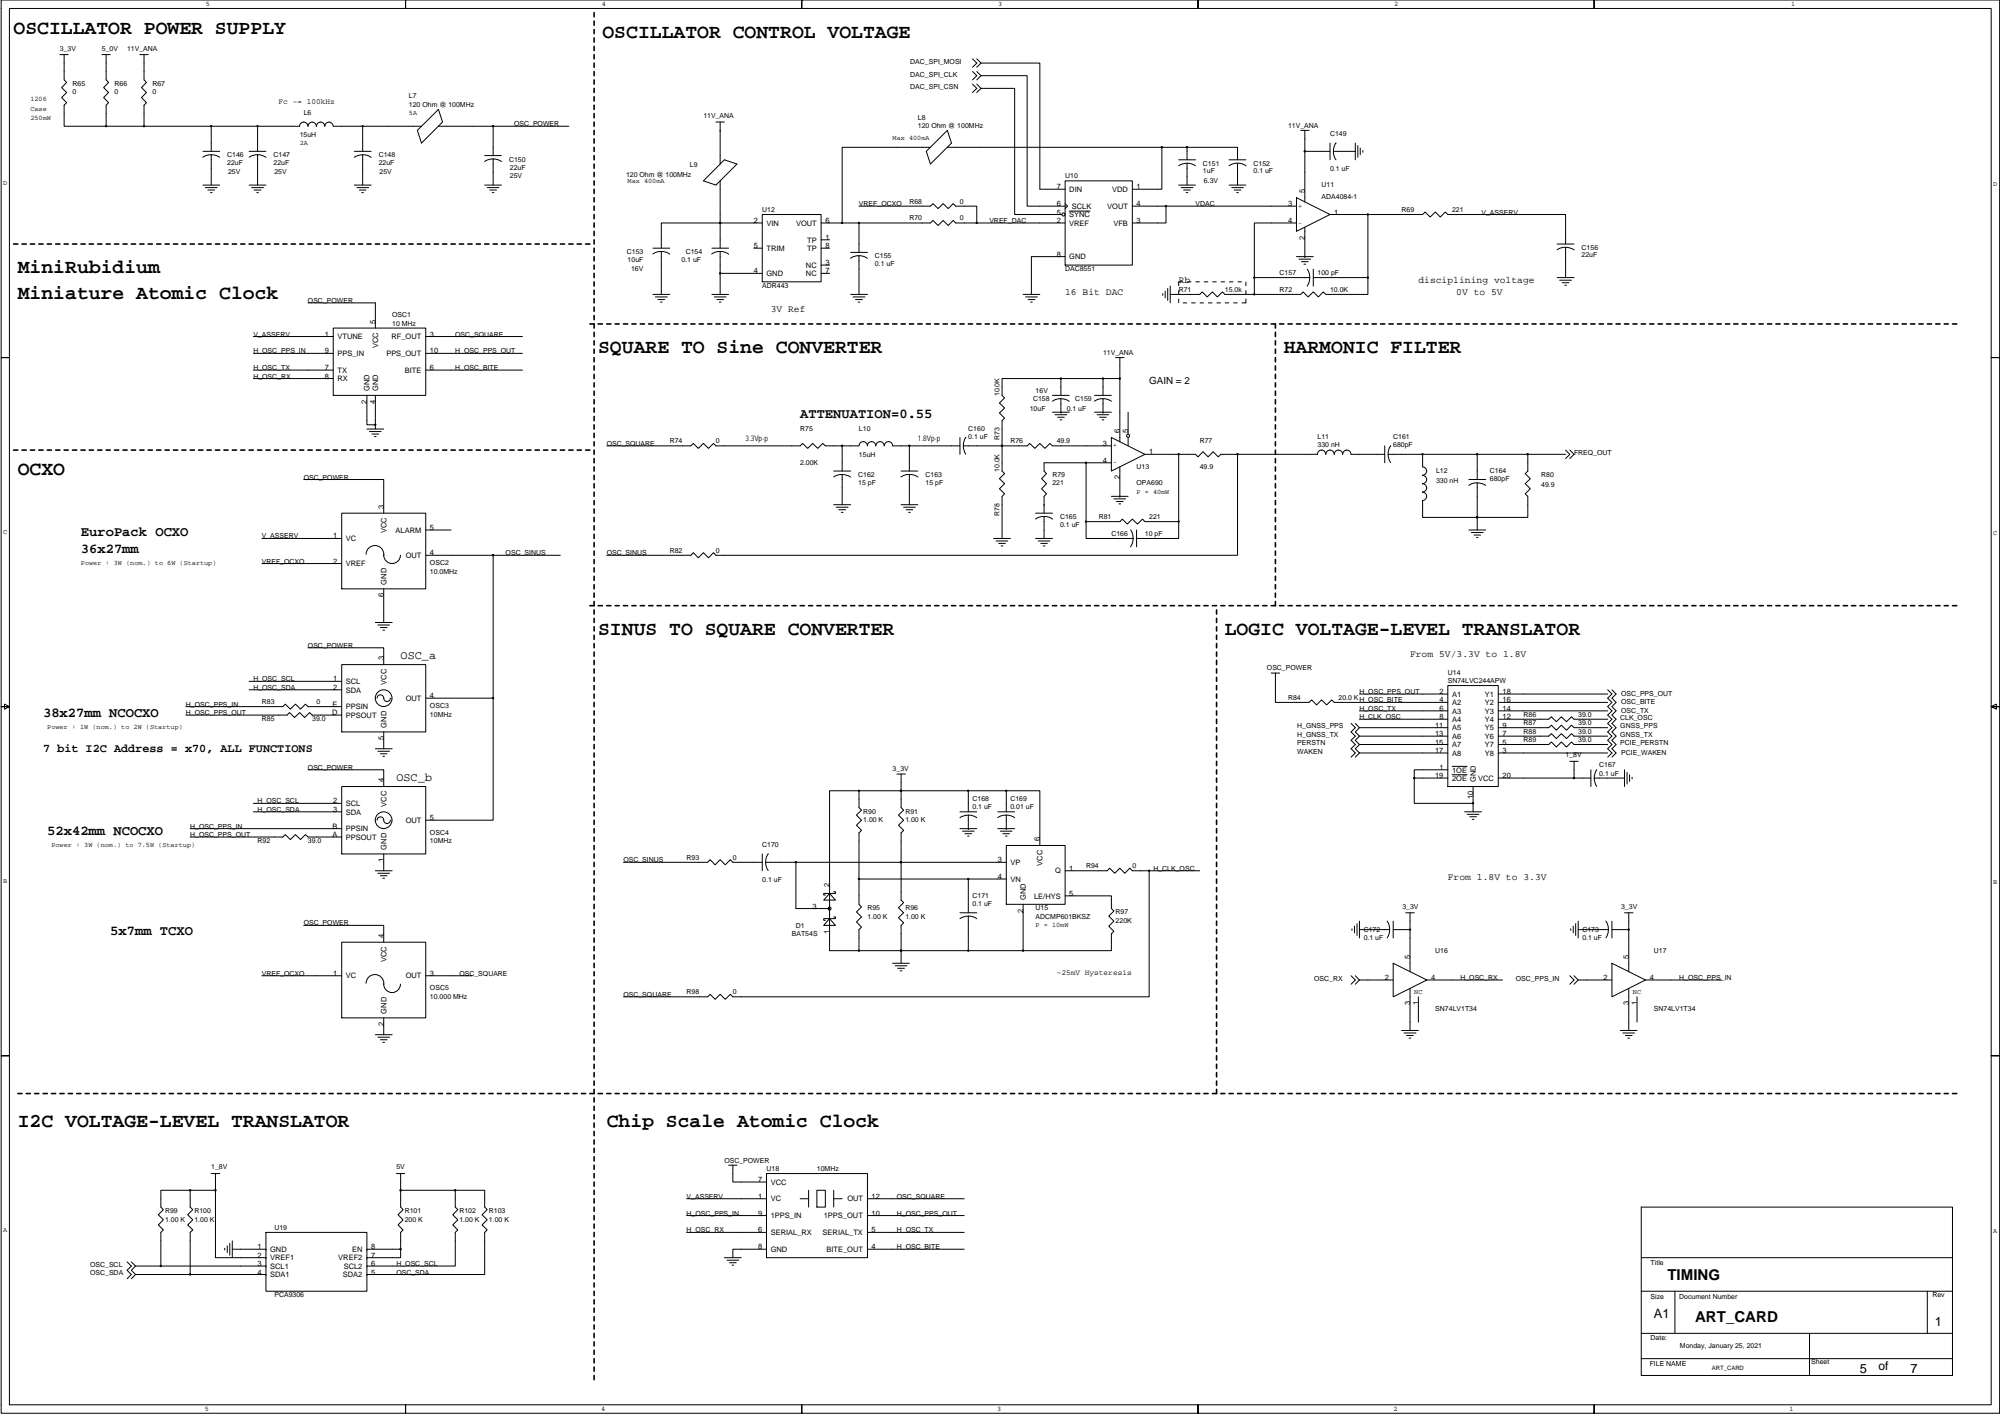
[picture p121: page 6]

SQUARE TO Sine CONVERTER

Power : 3W (nom.) to 6W (Startup)

Power : 1W (nom.) to 2W (Startup)
7 bit I2C Address = x70, ALL FUNCTIONS

Power : 3W (nom.) to 7.5W (Startup)

Chip Scale Atomic Clock

ANTENNA POWER SUPPLY | GNSS RECEIVER | GNSS STANDOFF

## From 1.8V to 3.3V

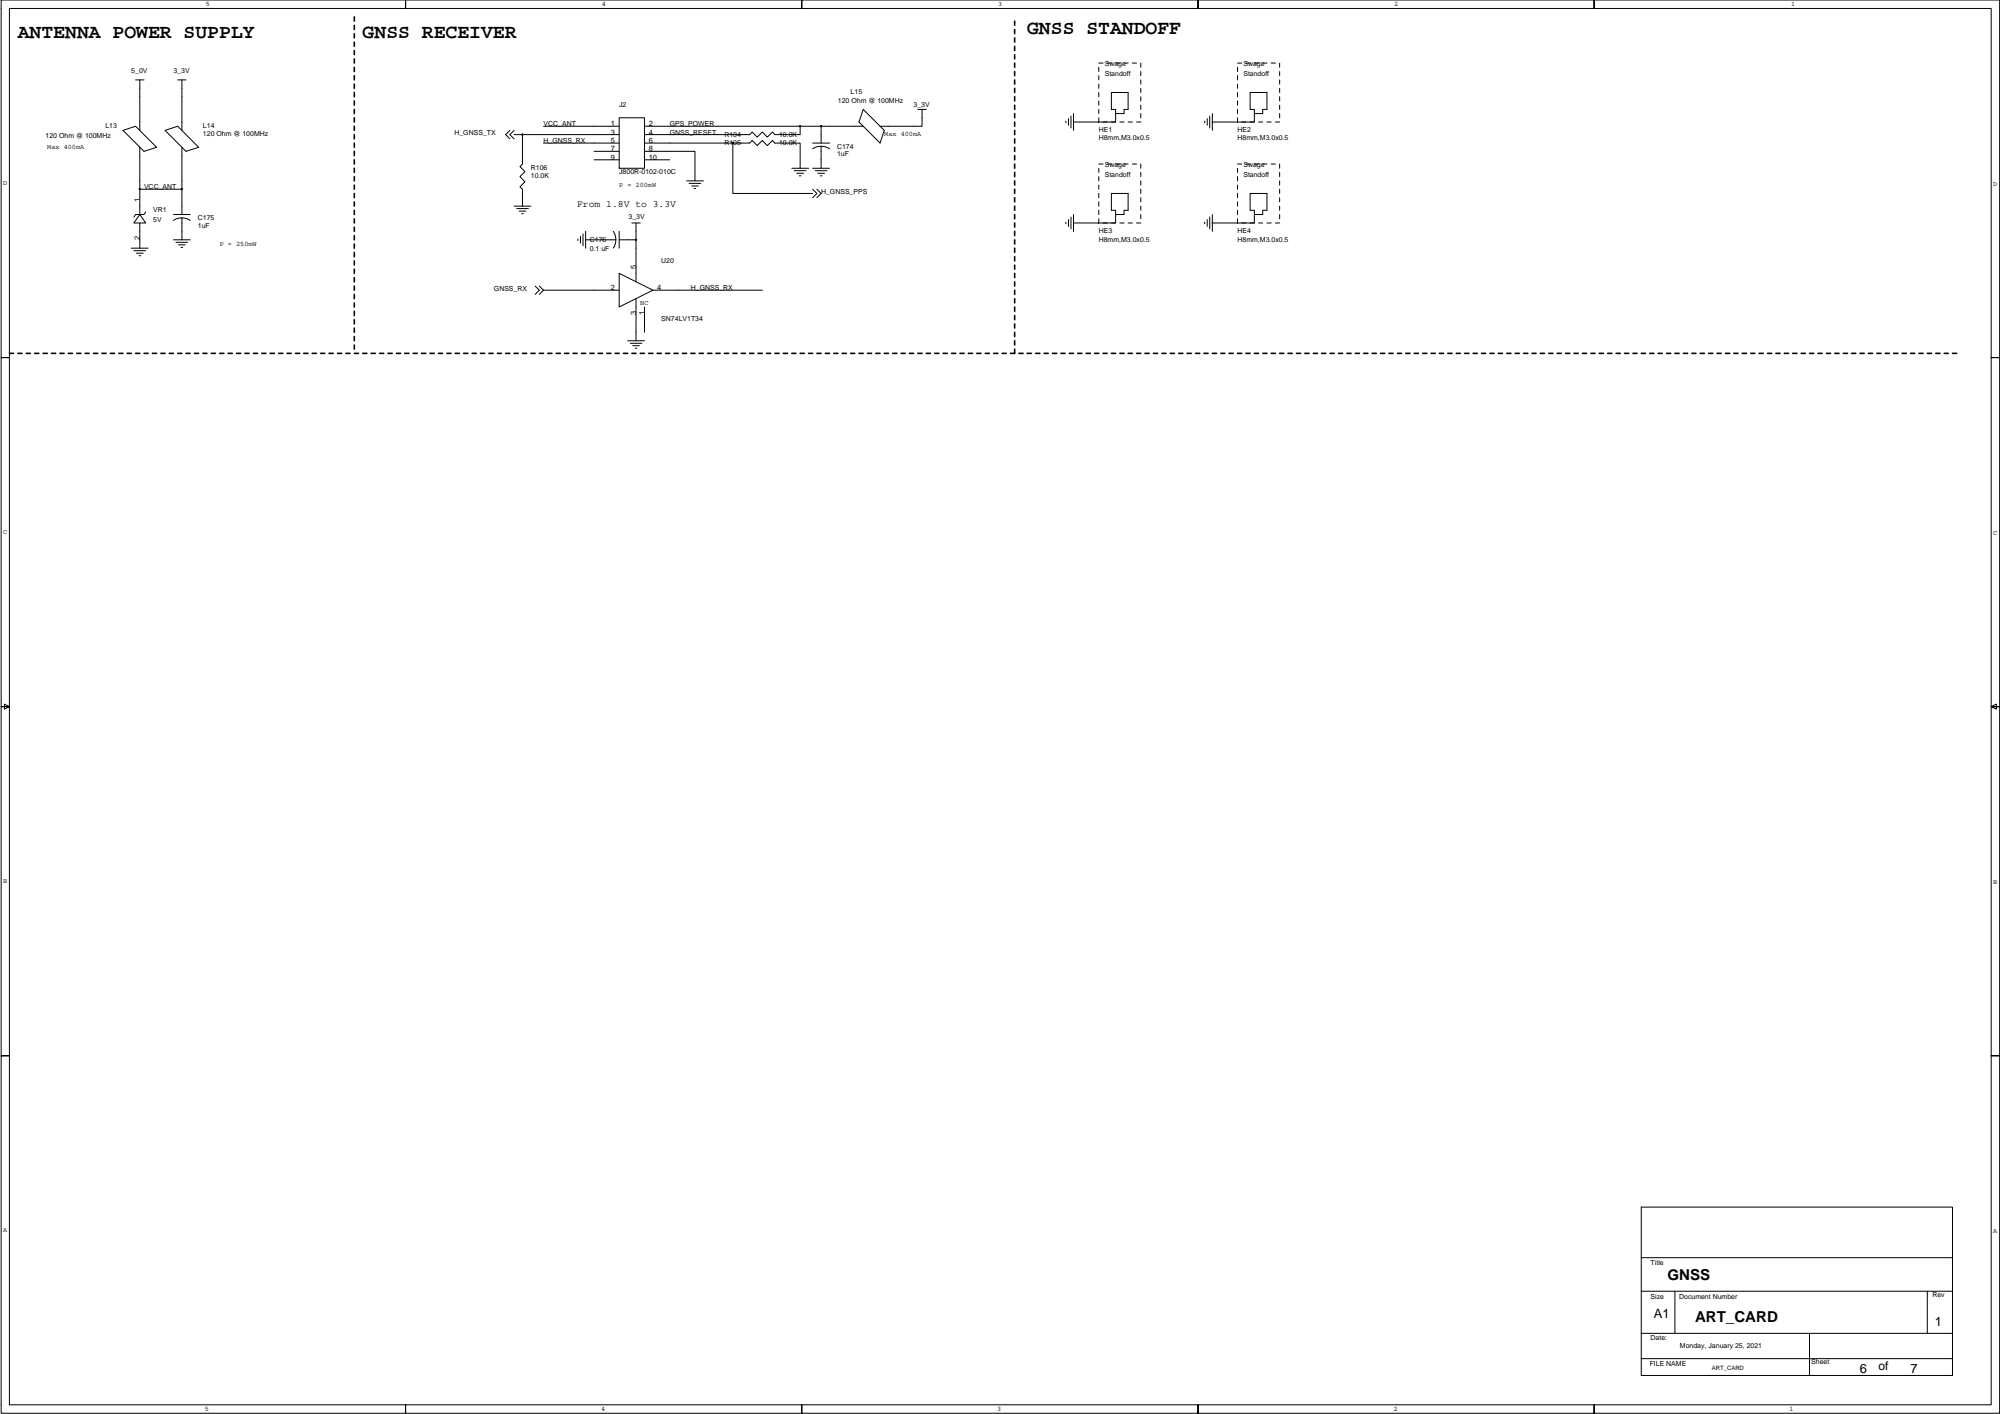
[picture p122: page 7]

# 10MHZ OSC Buffer Driver

## Ra is 124 ohms GAIN = 2.8

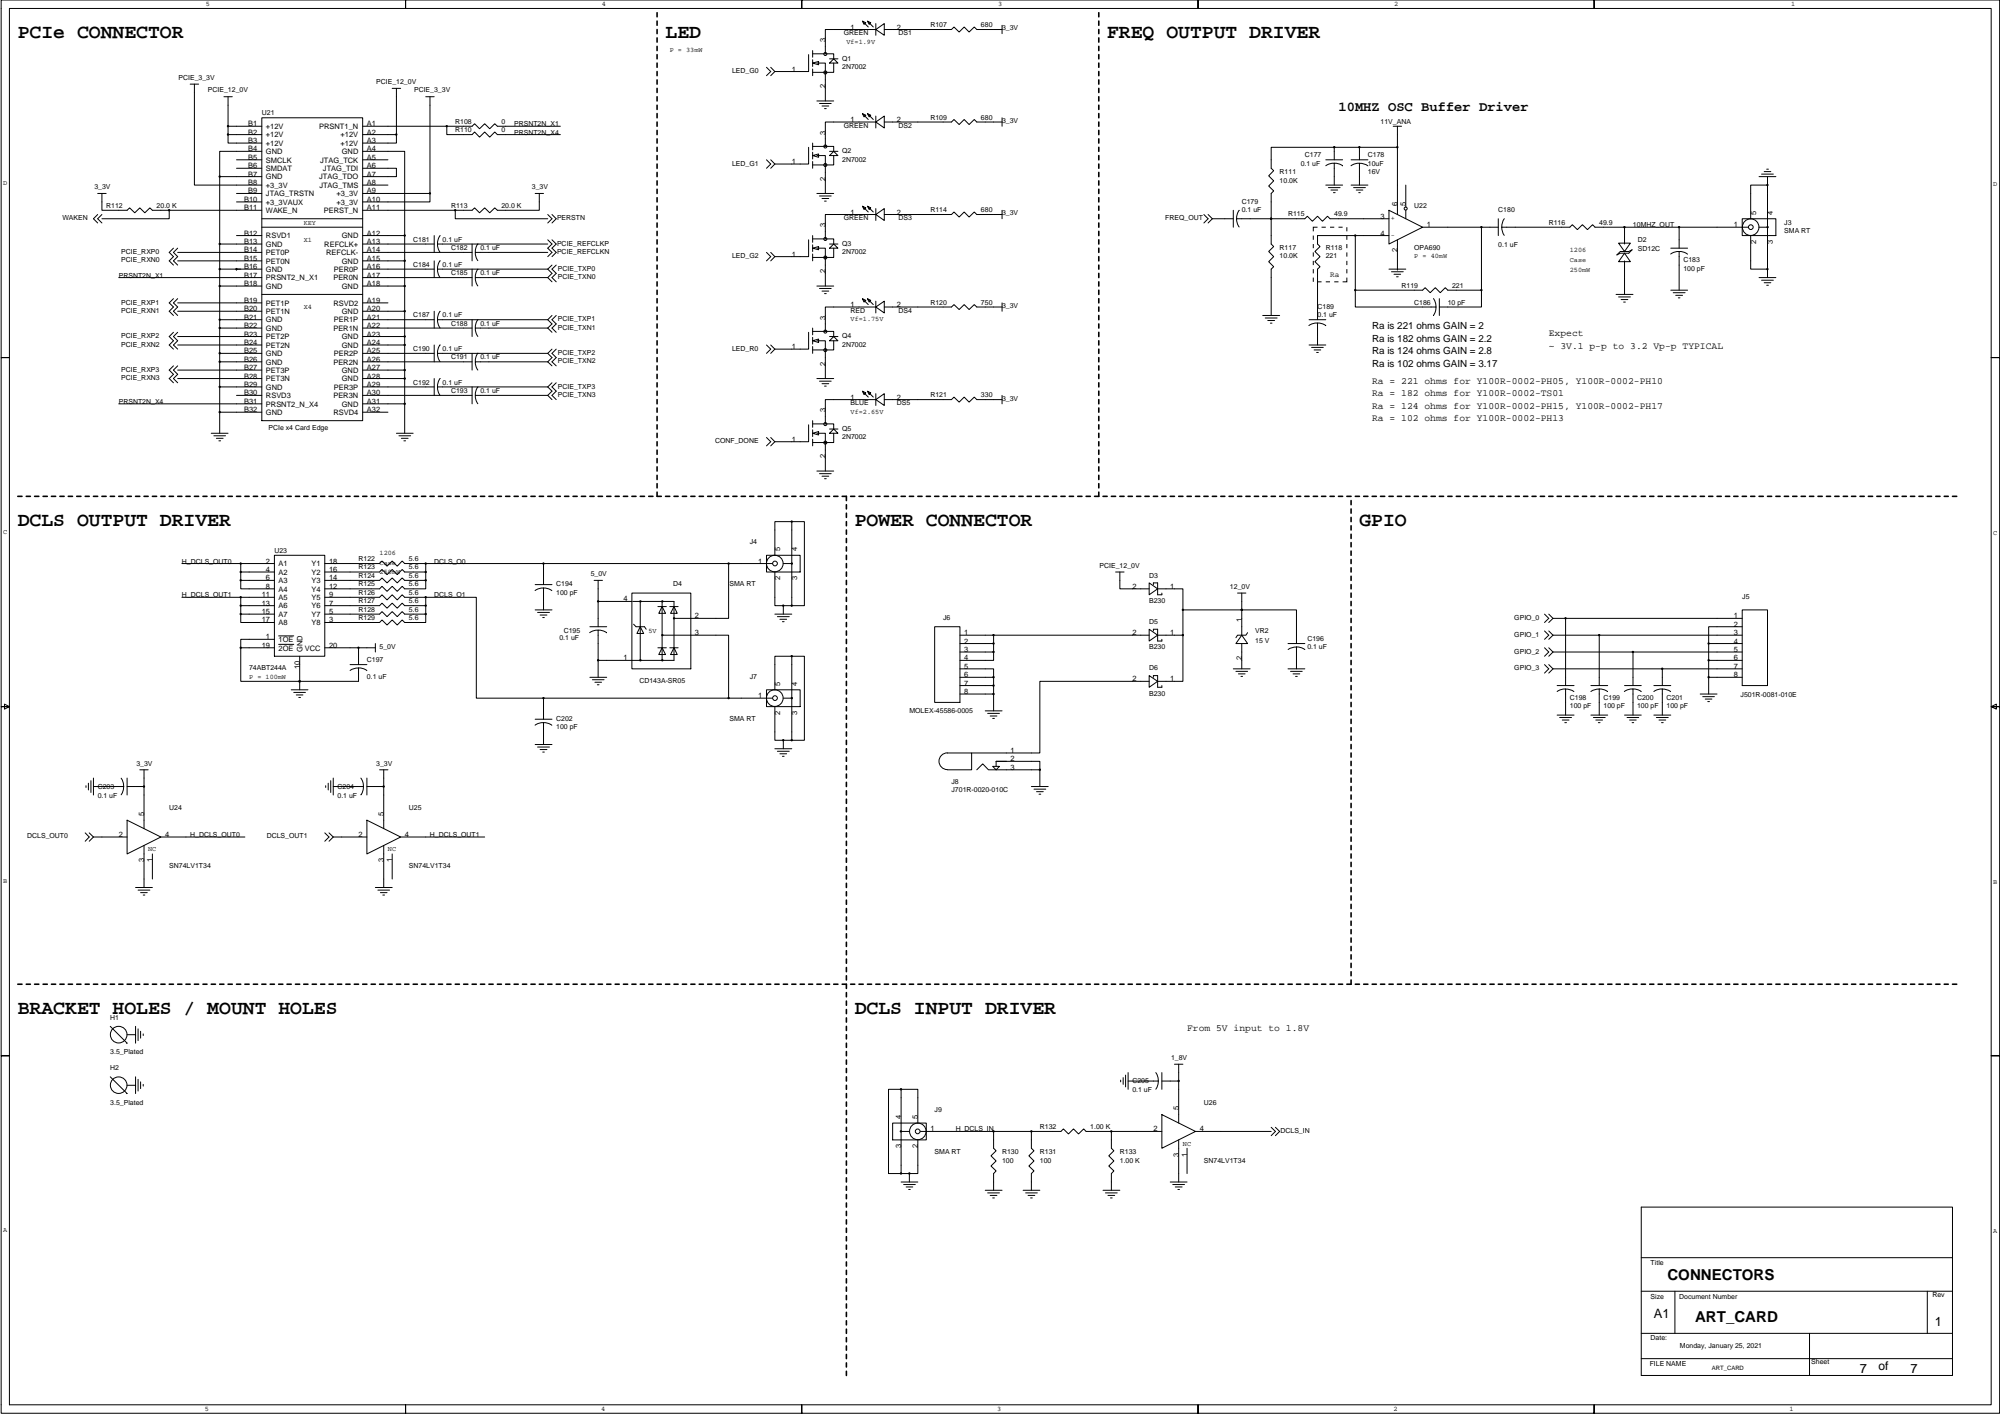
[picture p123: page 8]

Ra is 221 ohms GAIN = 2

Ra is 102 ohms GAIN = 3.17
Ra = 221 ohms for Y100R-0002-PH05, Y100R-0002-PH10
Ra = 182 ohms for Y100R-0002-TS01
Ra = 124 ohms for Y100R-0002-PH15, Y100R-0002-PH17
Ra = 102 ohms for Y100R-0002-PH13

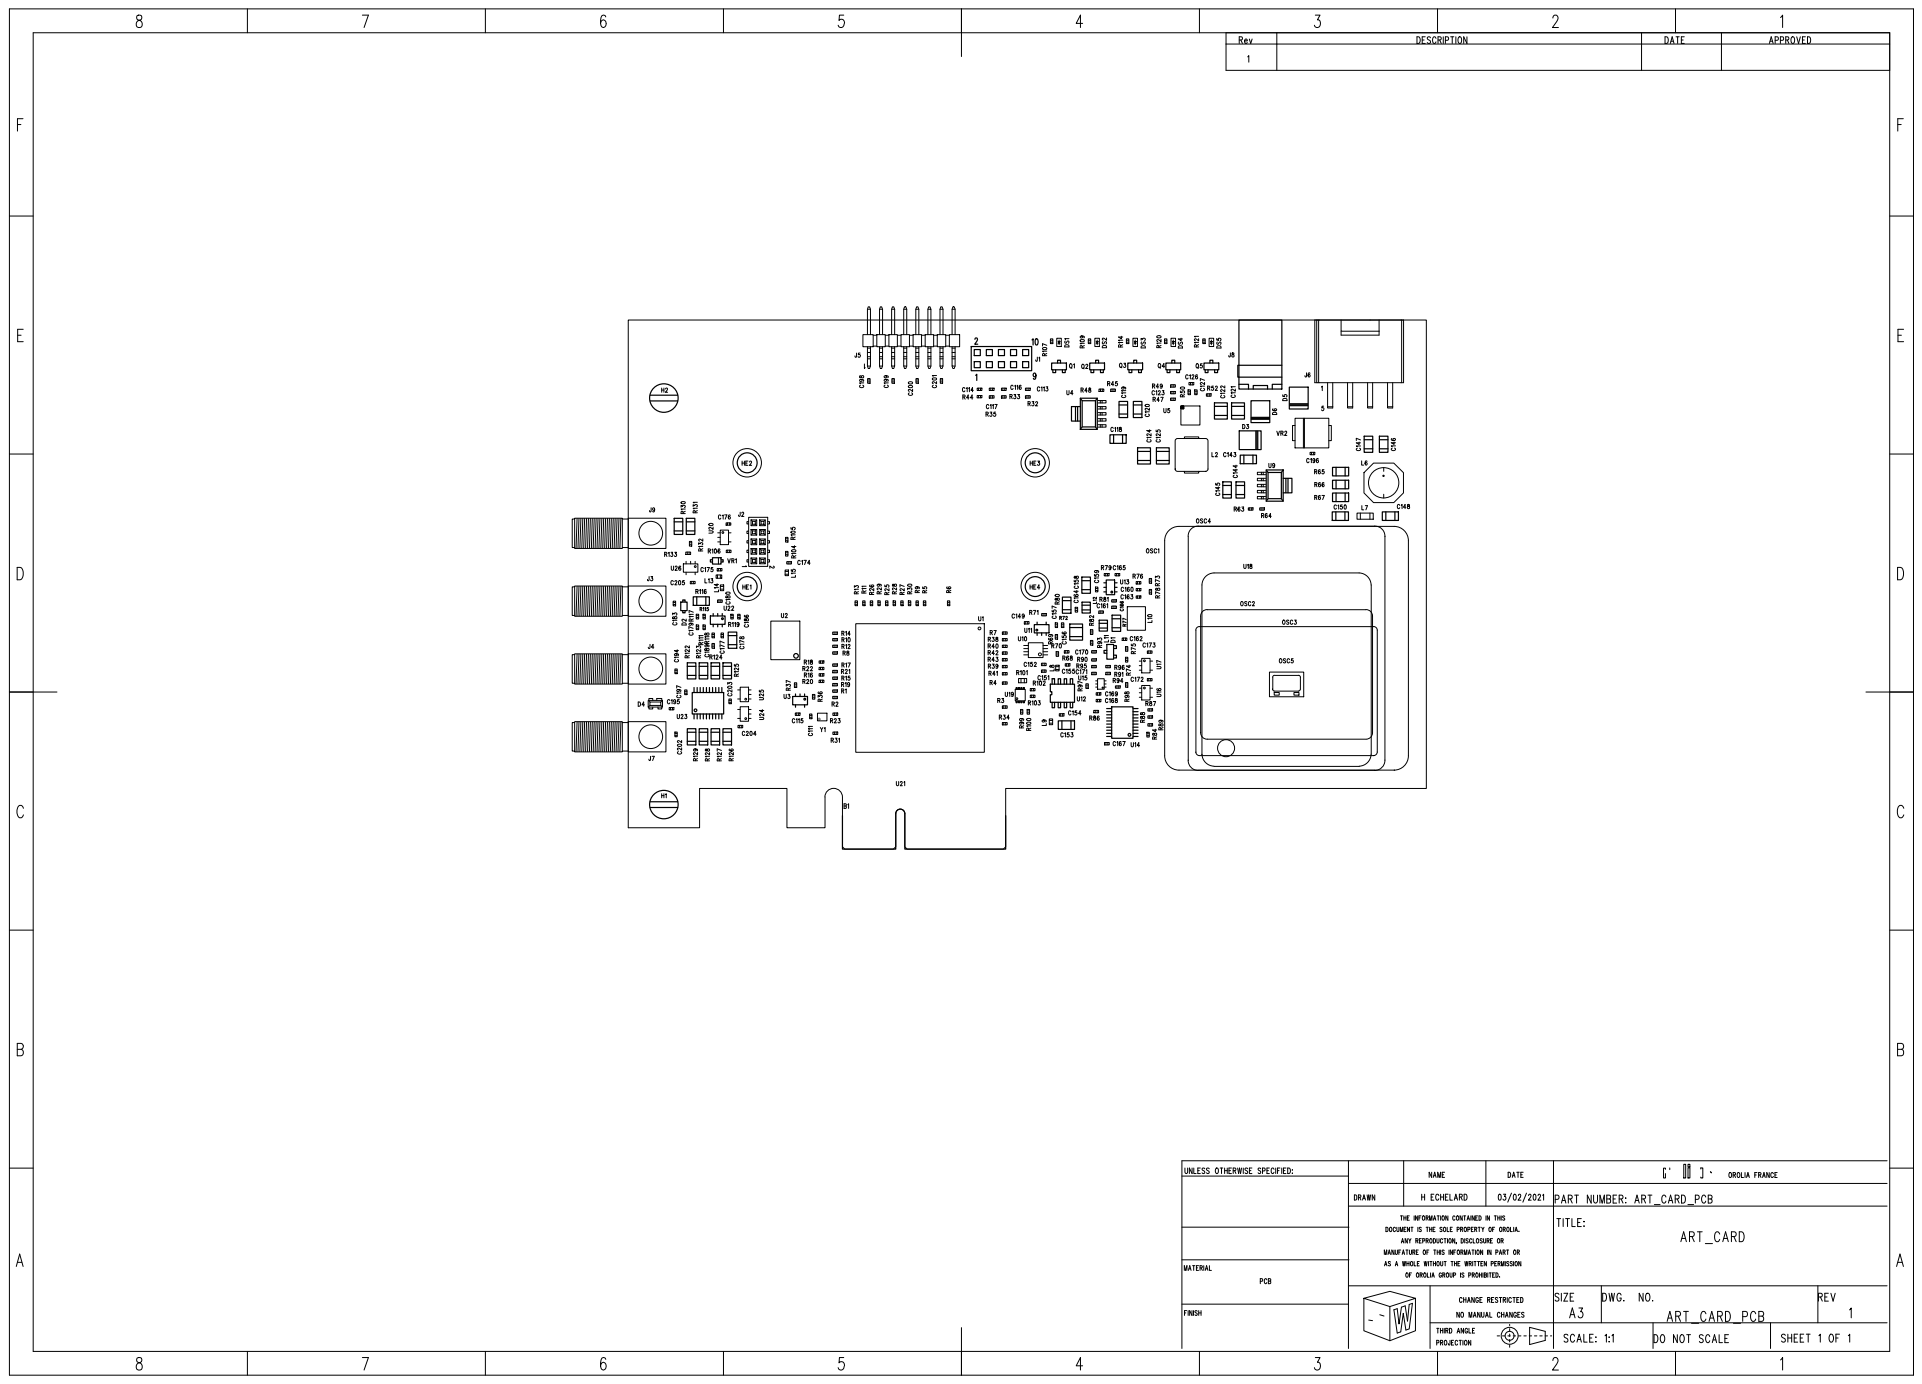
[picture p124: page 9]

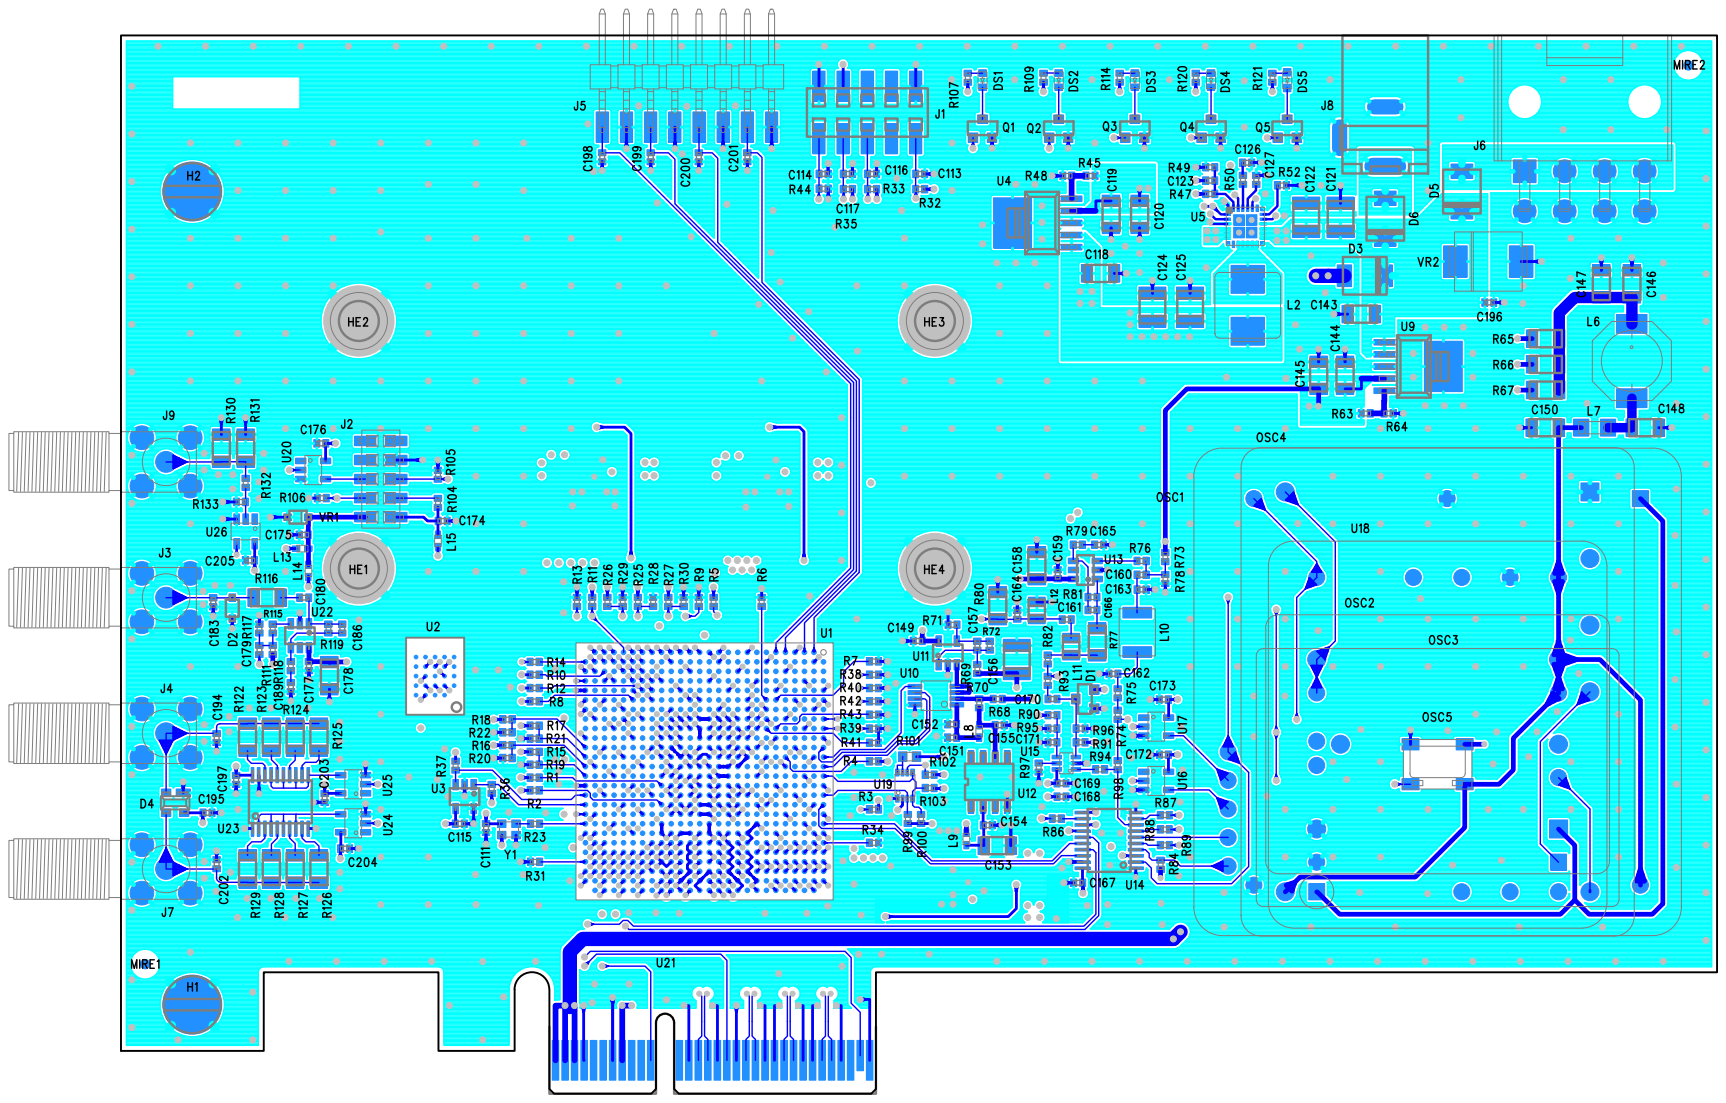
[picture p125: page 10]

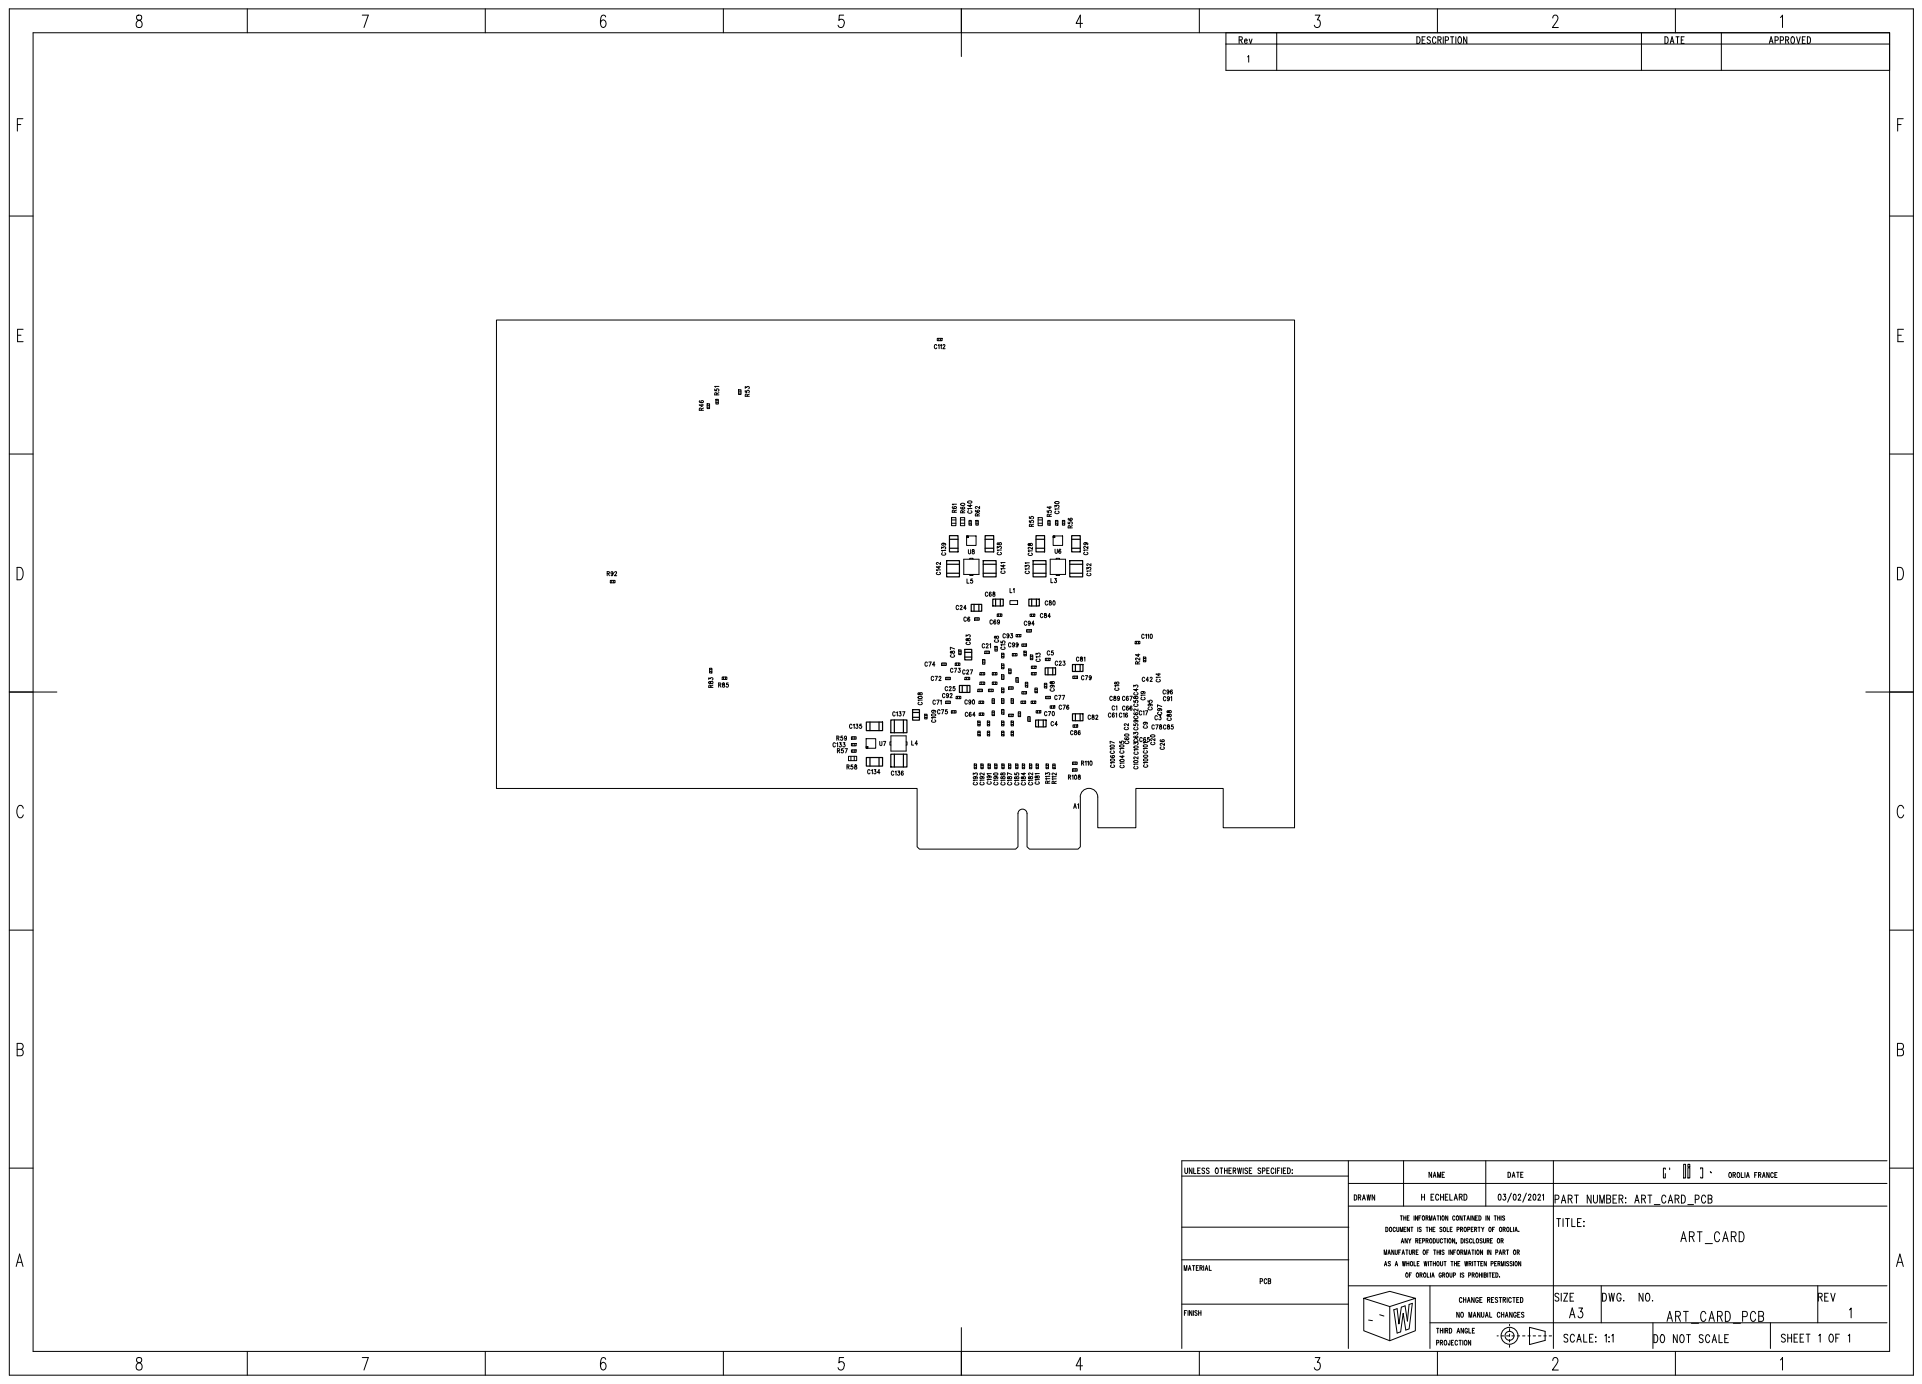
[picture p126: page 11]

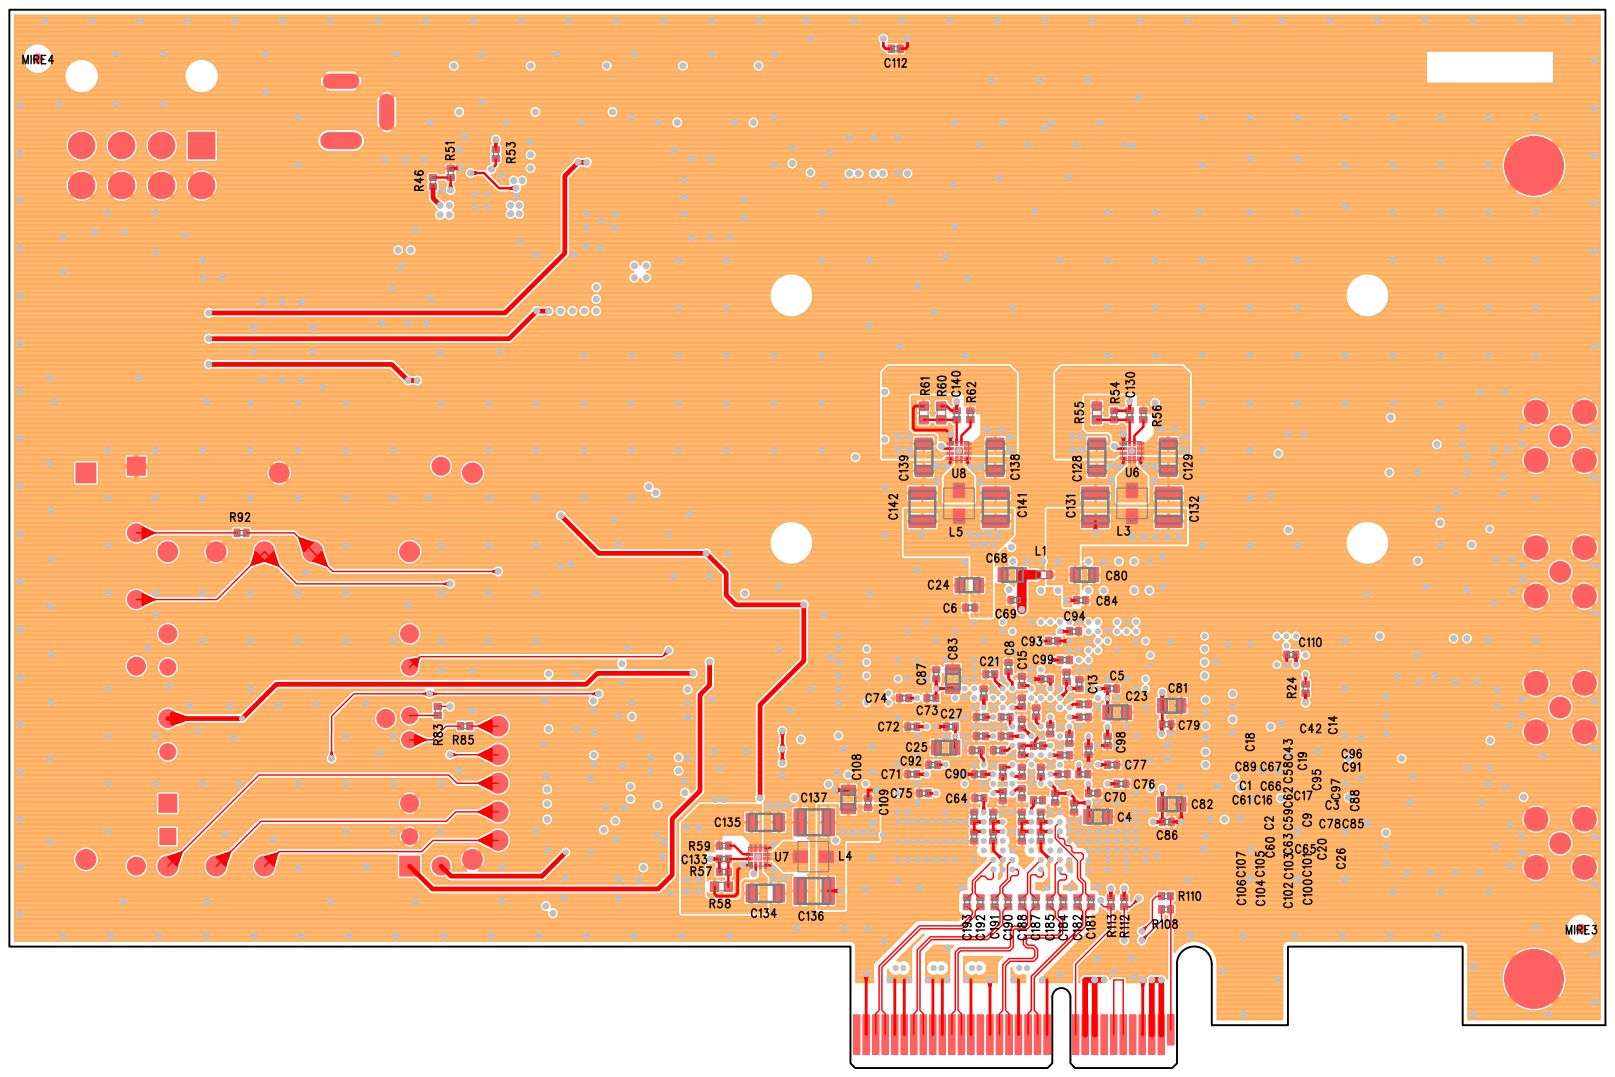
[picture p127: page 12]

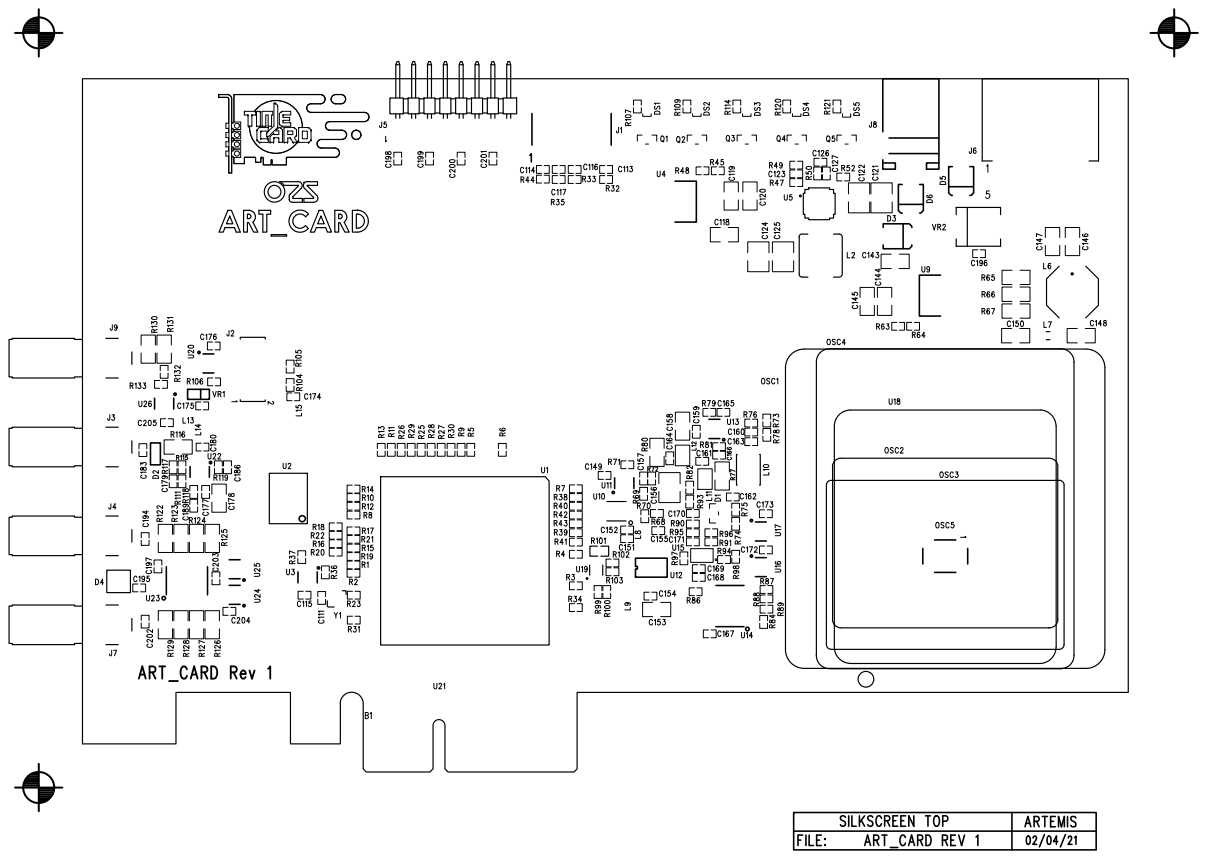
[picture p128: page 13]

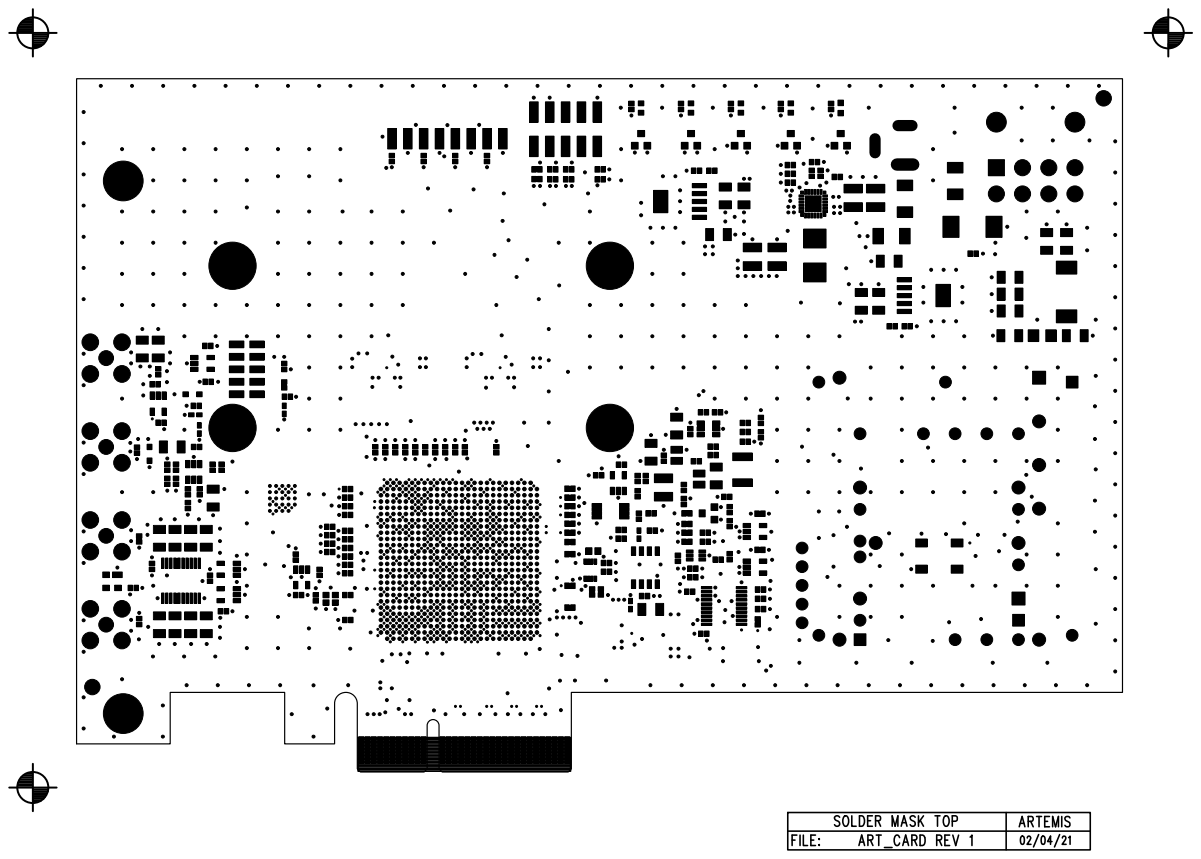
[picture p129: page 14]

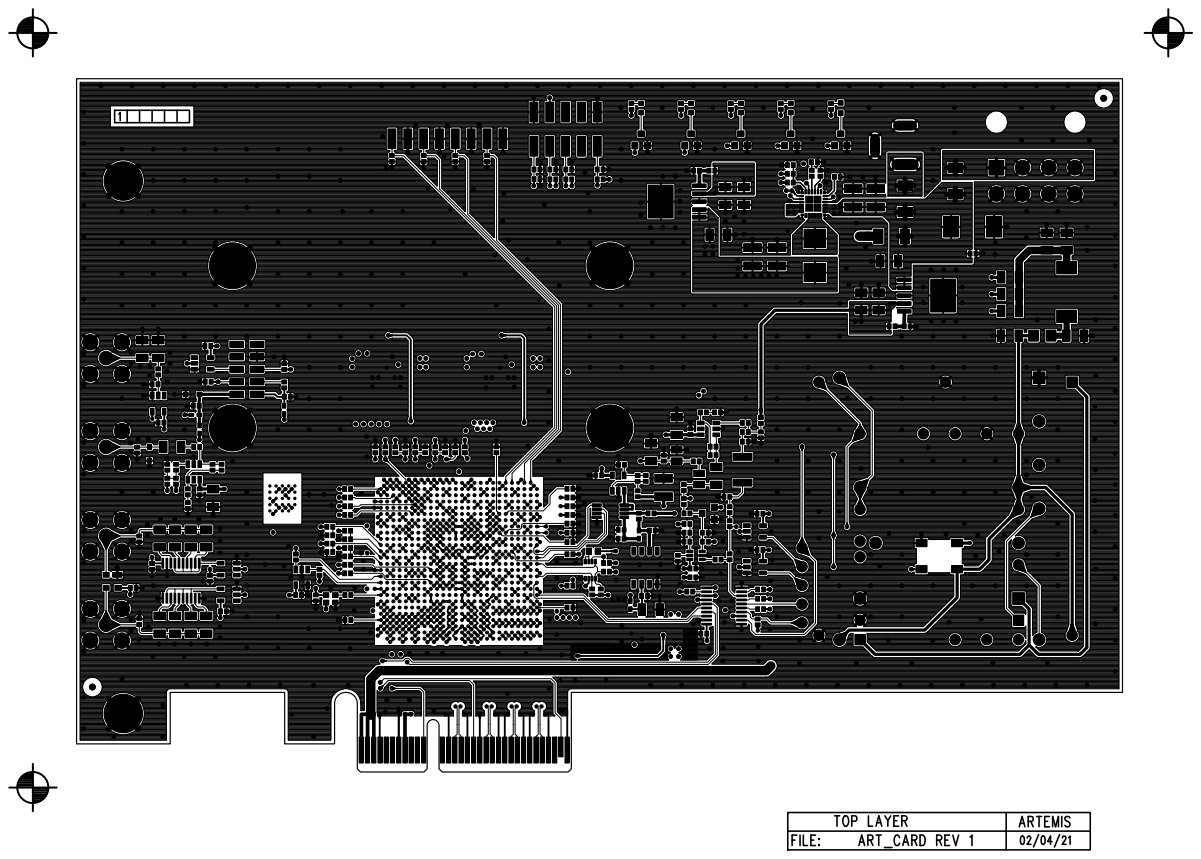
[picture p130: page 15]

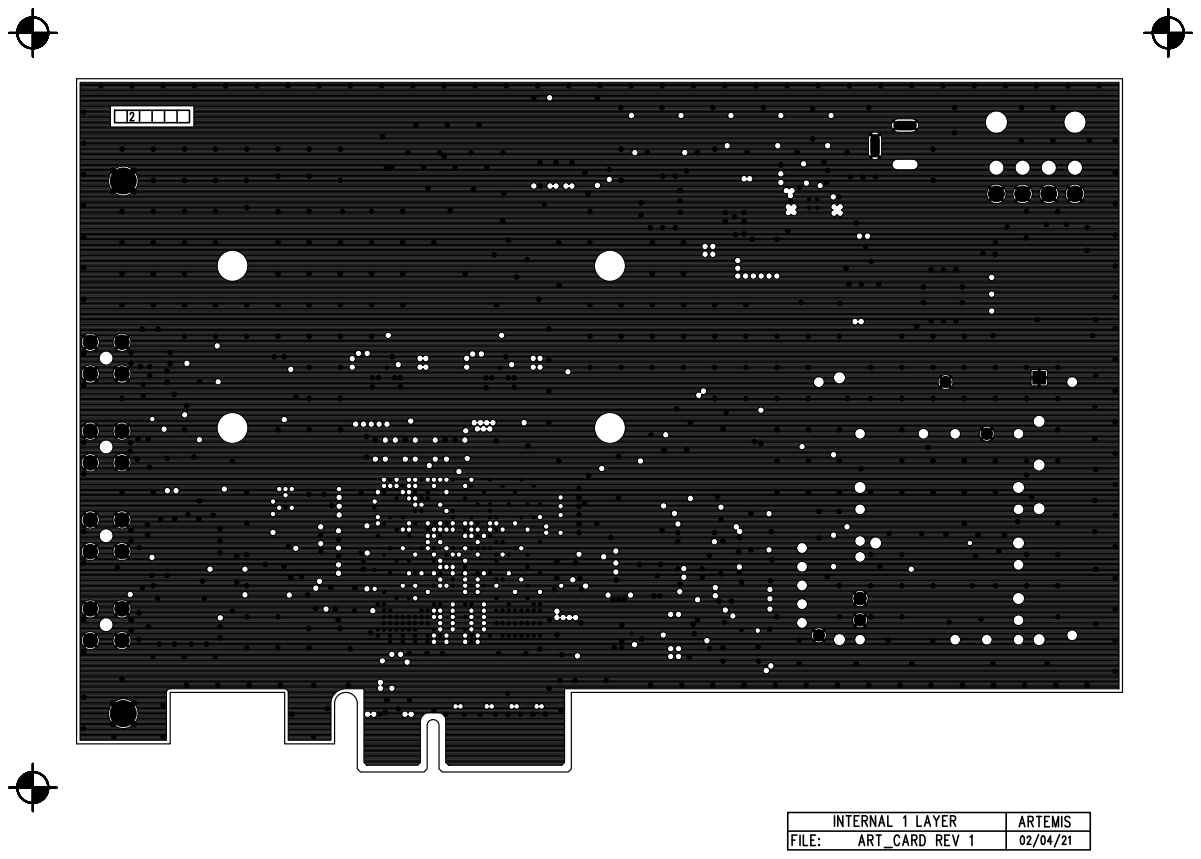
[picture p131: page 16]

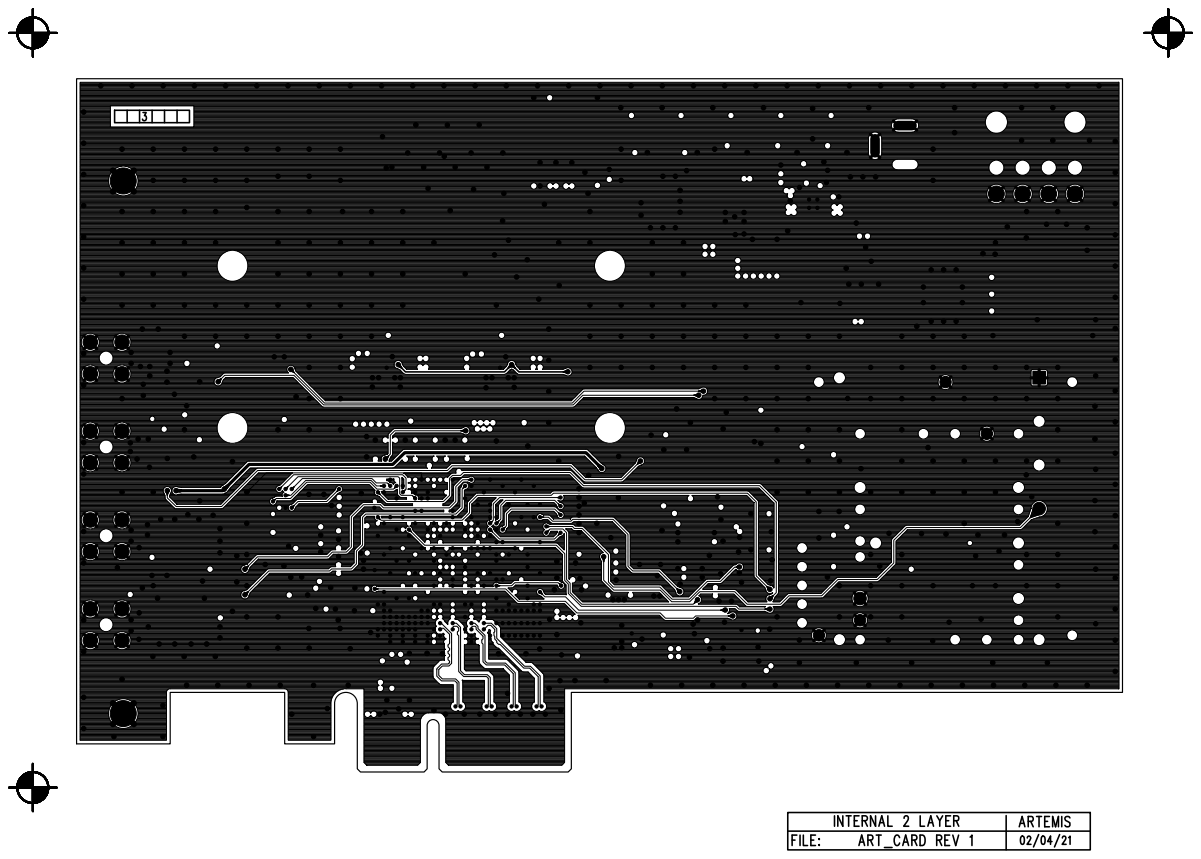
[picture p132: page 17]

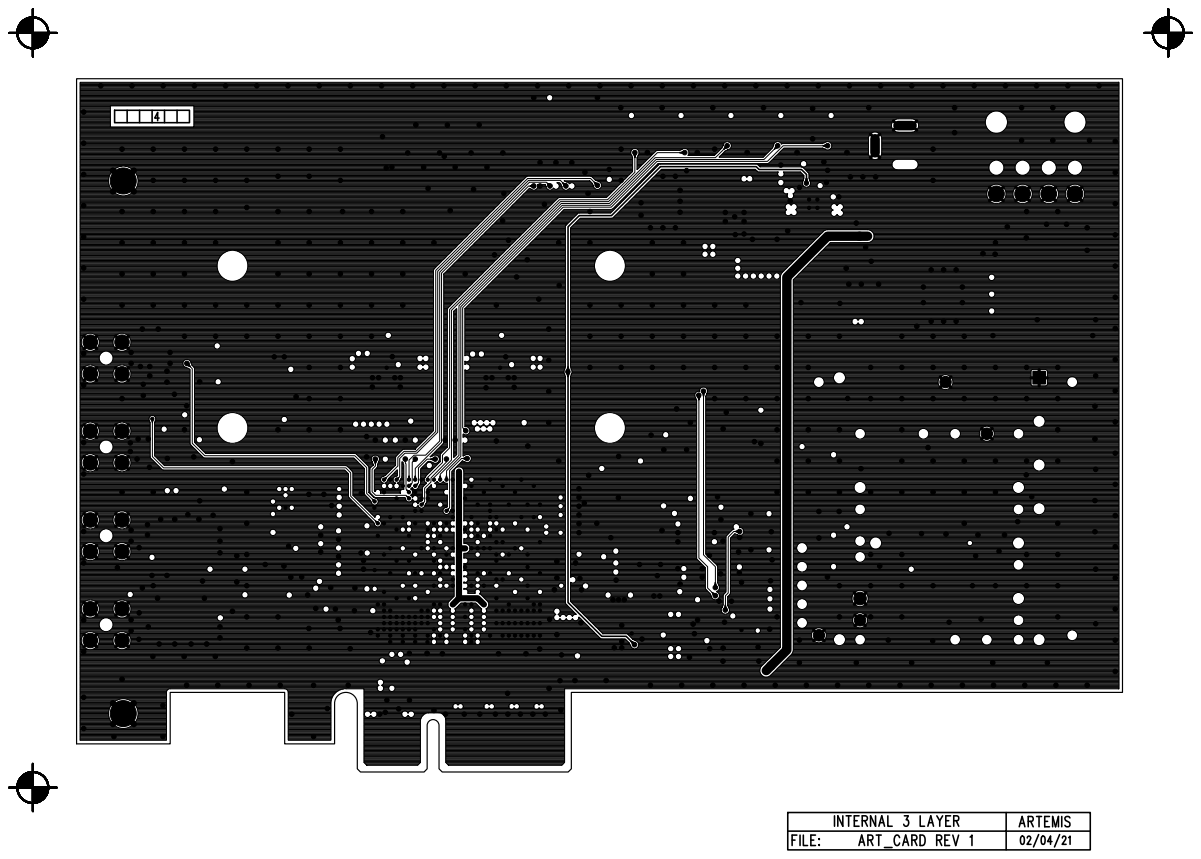
[picture p133: page 18]

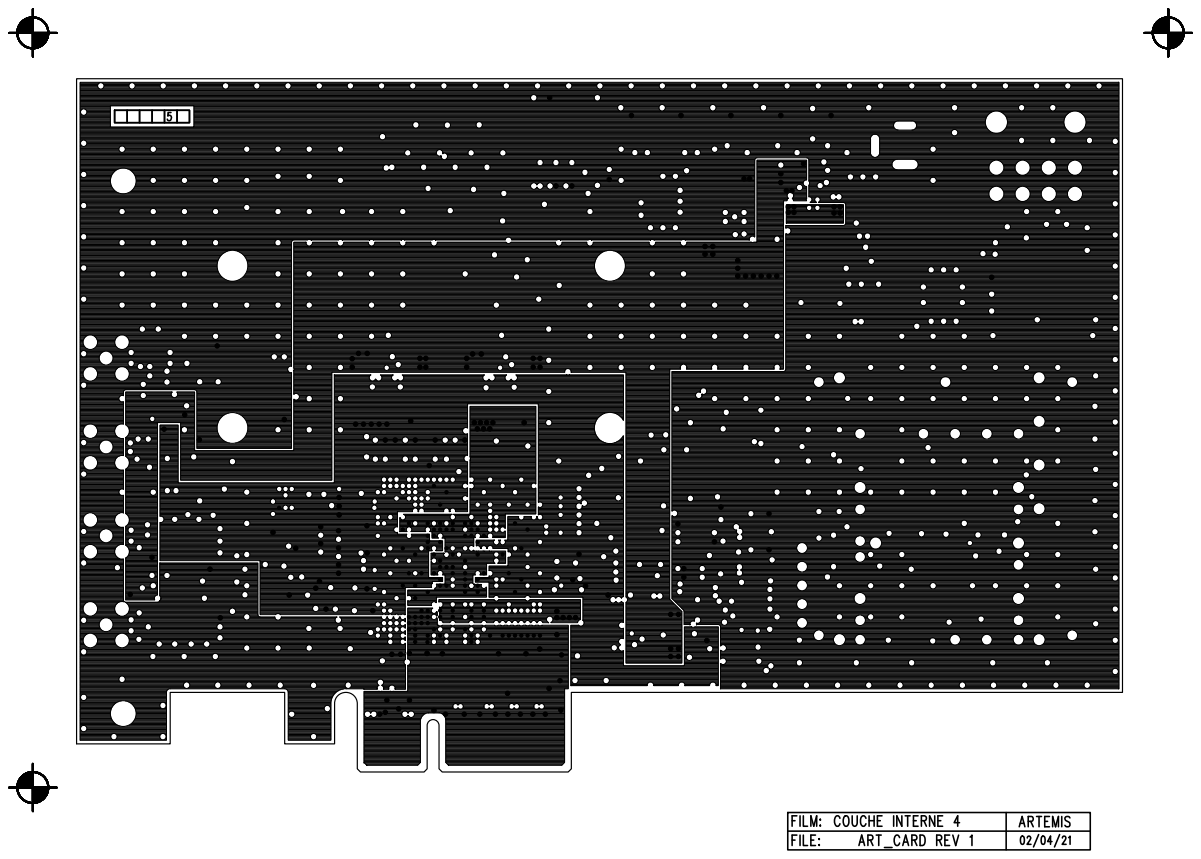
[picture p134: page 19]

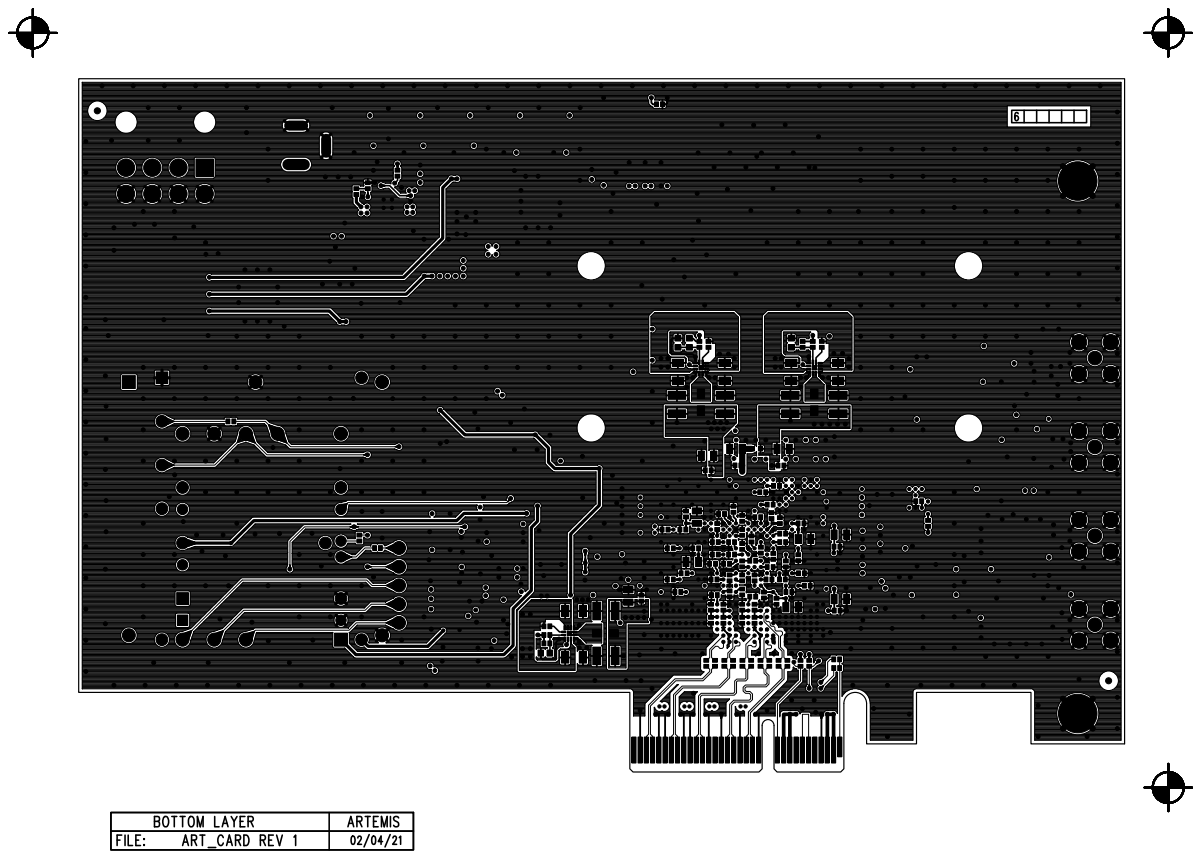
[picture p135: page 20]

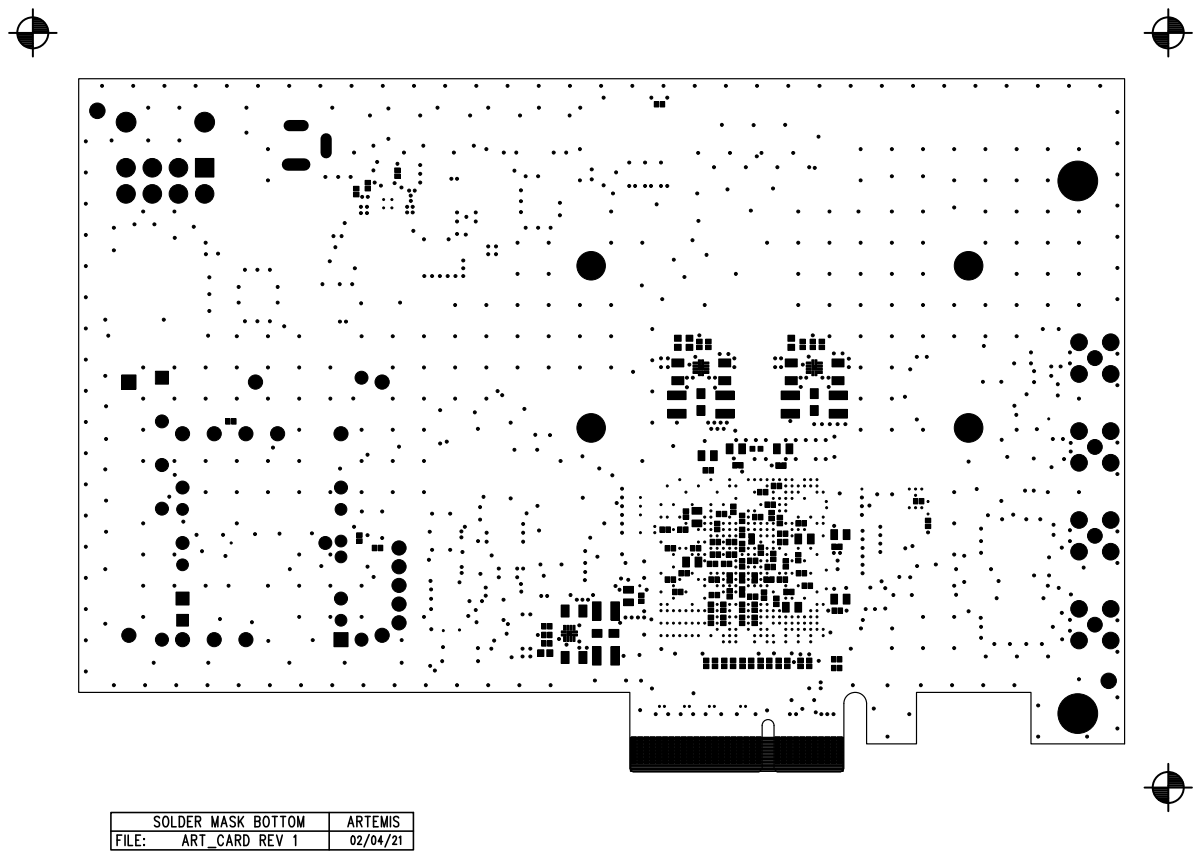
[picture p136: page 21]

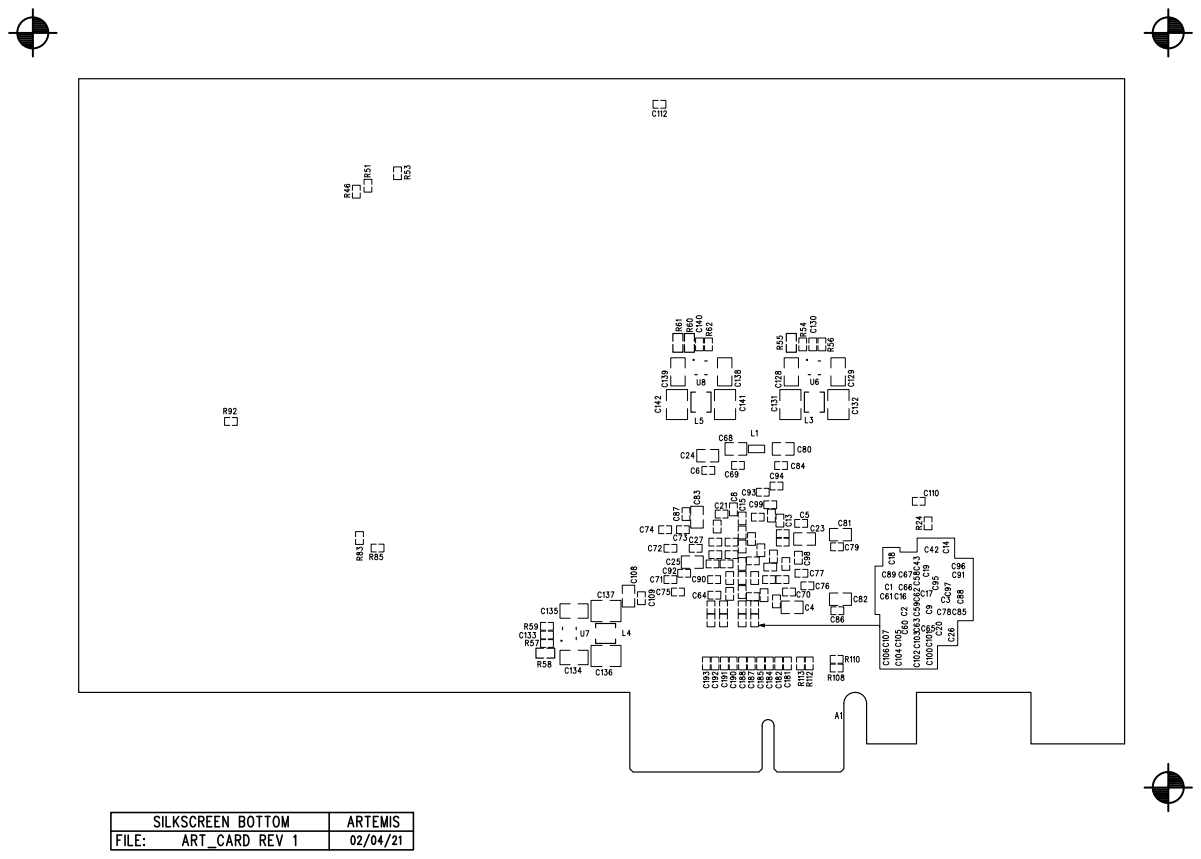
[picture p137: page 22]

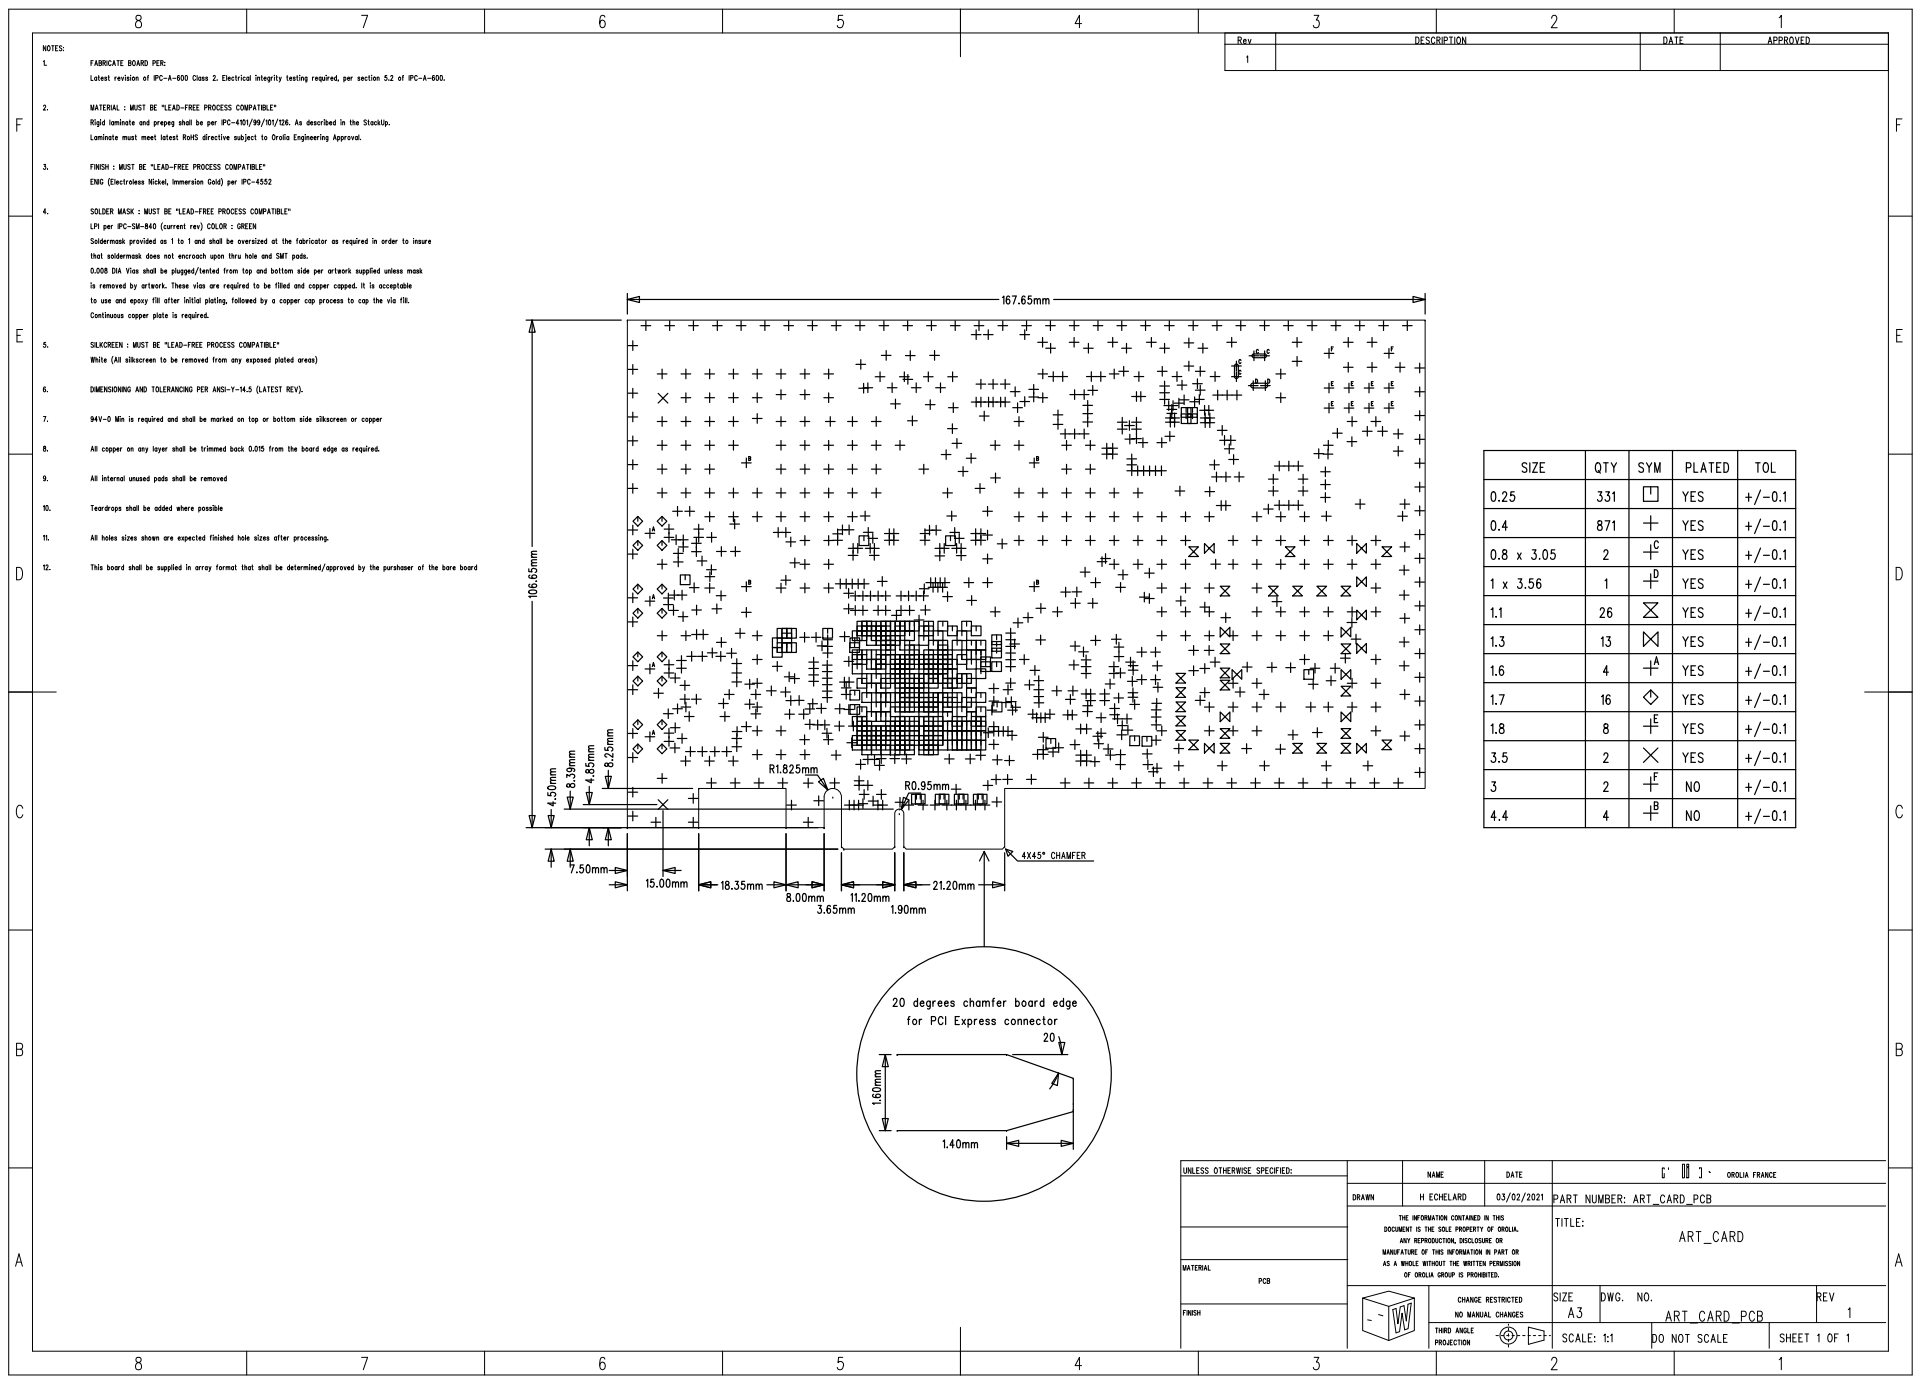
[picture p138: page 23]

StackName: Ouestronic_PCI Express_246183-Q_6L_VT47 | Version: | Revision: | Modification: | Date of Revision: | Editor | Page 1/2
Date: 28/01/2021 | Associated Documents:

### Author: Mostefa Abdali

### Department: IDS Site: Tewkesbury

Copyright © | Print style & presentation copyright © Polar Instruments Ltd
Solder resist | LPI | Solder resist | 0.020 | 4.100 | 0.0000
1 | Foil | 17um Copper Foil | Foil | 0.018 | 0.040 | 1, 2
VENTEC | VT47-2113 | VT-47 | PREPREG | 0.106 | 0.095 | 4.060 | 0.0000 | 57.000
2 | 0.017 | 0.017
VENTEC | VT-47 | 0.127mm | Core | 0.127 | 0.127 | 4.350 | 0.0000 | 0.000
3 | 0.017 | 0.017 | 3, 4
VENTEC | VT47-2116 | VT-47 | PREPREG | 0.132 | 0.121 | 4.150 | 0.0000 | 54.000
VENTEC | VT-47 | 0.711mm | Core | 0.711 | 0.711 | 4.400 | 0.0000 | 0.000
VENTEC | VT47-2116 | VT-47 | PREPREG | 0.132 | 0.121 | 4.150 | 0.0000 | 54.000
4 | 0.017 | 0.017 | 5, 6
VENTEC | VT-47 | 0.127mm | Core | 0.127 | 0.127 | 4.350 | 0.0000 | 0.000
5 | 0.017 | 0.017
VENTEC | VT47-2113 | VT-47 | PREPREG | 0.106 | 0.095 | 4.060 | 0.0000 | 57.000
6 | Foil | 17um Copper Foil | Foil | 0.018 | 0.040 | 7, 8
Solder resist | LPI | Solder resist | 0.020 | 4.100 | 0.0000

1.60 +0.16 / -0.16

1 | Coated Microstrip 1B | 1 | 0 | 2 | 0.150 | 0.000 | 0.000 | 0 | 50.090 | 50.000 | 10.000 | 0.000
2 | Edge Coupled Coated Microstrip 1B | 1 | 0 | 2 | 0.150 | 0.150 | 0.000 | 0 | 87.470 | 85.000 | 10.000 | 0.020
3 | Offset Stripline 1B1A | 3 | 5 | 2 | 0.160 | 0.000 | 0.000 | 0 | 50.950 | 50.000 | 10.000 | 0.000
4 | Edge Coupled Offset Stripline 1B1A | 3 | 5 | 2 | 0.160 | 0.150 | 0.000 | 0 | 85.010 | 85.000 | 10.000 | 0.000
5 | Offset Stripline 1B1A | 4 | 5 | 2 | 0.160 | 0.000 | 0.000 | 0 | 50.950 | 50.000 | 10.000 | 0.000
6 | Edge Coupled Offset Stripline 1B1A | 4 | 5 | 2 | 0.160 | 0.150 | 0.000 | 0 | 85.010 | 85.000 | 10.000 | 0.000
7 | Coated Microstrip 1B | 6 | 0 | 5 | 0.150 | 0.000 | 0.000 | 0 | 50.090 | 50.000 | 10.000 | 0.000

StackName: Ouestronic_PCI Express_246183-Q_6L_VT47 | Version: | Revision: | Modification: | Date of Revision: | Editor | Page 2/2
Date: 28/01/2021 | Associated Documents:

### Author: Mostefa Abdali

### Department: IDS Site: Tewkesbury

Copyright © | Print style & presentation copyright © Polar Instruments Ltd
8 | Edge Coupled Coated Microstrip 1B | 6 | 0 | 5 | 0.150 | 0.150 | 0.000 | 0 | 87.470 | 85.000 | 10.000 | 0.020
1 | 1 | 6 | Mechanical PTH | 0.250 | None | 0.500


# Angers Technopole 1 bis Avenue du Bois l’Abbé 49070 BEAUCOUZÉ FRANCE Phone : +33(0)2-41-48-98-68 p.benoit@artemis-cad.com www.artemis-cad.com

# PCB Reference :

✓ | PCB Unit | Unit PCB dimensions : | mm
| Panel PCB : | Panel dimensions : | mm
| Material : | FR4 Surface : 1.79 dm² Track / Gap : 0.15 / 0.15 mm
PCB Type : MC6 Finish Copper Thikness (µm) : | 12µ 17,5µ 35µ 40µm
✓
✓
✓ | Plated Trough Hole | Via type : | Hole / pads ratio :
✓ | Traditional | Press-fit Hole | ✓ | Traditional Via | Via in pad
✓ | SMT | Autre | Laser Via | Stacked | Staggered
Surface Treatement Finished | Blinded Via
✓ | Buried Via
Filled Via | Resin | Copper
Peelable Solder Mask | Standard | TOP | BOTTOM
✓ | Photo-imageable | ✓ | TOP | ✓ | BOTTOM
✓ | Ink | ✓ | TOP | ✓ | BOTTOM
✓ | Yes | No
✓ | Impedance control : | ✓ | Produced | Measured
✓ | Differential Pairs : | ✓ | Produced | Measured
✓ | Stack-up :
Milling | Milling Diameter : | mm

# TECHNICAL SPECIFICATION

# IPC-A-600

# OROLIA

ART_CARD | Index : | Rev 1

167.65 X 106.65
0 | X | 0
Technology | 0,25/0,55
PCB Thickness (mm) : | 16/10 | External Layer : Intern Layer :

# Couche départ et d'arrivée

Ni/Au Chemical | Couche départ et d'arrivée
Sn/Cu HAL | Autre Sn/Pb surfondu
Solder Mask | Green
Silkscreen | White

# Electrical Test

0

# MANUFACTURER :

# CUSTUMER :

# 50 ohms on layer 1, 3 and 4

# 85 ohms on layer 1, 3 and 6

# Ouestronic_PCI Express_246183-Q_6L_VT47.pdf

0

# Comments :
