Orolia2s/art-card-board/(list of files, drawings)

Other design files:
ProductionFile/Rev1/ART_CARD Rev1.pcb
ProductionFile/Rev2/ART_CARD Rev2.pcb
ProductionFile/Rev3/ART_CARD Rev3.pcb
ProductionFile/Rev4/ART_CARD Rev4.pcb
ProductionFile/Rev5/ART_CARD Rev5.pcb
