Orolia2s/art-card-board/Firmware/quartus/ip/IDBoard/unique_id/unique_id_bb.v

module unique_id (
		input  wire        clkin,      //  clkin.clk
		input  wire        reset,      //  reset.reset
		output wire        data_valid, // output.valid
		output wire [63:0] chip_id     //       .data
	);
endmodule
