Orolia2s/art-card-board/(commit log)

2021-08-25 Revision 1 of the Art_Card Board (Schematic and Production File)
    [ART_CARD Rev1.pcb, ART_CARD_BOM-ASSY.xlsx]
2021-08-25 Revision 2 of the Art_Card Board (Schematic and Production File)
    [ART_CARD Rev1.pcb, ART_CARD Rev2.pcb, ART_CARD_BOM-ASSY.xlsx, ART_CARD_BOM-Assy-Rev2.xlsx]
2021-08-25 Revision 3 of the Art_Card Board (Schematic and Production File)
    [ART_CARD Rev3.pcb, ART_CARD_BOM-ASSY-rev3.xlsx]
2021-09-06 Fix delay on SMA output connectors.
    [art_card_Top.vhd, phy2sys.vhd, pps_out_ctrl.vhd]
2022-03-17 Art_Card Rev4 Schematic Proposal
2022-03-17 Update of the Rev4 with SPI and I2C addressable by a USB/FTDI link
2022-03-17 Update Rev4 Schematic and Production File
    [ART_CARD Rev4.pcb, ART_CARD_Rev4-BOM_PROD.xlsx]
2022-03-17 Update of the ART_CARD rev4 with Write Protection for EEPROM
    [ART_CARD Rev4.pcb, ART_CARD_Rev4-BOM_PROD.xlsx]
2022-03-17 Fix Phase Offset Request Add Revision of Golden Image in FLASH
    [IDBoard.vhd, IOConfig.vhd, art_card_Top.vhd, phy2sys.vhd]
2022-03-17 Fix UART
2022-04-12 Fix mRO link Change UART fifo depth from 16 to 32 bytes
    [IOConfig.vhd, art_card_Top.vhd, gh_fifo_async16_rcsr_wf.vhd, mro50.vhd, phy2sys.vhd, pps_out_ctrl.vhd]
2022-05-19 Remove compensation on mRO50 startup Add UART debug for mRO50/mro50 Add Board revision in PCIe header
2022-06-20 Update Production File with the Rev5
    [ART_CARD Rev5.pcb, BOM-ART_CARD_Rev5-PRODUCTION.xlsx]
2022-06-20 Add ART_CARD Rev5 Schematic
2022-12-08 Add 2D CAD drawing
